latintzar/tactile-glove/hardware/glove-v4/enclosure/vertical-packing-check.md

# Current vertical packing limit

After replacing all545 generic heights with documented package maxima plus0.20mm assembly allowance, the deepest underside package is C_SD_BULK atZ26.1 (2.9mm below the board). The battery envelope occupiesZ3..24; its retaining belt reachesZ25. Main PCB remainsZ29..30.6. The fixed FH12 tail plane isZ31.3, and the exact-length R4 camera fold fixes camera/window height from that plane. Lowering the PCB requires changing those interfaces and the fitted button tip.

The button independently fixes the present45.5mm case top: tip flange top38.7 +installed spring5.2 =cap underside43.9; cap1.0 reaches44.9; diaphragm0.6 reaches45.5. Changing the NTC connector to right-angle alone therefore saves no case height with this mechanism. The existing PH NTC service bend also reaches43.65 below the44.2 lid underside, leaving0.55mm nominal clearance.

A simple lid or PCB translation cannot reduce height while preserving these interfaces. This checkpoint retains112×104×45.5mm body dimensions and the1.6mm flat textile carrier. The new overlap window increases assembled length to105.6mm. A materially slimmer cuff requires a separately scoped button/camera/board packing change or battery alternative.
