latintzar/tactile-glove/docs/dense-tactile-skin.md

# Dense tactile skin

The current investigation is a flexible, textured black nitrile precision glove targeting thousands of taxels across the hand. It retains the compact graphite wrist cuff, hand-facing camera and forest-green pull tab.

The jobs are recording surface texture and contact during hand work, studying delicate palpation in surgical training, and observing grip during sport. These application images illustrate the intended glove experience.

## Sensing layer and readout

The sensing layer, channel addressing, mechanical integration, routing and data acquisition remain current engineering questions. The dense portfolio view places 4,096 proposed taxel positions over one photograph. Those positions describe a layout target; acquired measurements belong to the experiment records.

## Earlier engineering

The earlier V4 source uses twenty paired pressure/PVDF locations, two IMUs and a cuff camera. Its firmware implementation settings, tests, native PCB, enclosure files and physical qualification status remain in their existing guides. The earlier Bela pilot retains its original recordings and signal comparisons.

## Material observation

Peter reported that his piezo experiment produced visibly distinct spectral signatures for aluminium, wood and sandpaper. The retained account and qualitative reconstruction are in [Material signatures](material-signatures/README.md). The reconstruction records his described visual differences separately from the archived Bela recordings.

## Continue the investigation

Select and qualify a sensing stack, establish the taxel layout and readout, test mechanical fit and signal integrity, then record synchronized material interactions. Preserve each implemented result and its evidence alongside the existing source history.
