latintzar/tactile-glove/firmware/tactile_v4/camera_override/PUBLIC-SOURCE-NOTICE.md

# Public source notice

The two `driver/*.c` files preserve the original Espressif Apache 2.0 headers and carry a Peter Neyra modification notice. The public packaging adds that notice as two comment lines; their executable C bodies match the source used for the dated target build. `README.md` retains the original reviewed source hashes. The historical `artifacts/build-manifest.json` describes that original source snapshot; the public source inventory records the current files. Build and test the public tree when making a new image.
