latintzar/tactile-glove/hardware/glove-v4/enclosure/viewer.html

ARTISANCuff assembly · V4Assembly guide

Drag to rotate · scroll to zoom · dimensions in millimetres

# Cuff components

Generated part geometry and checked PCB component envelopes. Inspect the housing, battery, camera and connections.

Loading engineering files…

Inspect a component

Show electronics and batteryElectronic components use the same mechanical envelopes as the clearance checks. The model uses the exact millimetre coordinates in the supplied CAD; surface finish is illustrative.

Printing and assemblyPart manifestClearance checksMain-board BOM
