latintzar/tactile-glove/hardware/glove-v4/software-preview/index.html

ARTISAN

Connecting to cuff

Connect Bluetooth

# Glove monitor

Contact, vibration and the view from your wrist.

What are you touching?Mark takeWaiting for cuff— V

Open cuff camera and monitor (http://192.168.4.1/)

## Contact map

Right hand · 20 locations

Loading hand

PalmBack

Reference anatomy · drag to rotate

Light contactFirm contact

## Wrist camera

Waiting for video

Video appears over cuff Wi-Fi

Storage —IMUs —

## Texture signal

LocationInspect waveform

Contact level—% of electrical range

Vibration RMS—mV at ADC input

Peak—mV at ADC input

Vibration over timeLast 12 seconds

WaveformmV · 0.5 s

Frequency content0–2 kHz

Texture energy is the measured vibration signal. Material and roughness models use the labeled recordings.

Waiting for hardware dataContinuous raw capture on microSD

Capture details

20 vibration channels at 4 kHz · 20 pressure channels at 50 Hz · dual 833 Hz IMUs · VGA camera around 10 fps. Pressure is an electrical contact level until per-cell force calibration. Camera timestamps mark first DMA arrival.
