latintzar/tactile-glove/hardware/glove-v4/enclosure/height-evidence/README.md

# Package-height evidence

All 545 former generic component instances are covered by 94 selected-MPN manufacturer maxima. The initial snapshot remains in package-heights.json; merged-package-heights.json/CSV are the current CAD inputs.

Every reduced envelope adds a separate 0.20 mm assembly allowance. This is an engineering assembly acceptance limit, not a manufacturer dimensional claim. The 15 original specific envelopes remain separately modeled; the new fuse and battery header are added by the connector revision.

Evidence includes cached manufacturer PDFs, distributor-hosted manufacturer PDFs, hashed catalog extracts and clearly labeled transcriptions of manufacturer drawings where direct downloads returned 403. Exact references, source URLs, physical pages and evidence hashes are retained in the merged table.

| Selected MPN | Qty | Maximum mm | Assembly envelope mm | Evidence |
|---|---:|---:|---:|---|
| 2N7002,215 | 8 | 1.10 | 1.30 | [p. 8](https://assets.nexperia.com/documents/data-sheet/2N7002.pdf) |
| 74LVC1G04GW,125 | 1 | 1.10 | 1.30 | [p. 9](https://assets.nexperia.com/documents/data-sheet/74LVC1G04.pdf) |
| BAV199,215 | 20 | 1.10 | 1.30 | [p. 5](https://assets.nexperia.com/documents/data-sheet/BAV199.pdf) |
| BQ25616RTWR | 1 | 0.80 | 1.00 | [p. 47](https://www.ti.com/lit/ds/symlink/bq25616.pdf) |
| C0603C123J3GACAUTO | 20 | 0.87 | 1.07 | [p. 6,8](https://yageogroup.com/content/datasheet/asset/file/KEM_C1022_C0G_AUTO_SMD) |
| C0603C153J3GACAUTO | 20 | 0.87 | 1.07 | [p. 6,8](https://yageogroup.com/content/datasheet/asset/file/KEM_C1022_C0G_AUTO_SMD) |
| CD74HC4052M | 1 | 1.75 | 1.95 | [p. 49](https://www.ti.com/lit/ds/symlink/cd74hc4052.pdf) |
| CD74HC4067M | 4 | 2.65 | 2.85 | [p. 26](https://www.ti.com/lit/ds/symlink/cd74hc4067.pdf) |
| CL21A106KAYNNNE | 6 | 1.45 | 1.65 | [p. catalog extract](https://prod-parts-data.s3.amazonaws.com/CL21A106KAYNNNE/datasheet/1_CL21A106KAYNNNE-Samsung-Electro-Mechanics-datasheet-11796682.pdf) |
| DMP2035U-7 | 2 | 1.15 | 1.35 | [p. 6](https://www.diodes.com/assets/Datasheets/DMP2035U.pdf) |
| GRM1885C1H102JA01D | 2 | 0.90 | 1.10 | [p. catalog extract](https://www.murata.com/-/media/webrenewal/tool/library/common-pdf/static-model/component-list-s-mlcc-2506.ashx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) |
| GRM1885C1H103JA01D | 20 | 0.90 | 1.10 | [p. 1](https://www.icsoso.com.cn/pdf-dc/GRM1885C1H103JA01D.pdf) |
| GRM1885C1H222JA01D | 20 | 0.90 | 1.10 | [p. catalog extract](https://www.murata.com/-/media/webrenewal/tool/library/common-pdf/static-model/component-list-s-mlcc-2506.ashx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) |
| GRM1885C1H471JA01D | 20 | 0.90 | 1.10 | [p. catalog extract](https://www.murata.com/-/media/webrenewal/tool/library/common-pdf/static-model/component-list-s-mlcc-2506.ashx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) |
| GRM188R61A105KA61D | 7 | 0.90 | 1.10 | [p. catalog extract](https://www.murata.com/-/media/webrenewal/tool/library/common-pdf/static-model/component-list-s-mlcc-2506.ashx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) |
| GRM188R61A475KE15D | 1 | 0.90 | 1.10 | [p. catalog extract](https://www.murata.com/-/media/webrenewal/tool/library/common-pdf/static-model/component-list-s-mlcc-2506.ashx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) |
| GRM188R61C105KA93D | 4 | 0.90 | 1.10 | [p. catalog extract](https://www.murata.com/-/media/webrenewal/tool/library/common-pdf/static-model/component-list-s-mlcc-2506.ashx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) |
| GRM188R71C104KA01D | 34 | 0.90 | 1.10 | [p. catalog extract](https://www.murata.com/-/media/webrenewal/tool/library/common-pdf/static-model/component-list-s-mlcc-2506.ashx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) |
| GRM188R71H104KA93D | 28 | 0.90 | 1.10 | [p. 1](https://cms.nacsemi.com/content/AuthDatasheets/MURE-S-A0003031358-1.pdf) |
| GRM188R71H473KA61D | 1 | 0.90 | 1.10 | [p. catalog extract](https://www.murata.com/-/media/webrenewal/tool/library/common-pdf/static-model/component-list-s-mlcc-2506.ashx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) |
| GRM21BC71E106ME11L | 4 | 1.45 | 1.65 | [p. catalog extract](https://www.murata.com/products/productdetail?partno=GRM21BC71E106ME11L) |
| GRM21BC81C226ME44L | 1 | 1.45 | 1.65 | [p. catalog extract](https://www.murata.com/products/productdetail?partno=GRM21BC81C226ME44L) |
| GRM21BR61A106KE19L | 1 | 1.35 | 1.55 | [p. catalog extract](https://www.murata.com/-/media/webrenewal/tool/library/common-pdf/static-model/component-list-s-mlcc-2506.ashx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) |
| GRM21BR71A475KA73L | 1 | 1.40 | 1.60 | [p. catalog extract](https://www.farnell.com/datasheets/2079190.pdf) |
| GRM32ER61A476KE20L | 1 | 2.70 | 2.90 | [p. catalog extract](https://cms.nacsemi.com/content/AuthDatasheets/MURE-S-A0003031248-1.pdf) |
| GRM32ER61C476KE15L | 9 | 2.70 | 2.90 | [p. 1](https://www.farnell.com/datasheets/2079201.pdf) |
| ISM330DHCXTR | 1 | 0.86 | 1.06 | [p. 146](https://www.st.com/resource/en/datasheet/ism330dhcx.pdf) |
| LM393LVDGKR | 1 | 1.10 | 1.30 | [p. 42](https://www.ti.com/lit/ds/symlink/lm393lv.pdf) |
| MCP33131D-10-I/MS | 1 | 1.10 | 1.30 | [p. 53](https://ww1.microchip.com/downloads/en/DeviceDoc/MCP33131D-Data-Sheet-DS20005947B.pdf) |
| MCP6002T-I/SN | 1 | 1.75 | 1.95 | [p. 32](https://ww1.microchip.com/downloads/en/DeviceDoc/20001733L.pdf) |
| MCP6004T-I/ST | 15 | 1.20 | 1.40 | [p. 42](https://ww1.microchip.com/downloads/en/DeviceDoc/20001733L.pdf) |
| OPA320AIDBVR | 2 | 1.45 | 1.65 | [p. 39](https://www.ti.com/lit/ds/symlink/opa320.pdf) |
| OPA4323IPWR | 1 | 1.20 | 1.40 | [p. 57](https://www.ti.com/lit/ds/symlink/opa4323.pdf) |
| PCA9306DCTR | 1 | 1.30 | 1.50 | [p. 28](https://www.ti.com/lit/ds/symlink/pca9306.pdf) |
| PESD5V0U2BT,215 | 2 | 1.10 | 1.30 | [p. 7](https://assets.nexperia.com/documents/data-sheet/PESD5V0U2BT.pdf) |
| PMEG2010ER,115 | 3 | 1.10 | 1.30 | [p. 8](https://assets.nexperia.com/documents/data-sheet/PMEG2010ER.pdf) |
| PMV16XN,215 | 2 | 1.10 | 1.30 | [p. 10](https://assets.nexperia.com/documents/data-sheet/PMV16XN.pdf) |
| RC0603FR-07100KL | 37 | 0.55 | 0.75 | [p. 1](https://yageogroup.com/component-documentation/download/specsheet/RC0603FR-07100KL) |
| RC0603FR-0710KL | 40 | 0.55 | 0.75 | [p. 1](https://yageogroup.com/component-documentation/download/specsheet/RC0603FR-0710KL) |
| RC0603FR-0710ML | 2 | 0.55 | 0.75 | [p. 1](https://yageogroup.com/component-documentation/download/specsheet/RC0603FR-0710ML) |
| RC0603FR-0710RL | 1 | 0.55 | 0.75 | [p. 1](https://yageogroup.com/component-documentation/download/specsheet/RC0603FR-0710RL) |
| RC0603FR-0714K7L | 40 | 0.55 | 0.75 | [p. 1](https://yageogroup.com/component-documentation/download/specsheet/RC0603FR-0714K7L) |
| RC0603FR-071KL | 2 | 0.55 | 0.75 | [p. 1](https://yageogroup.com/component-documentation/download/specsheet/RC0603FR-071KL) |
| RC0603FR-07200KL | 1 | 0.55 | 0.75 | [p. 1](https://yageogroup.com/component-documentation/download/specsheet/RC0603FR-07200KL) |
| RC0603FR-07220RL | 2 | 0.55 | 0.75 | [p. 1](https://yageogroup.com/component-documentation/download/specsheet/RC0603FR-07220RL) |
| RC0603FR-0722RL | 4 | 0.55 | 0.75 | [p. 1](https://yageogroup.com/component-documentation/download/specsheet/RC0603FR-0722RL) |
| RC0603FR-0727K4L | 40 | 0.55 | 0.75 | [p. 1](https://yageogroup.com/component-documentation/download/specsheet/RC0603FR-0727K4L) |
| RC0603FR-072K2L | 4 | 0.55 | 0.75 | [p. 1](https://yageogroup.com/component-documentation/download/specsheet/RC0603FR-072K2L) |
| RC0603FR-072KL | 1 | 0.55 | 0.75 | [p. 1](https://yageogroup.com/component-documentation/download/specsheet/RC0603FR-072KL) |
| RC0603FR-0733RL | 4 | 0.55 | 0.75 | [p. 1](https://yageogroup.com/component-documentation/download/specsheet/RC0603FR-0733RL) |
| RC0603FR-0747KL | 19 | 0.55 | 0.75 | [p. 1](https://yageogroup.com/component-documentation/download/specsheet/RC0603FR-0747KL) |
| RC0603FR-0747RL | 1 | 0.55 | 0.75 | [p. 1](https://yageogroup.com/component-documentation/download/specsheet/RC0603FR-0747RL) |
| RC0603FR-074K7L | 1 | 0.55 | 0.75 | [p. 1](https://yageogroup.com/component-documentation/download/specsheet/RC0603FR-074K7L) |
| RC0603FR-07680RL | 2 | 0.55 | 0.75 | [p. 1](https://yageogroup.com/component-documentation/download/specsheet/RC0603FR-07680RL) |
| RC0805FR-0722RL | 2 | 0.60 | 0.80 | [p. 1](https://yageogroup.com/component-documentation/download/specsheet/RC0805FR-0722RL) |
| REF3330AIDBZR | 1 | 1.12 | 1.32 | [p. 33](https://www.ti.com/lit/ds/symlink/ref33.pdf) |
| RT0603BRD07100KL | 7 | 0.55 | 0.75 | [p. 1](https://yageogroup.com/component-documentation/download/specsheet/RT0603BRD07100KL) |
| RT0603BRD07107KL | 1 | 0.55 | 0.75 | [p. 1](https://yageogroup.com/component-documentation/download/specsheet/RT0603BRD07107KL) |
| RT0603BRD07158KL | 1 | 0.55 | 0.75 | [p. 1](https://yageogroup.com/component-documentation/download/specsheet/RT0603BRD07158KL) |
| RT0603BRD0719K2L | 1 | 0.55 | 0.75 | [p. 1](https://www.yageo.com/en/Chart/Download/pdf/RC0603) |
| RT0603BRD072M15L | 1 | 0.55 | 0.75 | [p. 1](https://www.yageo.com/en/Chart/Download/pdf/RC0603) |
| RT0603BRD07300KL | 1 | 0.55 | 0.75 | [p. 1](https://yageogroup.com/component-documentation/download/specsheet/RT0603BRD07300KL) |
| RT0603BRD0730K9L | 2 | 0.55 | 0.75 | [p. 1](https://yageogroup.com/component-documentation/download/specsheet/RT0603BRD0730K9L) |
| RT0603BRD07327KL | 1 | 0.55 | 0.75 | [p. 1](https://www.yageo.com/en/Chart/Download/pdf/RC0603) |
| RT0603BRD07390RL | 1 | 0.55 | 0.75 | [p. 1](https://yageogroup.com/component-documentation/download/specsheet/RT0603BRD07390RL) |
| RT0603BRD0752K3L | 1 | 0.55 | 0.75 | [p. 1](https://yageogroup.com/component-documentation/download/specsheet/RT0603BRD0752K3L) |
| RT0603BRD07562RL | 1 | 0.55 | 0.75 | [p. 1](https://yageogroup.com/component-documentation/download/specsheet/RT0603BRD07562RL) |
| RT0603BRD075K23L | 1 | 0.55 | 0.75 | [p. 1](https://yageogroup.com/component-documentation/download/specsheet/RT0603BRD075K23L) |
| RT0603BRD0771K5L | 1 | 0.55 | 0.75 | [p. 1](https://yageogroup.com/component-documentation/download/specsheet/RT0603BRD0771K5L) |
| RT0603BRD07887KL | 1 | 0.55 | 0.75 | [p. 1](https://yageogroup.com/component-documentation/download/specsheet/RT0603BRD07887KL) |
| RV0805FR-0722ML | 20 | 0.60 | 0.80 | [p. 1](https://yageogroup.com/component-documentation/download/specsheet/RV0805FR-0722ML) |
| SN74AHC595PWR | 1 | 1.20 | 1.40 | [p. 33](https://www.ti.com/lit/ds/symlink/sn74ahc595.pdf) |
| SN74AXC8T245PWR | 2 | 1.20 | 1.40 | [p. 29](https://www.ti.com/lit/ds/symlink/sn74axc8t245.pdf) |
| SN74LVC1G00DBVR | 1 | 1.45 | 1.65 | [p. 40](https://www.ti.com/lit/ds/symlink/sn74lvc1g00.pdf) |
| SN74LVC1G04DBVR | 3 | 1.45 | 1.65 | [p. 23](https://www.ti.com/lit/ds/symlink/sn74lvc1g04.pdf) |
| SN74LVC1G08DBVR | 4 | 1.45 | 1.65 | [p. 27](https://www.ti.com/lit/ds/symlink/sn74lvc1g08.pdf) |
| SN74LVC1G17DBVR | 1 | 1.45 | 1.65 | [p. 23](https://www.ti.com/lit/ds/symlink/sn74lvc1g17.pdf) |
| SN74LVC1G32DBVR | 2 | 1.45 | 1.65 | [p. 41](https://www.ti.com/lit/ds/symlink/sn74lvc1g32.pdf) |
| SN74LVC1G74DCUR | 1 | 0.90 | 1.10 | [p. 22](https://www.ti.com/lit/ds/symlink/sn74lvc1g74.pdf) |
| TAJA685K010RNJ | 1 | 1.80 | 2.00 | [p. 1](https://datasheets.kyocera-avx.com/TAJ.pdf) |
| TCA9535PWR | 2 | 1.20 | 1.40 | [p. 38](https://www.ti.com/lit/ds/symlink/tca9535.pdf) |
| TLV3012BIDBVR | 1 | 1.45 | 1.65 | [p. 37](https://www.ti.com/lit/ds/symlink/tlv3012.pdf) |
| TLV75518PDBVR | 1 | 1.45 | 1.65 | [p. 37](https://www.ti.com/lit/ds/symlink/tlv755p.pdf) |
| TMK107BBJ106MA-T | 2 | 1.00 | 1.20 | [p. 1](https://www.es.co.th/Schemetic/PDF/TMK107BBJ106MA-T.PDF) |
| TPS22919DCKR | 1 | 1.10 | 1.30 | [p. 24](https://www.ti.com/lit/ds/symlink/tps22919.pdf) |
| TPS22950YBHR | 1 | 0.40 | 0.60 | [p. 21](https://www.ti.com/lit/ds/symlink/tps22950.pdf) |
| TPS2553DBVR | 1 | 1.45 | 1.65 | [p. 41](https://www.ti.com/lit/ds/symlink/tps2553.pdf) |
| TPS63070RNMR | 1 | 1.00 | 1.20 | [p. 39](https://www.ti.com/lit/ds/symlink/tps63070.pdf) |
| TPS7A2015PDBVR | 1 | 1.45 | 1.65 | [p. 56](https://www.ti.com/lit/ds/symlink/tps7a20.pdf) |
| TPS7A2018PDBVR | 1 | 1.45 | 1.65 | [p. 56](https://www.ti.com/lit/ds/symlink/tps7a20.pdf) |
| TPS7A2028PDBVR | 1 | 1.45 | 1.65 | [p. 56](https://www.ti.com/lit/ds/symlink/tps7a20.pdf) |
| TPS7A2033PDBVR | 1 | 1.45 | 1.65 | [p. 56](https://www.ti.com/lit/ds/symlink/tps7a20.pdf) |
| TUSB320LAIRWBR | 1 | 0.40 | 0.60 | [p. 35](https://www.ti.com/lit/ds/symlink/tusb320lai.pdf) |
| XFL4020-152MEC | 2 | 2.10 | 2.30 | [p. 1,3](https://www.coilcraft.com/en-us/products/power/shielded-inductors/molded-inductor/xfl/xfl4020/) |

Rebuild the merged table with `python3 merge-evidence.py`. The original build-evidence.py only regenerates the initial snapshot.
