latintzar/tactile-glove/hardware/glove-v3/electrical/nets.csv

net | ref | pin
MUX_SRCLK | J_XIAO | 1
MUX_SER | J_XIAO | 2
MUX_RCLK | J_XIAO | 3
I2C_SDA | J_XIAO | 5
I2C_SCL | J_XIAO | 6
ADC_SCK | J_XIAO | 9
ADC_MISO | J_XIAO | 10
ADC_CNV | J_XIAO | 11
3V3 | J_XIAO | 12
GND | J_XIAO | 13
USB_5V | J_XIAO | 14
GND | J_XIAO | 18
BAT+ | J_XIAO | 19
GND | J_XIAO | 20
WAKE_IRQ | J_XIAO | 21
ANALOG_EN | J_XIAO | 22
BAT+ | J_BAT | 1
GND | J_BAT | 2
3V3A | U_LDO | 1
GND | U_LDO | 2
3V3A | U_LDO | 3
1V8 | U_LDO | 5
3V3A | U_REF | 1
VREF3V0 | U_REF | 2
GND | U_REF | 3
VEXC_DRV | U_VMID | 1
VEXC_FB | U_VMID | 2
VEXC_DIV | U_VMID | 3
GND | U_VMID | 4
VMID_BUF_IN | U_VMID | 5
VMID1V25 | U_VMID | 6
VMID1V25 | U_VMID | 7
3V3A | U_VMID | 8
VREF3V0 | U_ADC | 1
1V8 | U_ADC | 2
ADC_AIN+ | U_ADC | 3
ADC_AIN- | U_ADC | 4
GND | U_ADC | 5
ADC_CNV | U_ADC | 6
ADC_MISO | U_ADC | 7
ADC_SCK | U_ADC | 8
3V3A | U_ADC | 9
3V3A | U_ADC | 10
ADC_DRIVER_OUT | U_ADC_DRV | 1
GND | U_ADC_DRV | 2
ADC_MUX | U_ADC_DRV | 3
ADC_DRIVER_OUT | U_ADC_DRV | 4
3V3A | U_ADC_DRV | 5
MUX1_COM | U_MUX1 | 1
PRESS_R2 | U_MUX1 | 2
PRESS_R1 | U_MUX1 | 3
PRESS_M3 | U_MUX1 | 4
PRESS_M2 | U_MUX1 | 5
PRESS_M1 | U_MUX1 | 6
PRESS_I3 | U_MUX1 | 7
PRESS_I2 | U_MUX1 | 8
PRESS_I1 | U_MUX1 | 9
MUX_A0 | U_MUX1 | 10
MUX_A1 | U_MUX1 | 11
GND | U_MUX1 | 12
MUX_A3 | U_MUX1 | 13
MUX_A2 | U_MUX1 | 14
GND | U_MUX1 | 15
VMID1V25 | U_MUX1 | 16
VMID1V25 | U_MUX1 | 17
VMID1V25 | U_MUX1 | 18
VMID1V25 | U_MUX1 | 19
VMID1V25 | U_MUX1 | 20
VMID1V25 | U_MUX1 | 21
PRESS_L1 | U_MUX1 | 22
PRESS_R3 | U_MUX1 | 23
3V3A | U_MUX1 | 24
MUX2_COM | U_MUX2 | 1
PRESS_P4 | U_MUX2 | 2
PRESS_P3 | U_MUX2 | 3
PRESS_P2 | U_MUX2 | 4
PRESS_P1 | U_MUX2 | 5
PRESS_T2 | U_MUX2 | 6
PRESS_T1 | U_MUX2 | 7
PRESS_L3 | U_MUX2 | 8
PRESS_L2 | U_MUX2 | 9
MUX_A0 | U_MUX2 | 10
MUX_A1 | U_MUX2 | 11
GND | U_MUX2 | 12
MUX_A3 | U_MUX2 | 13
MUX_A2 | U_MUX2 | 14
GND | U_MUX2 | 15
VMID1V25 | U_MUX2 | 16
VMID1V25 | U_MUX2 | 17
VMID1V25 | U_MUX2 | 18
VMID1V25 | U_MUX2 | 19
VMID1V25 | U_MUX2 | 20
VMID1V25 | U_MUX2 | 21
PRESS_H2 | U_MUX2 | 22
PRESS_H1 | U_MUX2 | 23
3V3A | U_MUX2 | 24
MUX3_COM | U_MUX3 | 1
S2_OUT_R2 | U_MUX3 | 2
S2_OUT_R1 | U_MUX3 | 3
S2_OUT_M3 | U_MUX3 | 4
S2_OUT_M2 | U_MUX3 | 5
S2_OUT_M1 | U_MUX3 | 6
S2_OUT_I3 | U_MUX3 | 7
S2_OUT_I2 | U_MUX3 | 8
S2_OUT_I1 | U_MUX3 | 9
MUX_A0 | U_MUX3 | 10
MUX_A1 | U_MUX3 | 11
GND | U_MUX3 | 12
MUX_A3 | U_MUX3 | 13
MUX_A2 | U_MUX3 | 14
GND | U_MUX3 | 15
VMID1V25 | U_MUX3 | 16
VMID1V25 | U_MUX3 | 17
VMID1V25 | U_MUX3 | 18
VMID1V25 | U_MUX3 | 19
VMID1V25 | U_MUX3 | 20
VMID1V25 | U_MUX3 | 21
S2_OUT_L1 | U_MUX3 | 22
S2_OUT_R3 | U_MUX3 | 23
3V3A | U_MUX3 | 24
MUX4_COM | U_MUX4 | 1
S2_OUT_P4 | U_MUX4 | 2
S2_OUT_P3 | U_MUX4 | 3
S2_OUT_P2 | U_MUX4 | 4
S2_OUT_P1 | U_MUX4 | 5
S2_OUT_T2 | U_MUX4 | 6
S2_OUT_T1 | U_MUX4 | 7
S2_OUT_L3 | U_MUX4 | 8
S2_OUT_L2 | U_MUX4 | 9
MUX_A0 | U_MUX4 | 10
MUX_A1 | U_MUX4 | 11
GND | U_MUX4 | 12
MUX_A3 | U_MUX4 | 13
MUX_A2 | U_MUX4 | 14
GND | U_MUX4 | 15
VMID1V25 | U_MUX4 | 16
VMID1V25 | U_MUX4 | 17
VMID1V25 | U_MUX4 | 18
VMID1V25 | U_MUX4 | 19
VMID1V25 | U_MUX4 | 20
VMID1V25 | U_MUX4 | 21
S2_OUT_H2 | U_MUX4 | 22
S2_OUT_H1 | U_MUX4 | 23
3V3A | U_MUX4 | 24
VMID1V25 | U_MUX_FINAL | 1
VMID1V25 | U_MUX_FINAL | 2
VMID1V25 | U_MUX_FINAL | 4
VMID1V25 | U_MUX_FINAL | 5
GND | U_MUX_FINAL | 6
GND | U_MUX_FINAL | 7
GND | U_MUX_FINAL | 8
MUX_BANK1 | U_MUX_FINAL | 9
MUX_BANK0 | U_MUX_FINAL | 10
MUX4_BUF | U_MUX_FINAL | 11
MUX1_BUF | U_MUX_FINAL | 12
ADC_MUX | U_MUX_FINAL | 13
MUX2_BUF | U_MUX_FINAL | 14
MUX3_BUF | U_MUX_FINAL | 15
3V3A | U_MUX_FINAL | 16
3V3A | U_CHG1 | 4
GND | U_CHG1 | 11
CHG_OUT_I1 | U_CHG1 | 1
CHG_IN_I1 | U_CHG1 | 2
VMID1V25 | U_CHG1 | 3
CHG_OUT_I2 | U_CHG1 | 7
CHG_IN_I2 | U_CHG1 | 6
VMID1V25 | U_CHG1 | 5
CHG_OUT_I3 | U_CHG1 | 8
CHG_IN_I3 | U_CHG1 | 9
VMID1V25 | U_CHG1 | 10
CHG_OUT_M1 | U_CHG1 | 14
CHG_IN_M1 | U_CHG1 | 13
VMID1V25 | U_CHG1 | 12
3V3A | U_CHG2 | 4
GND | U_CHG2 | 11
CHG_OUT_M2 | U_CHG2 | 1
CHG_IN_M2 | U_CHG2 | 2
VMID1V25 | U_CHG2 | 3
CHG_OUT_M3 | U_CHG2 | 7
CHG_IN_M3 | U_CHG2 | 6
VMID1V25 | U_CHG2 | 5
CHG_OUT_R1 | U_CHG2 | 8
CHG_IN_R1 | U_CHG2 | 9
VMID1V25 | U_CHG2 | 10
CHG_OUT_R2 | U_CHG2 | 14
CHG_IN_R2 | U_CHG2 | 13
VMID1V25 | U_CHG2 | 12
3V3A | U_CHG3 | 4
GND | U_CHG3 | 11
CHG_OUT_R3 | U_CHG3 | 1
CHG_IN_R3 | U_CHG3 | 2
VMID1V25 | U_CHG3 | 3
CHG_OUT_L1 | U_CHG3 | 7
CHG_IN_L1 | U_CHG3 | 6
VMID1V25 | U_CHG3 | 5
CHG_OUT_L2 | U_CHG3 | 8
CHG_IN_L2 | U_CHG3 | 9
VMID1V25 | U_CHG3 | 10
CHG_OUT_L3 | U_CHG3 | 14
CHG_IN_L3 | U_CHG3 | 13
VMID1V25 | U_CHG3 | 12
3V3A | U_CHG4 | 4
GND | U_CHG4 | 11
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
I2C_SDA | J_IMU | 3
I2C_SCL | J_IMU | 4
GND | U_IOX | 1
GND | U_IOX | 2
GND | U_IOX | 3
BTN0 | U_IOX | 4
GND | U_IOX | 8
WAKE_IRQ | U_IOX | 13
I2C_SCL | U_IOX | 14
I2C_SDA | U_IOX | 15
3V3 | U_IOX | 16
PVDF_T1 | J_THUMB | 1
PRESS_T1 | J_THUMB | 2
PVDF_T2 | J_THUMB | 3
PRESS_T2 | J_THUMB | 4
VEXC2V5 | J_THUMB | 5
GND | J_THUMB | 6
PVDF_I1 | J_INDEX | 1
PRESS_I1 | J_INDEX | 2
PVDF_I2 | J_INDEX | 3
PRESS_I2 | J_INDEX | 4
PVDF_I3 | J_INDEX | 5
PRESS_I3 | J_INDEX | 6
VEXC2V5 | J_INDEX | 7
GND | J_INDEX | 8
PVDF_M1 | J_MIDDLE | 1
PRESS_M1 | J_MIDDLE | 2
PVDF_M2 | J_MIDDLE | 3
PRESS_M2 | J_MIDDLE | 4
PVDF_M3 | J_MIDDLE | 5
PRESS_M3 | J_MIDDLE | 6
VEXC2V5 | J_MIDDLE | 7
GND | J_MIDDLE | 8
PVDF_R1 | J_RING | 1
PRESS_R1 | J_RING | 2
PVDF_R2 | J_RING | 3
PRESS_R2 | J_RING | 4
PVDF_R3 | J_RING | 5
PRESS_R3 | J_RING | 6
VEXC2V5 | J_RING | 7
GND | J_RING | 8
PVDF_L1 | J_LITTLE | 1
PRESS_L1 | J_LITTLE | 2
PVDF_L2 | J_LITTLE | 3
PRESS_L2 | J_LITTLE | 4
PVDF_L3 | J_LITTLE | 5
PRESS_L3 | J_LITTLE | 6
VEXC2V5 | J_LITTLE | 7
GND | J_LITTLE | 8
PVDF_P1 | J_PALM_HEEL | 1
PRESS_P1 | J_PALM_HEEL | 2
PVDF_P2 | J_PALM_HEEL | 3
PRESS_P2 | J_PALM_HEEL | 4
PVDF_P3 | J_PALM_HEEL | 5
PRESS_P3 | J_PALM_HEEL | 6
PVDF_P4 | J_PALM_HEEL | 7
PRESS_P4 | J_PALM_HEEL | 8
PVDF_H1 | J_PALM_HEEL | 9
PRESS_H1 | J_PALM_HEEL | 10
PVDF_H2 | J_PALM_HEEL | 11
PRESS_H2 | J_PALM_HEEL | 12
VEXC2V5 | J_PALM_HEEL | 13
GND | J_PALM_HEEL | 14
CHG_OUT_I1 | RFB_I1 | 1
CHG_IN_I1 | RFB_I1 | 2
CHG_OUT_I1 | CFB_I1 | 1
CHG_IN_I1 | CFB_I1 | 2
PVDF_I1 | RIN_I1 | 1
CHG_IN_I1 | RIN_I1 | 2
CHG_OUT_I1 | RS1A_I1 | 1
S1_A_I1 | RS1A_I1 | 2
S1_A_I1 | RS1B_I1 | 1
S1_B_I1 | RS1B_I1 | 2
S1_A_I1 | CS1FB_I1 | 1
S1_OUT_I1 | CS1FB_I1 | 2
S1_B_I1 | CS1G_I1 | 1
VMID1V25 | CS1G_I1 | 2
S1_OUT_I1 | RS2A_I1 | 1
S2_A_I1 | RS2A_I1 | 2
S2_A_I1 | RS2B_I1 | 1
S2_B_I1 | RS2B_I1 | 2
S2_A_I1 | CS2FB_I1 | 1
S2_OUT_I1 | CS2FB_I1 | 2
S2_B_I1 | CS2G_I1 | 1
VMID1V25 | CS2G_I1 | 2
PRESS_I1 | RPD_I1 | 1
GND | RPD_I1 | 2
CHG_OUT_I2 | RFB_I2 | 1
CHG_IN_I2 | RFB_I2 | 2
CHG_OUT_I2 | CFB_I2 | 1
CHG_IN_I2 | CFB_I2 | 2
PVDF_I2 | RIN_I2 | 1
CHG_IN_I2 | RIN_I2 | 2
CHG_OUT_I2 | RS1A_I2 | 1
S1_A_I2 | RS1A_I2 | 2
S1_A_I2 | RS1B_I2 | 1
S1_B_I2 | RS1B_I2 | 2
S1_A_I2 | CS1FB_I2 | 1
S1_OUT_I2 | CS1FB_I2 | 2
S1_B_I2 | CS1G_I2 | 1
VMID1V25 | CS1G_I2 | 2
S1_OUT_I2 | RS2A_I2 | 1
S2_A_I2 | RS2A_I2 | 2
S2_A_I2 | RS2B_I2 | 1
S2_B_I2 | RS2B_I2 | 2
S2_A_I2 | CS2FB_I2 | 1
S2_OUT_I2 | CS2FB_I2 | 2
S2_B_I2 | CS2G_I2 | 1
VMID1V25 | CS2G_I2 | 2
PRESS_I2 | RPD_I2 | 1
GND | RPD_I2 | 2
CHG_OUT_I3 | RFB_I3 | 1
CHG_IN_I3 | RFB_I3 | 2
CHG_OUT_I3 | CFB_I3 | 1
CHG_IN_I3 | CFB_I3 | 2
PVDF_I3 | RIN_I3 | 1
CHG_IN_I3 | RIN_I3 | 2
CHG_OUT_I3 | RS1A_I3 | 1
S1_A_I3 | RS1A_I3 | 2
S1_A_I3 | RS1B_I3 | 1
S1_B_I3 | RS1B_I3 | 2
S1_A_I3 | CS1FB_I3 | 1
S1_OUT_I3 | CS1FB_I3 | 2
S1_B_I3 | CS1G_I3 | 1
VMID1V25 | CS1G_I3 | 2
S1_OUT_I3 | RS2A_I3 | 1
S2_A_I3 | RS2A_I3 | 2
S2_A_I3 | RS2B_I3 | 1
S2_B_I3 | RS2B_I3 | 2
S2_A_I3 | CS2FB_I3 | 1
S2_OUT_I3 | CS2FB_I3 | 2
S2_B_I3 | CS2G_I3 | 1
VMID1V25 | CS2G_I3 | 2
PRESS_I3 | RPD_I3 | 1
GND | RPD_I3 | 2
CHG_OUT_M1 | RFB_M1 | 1
CHG_IN_M1 | RFB_M1 | 2
CHG_OUT_M1 | CFB_M1 | 1
CHG_IN_M1 | CFB_M1 | 2
PVDF_M1 | RIN_M1 | 1
CHG_IN_M1 | RIN_M1 | 2
CHG_OUT_M1 | RS1A_M1 | 1
S1_A_M1 | RS1A_M1 | 2
S1_A_M1 | RS1B_M1 | 1
S1_B_M1 | RS1B_M1 | 2
S1_A_M1 | CS1FB_M1 | 1
S1_OUT_M1 | CS1FB_M1 | 2
S1_B_M1 | CS1G_M1 | 1
VMID1V25 | CS1G_M1 | 2
S1_OUT_M1 | RS2A_M1 | 1
S2_A_M1 | RS2A_M1 | 2
S2_A_M1 | RS2B_M1 | 1
S2_B_M1 | RS2B_M1 | 2
S2_A_M1 | CS2FB_M1 | 1
S2_OUT_M1 | CS2FB_M1 | 2
S2_B_M1 | CS2G_M1 | 1
VMID1V25 | CS2G_M1 | 2
PRESS_M1 | RPD_M1 | 1
GND | RPD_M1 | 2
CHG_OUT_M2 | RFB_M2 | 1
CHG_IN_M2 | RFB_M2 | 2
CHG_OUT_M2 | CFB_M2 | 1
CHG_IN_M2 | CFB_M2 | 2
PVDF_M2 | RIN_M2 | 1
CHG_IN_M2 | RIN_M2 | 2
CHG_OUT_M2 | RS1A_M2 | 1
S1_A_M2 | RS1A_M2 | 2
S1_A_M2 | RS1B_M2 | 1
S1_B_M2 | RS1B_M2 | 2
S1_A_M2 | CS1FB_M2 | 1
S1_OUT_M2 | CS1FB_M2 | 2
S1_B_M2 | CS1G_M2 | 1
VMID1V25 | CS1G_M2 | 2
S1_OUT_M2 | RS2A_M2 | 1
S2_A_M2 | RS2A_M2 | 2
S2_A_M2 | RS2B_M2 | 1
S2_B_M2 | RS2B_M2 | 2
S2_A_M2 | CS2FB_M2 | 1
S2_OUT_M2 | CS2FB_M2 | 2
S2_B_M2 | CS2G_M2 | 1
VMID1V25 | CS2G_M2 | 2
PRESS_M2 | RPD_M2 | 1
GND | RPD_M2 | 2
CHG_OUT_M3 | RFB_M3 | 1
CHG_IN_M3 | RFB_M3 | 2
CHG_OUT_M3 | CFB_M3 | 1
CHG_IN_M3 | CFB_M3 | 2
PVDF_M3 | RIN_M3 | 1
CHG_IN_M3 | RIN_M3 | 2
CHG_OUT_M3 | RS1A_M3 | 1
S1_A_M3 | RS1A_M3 | 2
S1_A_M3 | RS1B_M3 | 1
S1_B_M3 | RS1B_M3 | 2
S1_A_M3 | CS1FB_M3 | 1
S1_OUT_M3 | CS1FB_M3 | 2
S1_B_M3 | CS1G_M3 | 1
VMID1V25 | CS1G_M3 | 2
S1_OUT_M3 | RS2A_M3 | 1
S2_A_M3 | RS2A_M3 | 2
S2_A_M3 | RS2B_M3 | 1
S2_B_M3 | RS2B_M3 | 2
S2_A_M3 | CS2FB_M3 | 1
S2_OUT_M3 | CS2FB_M3 | 2
S2_B_M3 | CS2G_M3 | 1
VMID1V25 | CS2G_M3 | 2
PRESS_M3 | RPD_M3 | 1
GND | RPD_M3 | 2
CHG_OUT_R1 | RFB_R1 | 1
CHG_IN_R1 | RFB_R1 | 2
CHG_OUT_R1 | CFB_R1 | 1
CHG_IN_R1 | CFB_R1 | 2
PVDF_R1 | RIN_R1 | 1
CHG_IN_R1 | RIN_R1 | 2
CHG_OUT_R1 | RS1A_R1 | 1
S1_A_R1 | RS1A_R1 | 2
S1_A_R1 | RS1B_R1 | 1
S1_B_R1 | RS1B_R1 | 2
S1_A_R1 | CS1FB_R1 | 1
S1_OUT_R1 | CS1FB_R1 | 2
S1_B_R1 | CS1G_R1 | 1
VMID1V25 | CS1G_R1 | 2
S1_OUT_R1 | RS2A_R1 | 1
S2_A_R1 | RS2A_R1 | 2
S2_A_R1 | RS2B_R1 | 1
S2_B_R1 | RS2B_R1 | 2
S2_A_R1 | CS2FB_R1 | 1
S2_OUT_R1 | CS2FB_R1 | 2
S2_B_R1 | CS2G_R1 | 1
VMID1V25 | CS2G_R1 | 2
PRESS_R1 | RPD_R1 | 1
GND | RPD_R1 | 2
CHG_OUT_R2 | RFB_R2 | 1
CHG_IN_R2 | RFB_R2 | 2
CHG_OUT_R2 | CFB_R2 | 1
CHG_IN_R2 | CFB_R2 | 2
PVDF_R2 | RIN_R2 | 1
CHG_IN_R2 | RIN_R2 | 2
CHG_OUT_R2 | RS1A_R2 | 1
S1_A_R2 | RS1A_R2 | 2
S1_A_R2 | RS1B_R2 | 1
S1_B_R2 | RS1B_R2 | 2
S1_A_R2 | CS1FB_R2 | 1
S1_OUT_R2 | CS1FB_R2 | 2
S1_B_R2 | CS1G_R2 | 1
VMID1V25 | CS1G_R2 | 2
S1_OUT_R2 | RS2A_R2 | 1
S2_A_R2 | RS2A_R2 | 2
S2_A_R2 | RS2B_R2 | 1
S2_B_R2 | RS2B_R2 | 2
S2_A_R2 | CS2FB_R2 | 1
S2_OUT_R2 | CS2FB_R2 | 2
S2_B_R2 | CS2G_R2 | 1
VMID1V25 | CS2G_R2 | 2
PRESS_R2 | RPD_R2 | 1
GND | RPD_R2 | 2
CHG_OUT_R3 | RFB_R3 | 1
CHG_IN_R3 | RFB_R3 | 2
CHG_OUT_R3 | CFB_R3 | 1
CHG_IN_R3 | CFB_R3 | 2
PVDF_R3 | RIN_R3 | 1
CHG_IN_R3 | RIN_R3 | 2
CHG_OUT_R3 | RS1A_R3 | 1
S1_A_R3 | RS1A_R3 | 2
S1_A_R3 | RS1B_R3 | 1
S1_B_R3 | RS1B_R3 | 2
S1_A_R3 | CS1FB_R3 | 1
S1_OUT_R3 | CS1FB_R3 | 2
S1_B_R3 | CS1G_R3 | 1
VMID1V25 | CS1G_R3 | 2
S1_OUT_R3 | RS2A_R3 | 1
S2_A_R3 | RS2A_R3 | 2
S2_A_R3 | RS2B_R3 | 1
S2_B_R3 | RS2B_R3 | 2
S2_A_R3 | CS2FB_R3 | 1
S2_OUT_R3 | CS2FB_R3 | 2
S2_B_R3 | CS2G_R3 | 1
VMID1V25 | CS2G_R3 | 2
PRESS_R3 | RPD_R3 | 1
GND | RPD_R3 | 2
CHG_OUT_L1 | RFB_L1 | 1
CHG_IN_L1 | RFB_L1 | 2
CHG_OUT_L1 | CFB_L1 | 1
CHG_IN_L1 | CFB_L1 | 2
PVDF_L1 | RIN_L1 | 1
CHG_IN_L1 | RIN_L1 | 2
CHG_OUT_L1 | RS1A_L1 | 1
S1_A_L1 | RS1A_L1 | 2
S1_A_L1 | RS1B_L1 | 1
S1_B_L1 | RS1B_L1 | 2
S1_A_L1 | CS1FB_L1 | 1
S1_OUT_L1 | CS1FB_L1 | 2
S1_B_L1 | CS1G_L1 | 1
VMID1V25 | CS1G_L1 | 2
S1_OUT_L1 | RS2A_L1 | 1
S2_A_L1 | RS2A_L1 | 2
S2_A_L1 | RS2B_L1 | 1
S2_B_L1 | RS2B_L1 | 2
S2_A_L1 | CS2FB_L1 | 1
S2_OUT_L1 | CS2FB_L1 | 2
S2_B_L1 | CS2G_L1 | 1
VMID1V25 | CS2G_L1 | 2
PRESS_L1 | RPD_L1 | 1
GND | RPD_L1 | 2
CHG_OUT_L2 | RFB_L2 | 1
CHG_IN_L2 | RFB_L2 | 2
CHG_OUT_L2 | CFB_L2 | 1
CHG_IN_L2 | CFB_L2 | 2
PVDF_L2 | RIN_L2 | 1
CHG_IN_L2 | RIN_L2 | 2
CHG_OUT_L2 | RS1A_L2 | 1
S1_A_L2 | RS1A_L2 | 2
S1_A_L2 | RS1B_L2 | 1
S1_B_L2 | RS1B_L2 | 2
S1_A_L2 | CS1FB_L2 | 1
S1_OUT_L2 | CS1FB_L2 | 2
S1_B_L2 | CS1G_L2 | 1
VMID1V25 | CS1G_L2 | 2
S1_OUT_L2 | RS2A_L2 | 1
S2_A_L2 | RS2A_L2 | 2
S2_A_L2 | RS2B_L2 | 1
S2_B_L2 | RS2B_L2 | 2
S2_A_L2 | CS2FB_L2 | 1
S2_OUT_L2 | CS2FB_L2 | 2
S2_B_L2 | CS2G_L2 | 1
VMID1V25 | CS2G_L2 | 2
PRESS_L2 | RPD_L2 | 1
GND | RPD_L2 | 2
CHG_OUT_L3 | RFB_L3 | 1
CHG_IN_L3 | RFB_L3 | 2
CHG_OUT_L3 | CFB_L3 | 1
CHG_IN_L3 | CFB_L3 | 2
PVDF_L3 | RIN_L3 | 1
CHG_IN_L3 | RIN_L3 | 2
CHG_OUT_L3 | RS1A_L3 | 1
S1_A_L3 | RS1A_L3 | 2
S1_A_L3 | RS1B_L3 | 1
S1_B_L3 | RS1B_L3 | 2
S1_A_L3 | CS1FB_L3 | 1
S1_OUT_L3 | CS1FB_L3 | 2
S1_B_L3 | CS1G_L3 | 1
VMID1V25 | CS1G_L3 | 2
S1_OUT_L3 | RS2A_L3 | 1
S2_A_L3 | RS2A_L3 | 2
S2_A_L3 | RS2B_L3 | 1
S2_B_L3 | RS2B_L3 | 2
S2_A_L3 | CS2FB_L3 | 1
S2_OUT_L3 | CS2FB_L3 | 2
S2_B_L3 | CS2G_L3 | 1
VMID1V25 | CS2G_L3 | 2
PRESS_L3 | RPD_L3 | 1
GND | RPD_L3 | 2
CHG_OUT_T1 | RFB_T1 | 1
CHG_IN_T1 | RFB_T1 | 2
CHG_OUT_T1 | CFB_T1 | 1
CHG_IN_T1 | CFB_T1 | 2
PVDF_T1 | RIN_T1 | 1
CHG_IN_T1 | RIN_T1 | 2
CHG_OUT_T1 | RS1A_T1 | 1
S1_A_T1 | RS1A_T1 | 2
S1_A_T1 | RS1B_T1 | 1
S1_B_T1 | RS1B_T1 | 2
S1_A_T1 | CS1FB_T1 | 1
S1_OUT_T1 | CS1FB_T1 | 2
S1_B_T1 | CS1G_T1 | 1
VMID1V25 | CS1G_T1 | 2
S1_OUT_T1 | RS2A_T1 | 1
S2_A_T1 | RS2A_T1 | 2
S2_A_T1 | RS2B_T1 | 1
S2_B_T1 | RS2B_T1 | 2
S2_A_T1 | CS2FB_T1 | 1
S2_OUT_T1 | CS2FB_T1 | 2
S2_B_T1 | CS2G_T1 | 1
VMID1V25 | CS2G_T1 | 2
PRESS_T1 | RPD_T1 | 1
GND | RPD_T1 | 2
CHG_OUT_T2 | RFB_T2 | 1
CHG_IN_T2 | RFB_T2 | 2
CHG_OUT_T2 | CFB_T2 | 1
CHG_IN_T2 | CFB_T2 | 2
PVDF_T2 | RIN_T2 | 1
CHG_IN_T2 | RIN_T2 | 2
CHG_OUT_T2 | RS1A_T2 | 1
S1_A_T2 | RS1A_T2 | 2
S1_A_T2 | RS1B_T2 | 1
S1_B_T2 | RS1B_T2 | 2
S1_A_T2 | CS1FB_T2 | 1
S1_OUT_T2 | CS1FB_T2 | 2
S1_B_T2 | CS1G_T2 | 1
VMID1V25 | CS1G_T2 | 2
S1_OUT_T2 | RS2A_T2 | 1
S2_A_T2 | RS2A_T2 | 2
S2_A_T2 | RS2B_T2 | 1
S2_B_T2 | RS2B_T2 | 2
S2_A_T2 | CS2FB_T2 | 1
S2_OUT_T2 | CS2FB_T2 | 2
S2_B_T2 | CS2G_T2 | 1
VMID1V25 | CS2G_T2 | 2
PRESS_T2 | RPD_T2 | 1
GND | RPD_T2 | 2
CHG_OUT_P1 | RFB_P1 | 1
CHG_IN_P1 | RFB_P1 | 2
CHG_OUT_P1 | CFB_P1 | 1
CHG_IN_P1 | CFB_P1 | 2
PVDF_P1 | RIN_P1 | 1
CHG_IN_P1 | RIN_P1 | 2
CHG_OUT_P1 | RS1A_P1 | 1
S1_A_P1 | RS1A_P1 | 2
S1_A_P1 | RS1B_P1 | 1
S1_B_P1 | RS1B_P1 | 2
S1_A_P1 | CS1FB_P1 | 1
S1_OUT_P1 | CS1FB_P1 | 2
S1_B_P1 | CS1G_P1 | 1
VMID1V25 | CS1G_P1 | 2
S1_OUT_P1 | RS2A_P1 | 1
S2_A_P1 | RS2A_P1 | 2
S2_A_P1 | RS2B_P1 | 1
S2_B_P1 | RS2B_P1 | 2
S2_A_P1 | CS2FB_P1 | 1
S2_OUT_P1 | CS2FB_P1 | 2
S2_B_P1 | CS2G_P1 | 1
VMID1V25 | CS2G_P1 | 2
PRESS_P1 | RPD_P1 | 1
GND | RPD_P1 | 2
CHG_OUT_P2 | RFB_P2 | 1
CHG_IN_P2 | RFB_P2 | 2
CHG_OUT_P2 | CFB_P2 | 1
CHG_IN_P2 | CFB_P2 | 2
PVDF_P2 | RIN_P2 | 1
CHG_IN_P2 | RIN_P2 | 2
CHG_OUT_P2 | RS1A_P2 | 1
S1_A_P2 | RS1A_P2 | 2
S1_A_P2 | RS1B_P2 | 1
S1_B_P2 | RS1B_P2 | 2
S1_A_P2 | CS1FB_P2 | 1
S1_OUT_P2 | CS1FB_P2 | 2
S1_B_P2 | CS1G_P2 | 1
VMID1V25 | CS1G_P2 | 2
S1_OUT_P2 | RS2A_P2 | 1
S2_A_P2 | RS2A_P2 | 2
S2_A_P2 | RS2B_P2 | 1
S2_B_P2 | RS2B_P2 | 2
S2_A_P2 | CS2FB_P2 | 1
S2_OUT_P2 | CS2FB_P2 | 2
S2_B_P2 | CS2G_P2 | 1
VMID1V25 | CS2G_P2 | 2
PRESS_P2 | RPD_P2 | 1
GND | RPD_P2 | 2
CHG_OUT_P3 | RFB_P3 | 1
CHG_IN_P3 | RFB_P3 | 2
CHG_OUT_P3 | CFB_P3 | 1
CHG_IN_P3 | CFB_P3 | 2
PVDF_P3 | RIN_P3 | 1
CHG_IN_P3 | RIN_P3 | 2
CHG_OUT_P3 | RS1A_P3 | 1
S1_A_P3 | RS1A_P3 | 2
S1_A_P3 | RS1B_P3 | 1
S1_B_P3 | RS1B_P3 | 2
S1_A_P3 | CS1FB_P3 | 1
S1_OUT_P3 | CS1FB_P3 | 2
S1_B_P3 | CS1G_P3 | 1
VMID1V25 | CS1G_P3 | 2
S1_OUT_P3 | RS2A_P3 | 1
S2_A_P3 | RS2A_P3 | 2
S2_A_P3 | RS2B_P3 | 1
S2_B_P3 | RS2B_P3 | 2
S2_A_P3 | CS2FB_P3 | 1
S2_OUT_P3 | CS2FB_P3 | 2
S2_B_P3 | CS2G_P3 | 1
VMID1V25 | CS2G_P3 | 2
PRESS_P3 | RPD_P3 | 1
GND | RPD_P3 | 2
CHG_OUT_P4 | RFB_P4 | 1
CHG_IN_P4 | RFB_P4 | 2
CHG_OUT_P4 | CFB_P4 | 1
CHG_IN_P4 | CFB_P4 | 2
PVDF_P4 | RIN_P4 | 1
CHG_IN_P4 | RIN_P4 | 2
CHG_OUT_P4 | RS1A_P4 | 1
S1_A_P4 | RS1A_P4 | 2
S1_A_P4 | RS1B_P4 | 1
S1_B_P4 | RS1B_P4 | 2
S1_A_P4 | CS1FB_P4 | 1
S1_OUT_P4 | CS1FB_P4 | 2
S1_B_P4 | CS1G_P4 | 1
VMID1V25 | CS1G_P4 | 2
S1_OUT_P4 | RS2A_P4 | 1
S2_A_P4 | RS2A_P4 | 2
S2_A_P4 | RS2B_P4 | 1
S2_B_P4 | RS2B_P4 | 2
S2_A_P4 | CS2FB_P4 | 1
S2_OUT_P4 | CS2FB_P4 | 2
S2_B_P4 | CS2G_P4 | 1
VMID1V25 | CS2G_P4 | 2
PRESS_P4 | RPD_P4 | 1
GND | RPD_P4 | 2
CHG_OUT_H1 | RFB_H1 | 1
CHG_IN_H1 | RFB_H1 | 2
CHG_OUT_H1 | CFB_H1 | 1
CHG_IN_H1 | CFB_H1 | 2
PVDF_H1 | RIN_H1 | 1
CHG_IN_H1 | RIN_H1 | 2
CHG_OUT_H1 | RS1A_H1 | 1
S1_A_H1 | RS1A_H1 | 2
S1_A_H1 | RS1B_H1 | 1
S1_B_H1 | RS1B_H1 | 2
S1_A_H1 | CS1FB_H1 | 1
S1_OUT_H1 | CS1FB_H1 | 2
S1_B_H1 | CS1G_H1 | 1
VMID1V25 | CS1G_H1 | 2
S1_OUT_H1 | RS2A_H1 | 1
S2_A_H1 | RS2A_H1 | 2
S2_A_H1 | RS2B_H1 | 1
S2_B_H1 | RS2B_H1 | 2
S2_A_H1 | CS2FB_H1 | 1
S2_OUT_H1 | CS2FB_H1 | 2
S2_B_H1 | CS2G_H1 | 1
VMID1V25 | CS2G_H1 | 2
PRESS_H1 | RPD_H1 | 1
GND | RPD_H1 | 2
CHG_OUT_H2 | RFB_H2 | 1
CHG_IN_H2 | RFB_H2 | 2
CHG_OUT_H2 | CFB_H2 | 1
CHG_IN_H2 | CFB_H2 | 2
PVDF_H2 | RIN_H2 | 1
CHG_IN_H2 | RIN_H2 | 2
CHG_OUT_H2 | RS1A_H2 | 1
S1_A_H2 | RS1A_H2 | 2
S1_A_H2 | RS1B_H2 | 1
S1_B_H2 | RS1B_H2 | 2
S1_A_H2 | CS1FB_H2 | 1
S1_OUT_H2 | CS1FB_H2 | 2
S1_B_H2 | CS1G_H2 | 1
VMID1V25 | CS1G_H2 | 2
S1_OUT_H2 | RS2A_H2 | 1
S2_A_H2 | RS2A_H2 | 2
S2_A_H2 | RS2B_H2 | 1
S2_B_H2 | RS2B_H2 | 2
S2_A_H2 | CS2FB_H2 | 1
S2_OUT_H2 | CS2FB_H2 | 2
S2_B_H2 | CS2G_H2 | 1
VMID1V25 | CS2G_H2 | 2
PRESS_H2 | RPD_H2 | 1
GND | RPD_H2 | 2
3V3A | C_LDO_IN | 1
GND | C_LDO_IN | 2
1V8 | C_LDO_OUT | 1
GND | C_LDO_OUT | 2
VREF3V0 | C_REF | 1
GND | C_REF | 2
1V8 | C_ADC_AVDD | 1
GND | C_ADC_AVDD | 2
3V3A | C_ADC_DVIO | 1
GND | C_ADC_DVIO | 2
VREF3V0 | C_ADC_REF | 1
GND | C_ADC_REF | 2
3V3A | CDEC_U_LDO | 1
GND | CDEC_U_LDO | 2
3V3A | CDEC_U_REF | 1
GND | CDEC_U_REF | 2
3V3A | CDEC_U_VMID | 1
GND | CDEC_U_VMID | 2
3V3A | CDEC_U_ADC_DRV | 1
GND | CDEC_U_ADC_DRV | 2
3V3A | CDEC_U_MUX1 | 1
GND | CDEC_U_MUX1 | 2
3V3A | CDEC_U_MUX2 | 1
GND | CDEC_U_MUX2 | 2
3V3A | CDEC_U_MUX3 | 1
GND | CDEC_U_MUX3 | 2
3V3A | CDEC_U_MUX4 | 1
GND | CDEC_U_MUX4 | 2
3V3A | CDEC_U_MUX_FINAL | 1
GND | CDEC_U_MUX_FINAL | 2
3V3A | CDEC_U_CHG1 | 1
GND | CDEC_U_CHG1 | 2
3V3A | CDEC_U_CHG2 | 1
GND | CDEC_U_CHG2 | 2
3V3A | CDEC_U_CHG3 | 1
GND | CDEC_U_CHG3 | 2
3V3A | CDEC_U_CHG4 | 1
GND | CDEC_U_CHG4 | 2
3V3A | CDEC_U_CHG5 | 1
GND | CDEC_U_CHG5 | 2
3V3A | CDEC_U_FILT1 | 1
GND | CDEC_U_FILT1 | 2
3V3A | CDEC_U_FILT2 | 1
GND | CDEC_U_FILT2 | 2
3V3A | CDEC_U_FILT3 | 1
GND | CDEC_U_FILT3 | 2
3V3A | CDEC_U_FILT4 | 1
GND | CDEC_U_FILT4 | 2
3V3A | CDEC_U_FILT5 | 1
GND | CDEC_U_FILT5 | 2
3V3A | CDEC_U_FILT6 | 1
GND | CDEC_U_FILT6 | 2
3V3A | CDEC_U_FILT7 | 1
GND | CDEC_U_FILT7 | 2
3V3A | CDEC_U_FILT8 | 1
GND | CDEC_U_FILT8 | 2
3V3A | CDEC_U_FILT9 | 1
GND | CDEC_U_FILT9 | 2
3V3A | CDEC_U_FILT10 | 1
GND | CDEC_U_FILT10 | 2
3V3A | CDEC_U_BANK1 | 1
GND | CDEC_U_BANK1 | 2
3V3 | CDEC_U_IOX | 1
GND | CDEC_U_IOX | 2
VEXC2V5 | R_VMID_H | 1
VMID_DIV | R_VMID_H | 2
VMID_DIV | R_VMID_L | 1
GND | R_VMID_L | 2
VMID_DIV | C_VMID | 1
GND | C_VMID | 2
ADC_DRIVER_OUT | R_ADC_ISO | 1
ADC_AIN+ | R_ADC_ISO | 2
ADC_AIN+ | C_ADC_BUCKET | 1
GND | C_ADC_BUCKET | 2
3V3 | R_I2C_SDA | 1
I2C_SDA | R_I2C_SDA | 2
3V3 | R_I2C_SCL | 1
I2C_SCL | R_I2C_SCL | 2
BTN0 | SW1 | 1
GND | SW1 | 2
3V3 | U_LOAD | 1
GND | U_LOAD | 2
ANALOG_EN | U_LOAD | 3
3V3A | U_LOAD | 5
3V3A | U_LOAD | 6
ANALOG_EN | R_ANALOG_EN | 1
GND | R_ANALOG_EN | 2
3V3 | R_WAKE | 1
WAKE_IRQ | R_WAKE | 2
3V3 | C_LOAD_IN | 1
GND | C_LOAD_IN | 2
3V3A | C_LOAD_OUT | 1
GND | C_LOAD_OUT | 2
ADC_NEG_OUT | U_ADC_NEG | 1
GND | U_ADC_NEG | 2
VMID1V25 | U_ADC_NEG | 3
ADC_NEG_OUT | U_ADC_NEG | 4
3V3A | U_ADC_NEG | 5
3V3A | CDEC_U_ADC_NEG | 1
GND | CDEC_U_ADC_NEG | 2
ADC_NEG_OUT | R_ADC_NEG_ISO | 1
ADC_AIN- | R_ADC_NEG_ISO | 2
ADC_AIN- | C_ADC_NEG_BUCKET | 1
GND | C_ADC_NEG_BUCKET | 2
3V3 | R_BTN0 | 1
BTN0 | R_BTN0 | 2
MUX_A1 | U_MUX_ADDR | 1
MUX_A2 | U_MUX_ADDR | 2
MUX_A3 | U_MUX_ADDR | 3
MUX_BANK0 | U_MUX_ADDR | 4
MUX_BANK1 | U_MUX_ADDR | 5
GND | U_MUX_ADDR | 8
3V3A | U_MUX_ADDR | 10
MUX_SRCLK | U_MUX_ADDR | 11
MUX_RCLK | U_MUX_ADDR | 12
GND | U_MUX_ADDR | 13
MUX_SER | U_MUX_ADDR | 14
MUX_A0 | U_MUX_ADDR | 15
3V3A | U_MUX_ADDR | 16
3V3A | C_MUX_ADDR | 1
GND | C_MUX_ADDR | 2
VREF3V0 | R_VEXC_H | 1
VEXC_DIV | R_VEXC_H | 2
VEXC_DIV | R_VEXC_L | 1
GND | R_VEXC_L | 2
VMID_DIV | R_VMID_IN | 1
VMID_BUF_IN | R_VMID_IN | 2
3V3A | D_LDO_REV | 1
1V8 | D_LDO_REV | 2
VEXC_DRV | R_VEXC_ISO | 1
VEXC2V5 | R_VEXC_ISO | 2
VEXC2V5 | R_VEXC_FB | 1
VEXC_FB | R_VEXC_FB | 2
VEXC_DRV | C_VEXC_FB | 1
VEXC_FB | C_VEXC_FB | 2
VEXC2V5 | C_VEXC | 1
GND | C_VEXC | 2
VMID1V25 | D_CLAMP_I1 | 1
VMID1V25 | D_CLAMP_I1 | 2
CHG_IN_I1 | D_CLAMP_I1 | 3
VMID1V25 | D_CLAMP_I2 | 1
VMID1V25 | D_CLAMP_I2 | 2
CHG_IN_I2 | D_CLAMP_I2 | 3
VMID1V25 | D_CLAMP_I3 | 1
VMID1V25 | D_CLAMP_I3 | 2
CHG_IN_I3 | D_CLAMP_I3 | 3
VMID1V25 | D_CLAMP_M1 | 1
VMID1V25 | D_CLAMP_M1 | 2
CHG_IN_M1 | D_CLAMP_M1 | 3
VMID1V25 | D_CLAMP_M2 | 1
VMID1V25 | D_CLAMP_M2 | 2
CHG_IN_M2 | D_CLAMP_M2 | 3
VMID1V25 | D_CLAMP_M3 | 1
VMID1V25 | D_CLAMP_M3 | 2
CHG_IN_M3 | D_CLAMP_M3 | 3
VMID1V25 | D_CLAMP_R1 | 1
VMID1V25 | D_CLAMP_R1 | 2
CHG_IN_R1 | D_CLAMP_R1 | 3
VMID1V25 | D_CLAMP_R2 | 1
VMID1V25 | D_CLAMP_R2 | 2
CHG_IN_R2 | D_CLAMP_R2 | 3
VMID1V25 | D_CLAMP_R3 | 1
VMID1V25 | D_CLAMP_R3 | 2
CHG_IN_R3 | D_CLAMP_R3 | 3
VMID1V25 | D_CLAMP_L1 | 1
VMID1V25 | D_CLAMP_L1 | 2
CHG_IN_L1 | D_CLAMP_L1 | 3
VMID1V25 | D_CLAMP_L2 | 1
VMID1V25 | D_CLAMP_L2 | 2
CHG_IN_L2 | D_CLAMP_L2 | 3
VMID1V25 | D_CLAMP_L3 | 1
VMID1V25 | D_CLAMP_L3 | 2
CHG_IN_L3 | D_CLAMP_L3 | 3
VMID1V25 | D_CLAMP_T1 | 1
VMID1V25 | D_CLAMP_T1 | 2
CHG_IN_T1 | D_CLAMP_T1 | 3
VMID1V25 | D_CLAMP_T2 | 1
VMID1V25 | D_CLAMP_T2 | 2
CHG_IN_T2 | D_CLAMP_T2 | 3
VMID1V25 | D_CLAMP_P1 | 1
VMID1V25 | D_CLAMP_P1 | 2
CHG_IN_P1 | D_CLAMP_P1 | 3
VMID1V25 | D_CLAMP_P2 | 1
VMID1V25 | D_CLAMP_P2 | 2
CHG_IN_P2 | D_CLAMP_P2 | 3
VMID1V25 | D_CLAMP_P3 | 1
VMID1V25 | D_CLAMP_P3 | 2
CHG_IN_P3 | D_CLAMP_P3 | 3
VMID1V25 | D_CLAMP_P4 | 1
VMID1V25 | D_CLAMP_P4 | 2
CHG_IN_P4 | D_CLAMP_P4 | 3
VMID1V25 | D_CLAMP_H1 | 1
VMID1V25 | D_CLAMP_H1 | 2
CHG_IN_H1 | D_CLAMP_H1 | 3
VMID1V25 | D_CLAMP_H2 | 1
VMID1V25 | D_CLAMP_H2 | 2
CHG_IN_H2 | D_CLAMP_H2 | 3
