latintzar/tactile-glove/assets/glove-concept.webp

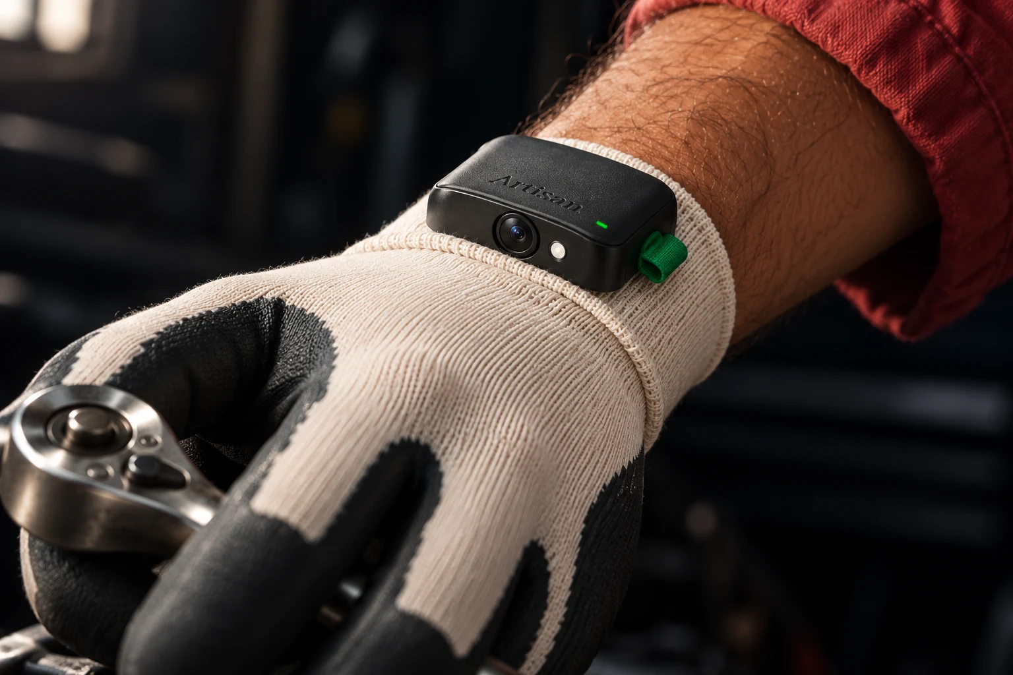
assets/glove-concept.webp
