latintzar/tactile-glove/hardware/glove-v4/procurement/bom-source-plan.csv

scope | category | item | manufacturer_mpn | required_qty | refs | footprint | stock_evidence | stock_snapshot | unit_price_snapshot | price_basis | supplier_part_id | source_url | status
main-board | camera | 2N7002,215 | 2N7002,215 | 8 | Q_USB_SUSPEND;Q_USB_CC_ILIM;Q_CHG_ENABLE;Q_CHG_DISABLE;Q_REF_GATE;Q_BAT_MEAS_GATE;Q_CAM_OE;Q_CAM_SCCB | Package_TO_SOT_SMD:SOT-23 | No bounded exact stock snapshot in retained sources |  |  |  |  | https://assets.nexperia.com/documents/data-sheet/2N7002.pdf | source/quote required
main-board | camera | 74LVC1G04GW,125 | 74LVC1G04GW,125 | 1 | U_CAM_IF_INV | Package_TO_SOT_SMD:SOT-353_SC-70-5 | No bounded exact stock snapshot in retained sources |  |  |  |  | https://assets.nexperia.com/documents/data-sheet/74LVC1G04.pdf | source/quote required
main-board | power | APTF1616LSEEZGKQBKC | APTF1616LSEEZGKQBKC | 1 | D_RGB | GlovePower:Kingbright_APTF1616 | No bounded exact stock snapshot in retained sources |  |  |  |  | https://www.kingbrightusa.com/images/catalog/spec/aptf1616lseezgkqbkc.pdf | source/quote required
main-board | power | Battery thermistor connector | B2B-PH-K-S(LF)(SN) | 1 | J_NTC | Connector_JST:JST_PH_B2B-PH-K_1x02_P2.00mm_Vertical | Existing PH connector retained for Semitec 103AT-2 only |  |  |  | C131337 | https://www.jst.com/wp-content/uploads/2025/06/ePH.pdf | current thermistor path; reconfirm before quote
main-board | power | Battery entry PCB header | 43045-0200 | 1 | J_BAT | Connector_Molex:Molex_Micro-Fit_3.0_43045-0200_2x01_P3.00mm_Horizontal | Comet.bg exact page: local 0; distributor 3555, 7–10 days on request; EUR1.283 qty5 excl VAT (checked 2026-10-23). Retained DigiKey snapshot 14,547 is foreign distributor evidence, not Sofia stock. | Comet local 0; distributor 3555 (2026-10-23) | 1.283 EUR | Comet.bg exact page, MOQ5, excl VAT |  | https://www.molex.com/en-us/products/part-detail/0430450200 | current V4 direct-AWG22 path; placement/reach pending final route
main-board | tactile | BAV199,215 | BAV199,215 | 20 | D_CLAMP_I1;D_CLAMP_I2;D_CLAMP_I3;D_CLAMP_M1;D_CLAMP_M2;D_CLAMP_M3;D_CLAMP_R1;D_CLAMP_R2;D_CLAMP_R3;D_CLAMP_L1;D_CLAMP_L2;D_CLAMP_L3;D_CLAMP_T1;D_CLAMP_T2;D_CLAMP_P1;D_CLAMP_P2;D_CLAMP_P3;D_CLAMP_P4;D_CLAMP_H1;D_CLAMP_H2 | Glove:SOT-23 | V3 JLC catalog snapshot: visible exact row/stock | 75308 | 0.0378 | JLC V3 catalog snapshot; point-in-time | C40919 | https://assets.nexperia.com/documents/data-sheet/BAV199.pdf | stock evidence captured; reconfirm before quote
main-board | tactile | BM06B-GHS-TBT(LF)(SN) | BM06B-GHS-TBT(LF)(SN) | 1 | J_THUMB | Glove:JST_GH_BM06B-GHS-TBT_1x06-1MP_P1.25mm_Vertical | V3 JLC catalog snapshot: visible exact row/stock | 1359 | 1.1839 | JLC V3 catalog snapshot; point-in-time | C189892 | https://www.jst-mfg.com/product/index.php?series=308 | stock evidence captured; reconfirm before quote
main-board | tactile | BM08B-GHS-TBT(LF)(SN) | BM08B-GHS-TBT(LF)(SN) | 4 | J_INDEX;J_MIDDLE;J_RING;J_LITTLE | Glove:JST_GH_BM08B-GHS-TBT_1x08-1MP_P1.25mm_Vertical | V3 JLC catalog snapshot: visible exact row/stock | 6001 | 0.2898 | JLC V3 catalog snapshot; point-in-time | C133062 | https://www.jst-mfg.com/product/index.php?series=308 | stock evidence captured; reconfirm before quote
main-board | tactile | BM14B-GHS-TBT(LF)(SN) | BM14B-GHS-TBT(LF)(SN) | 1 | J_PALM_HEEL | Glove:JST_GH_BM14B-GHS-TBT_1x14-1MP_P1.25mm_Vertical | V3 JLC catalog snapshot: visible exact row/stock | 1109 | 0.6132 | JLC V3 catalog snapshot; point-in-time | C265384 | https://www.jst-mfg.com/product/index.php?series=308 | stock evidence captured; reconfirm before quote
main-board | power | BQ25616RTWR | BQ25616RTWR | 1 | U_CHARGER | GlovePower:TI_RTW0024_BQ25616 | Comet.bg exact MPN absent in 2026-10-22 bounded search; search gap, not an out-of-stock claim. |  |  |  |  | https://www.ti.com/lit/ds/symlink/bq25616.pdf | source/quote required
main-board | tactile | C0603C123J3GACAUTO | C0603C123J3GACAUTO | 20 | CS1FB_I1;CS1FB_I2;CS1FB_I3;CS1FB_M1;CS1FB_M2;CS1FB_M3;CS1FB_R1;CS1FB_R2;CS1FB_R3;CS1FB_L1;CS1FB_L2;CS1FB_L3;CS1FB_T1;CS1FB_T2;CS1FB_P1;CS1FB_P2;CS1FB_P3;CS1FB_P4;CS1FB_H1;CS1FB_H2 | Glove:C_0603_1608Metric | V3 JLC catalog snapshot: visible exact row/stock | 238 | 0.3364 | JLC V3 catalog snapshot; point-in-time | C2177880 | https://jlcpcb.com/parts/componentSearch?searchTxt=C0603C123J3GACAUTO | stock evidence captured; reconfirm before quote
main-board | tactile | C0603C153J3GACAUTO | C0603C153J3GACAUTO | 20 | CS2FB_I1;CS2FB_I2;CS2FB_I3;CS2FB_M1;CS2FB_M2;CS2FB_M3;CS2FB_R1;CS2FB_R2;CS2FB_R3;CS2FB_L1;CS2FB_L2;CS2FB_L3;CS2FB_T1;CS2FB_T2;CS2FB_P1;CS2FB_P2;CS2FB_P3;CS2FB_P4;CS2FB_H1;CS2FB_H2 | Glove:C_0603_1608Metric | V3 JLC catalog snapshot: visible exact row/stock | 454 | 0.3469 | JLC V3 catalog snapshot; point-in-time | C1845711 | https://jlcpcb.com/parts/componentSearch?searchTxt=C0603C153J3GACAUTO | stock evidence captured; reconfirm before quote
main-board | tactile | CD74HC4052M | CD74HC4052M | 1 | U_MUX_FINAL | Glove:SOIC-16_3.9x9.9mm_P1.27mm | V3 JLC catalog snapshot: zero or unreported stock | 0 | 0.3292 | JLC V3 catalog snapshot; point-in-time | C1545947 | https://www.ti.com/product/CD74HC4052 | stock gap; exact MPN retained
main-board | tactile | CD74HC4067M | CD74HC4067M | 4 | U_MUX1;U_MUX2;U_MUX3;U_MUX4 | Glove:SOIC-24W_7.5x15.4mm_P1.27mm | V3 JLC catalog snapshot: visible exact row/stock | 176 | 1.2002 | JLC V3 catalog snapshot; point-in-time | C1545936 | https://www.ti.com/lit/ds/symlink/cd74hct4067.pdf | stock evidence captured; reconfirm before quote
main-board | camera | CL21A106KAYNNNE | CL21A106KAYNNNE | 6 | C_CAM_IO_IN;C_CAM_IO_OUT;C_CAM_AV_IN;C_CAM_AV_OUT;C_CAM_DV_IN;C_CAM_DV_OUT | Capacitor_SMD:C_0805_2012Metric | No bounded exact stock snapshot in retained sources |  |  |  |  | https://product.samsungsem.com/mlcc/CL21A106KAYNNNE.do | source/quote required
main-board | sd | DM3AT-SF-PEJM5 | DM3AT-SF-PEJM5 | 1 | J_SD | Connector_Card:microSD_HC_Hirose_DM3AT-SF-PEJM5 | No bounded exact stock snapshot in retained sources |  |  |  |  | https://www.hirose.com/en/product/p/CL0609-0031-0-00 | source/quote required
main-board | power | DMP2035U-7 | DMP2035U-7 | 2 | Q_REF_FEED;Q_BAT_MEAS | Package_TO_SOT_SMD:SOT-23 | No bounded exact stock snapshot in retained sources |  |  |  |  | https://www.diodes.com/assets/Datasheets/DMP2035U.pdf | source/quote required
main-board | power | ESP32-S3-WROOM-1-N8R8 | ESP32-S3-WROOM-1-N8R8 | 1 | U_MCU | RF_Module:ESP32-S3-WROOM-1 | Comet.bg Sofia stock 356 observed 2026-10-22; Plovdiv 0; USD4.30213 excl VAT; reconfirm before quote. | 356 Sofia (2026-10-22) | 4.30213 USD | Comet.bg exact page, excl VAT |  | https://documentation.espressif.com/esp32-s3-wroom-1_wroom-1u_datasheet_en.pdf | verified local snapshot; quote/delivery reconfirmation required
main-board | camera | FH12-24S-0.5SH(55) | FH12-24S-0.5SH(55) | 1 | J_CAM | Connector_FFC-FPC:Hirose_FH12-24S-0.5SH_1x24-1MP_P0.50mm_Horizontal | No bounded exact stock snapshot in retained sources |  |  |  |  | https://www.hirose.com/product/p/CL0586-0521-0-55 | source/quote required
main-board | tactile | GRM1885C1H102JA01D | GRM1885C1H102JA01D | 2 | C_ADC_BUCKET;C_ADC_NEG_BUCKET | Glove:C_0603_1608Metric | V3 JLC catalog snapshot: visible exact row/stock | 93625 | 0.0262 | JLC V3 catalog snapshot; point-in-time | C77026 | https://jlcpcb.com/parts/componentSearch?searchTxt=GRM1885C1H102JA01D | stock evidence captured; reconfirm before quote
main-board | tactile | GRM1885C1H103JA01D | GRM1885C1H103JA01D | 20 | CS1G_I1;CS1G_I2;CS1G_I3;CS1G_M1;CS1G_M2;CS1G_M3;CS1G_R1;CS1G_R2;CS1G_R3;CS1G_L1;CS1G_L2;CS1G_L3;CS1G_T1;CS1G_T2;CS1G_P1;CS1G_P2;CS1G_P3;CS1G_P4;CS1G_H1;CS1G_H2 | Glove:C_0603_1608Metric | V3 JLC catalog snapshot: visible exact row/stock | 314502 | 0.0354 | JLC V3 catalog snapshot; point-in-time | C85973 | https://jlcpcb.com/parts/componentSearch?searchTxt=GRM1885C1H103JA01D | stock evidence captured; reconfirm before quote
main-board | tactile | GRM1885C1H222JA01D | GRM1885C1H222JA01D | 20 | CS2G_I1;CS2G_I2;CS2G_I3;CS2G_M1;CS2G_M2;CS2G_M3;CS2G_R1;CS2G_R2;CS2G_R3;CS2G_L1;CS2G_L2;CS2G_L3;CS2G_T1;CS2G_T2;CS2G_P1;CS2G_P2;CS2G_P3;CS2G_P4;CS2G_H1;CS2G_H2 | Glove:C_0603_1608Metric | V3 JLC catalog snapshot: visible exact row/stock | 71821 | 0.0205 | JLC V3 catalog snapshot; point-in-time | C77033 | https://jlcpcb.com/parts/componentSearch?searchTxt=GRM1885C1H222JA01D | stock evidence captured; reconfirm before quote
main-board | tactile | GRM1885C1H471JA01D | GRM1885C1H471JA01D | 20 | CFB_I1;CFB_I2;CFB_I3;CFB_M1;CFB_M2;CFB_M3;CFB_R1;CFB_R2;CFB_R3;CFB_L1;CFB_L2;CFB_L3;CFB_T1;CFB_T2;CFB_P1;CFB_P2;CFB_P3;CFB_P4;CFB_H1;CFB_H2 | Glove:C_0603_1608Metric | V3 JLC catalog snapshot: visible exact row/stock | 57886 | 0.0150 | JLC V3 catalog snapshot; point-in-time | C85979 | https://jlcpcb.com/parts/componentSearch?searchTxt=GRM1885C1H471JA01D | stock evidence captured; reconfirm before quote
main-board | tactile | GRM188R61A105KA61D | GRM188R61A105KA61D | 7 | C_LDO_IN;C_LDO_OUT;C_REF;C_ADC_AVDD;CDEC_U_REF;C_VMID;C_VEXC | Glove:C_0603_1608Metric | V3 JLC catalog snapshot: visible exact row/stock | 31869 | 0.0336 | JLC V3 catalog snapshot; point-in-time | C86012 | https://jlcpcb.com/parts/componentSearch?searchTxt=GRM188R61A105KA61D | stock evidence captured; reconfirm before quote
main-board | imu | GRM188R61A475KE15D | GRM188R61A475KE15D | 1 | C_IMU_CUFF_BULK | GloveV4:C_0603_1608Metric | No bounded exact stock snapshot in retained sources |  |  |  |  | https://www.murata.com/en-us/products/capacitor/mlcc | source/quote required
main-board | power | GRM188R61C105KA93D | GRM188R61C105KA93D | 4 | C_USB_RAW;C_USB_LIMITED;C_BOOT_DELAY;C_REF_SUPPLY | Capacitor_SMD:C_0603_1608Metric | No bounded exact stock snapshot in retained sources |  |  |  |  | https://www.murata.com/en-us/products/capacitor/mlcc | source/quote required
main-board | imu | GRM188R71C104KA01D | GRM188R71C104KA01D | 34 | C_MUX_ADDR;C_CC;C_U_CC_HIGH;C_U_CC_ATTACH;C_U_CFG_CLEAR;C_U_CFG_RESET;C_USB_CFG;C_U_USB_ALLOW;C_U_USB_NOSUSP;C_U_USB_ON;C_TS;C_BAT_WINDOW;C_MAIN_AUX;C_BAT_READY;C_U_BOOT_SOURCE;C_U_BOOT_PG;C_U_BOOT_SCHMITT;C_U_ANALOG_OFF;C_BAT_ADC;C_MCU;C_BUTTON;C_IO0;C_IO1;C_CAM_IO_HF;C_CAM_AV_HF;C_CAM_DV_HF;C_CAM_DATA_A;C_CAM_DATA_B;C_CAM_CTRL_A;C_CAM_CTRL_B;C_CAM_IF_INV;C_IMU_CUFF_VDD;C_IMU_CUFF_IO;C_SD_HF | Glove:C_0603_1608Metric | V3 JLC catalog snapshot: visible exact row/stock | 30840 | 0.0171 | JLC V3 catalog snapshot; point-in-time | C45000 | https://www.murata.com/en-us/products/capacitor/mlcc | stock evidence captured; reconfirm before quote
main-board | tactile | GRM188R71H104KA93D | GRM188R71H104KA93D | 28 | C_ADC_DVIO;CDEC_U_LDO;CDEC_U_VMID;CDEC_U_ADC_DRV;CDEC_U_MUX1;CDEC_U_MUX2;CDEC_U_MUX3;CDEC_U_MUX4;CDEC_U_MUX_FINAL;CDEC_U_CHG1;CDEC_U_CHG2;CDEC_U_CHG3;CDEC_U_CHG4;CDEC_U_CHG5;CDEC_U_FILT1;CDEC_U_FILT2;CDEC_U_FILT3;CDEC_U_FILT4;CDEC_U_FILT5;CDEC_U_FILT6;CDEC_U_FILT7;CDEC_U_FILT8;CDEC_U_FILT9;CDEC_U_FILT10;CDEC_U_BANK1;CDEC_U_IOX;CDEC_U_ADC_NEG;C_VEXC_FB | Glove:C_0603_1608Metric | V3 JLC catalog snapshot: visible exact row/stock | 585615 | 0.0126 | JLC V3 catalog snapshot; point-in-time | C77055 | https://jlcpcb.com/parts/componentSearch?searchTxt=GRM188R71H104KA93D | stock evidence captured; reconfirm before quote
main-board | power | GRM188R71H473KA61D | GRM188R71H473KA61D | 1 | C_CHG_BTST | Capacitor_SMD:C_0603_1608Metric | No bounded exact stock snapshot in retained sources |  |  |  |  | https://www.murata.com/en-us/products/capacitor/mlcc | source/quote required
main-board | power | GRM21BC71E106ME11L | GRM21BC71E106ME11L | 4 | C_CHG_PMID;C_MAIN_IN0;C_MAIN_IN1;C_ANALOG_IN | Capacitor_SMD:C_0805_2012Metric | No bounded exact stock snapshot in retained sources |  |  |  |  | https://www.murata.com/en-us/products/capacitor/mlcc | source/quote required
main-board | power | GRM21BC81C226ME44L | GRM21BC81C226ME44L | 1 | C_MCU_BULK | Capacitor_SMD:C_0805_2012Metric | No bounded exact stock snapshot in retained sources |  |  |  |  | https://www.murata.com/en-us/products/capacitor/mlcc | source/quote required
main-board | sd | GRM21BR61A106KE19L | GRM21BR61A106KE19L | 1 | C_SD_IN | Capacitor_SMD:C_0805_2012Metric | V3 JLC catalog snapshot: in stock exact MPN |  |  |  |  | https://www.murata.com/en-us/products/capacitor/mlcc | historical evidence; reconfirm current stock
main-board | power | GRM21BR71A475KA73L | GRM21BR71A475KA73L | 1 | C_CHG_REGN | Capacitor_SMD:C_0805_2012Metric | No bounded exact stock snapshot in retained sources |  |  |  |  | https://www.murata.com/en-us/products/capacitor/mlcc | source/quote required
main-board | sd | GRM32ER61A476KE20L | GRM32ER61A476KE20L | 1 | C_SD_BULK | Capacitor_SMD:C_1210_3225Metric | No bounded exact stock snapshot in retained sources |  |  |  |  | https://www.murata.com/en-us/products/capacitor/mlcc | source/quote required
main-board | power | GRM32ER61C476KE15L | GRM32ER61C476KE15L | 9 | C_BAT;C_SYS0;C_SYS1;C_MAIN_OUT0;C_MAIN_OUT1;C_MAIN_OUT2;C_ANALOG_OUT0;C_ANALOG_OUT1;C_ANALOG_OUT2 | Capacitor_SMD:C_1210_3225Metric | No bounded exact stock snapshot in retained sources |  |  |  |  | https://search.murata.co.jp/Ceramy/image/img/A01X/G101/ENG/GRM32ER61C476KE15-01A.pdf | source/quote required
main-board | imu | ISM330DHCXTR | ISM330DHCXTR | 1 | U_IMU_CUFF | GloveV4:ST_ISM330DHCX_LGA14_0.35mm | Comet.bg exact MPN absent in 2026-10-22 bounded search; search gap, not an out-of-stock claim. |  |  |  |  | https://www.st.com/resource/en/datasheet/ism330dhcx.pdf | source/quote required
main-board | power | LM393LVDGKR | LM393LVDGKR | 1 | U_BAT_WINDOW | Package_SO:VSSOP-8_3x3mm_P0.65mm | No bounded exact stock snapshot in retained sources |  |  |  |  | https://www.ti.com/lit/ds/symlink/lm393lv.pdf | source/quote required
main-board | tactile | MCP33131D-10-I/MS | MCP33131D-10-I/MS | 1 | U_ADC | Glove:MSOP-10_3x3mm_P0.5mm | Comet.bg exact I/MS absent 2026-10-22; related MCP33131D-05-E/MS only (different voltage/speed/order code), never a substitution. Existing JLC snapshot is zero/unreported. | 0 | 12.2511 | JLC V3 catalog snapshot; point-in-time | C635979 | https://ww1.microchip.com/downloads/en/DeviceDoc/MCP33131D-Data-Sheet-DS20005947B.pdf | stock gap; exact MPN retained
main-board | tactile | MCP6002T-I/SN | MCP6002T-I/SN | 1 | U_VMID | Glove:SOIC-8_3.9x4.9mm_P1.27mm | V3 JLC catalog snapshot: visible exact row/stock | 54629 | 0.3034 | JLC V3 catalog snapshot; point-in-time | C7377 | https://jlcpcb.com/parts/componentSearch?searchTxt=MCP6002T-I%2FSN | stock evidence captured; reconfirm before quote
main-board | tactile | MCP6004T-I/ST | MCP6004T-I/ST | 15 | U_CHG1;U_CHG2;U_CHG3;U_CHG4;U_CHG5;U_FILT1;U_FILT2;U_FILT3;U_FILT4;U_FILT5;U_FILT6;U_FILT7;U_FILT8;U_FILT9;U_FILT10 | Glove:TSSOP-14_4.4x5mm_P0.65mm | V3 JLC catalog snapshot: visible exact row/stock | 11487 | 0.5593 | JLC V3 catalog snapshot; point-in-time | C50282 | https://store.comet.bg/Catalogue/Product/82685/ | stock evidence captured; reconfirm before quote
main-board | tactile | OPA320AIDBVR | OPA320AIDBVR | 2 | U_ADC_DRV;U_ADC_NEG | Glove:SOT-23-5 | V3 JLC catalog snapshot: visible exact row/stock | 25510 | 1.3670 | JLC V3 catalog snapshot; point-in-time | C92494 | https://www.ti.com/product/OPA320 | stock evidence captured; reconfirm before quote
main-board | tactile | OPA4323IPWR | OPA4323IPWR | 1 | U_BANK1 | Glove:TSSOP-14_4.4x5mm_P0.65mm | Comet.bg exact MPN absent in 2026-10-22 bounded search; retained JLC snapshot is separate; search gap, not an out-of-stock claim. | 2426 | 1.7627 | JLC V3 catalog snapshot; point-in-time | C22419728 | https://www.ti.com/lit/ds/symlink/opa4323.pdf | stock evidence captured; reconfirm before quote
main-board | camera | PCA9306DCTR | PCA9306DCTR | 1 | U_CAM_SCCB | Package_SO:SSOP-8_2.95x2.8mm_P0.65mm | No bounded exact stock snapshot in retained sources |  |  |  |  | https://www.ti.com/lit/ds/symlink/pca9306.pdf | source/quote required
main-board | power | PESD5V0U2BT,215 | PESD5V0U2BT,215 | 2 | D_USB_DATA;D_USB_CC | Package_TO_SOT_SMD:SOT-23 | No bounded exact stock snapshot in retained sources |  |  |  |  | https://assets.nexperia.com/documents/data-sheet/PESD5V0U2BT.pdf | source/quote required
main-board | tactile | PMEG2010ER,115 | PMEG2010ER,115 | 3 | D_LDO_REV;D_REF_REVERSE;D_ANALOG_REVERSE | GlovePower:Nexperia_CFP3_SOD123W | V3 JLC catalog snapshot: visible exact row/stock | 9002 | 0.1824 | JLC V3 catalog snapshot; point-in-time | C82288 | https://assets.nexperia.com/documents/data-sheet/PMEG2010ER.pdf | stock evidence captured; reconfirm before quote
main-board | power | PMV16XN,215 | PMV16XN,215 | 2 | Q_VREF_BLEED_OUT;Q_VREF_BLEED_IN | Package_TO_SOT_SMD:SOT-23 | No bounded exact stock snapshot in retained sources |  |  |  |  | https://assets.nexperia.com/documents/data-sheet/PMV16XN.pdf | source/quote required
main-board | power | PTS636SK43SMTR-LFS | PTS636SK43SMTR-LFS | 1 | SW_USER | Glove:SW_PTS636_SK43_G | V3 JLC catalog snapshot: exact row absent |  |  |  |  | https://www.ckswitches.com/media/2565/pts636.pdf | exact row gap; exact MPN retained
main-board | tactile | RC0603FR-07100KL | RC0603FR-07100KL | 37 | RIN_I1;RIN_I2;RIN_I3;RIN_M1;RIN_M2;RIN_M3;RIN_R1;RIN_R2;RIN_R3;RIN_L1;RIN_L2;RIN_L3;RIN_T1;RIN_T2;RIN_P1;RIN_P2;RIN_P3;RIN_P4;RIN_H1;RIN_H2;R_USB_RECOVERY_ON;R_USB_HIGH_ON;R_ANALOG_EN;R_REF_GATE;R_BAT_MEAS_GATE;R_DEFAULT_BAT_DIV_EN;R_DEFAULT_REG_PFM;R_DEFAULT_USB_CONFIG_SET;R_DEFAULT_USB_CONFIG_CLR_N;R_DEFAULT_USB_SUSPEND;R_DEFAULT_CHG_DISABLE;R_CAM_IO_EN;R_CAM_AV_EN;R_CAM_DV_EN;R_CAM_IF;R_CAM_MCU_RESET;R_SD_EN | Glove:R_0603_1608Metric | V3 JLC catalog snapshot: visible exact row/stock | 8993383 | 0.0026 | JLC V3 catalog snapshot; point-in-time | C14675 | https://www.yageo.com/en/Chart/Download/pdf/RC0603 | stock evidence captured; reconfirm before quote
main-board | tactile | RC0603FR-0710KL | RC0603FR-0710KL | 40 | RPD_I1;RPD_I2;RPD_I3;RPD_M1;RPD_M2;RPD_M3;RPD_R1;RPD_R2;RPD_R3;RPD_L1;RPD_L2;RPD_L3;RPD_T1;RPD_T2;RPD_P1;RPD_P2;RPD_P3;RPD_P4;RPD_H1;RPD_H2;R_VMID_H;R_VMID_L;R_VEXC_L;R_VEXC_FB;R_CC_OUT1;R_CC_OUT2;R_NTC_PULL;R_CHG_CE;R_BOOT_DELAY;R_BOOT0;R_STRAP45;R_STRAP46;R_MUX_LATCH;R_IO1_UNUSED_P07;R_IO1_SPARE0;R_IO1_SPARE1;R_IO1_SPARE2;R_IO1_SPARE3;R_IO1_SPARE4;R_IO1_SPARE5 | Glove:R_0603_1608Metric | V3 JLC catalog snapshot: visible exact row/stock | 10762809 | 0.0036 | JLC V3 catalog snapshot; point-in-time | C98220 | https://www.yageo.com/en/Chart/Download/pdf/RC0603 | stock evidence captured; reconfirm before quote
main-board | power | RC0603FR-0710ML | RC0603FR-0710ML | 2 | R_NTC_COLD_HYST;R_NTC_HOT_HYST | Resistor_SMD:R_0603_1608Metric | No bounded exact stock snapshot in retained sources |  |  |  |  | https://www.yageo.com/en/Chart/Download/pdf/RC0603 | source/quote required
main-board | power | RC0603FR-0710RL | RC0603FR-0710RL | 1 | R_REF_FILTER | Resistor_SMD:R_0603_1608Metric | No bounded exact stock snapshot in retained sources |  |  |  |  | https://www.yageo.com/en/Chart/Download/pdf/RC0603 | source/quote required
main-board | tactile | RC0603FR-0714K7L | RC0603FR-0714K7L | 40 | RS1A_I1;RS1B_I1;RS1A_I2;RS1B_I2;RS1A_I3;RS1B_I3;RS1A_M1;RS1B_M1;RS1A_M2;RS1B_M2;RS1A_M3;RS1B_M3;RS1A_R1;RS1B_R1;RS1A_R2;RS1B_R2;RS1A_R3;RS1B_R3;RS1A_L1;RS1B_L1;RS1A_L2;RS1B_L2;RS1A_L3;RS1B_L3;RS1A_T1;RS1B_T1;RS1A_T2;RS1B_T2;RS1A_P1;RS1B_P1;RS1A_P2;RS1B_P2;RS1A_P3;RS1B_P3;RS1A_P4;RS1B_P4;RS1A_H1;RS1B_H1;RS1A_H2;RS1B_H2 | Glove:R_0603_1608Metric | V3 JLC catalog snapshot: visible exact row/stock | 24304 | 0.0048 | JLC V3 catalog snapshot; point-in-time | C245912 | https://jlcpcb.com/parts/componentSearch?searchTxt=RC0603FR-0714K7L | stock evidence captured; reconfirm before quote
main-board | power | RC0603FR-071KL | RC0603FR-071KL | 2 | R_BUTTON_SERIES;R_LED_R | Resistor_SMD:R_0603_1608Metric | V3 JLC catalog snapshot: in stock exact MPN |  |  |  |  | https://www.yageo.com/en/Chart/Download/pdf/RC0603 | historical evidence; reconfirm current stock
main-board | camera | RC0603FR-07200KL | RC0603FR-07200KL | 1 | R_CAM_SCCB_BIAS | Resistor_SMD:R_0603_1608Metric | No bounded exact stock snapshot in retained sources |  |  |  |  | https://www.yageo.com/en/Chart/Download/pdf/RC0603 | source/quote required
main-board | power | RC0603FR-07220RL | RC0603FR-07220RL | 2 | R_VREF_GATE_OUT;R_VREF_GATE_IN | Resistor_SMD:R_0603_1608Metric | No bounded exact stock snapshot in retained sources |  |  |  |  | https://www.yageo.com/en/Chart/Download/pdf/RC0603 | source/quote required
main-board | tactile | RC0603FR-0722RL | RC0603FR-0722RL | 4 | R_ADC_ISO;R_ADC_NEG_ISO;R_USB_DP;R_USB_DM | Glove:R_0603_1608Metric | V3 JLC catalog snapshot: visible exact row/stock | 829030 | 0.0024 | JLC V3 catalog snapshot; point-in-time | C107701 | https://www.yageo.com/en/Chart/Download/pdf/RC0603 | stock evidence captured; reconfirm before quote
main-board | tactile | RC0603FR-0727K4L | RC0603FR-0727K4L | 40 | RS2A_I1;RS2B_I1;RS2A_I2;RS2B_I2;RS2A_I3;RS2B_I3;RS2A_M1;RS2B_M1;RS2A_M2;RS2B_M2;RS2A_M3;RS2B_M3;RS2A_R1;RS2B_R1;RS2A_R2;RS2B_R2;RS2A_R3;RS2B_R3;RS2A_L1;RS2B_L1;RS2A_L2;RS2B_L2;RS2A_L3;RS2B_L3;RS2A_T1;RS2B_T1;RS2A_T2;RS2B_T2;RS2A_P1;RS2B_P1;RS2A_P2;RS2B_P2;RS2A_P3;RS2B_P3;RS2A_P4;RS2B_P4;RS2A_H1;RS2B_H1;RS2A_H2;RS2B_H2 | Glove:R_0603_1608Metric | V3 JLC catalog snapshot: zero or unreported stock | 0 | 0.0025 | JLC V3 catalog snapshot; point-in-time | C165753 | https://jlcpcb.com/parts/componentSearch?searchTxt=RC0603FR-0727K4L | stock gap; exact MPN retained
main-board | camera | RC0603FR-072K2L | RC0603FR-072K2L | 4 | R_I2C_SDA;R_I2C_SCL;R_CAM_SDA;R_CAM_SCL | Resistor_SMD:R_0603_1608Metric | No bounded exact stock snapshot in retained sources |  |  |  |  | https://www.yageo.com/en/Chart/Download/pdf/RC0603 | source/quote required
main-board | tactile | RC0603FR-072KL | RC0603FR-072KL | 1 | R_VEXC_H | Glove:R_0603_1608Metric | V3 JLC catalog snapshot: visible exact row/stock | 770772 | 0.0021 | JLC V3 catalog snapshot; point-in-time | C105576 | https://jlcpcb.com/parts/componentSearch?searchTxt=RC0603FR-072KL | stock evidence captured; reconfirm before quote
main-board | camera | RC0603FR-0733RL | RC0603FR-0733RL | 4 | R_CAM_XCLK;R_SD_SCK;R_SD_MOSI;R_SD_CS_N | Resistor_SMD:R_0603_1608Metric | No bounded exact stock snapshot in retained sources |  |  |  |  | https://www.yageo.com/en/Chart/Download/pdf/RC0603 | source/quote required
main-board | camera | RC0603FR-0747KL | RC0603FR-0747KL | 19 | R_USB_LIMIT_FAULT_N;R_USB_RECOVERY_FAULT_N;R_CHG_STAT_N;R_USB_PG_N;R_MAIN_PG;R_BUTTON_PULL;R_DEFAULT_LED_R_N;R_DEFAULT_LED_G_N;R_DEFAULT_LED_B_N;R_CAM_OE;R_CAM_RESET;R_CAM_PWDN;R_CAM_MCU_PWDN;R_SD_PULL_CS_N;R_SD_PULL_MOSI;R_SD_PULL_MISO;R_SD_PULL_DAT1;R_SD_PULL_DAT2;R_SD_CD | Resistor_SMD:R_0603_1608Metric | No bounded exact stock snapshot in retained sources |  |  |  |  | https://www.yageo.com/en/Chart/Download/pdf/RC0603 | source/quote required
main-board | tactile | RC0603FR-0747RL | RC0603FR-0747RL | 1 | R_VEXC_ISO | Glove:R_0603_1608Metric | V3 JLC catalog snapshot: visible exact row/stock | 904938 | 0.0035 | JLC V3 catalog snapshot; point-in-time | C114623 | https://jlcpcb.com/parts/componentSearch?searchTxt=RC0603FR-0747RL | stock evidence captured; reconfirm before quote
main-board | tactile | RC0603FR-074K7L | RC0603FR-074K7L | 1 | R_VMID_IN | Glove:R_0603_1608Metric | V3 JLC catalog snapshot: visible exact row/stock | 9937461 | 0.0032 | JLC V3 catalog snapshot; point-in-time | C99782 | https://jlcpcb.com/parts/componentSearch?searchTxt=RC0603FR-074K7L | stock evidence captured; reconfirm before quote
main-board | power | RC0603FR-07680RL | RC0603FR-07680RL | 2 | R_LED_G;R_LED_B | Resistor_SMD:R_0603_1608Metric | No bounded exact stock snapshot in retained sources |  |  |  |  | https://www.yageo.com/en/Chart/Download/pdf/RC0603 | source/quote required
main-board | power | RC0805FR-0722RL | RC0805FR-0722RL | 2 | R_VREF_BLEED_OUT;R_VREF_BLEED_IN | Resistor_SMD:R_0805_2012Metric | No bounded exact stock snapshot in retained sources |  |  |  |  | https://www.yageo.com/en/Chart/Download/pdf/RC0603 | source/quote required
main-board | tactile | REF3330AIDBZR | REF3330AIDBZR | 1 | U_REF | Glove:SOT-23 | V3 JLC catalog snapshot: visible exact row/stock | 1845 | 1.6384 | JLC V3 catalog snapshot; point-in-time | C140329 | https://www.ti.com/lit/ds/symlink/ref33.pdf | stock evidence captured; reconfirm before quote
main-board | power | RT0603BRD07100KL | RT0603BRD07100KL | 7 | R_NTC_COLD_BOT;R_NTC_HOT_BOT;R_MAIN_BOT;R_MAIN_EN_BOT;R_READY_BOTTOM;R_BAT_ADC_TOP;R_BAT_ADC_BOTTOM | Resistor_SMD:R_0603_1608Metric | No bounded exact stock snapshot in retained sources |  |  |  |  | https://www.yageo.com/en/Chart/Download/pdf/RC0603 | source/quote required
main-board | power | RT0603BRD07107KL | RT0603BRD07107KL | 1 | R_NTC_HOT_TOP | Resistor_SMD:R_0603_1608Metric | No bounded exact stock snapshot in retained sources |  |  |  |  | https://www.yageo.com/en/Chart/Download/pdf/RC0603 | source/quote required
main-board | power | RT0603BRD07158KL | RT0603BRD07158KL | 1 | R_READY_TOP | Resistor_SMD:R_0603_1608Metric | No bounded exact stock snapshot in retained sources |  |  |  |  | https://www.yageo.com/en/Chart/Download/pdf/RC0603 | source/quote required
main-board | power | RT0603BRD0719K2L | RT0603BRD0719K2L | 1 | R_USB_RECOVERY_ILIM | Resistor_SMD:R_0603_1608Metric | No bounded exact stock snapshot in retained sources |  |  |  |  | https://www.yageo.com/en/Chart/Download/pdf/RC0603 | source/quote required
main-board | power | RT0603BRD072M15L | RT0603BRD072M15L | 1 | R_READY_HYST | Resistor_SMD:R_0603_1608Metric | No bounded exact stock snapshot in retained sources |  |  |  |  | https://www.yageo.com/en/Chart/Download/pdf/RC0603 | source/quote required
main-board | power | RT0603BRD07300KL | RT0603BRD07300KL | 1 | R_MAIN_EN_TOP | Resistor_SMD:R_0603_1608Metric | No bounded exact stock snapshot in retained sources |  |  |  |  | https://www.yageo.com/en/Chart/Download/pdf/RC0603 | source/quote required
main-board | power | RT0603BRD0730K9L | RT0603BRD0730K9L | 2 | R_USB_CC_ILIM;R_TS_BOTTOM | Resistor_SMD:R_0603_1608Metric | No bounded exact stock snapshot in retained sources |  |  |  |  | https://www.yageo.com/en/Chart/Download/pdf/RC0603 | source/quote required
main-board | power | RT0603BRD07327KL | RT0603BRD07327KL | 1 | R_MAIN_TOP | Resistor_SMD:R_0603_1608Metric | No bounded exact stock snapshot in retained sources |  |  |  |  | https://www.yageo.com/en/Chart/Download/pdf/RC0603 | source/quote required
main-board | power | RT0603BRD07390RL | RT0603BRD07390RL | 1 | R_CHG_ILIM | Resistor_SMD:R_0603_1608Metric | No bounded exact stock snapshot in retained sources |  |  |  |  | https://www.yageo.com/en/Chart/Download/pdf/RC0603 | source/quote required
main-board | power | RT0603BRD0752K3L | RT0603BRD0752K3L | 1 | R_NTC_COLD_TOP | Resistor_SMD:R_0603_1608Metric | No bounded exact stock snapshot in retained sources |  |  |  |  | https://www.yageo.com/en/Chart/Download/pdf/RC0603 | source/quote required
main-board | power | RT0603BRD07562RL | RT0603BRD07562RL | 1 | R_CHG_ICHG | Resistor_SMD:R_0603_1608Metric | No bounded exact stock snapshot in retained sources |  |  |  |  | https://www.yageo.com/en/Chart/Download/pdf/RC0603 | source/quote required
main-board | power | RT0603BRD075K23L | RT0603BRD075K23L | 1 | R_TS_TOP | Resistor_SMD:R_0603_1608Metric | No bounded exact stock snapshot in retained sources |  |  |  |  | https://www.yageo.com/en/Chart/Download/pdf/RC0603 | source/quote required
main-board | power | RT0603BRD0771K5L | RT0603BRD0771K5L | 1 | R_USB_HIGH_ILIM | Resistor_SMD:R_0603_1608Metric | No bounded exact stock snapshot in retained sources |  |  |  |  | https://www.yageo.com/en/Chart/Download/pdf/RC0603 | source/quote required
main-board | power | RT0603BRD07887KL | RT0603BRD07887KL | 1 | R_CC_VBUS | Resistor_SMD:R_0603_1608Metric | No bounded exact stock snapshot in retained sources |  |  |  |  | https://www.yageo.com/en/Chart/Download/pdf/RC0603 | source/quote required
main-board | tactile | RV0805FR-0722ML | RV0805FR-0722ML | 20 | RFB_I1;RFB_I2;RFB_I3;RFB_M1;RFB_M2;RFB_M3;RFB_R1;RFB_R2;RFB_R3;RFB_L1;RFB_L2;RFB_L3;RFB_T1;RFB_T2;RFB_P1;RFB_P2;RFB_P3;RFB_P4;RFB_H1;RFB_H2 | Glove:R_0805_2012Metric | V3 JLC catalog snapshot: zero or unreported stock | 0 | 0.0112 | JLC V3 catalog snapshot; point-in-time | C6669010 | https://jlcpcb.com/parts/componentSearch?searchTxt=RV0805FR-0722ML | stock gap; exact MPN retained
main-board | imu | SM04B-SRSS-TB(LF)(SN) | SM04B-SRSS-TB(LF)(SN) | 1 | J_IMU_CUFF | GloveV4:JST_SH_SM04B-SRSS-TB_1x04-1MP_P1.00mm_Horizontal | V3 JLC catalog snapshot: visible exact row/stock | 51165 | 0.2146 | JLC V3 catalog snapshot; point-in-time | C160404 | https://www.jst-mfg.com/product/pdf/eng/eSH.pdf | stock evidence captured; reconfirm before quote
main-board | tactile | SN74AHC595PWR | SN74AHC595PWR | 1 | U_MUX_ADDR | Glove:TSSOP-16_4.4x5mm_P0.65mm | V3 JLC catalog snapshot: visible exact row/stock | 978 | 0.3629 | JLC V3 catalog snapshot; point-in-time | C271269 | https://www.ti.com/lit/ds/symlink/sn74ahc595.pdf | stock evidence captured; reconfirm before quote
main-board | camera | SN74AXC8T245PWR | SN74AXC8T245PWR | 2 | U_CAM_DATA;U_CAM_CTRL | Package_SO:TSSOP-24_4.4x7.8mm_P0.65mm | Comet.bg exact MPN absent in 2026-10-22 bounded search; search gap, not an out-of-stock claim. |  |  |  |  | https://www.ti.com/lit/ds/symlink/sn74axc8t245.pdf | source/quote required
main-board | power | SN74LVC1G00DBVR | SN74LVC1G00DBVR | 1 | U_CC_ATTACH | Package_TO_SOT_SMD:SOT-23-5 | No bounded exact stock snapshot in retained sources |  |  |  |  | https://www.ti.com/lit/ds/symlink/sn74lvc1g00.pdf | source/quote required
main-board | power | SN74LVC1G04DBVR | SN74LVC1G04DBVR | 3 | U_CC_HIGH;U_USB_NOSUSP;U_ANALOG_OFF | Package_TO_SOT_SMD:SOT-23-5 | No bounded exact stock snapshot in retained sources |  |  |  |  | https://www.ti.com/lit/ds/symlink/sn74lvc1g04.pdf | source/quote required
main-board | power | SN74LVC1G08DBVR | SN74LVC1G08DBVR | 4 | U_CFG_CLEAR;U_CFG_RESET;U_USB_ON;U_BOOT_PG | Package_TO_SOT_SMD:SOT-23-5 | No bounded exact stock snapshot in retained sources |  |  |  |  | https://www.ti.com/lit/ds/symlink/sn74lvc1g08.pdf | source/quote required
main-board | power | SN74LVC1G17DBVR | SN74LVC1G17DBVR | 1 | U_BOOT_SCHMITT | Package_TO_SOT_SMD:SOT-23-5 | No bounded exact stock snapshot in retained sources |  |  |  |  | https://www.ti.com/lit/ds/symlink/sn74lvc1g17.pdf | source/quote required
main-board | power | SN74LVC1G32DBVR | SN74LVC1G32DBVR | 2 | U_USB_ALLOW;U_BOOT_SOURCE | Package_TO_SOT_SMD:SOT-23-5 | No bounded exact stock snapshot in retained sources |  |  |  |  | https://www.ti.com/lit/ds/symlink/sn74lvc1g32.pdf | source/quote required
main-board | power | SN74LVC1G74DCUR | SN74LVC1G74DCUR | 1 | U_USB_CFG | Package_SO:VSSOP-8_2.3x2mm_P0.5mm | No bounded exact stock snapshot in retained sources |  |  |  |  | https://www.ti.com/lit/ds/symlink/sn74lvc1g74.pdf | source/quote required
main-board | tactile | TAJA685K010RNJ | TAJA685K010RNJ | 1 | C_ADC_REF | Glove:CP_EIA-3216-18_Kemet-A | V3 JLC catalog snapshot: visible exact row/stock | 1359 | 0.2059 | JLC V3 catalog snapshot; point-in-time | C5348203 | https://datasheets.kyocera-avx.com/TAJ.pdf | stock evidence captured; reconfirm before quote
main-board | power | TCA9535PWR | TCA9535PWR | 2 | U_IO0;U_IO1 | Package_SO:TSSOP-24_4.4x7.8mm_P0.65mm | No bounded exact stock snapshot in retained sources |  |  |  |  | https://www.ti.com/lit/ds/symlink/tca9535.pdf | source/quote required
main-board | power | TLV3012BIDBVR | TLV3012BIDBVR | 1 | U_BAT_READY | Package_TO_SOT_SMD:SOT-23-6 | No bounded exact stock snapshot in retained sources |  |  |  |  | https://www.ti.com/lit/ds/symlink/tlv3012.pdf | source/quote required
main-board | tactile | TLV75518PDBVR | TLV75518PDBVR | 1 | U_LDO | Glove:SOT-23-5 | V3 JLC catalog snapshot: visible exact row/stock | 8825 | 0.2053 | JLC V3 catalog snapshot; point-in-time | C2877863 | https://jlcpcb.com/parts/componentSearch?searchTxt=TLV75518PDBVR | stock evidence captured; reconfirm before quote
main-board | power | TMK107BBJ106MA-T | TMK107BBJ106MA-T | 2 | C_MAIN_LOCAL_IN;C_MAIN_LOCAL_OUT | Capacitor_SMD:C_0603_1608Metric | No bounded exact stock snapshot in retained sources |  |  |  |  | https://www.murata.com/en-us/products/capacitor/mlcc | source/quote required
main-board | sd | TPS22919DCKR | TPS22919DCKR | 1 | U_SD_POWER | Package_TO_SOT_SMD:SOT-363_SC-70-6 | No bounded exact stock snapshot in retained sources |  |  |  |  | https://www.ti.com/lit/ds/symlink/tps22919.pdf | source/quote required
main-board | power | TPS22950YBHR | TPS22950YBHR | 1 | U_USB_RECOVERY | GlovePower:TI_YBH0006_C02 | No bounded exact stock snapshot in retained sources |  |  |  |  | https://www.ti.com/lit/ds/symlink/tps22950.pdf | source/quote required
main-board | power | TPS2553DBVR | TPS2553DBVR | 1 | U_USB_HIGH | Package_TO_SOT_SMD:SOT-23-6 | No bounded exact stock snapshot in retained sources |  |  |  |  | https://www.ti.com/lit/ds/symlink/tps2553.pdf | source/quote required
main-board | power | TPS63070RNMR | TPS63070RNMR | 1 | U_MAIN | GlovePower:TI_RNM0015A | Comet.bg exact MPN absent in 2026-10-22 bounded search; search gap, not an out-of-stock claim. |  |  |  |  | https://www.ti.com/lit/ds/symlink/tps63070.pdf | source/quote required
main-board | camera | TPS7A2015PDBVR | TPS7A2015PDBVR | 1 | U_CAM_DV | Package_TO_SOT_SMD:SOT-23-5 | No bounded exact stock snapshot in retained sources |  |  |  |  | https://www.ti.com/lit/ds/symlink/tps7a20.pdf | source/quote required
main-board | camera | TPS7A2018PDBVR | TPS7A2018PDBVR | 1 | U_CAM_IO | Package_TO_SOT_SMD:SOT-23-5 | No bounded exact stock snapshot in retained sources |  |  |  |  | https://www.ti.com/lit/ds/symlink/tps7a20.pdf | source/quote required
main-board | camera | TPS7A2028PDBVR | TPS7A2028PDBVR | 1 | U_CAM_AV | Package_TO_SOT_SMD:SOT-23-5 | No bounded exact stock snapshot in retained sources |  |  |  |  | https://www.ti.com/lit/ds/symlink/tps7a20.pdf | source/quote required
main-board | power | TPS7A2033PDBVR | TPS7A2033PDBVR | 1 | U_ANALOG_LDO | Package_TO_SOT_SMD:SOT-23-5 | Comet.bg exact MPN absent in 2026-10-22 bounded search; search gap, not an out-of-stock claim. |  |  |  |  | https://www.ti.com/lit/ds/symlink/tps7a20.pdf | source/quote required
main-board | power | TUSB320LAIRWBR | TUSB320LAIRWBR | 1 | U_CC | Package_DFN_QFN:Texas_X2QFN-12_1.6x1.6mm_P0.4mm | No bounded exact stock snapshot in retained sources |  |  |  |  | https://www.ti.com/lit/ds/symlink/tusb320lai.pdf | source/quote required
main-board | power | TYPE-C-31-M-12 | TYPE-C-31-M-12 | 1 | J_USB | Connector_USB:USB_C_Receptacle_HRO_TYPE-C-31-M-12 | No bounded exact stock snapshot in retained sources |  |  |  |  | https://www.hrocn.com/ProductDetail.aspx?id=199 | source/quote required
main-board | power | XFL4020-152MEC | XFL4020-152MEC | 2 | L_CHARGER;L_MAIN | GlovePower:Coilcraft_XFL4020 | No bounded exact stock snapshot in retained sources |  |  |  |  | https://www.coilcraft.com/en-us/products/power/shielded-inductors/molded-inductor/xfl/xfl4020/ | source/quote required
external-kit | sensor | PVDF pre-metallized blanks | TE Connectivity / Measurement Specialties 1-1004347-0 | 1 |  |  | V3 complete-kit price observed 2026-10-22; stock then, current stock unverified |  |  | EUR 184.19/sheet |  | hardware/glove-v3/procurement/complete-kit.csv | evidence captured; price/stock gap remains
external-kit | sensor | Pressure substrate | Adafruit 1361 Velostat or Linqstat equivalent | 1 |  |  | V3 complete-kit; exact current stock and landed price unresolved |  |  |  |  | hardware/glove-v3/procurement/complete-kit.csv | evidence captured; price/stock gap remains
external-kit | sensor | Conductive fabric pressure electrodes | UNRESOLVED | 40 |  |  | V3 complete-kit; exact fabric MPN and price unresolved |  |  |  |  | hardware/glove-v3/procurement/complete-kit.csv | evidence captured; price/stock gap remains
external-kit | sensor | PVDF lead wire | Alpha Wire 5851 30 AWG | 80 |  |  | V3 complete-kit; stock and price unverified |  |  |  |  | hardware/glove-v3/procurement/complete-kit.csv | evidence captured; price/stock gap remains
external-kit | sensor | Separator/cover tape | 25 um TPU or polyester tape | 1 |  |  | V3 complete-kit; cut-to-fit lot, exact MPN unresolved |  |  |  |  | hardware/glove-v3/procurement/complete-kit.csv | evidence captured; price/stock gap remains
external-kit | sensor | Conductive epoxy | MG Chemicals 8331D-14G | 1 |  |  | V3 complete-kit; product identified, distributor stock unverified |  |  |  |  | hardware/glove-v3/procurement/complete-kit.csv | evidence captured; price/stock gap remains
external-kit | harness | GH mating housing 6-way | GHR-06V-S | 1 |  |  | Harness source record; exact supplier stock/price unverified |  |  |  |  | hardware/glove-v3/procurement/complete-kit.csv | evidence captured; price/stock gap remains
external-kit | harness | GH mating housing 8-way | GHR-08V-S | 4 |  |  | Harness source record; exact supplier stock/price unverified |  |  |  |  | hardware/glove-v3/procurement/complete-kit.csv | evidence captured; price/stock gap remains
external-kit | harness | GH mating housing 14-way | GHR-14V-S | 1 |  |  | Harness source record; exact supplier stock/price unverified |  |  |  |  | hardware/glove-v3/procurement/complete-kit.csv | evidence captured; price/stock gap remains
external-kit | harness | GH crimp contacts | SSHL-002T-P0.2 | 52 |  |  | Harness source record; exact supplier stock/price unverified |  |  |  |  | hardware/glove-v3/procurement/complete-kit.csv | evidence captured; price/stock gap remains
external-kit | harness | Remote hand IMU SH cable | Adafruit 4210 | 1 |  |  | V4 interface record: 100 mm JST SH 4-pin; current stock/price unverified |  |  |  |  | hardware/glove-v4/interfaces/imu-interface.json | evidence captured; price/stock gap remains
external-kit | hand-tile | Remote dorsal-hand IMU tile | ISM330DHCXTR | 1 |  |  | Comet.bg exact MPN absent in 2026-10-22 bounded search; search gap, not an out-of-stock claim. |  |  |  |  | hardware/glove-v4/interfaces/imu-interface.json | evidence captured; price/stock gap remains
external-kit | camera | OV5640 camera module | 73.002.000035 | 1 |  |  | CamThink official variation506:120-8cm; in_stock=true; purchasable=true; available quantity unpublished; see camera-sourcing.json | in stock; quantity unpublished | 15.00 | USD per module; manufacturer guest cart2026-10-22; shipping separate | 73.002.000035 / variation506 | https://www.camthink.ai/store/ov5640/?attribute_pa_lens=120-8cm | SKU/price/availability verified; Sofia cart estimate captured; tax terms and supplied tail drawing remain
external-kit | camera | Camera FPC connector | FH12-24S-0.5SH(55) | 1 |  |  | Exact MPN in canonical BOM; stock/price not in retained snapshot |  |  |  |  | hardware/glove-v4/electrical/components.json | evidence captured; price/stock gap remains
external-kit | sd | microSD socket | DM3AT-SF-PEJM5 | 1 |  |  | Mouser snapshot 77,313 stock; DigiKey 82,027 stock in SD note; reconfirm delivery |  | $3.55 | $3.55 at Mouser qty1 |  | hardware/glove-v4/procurement/sd-sourcing.md | captured route; delivery/quote reconfirmation required
external-kit | sd | Industrial microSD card | SDCIT2/32GB | 1 |  |  | Kingston primary datasheet; current/average current and distributor price not published in retained note |  |  |  |  | hardware/glove-v4/procurement/sd-sourcing.md | evidence captured; price/stock gap remains
external-kit | power | Protected battery pack | Jauch LI18650JLS HB 1S2P+PCM+FUSE+2 WIRES 70MM / 250480 | 1 |  |  | No exact Comet Jauch 250480 result in 2026-10-23 bounded search; search gap, not an out-of-stock claim. Retained Farnell UK 48 / £40.81 and Farnell BG €46.94 evidence remain separate; Bulgaria live stock/delivery unconfirmed. |  | £40.81 ex VAT | £40.81 ex VAT, Farnell UK; BG row €46.94 with stock/delivery unconfirmed |  | hardware/glove-v4/procurement/battery-candidate-jauch250480.json | captured route; delivery/quote reconfirmation required
external-kit | power | External battery sensor | Semitec 103AT-2 | 1 |  |  | Factory-applied insulated wrap pocket; exact pack-side purchase route unresolved |  |  |  |  | hardware/glove-v4/system-contract.json | evidence captured; price/stock gap remains
external-kit | mechanical | Lid M2 x 8 mm low-head screws | ISO 14580 M2 x 8 | 4 |  |  | Current dimensioned lid hardware; supplier SKU/quote required |  |  |  |  | hardware/glove-v4/enclosure/print-manifest.json | evidence captured; price/stock gap remains
external-kit | mechanical | M2 hex nuts | ISO 4032 M2 | 6 |  |  | Four lid and two camera ISO4032 M2 nuts; supplier SKU/quote required |  |  |  |  | hardware/glove-v4/enclosure/print-manifest.json | evidence captured; price/stock gap remains
external-kit | mechanical | Enclosure mixed-process manufactured set | V4 enclosure generated STL set | 1 |  |  | 42 manufactured solids plus six inspection references; rigid printing/finishing, small cast elastomers and cut materials require process quotes |  |  |  |  | hardware/glove-v4/enclosure/print-manifest.json | geometry audited; first_article_fabrication_ready false; supplier process quotes required
external-kit | assembly | Factory electronics assembly/programming | UNRESOLVED | 1 |  |  | Quote required after routed-board manufacturing release |  |  |  |  | hardware/glove-v3/procurement/complete-kit.csv | evidence captured; price/stock gap remains
external-kit | assembly | Glove laminate/lead preparation | UNRESOLVED | 1 |  |  | Supplier scope required; sensor stack and keyed leads need quote |  |  |  |  | hardware/glove-v3/procurement/complete-kit.csv | evidence captured; price/stock gap remains
external-kit | logistics | Shipping/VAT to Bulgaria | UNRESOLVED | 1 |  |  | Destination landed cost not established |  |  |  |  | hardware/glove-v3/procurement/complete-kit.csv | evidence captured; price/stock gap remains
external-kit | power | Battery pack connector housing | 43025-0200 | 1 |  |  | Comet.bg exact page: Sofia 0, Plovdiv 0; price Ask (checked 2026-10-23). Retained DigiKey snapshot 145,783 is foreign distributor evidence, not Sofia stock. | Sofia 0; Plovdiv 0 (2026-10-23) |  | Comet.bg exact page, price Ask |  | https://www.molex.com/content/dam/molex/molex-dot-com/products/automated/en-us/salesdrawingpdf/430/43025/430250200_sd.pdf | current V4 direct-AWG22 path; factory crimp assembly
external-kit | power | Battery pack crimp contacts | 43030-0007 | 2 |  |  | Comet.bg exact page: local 0; distributor 966400, 7–10 days on request; EUR0.143 qty100 excl VAT, MOQ100 (checked 2026-10-23). Retained DigiKey snapshot 667,524 is foreign distributor evidence. | Comet local 0; distributor 966400 (2026-10-23) | 0.143 EUR | Comet.bg exact page, MOQ100, excl VAT |  | https://www.molex.com/content/dam/molex/molex-dot-com/products/automated/en-us/salesdrawingpdf/430/43030/430300010_sd.pdf | current V4 direct-AWG22 path; factory crimp assembly
main-board | power | Positive battery-entry fuse | 045102.5MRL | 1 | F1 | Fuse:Fuse_Littelfuse-NANO2-451_453 | Comet exact result absent 2026-10-23; retained Mouser snapshot 5,227 (2026-10-22) is foreign distributor evidence, not Sofia stock. Exact part remains canonical. | Mouser 5,227 (2026-10-22); Comet no exact result (2026-10-23) |  | Mouser snapshot; delivery/landed cost unverified |  | https://www.littelfuse.com/assetdocs/fuse-451-and-453-datasheet?assetguid=533cd5cc-956c-4243-867f-6ab5a62f6ba1 | selected part; quote/delivery route unresolved
external-kit | mechanical | Camera M2 x 6 mm low-head screws | ISO 14580 M2 x 6 | 2 |  |  | Dimensioned camera retainer hardware; supplier SKU/quote required |  |  |  |  | hardware/glove-v4/enclosure/print-manifest.json | selected specification; supplier stock/price/process quote required
external-kit | mechanical | Button catalog compression spring | SDP/SI S78CSYM030035008 | 1 |  |  | Manufacturer catalog physical p64: OD3/free8/solid2.8mm; nominal1.26N/mm; receiving force/rate limits in button-spring-specification.md; current stock/price unverified |  |  |  |  | https://www.sdp-si.com/D815/D815-Metric-Section10-Hardware.pdf | selected specification; supplier stock/price/process quote required
external-kit | mechanical | Camera window stock sheet | RS PRO 7698720 | 1 |  |  | Stock1mm clearPC305x625mm; oneØ22±0.2mm disk per cuff; sheet and cut quote required; manufacturer evidence cached |  |  |  |  | hardware/glove-v4/enclosure/sources/flat-window-source-evidence.json | selected specification; supplier stock/price/process quote required
external-kit | mechanical | Window adhesive ring stock | 3M VHB LSE-060WF | 1 |  |  | 0.6mm acrylic foam tape; die-cutOD22/ID17mm ring per cuff; stock/price and cutting quote unverified |  |  |  |  | hardware/glove-v4/enclosure/sources/flat-window-source-evidence.json | selected specification; supplier stock/price/process quote required
external-kit | mechanical | Window nylon-surface primer | 3M Primer 94 | 1 |  |  | Small process lot; two thin coats on prepared PA12; surface/coupon acceptance; current stock/price unverified |  |  |  |  | hardware/glove-v4/enclosure/window-fabrication.md | selected specification; supplier stock/price/process quote required
external-kit | harness | Factory battery extension AWG22 wire | Assembler-qualified stranded AWG22 copper; insulation OD<=1.85mm | 2 |  |  | Fallback variant only: two35mm pieces,70mm new conductor;5mm overlap per joint gives30mm effective gain per lead; exact wire MPN/process quote required |  |  |  |  | hardware/glove-v4/procurement/battery-harness.md | selected specification; supplier stock/price/process quote required
external-kit | harness | Factory battery splice insulating sleeves | TE Raychem ATUM-3/1-0-STK / NB10602001 | 2 |  |  | Primary TE ATUM family:3mm suppliedID,1mm maximum fully recoveredID, dualwall adhesive; cut16mm, accept finished14..16mm length andOD<=4mm over joint; exact stock/quote required |  |  |  |  | https://www.te.com/en/product-NB10602001.html | selected specification; supplier stock/price/process quote required
