latintzar/tactile-glove/hardware/glove-v4/enclosure/flat-tpu-textile-carrier.stl

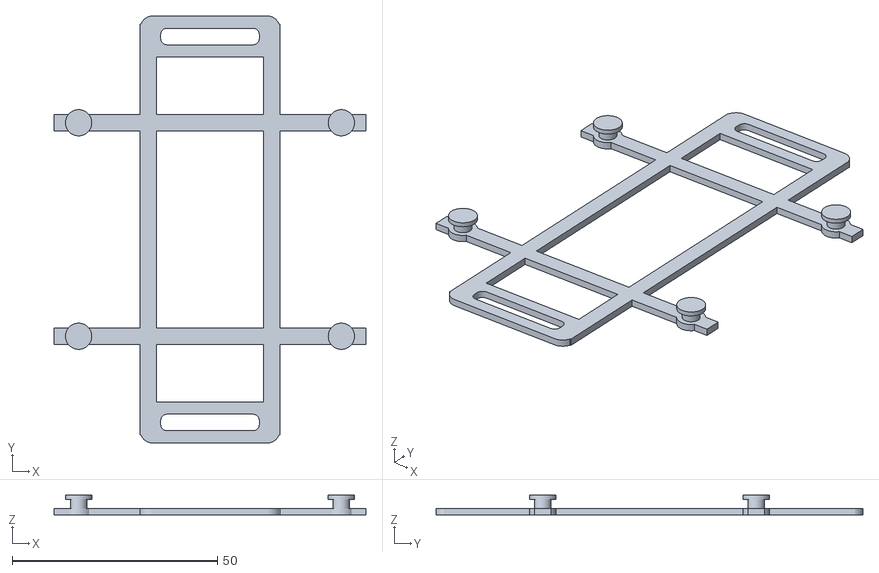
[picture p2: CAD file, 2026-11-02]
hardware/glove-v4/enclosure/flat-tpu-textile-carrier.stl
76.0 x 104.0 x 4.80
