latintzar/tactile-glove/hardware/glove-v4/enclosure/cable-grommet-4-blanking-plug.stl

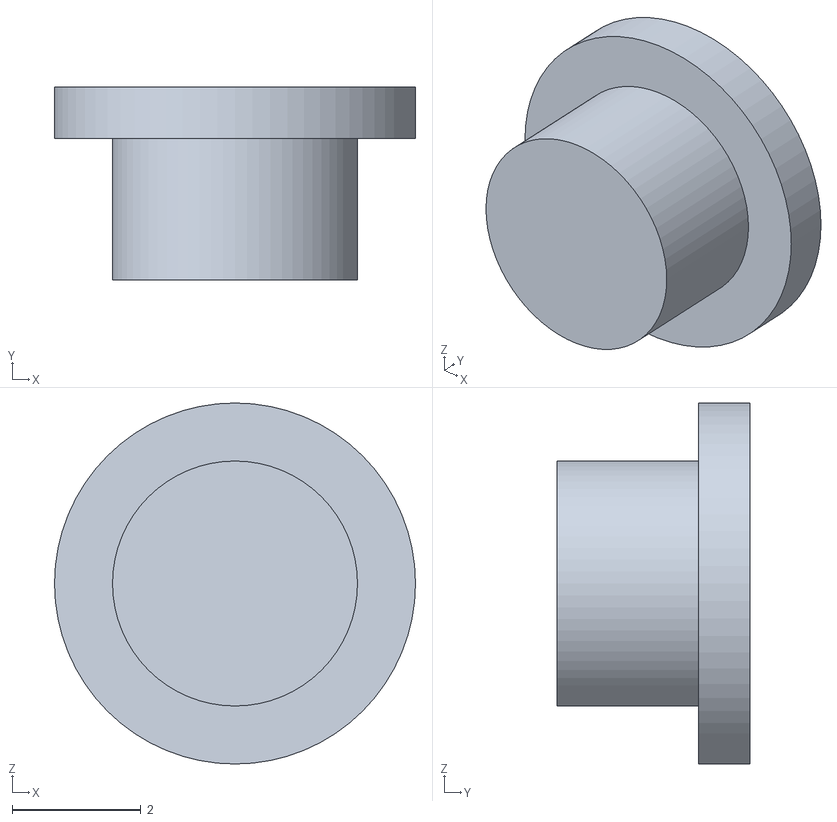
[picture p3: CAD file, 2026-11-02]
hardware/glove-v4/enclosure/cable-grommet-4-blanking-plug.stl
5.60 x 3.00 x 5.60
