latintzar/tactile-glove/hardware/glove-v4/enclosure/battery-foam-pad-2.stl

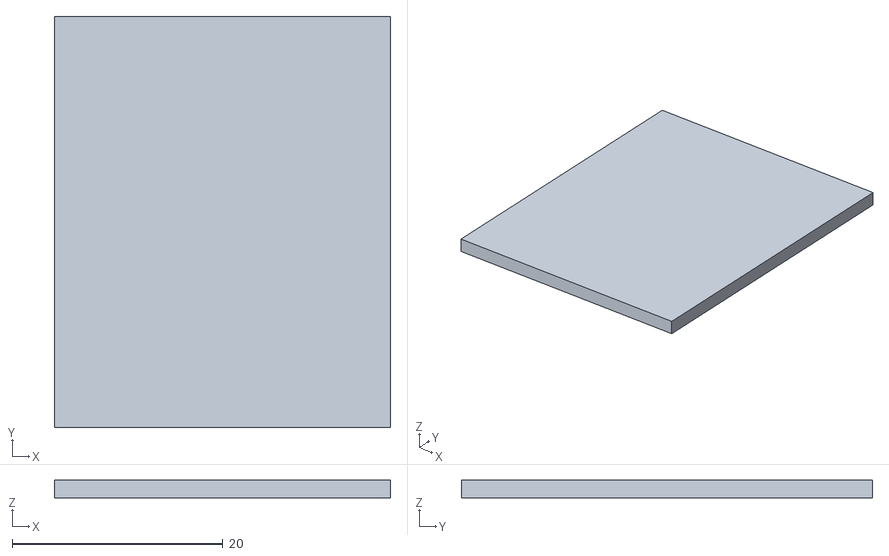
[picture p4: CAD file, 2026-11-02]
hardware/glove-v4/enclosure/battery-foam-pad-2.stl
31.9 x 39.0 x 1.70
