latintzar/tactile-glove/hardware/glove-v4/enclosure/camera-rear-retainer.stl

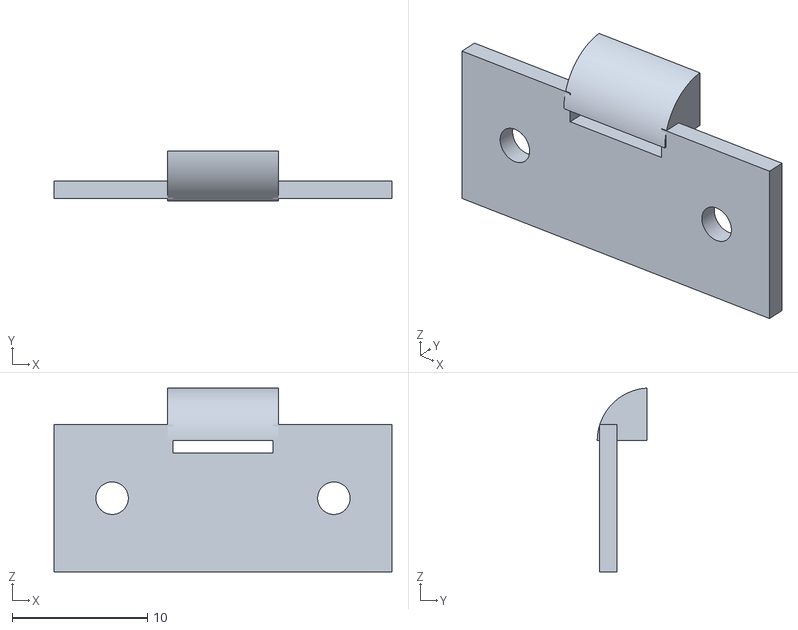
[picture p5: CAD file, 2026-11-02]
hardware/glove-v4/enclosure/camera-rear-retainer.stl
25.0 x 3.67 x 13.6
