latintzar/tactile-glove/hardware/glove-v4/enclosure/battery-retaining-belt.stl

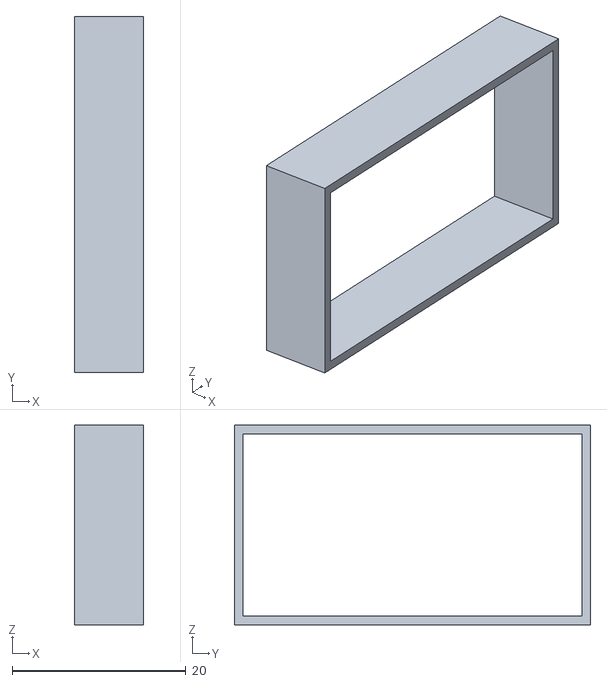
[picture p6: CAD file, 2026-11-02]
hardware/glove-v4/enclosure/battery-retaining-belt.stl
8.00 x 41.0 x 23.0
