latintzar/tactile-glove/hardware/glove-v4/enclosure/camera-front-shim-4.stl

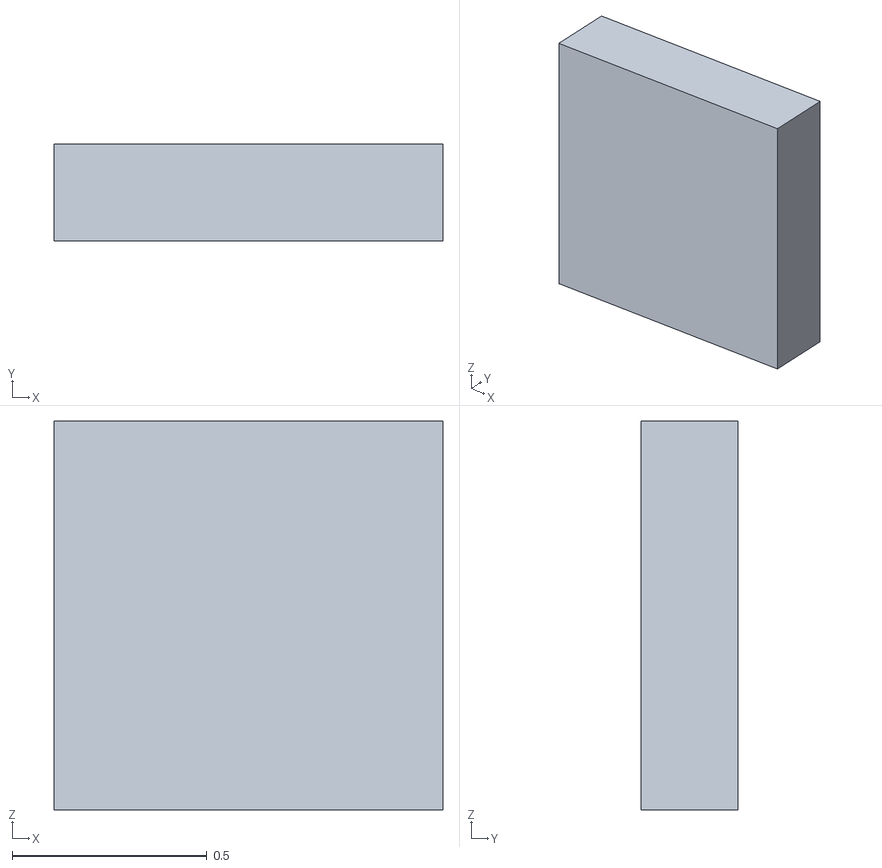
[picture p7: CAD file, 2026-11-02]
hardware/glove-v4/enclosure/camera-front-shim-4.stl
1.00 x 0.25 x 1.00
