latintzar/tactile-glove/hardware/glove-v4/enclosure/cable-grommet-3.stl

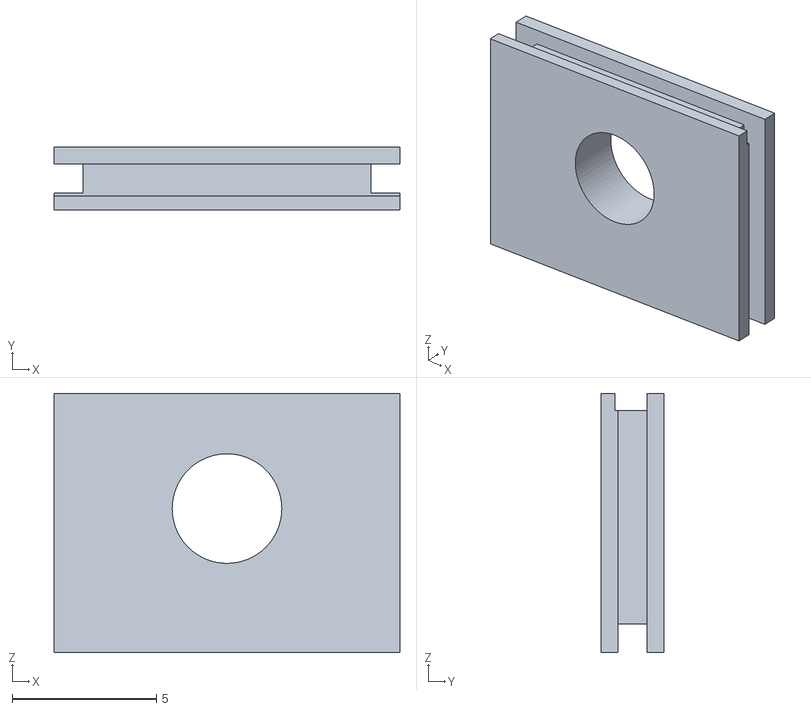
[picture p8: CAD file, 2026-11-02]
hardware/glove-v4/enclosure/cable-grommet-3.stl
12.0 x 2.20 x 9.00
