latintzar/tactile-glove/hardware/glove-v4/enclosure/hand-tile-tpu-pocket.stl

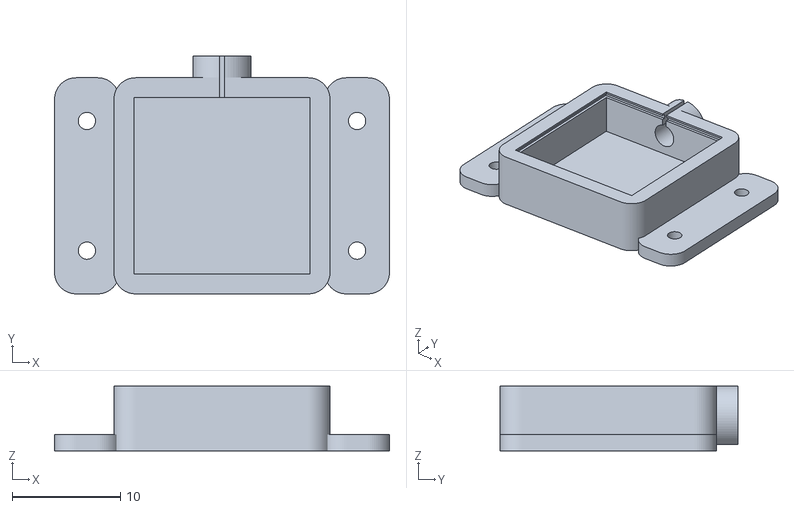
[picture p9: CAD file, 2026-11-02]
hardware/glove-v4/enclosure/hand-tile-tpu-pocket.stl
31.0 x 22.0 x 6.00
