latintzar/tactile-glove/hardware/glove-v4/enclosure/camera-window-clear-pc.stl

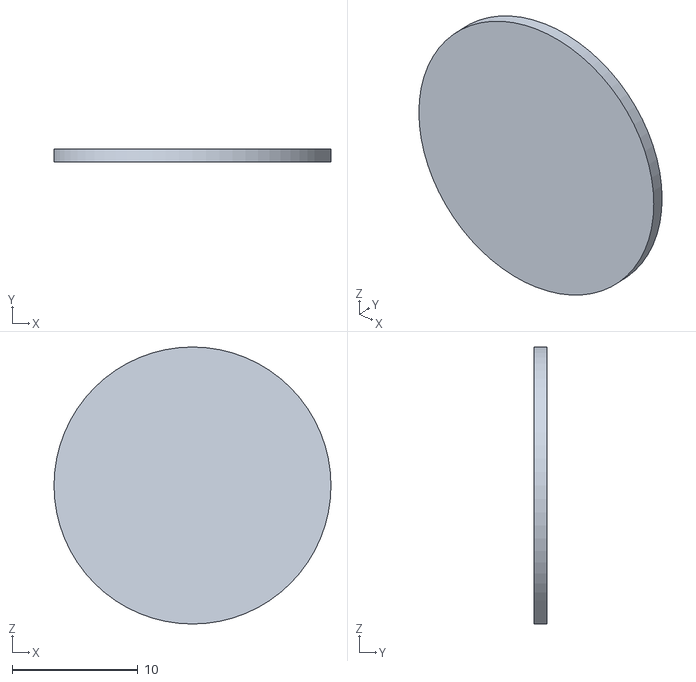
[picture p10: CAD file, 2026-11-02]
hardware/glove-v4/enclosure/camera-window-clear-pc.stl
22.0 x 1.00 x 22.0
