latintzar/tactile-glove/hardware/glove-v4/enclosure/button-silicone-diaphragm.stl

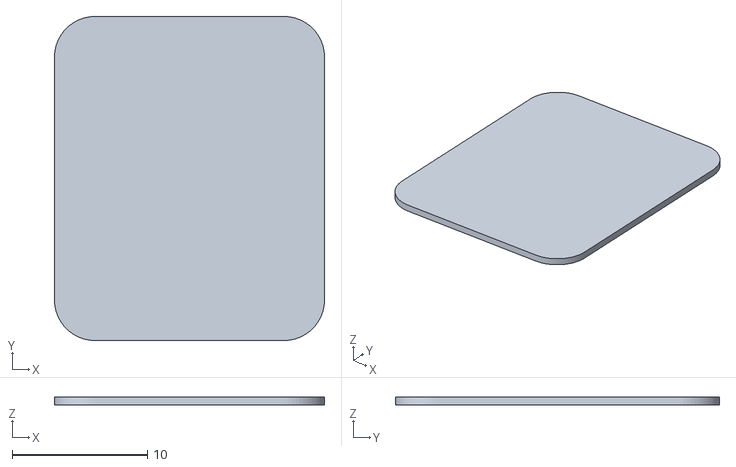
[picture p11: CAD file, 2026-11-02]
hardware/glove-v4/enclosure/button-silicone-diaphragm.stl
20.0 x 24.0 x 0.6
