latintzar/tactile-glove/hardware/glove-v4/enclosure/button-plunger-cap.stl

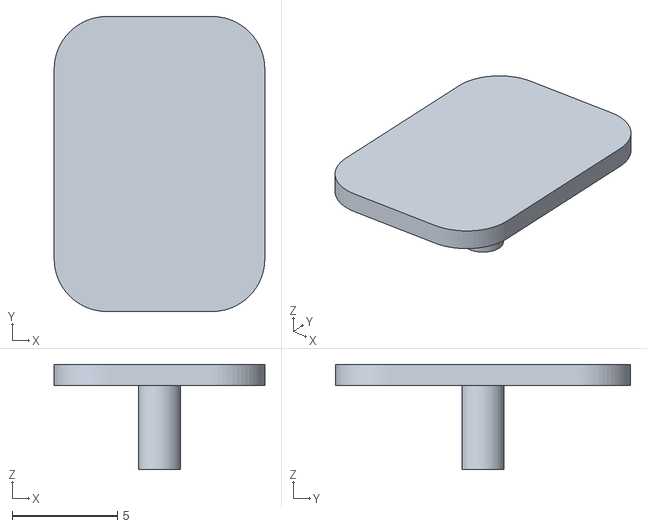
[picture p12: CAD file, 2026-11-02]
hardware/glove-v4/enclosure/button-plunger-cap.stl
10.0 x 14.0 x 5.00
