latintzar/tactile-glove/hardware/glove-v4/enclosure/pcb-envelope.stl

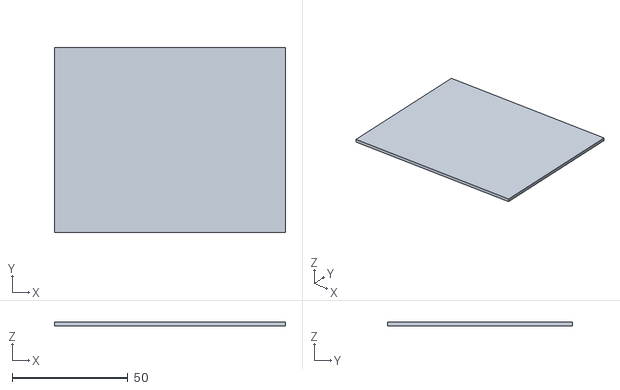
[picture p13: CAD file, 2026-11-02]
hardware/glove-v4/enclosure/pcb-envelope.stl
100.0 x 80.0 x 1.60
