latintzar/tactile-glove/hardware/glove-v4/enclosure/lid-perimeter-gasket.stl

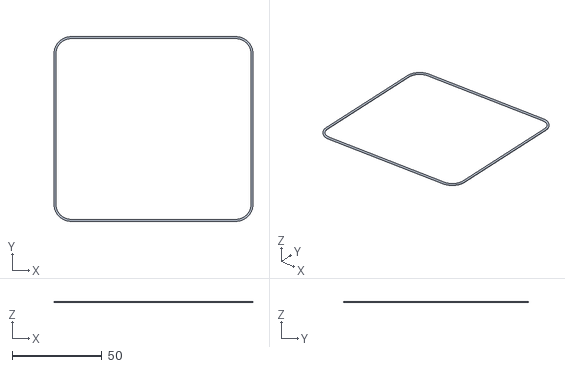
[picture p14: CAD file, 2026-11-02]
hardware/glove-v4/enclosure/lid-perimeter-gasket.stl
111.0 x 103.0 x 0.8
