latintzar/tactile-glove/hardware/glove-v4/enclosure/battery-envelope.stl

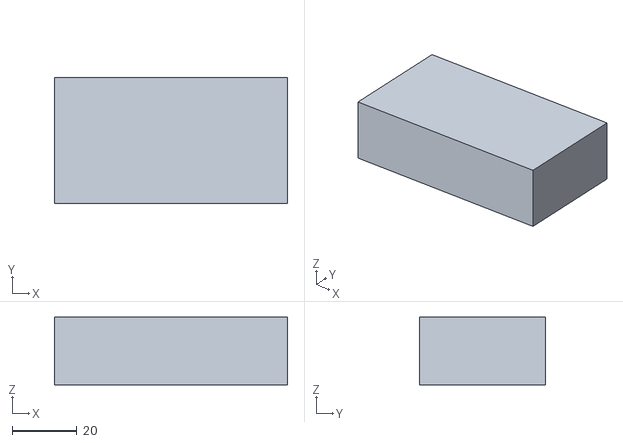
[picture p15: CAD file, 2026-11-02]
hardware/glove-v4/enclosure/battery-envelope.stl
72.0 x 39.0 x 21.0
