latintzar/tactile-glove/hardware/glove-v4/enclosure/rigid-base.stl

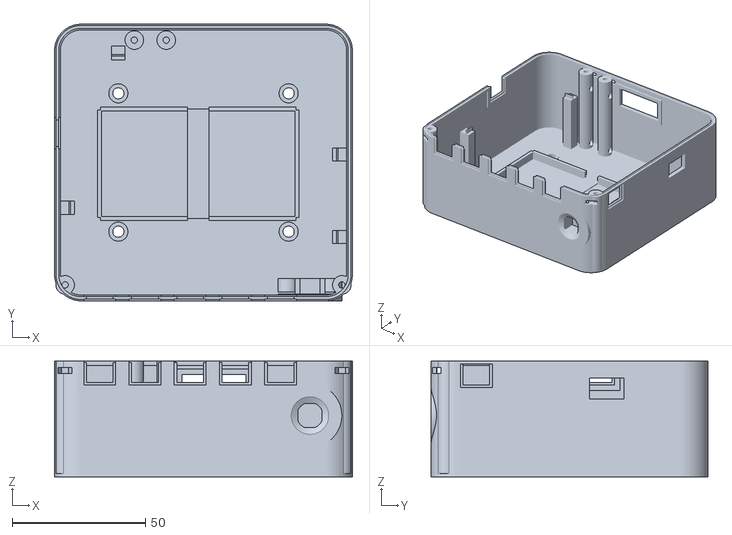
[picture p16: CAD file, 2026-11-02]
hardware/glove-v4/enclosure/rigid-base.stl
112.0 x 104.0 x 43.5
