latintzar/tactile-glove/hardware/glove-v4/enclosure/rigid-lid.stl

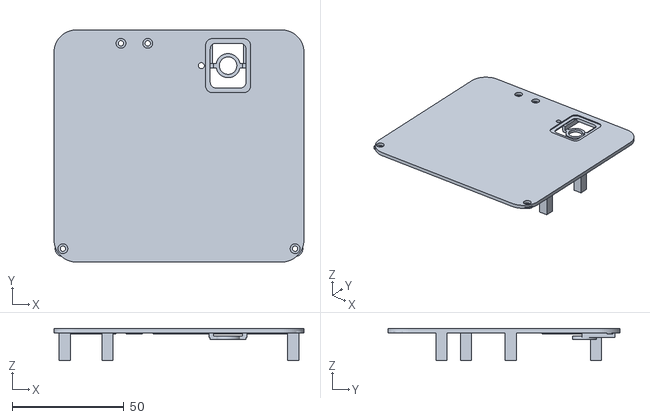
[picture p17: CAD file, 2026-11-02]
hardware/glove-v4/enclosure/rigid-lid.stl
112.0 x 104.0 x 14.4
