latintzar/tactile-glove/hardware/glove-v4/enclosure/cable-grommet-6.stl

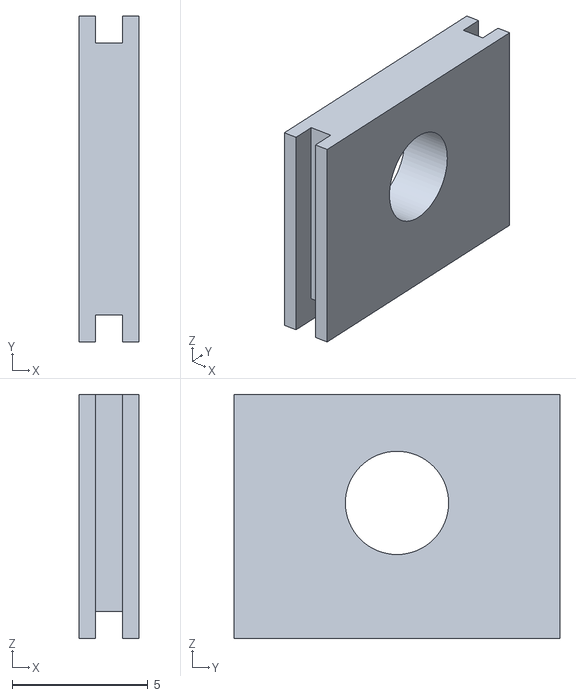
[picture p18: CAD file, 2026-11-02]
hardware/glove-v4/enclosure/cable-grommet-6.stl
2.20 x 12.0 x 9.00
