latintzar/tactile-glove/hardware/glove-v4/enclosure/sd-service-cap.stl

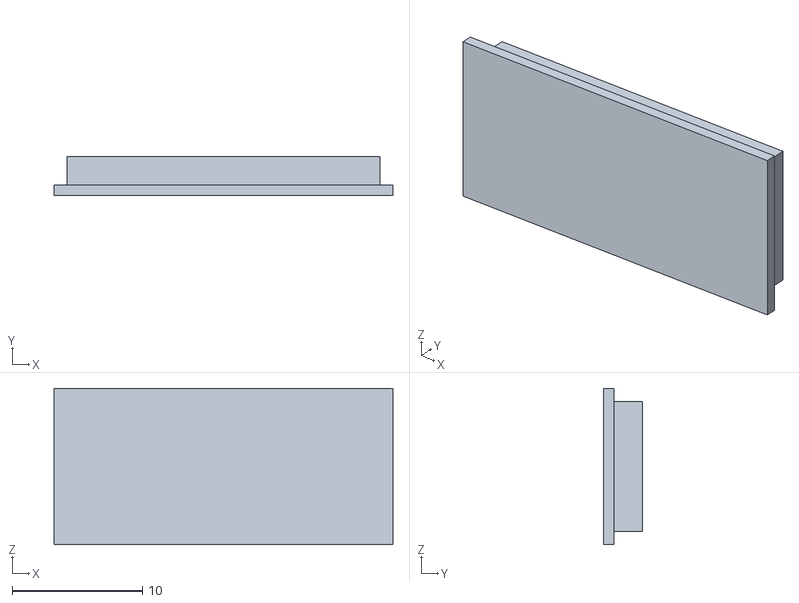
[picture p19: CAD file, 2026-11-02]
hardware/glove-v4/enclosure/sd-service-cap.stl
26.0 x 3.00 x 12.0
