latintzar/tactile-glove/hardware/glove-v4/enclosure/pcb-clamp-pad-3.stl

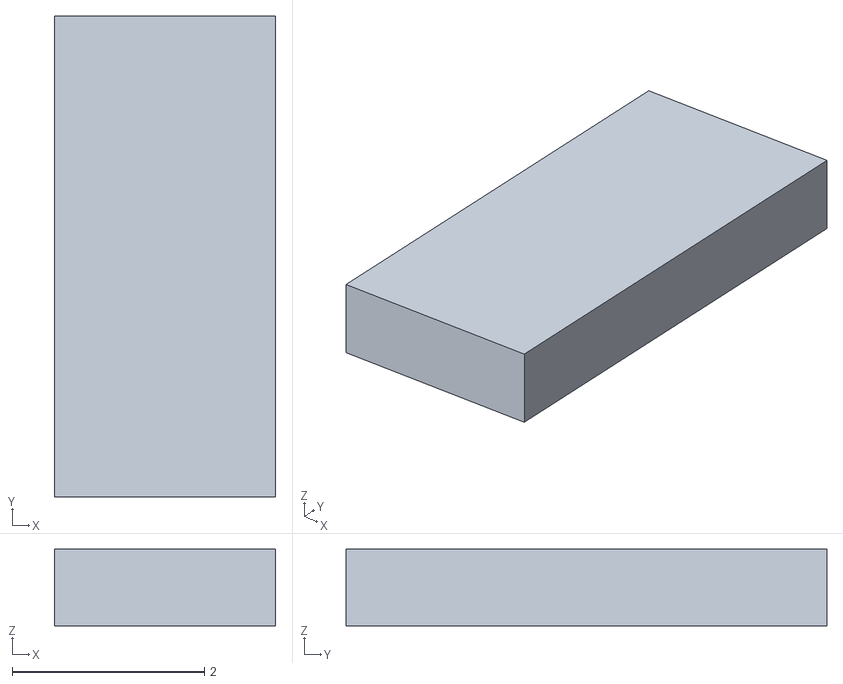
[picture p20: CAD file, 2026-11-02]
hardware/glove-v4/enclosure/pcb-clamp-pad-3.stl
2.30 x 5.00 x 0.8
