latintzar/tactile-glove/hardware/glove-v4/enclosure/camera-flex-envelope.stl

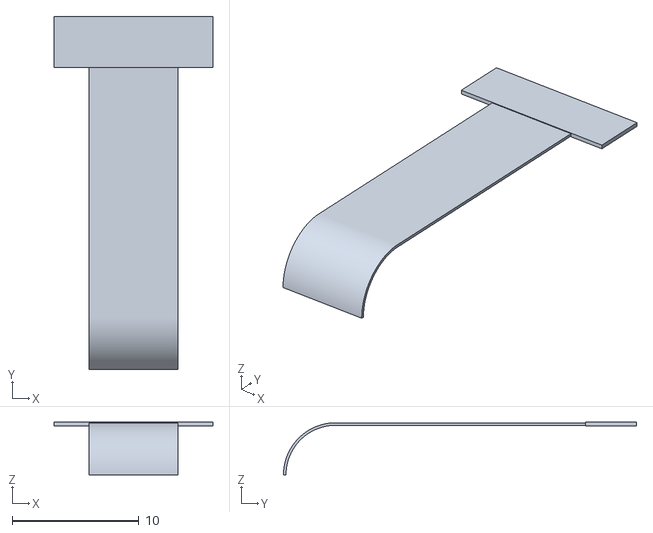
[picture p21: CAD file, 2026-11-02]
hardware/glove-v4/enclosure/camera-flex-envelope.stl
12.5 x 27.8 x 4.15
