latintzar/tactile-glove/hardware/glove-v4/enclosure/hand-tile-pcb-envelope.stl

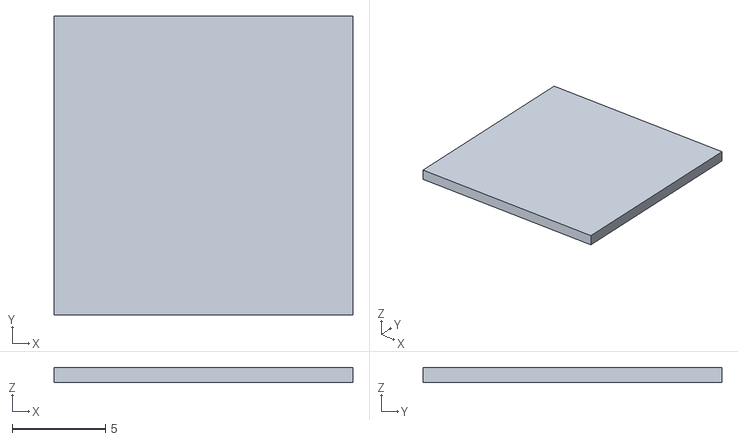
[picture p22: CAD file, 2026-11-02]
hardware/glove-v4/enclosure/hand-tile-pcb-envelope.stl
16.0 x 16.0 x 0.8
