latintzar/tactile-glove/hardware/glove-v4/enclosure/button-plunger.stl

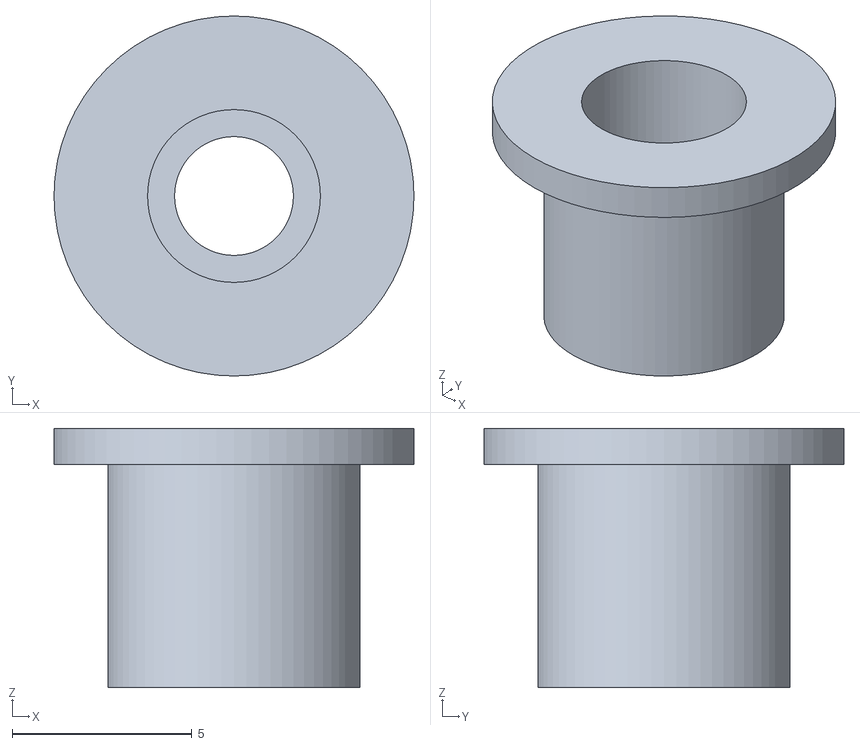
[picture p23: CAD file, 2026-11-02]
hardware/glove-v4/enclosure/button-plunger.stl
10.0 x 10.0 x 7.20
