latintzar/tactile-glove/hardware/glove-v4/enclosure/rgb-lightpipe.stl

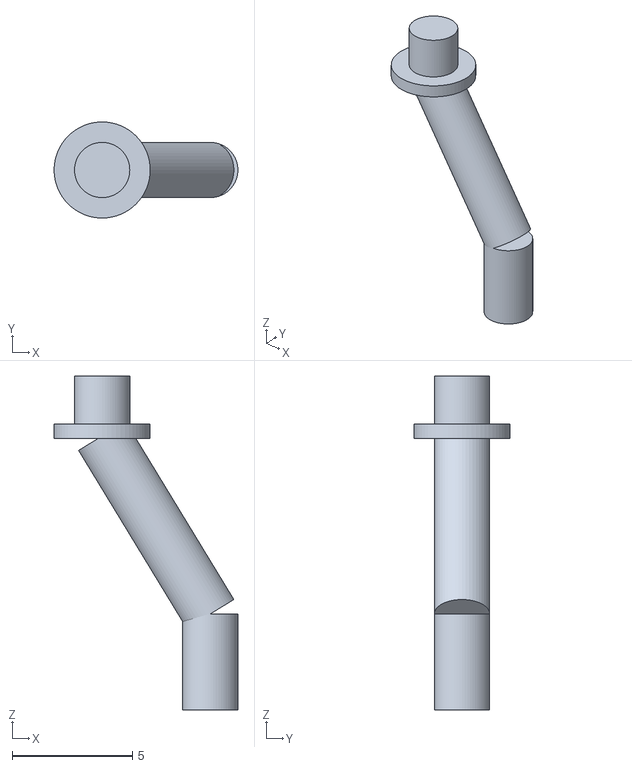
[picture p24: CAD file, 2026-11-02]
hardware/glove-v4/enclosure/rgb-lightpipe.stl
7.65 x 4.00 x 13.9
