latintzar/tactile-glove/hardware/glove-v4/enclosure/battery-ntc-envelope.stl

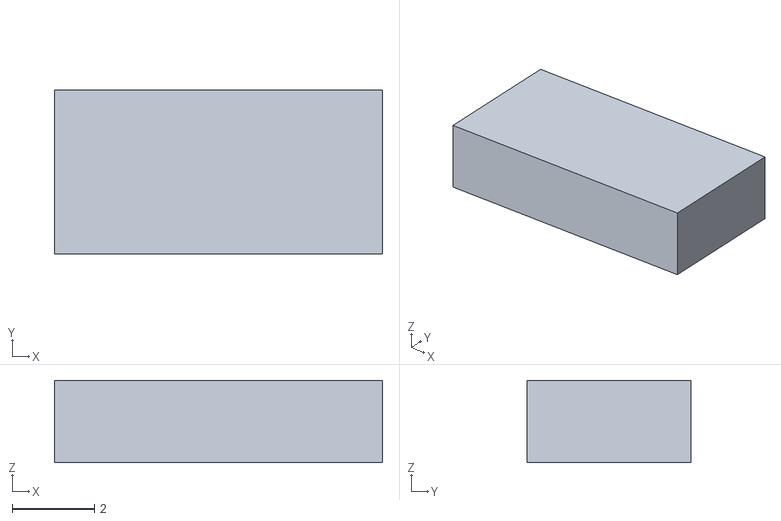
[picture p25: CAD file, 2026-11-02]
hardware/glove-v4/enclosure/battery-ntc-envelope.stl
8.00 x 4.00 x 2.00
