latintzar/tactile-glove/hardware/glove-v4/enclosure/hand-tile-tpu-cover.stl

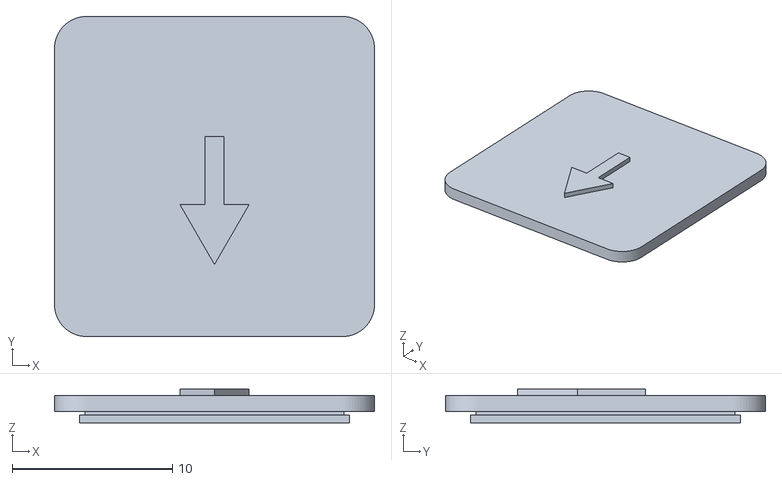
[picture p26: CAD file, 2026-11-02]
hardware/glove-v4/enclosure/hand-tile-tpu-cover.stl
20.0 x 20.0 x 2.10
