latintzar/tactile-glove/hardware/glove-v4/enclosure/camera-module-envelope.stl

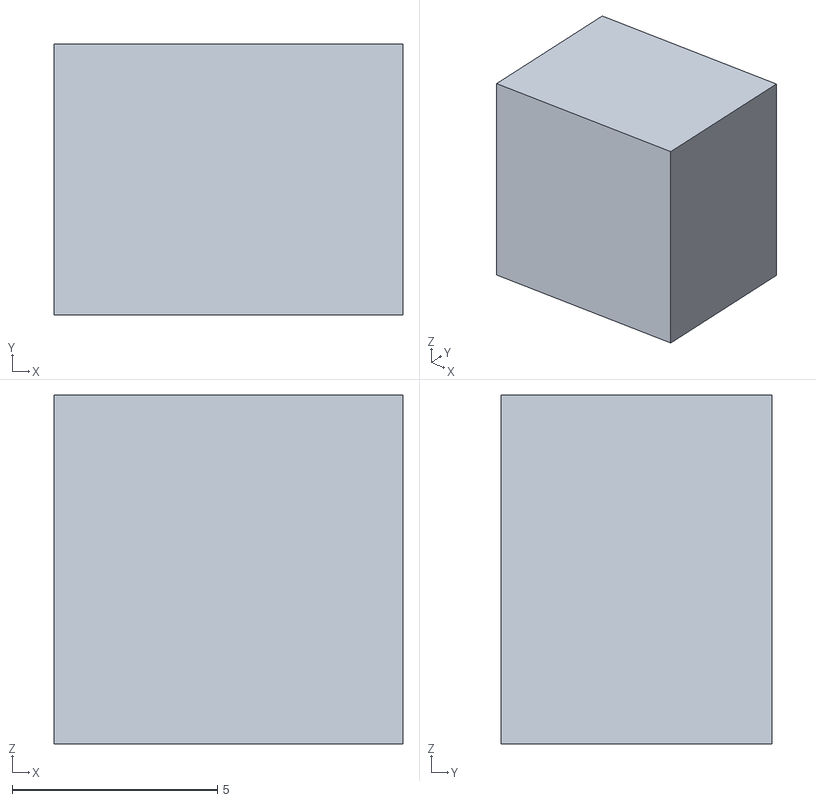
[picture p27: CAD file, 2026-11-02]
hardware/glove-v4/enclosure/camera-module-envelope.stl
8.50 x 6.60 x 8.50
