latintzar/tactile-glove/hardware/glove-v4/enclosure/camera-window-adhesive-ring.stl

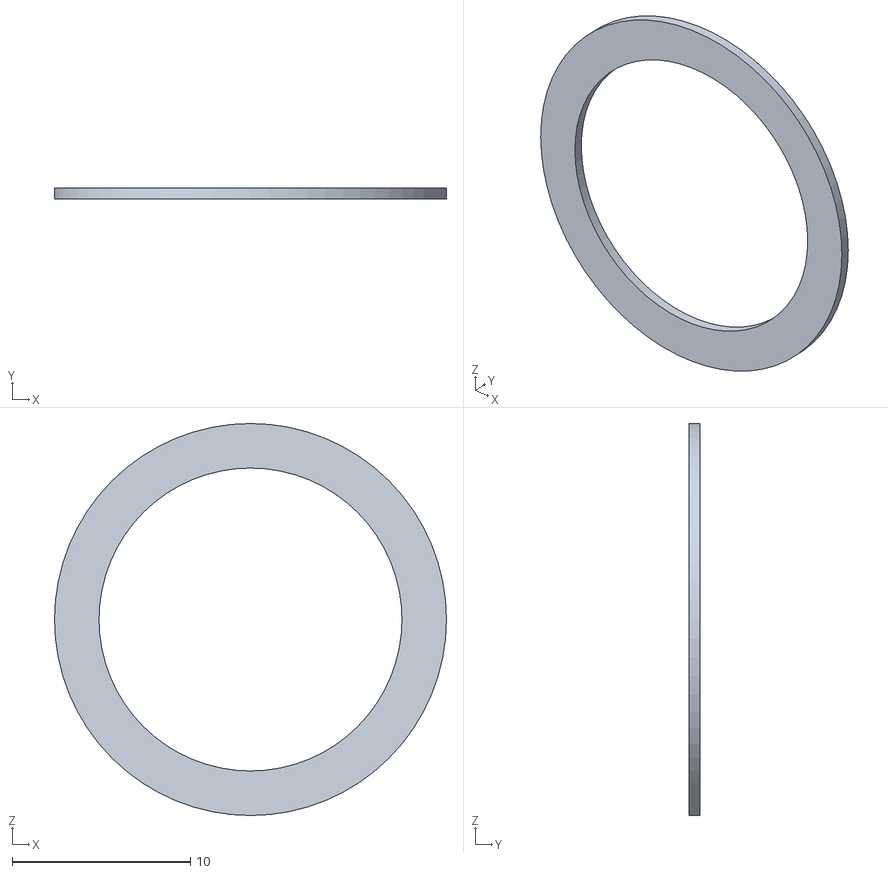
[picture p28: CAD file, 2026-11-02]
hardware/glove-v4/enclosure/camera-window-adhesive-ring.stl
22.0 x 0.6 x 22.0
