latintzar/tactile-glove/hardware/glove-v4/enclosure/button-floating-tip.stl

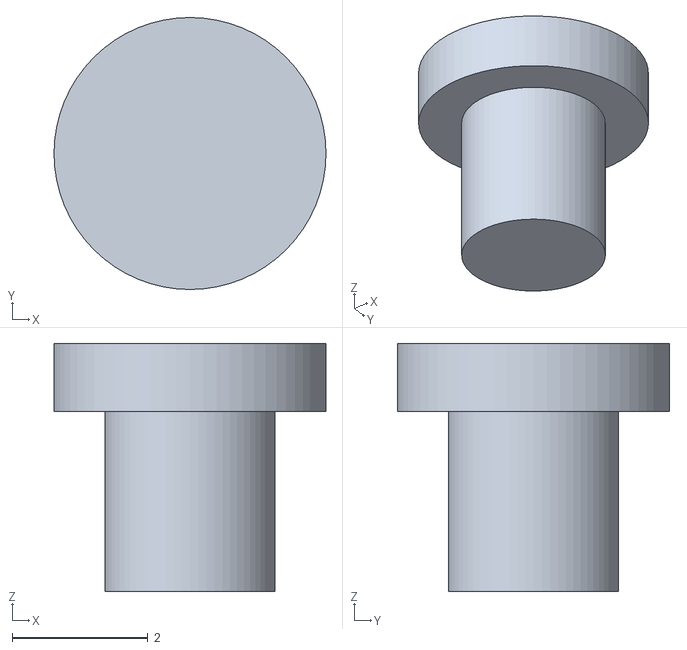
[picture p29: CAD file, 2026-11-02]
hardware/glove-v4/enclosure/button-floating-tip.stl
4.00 x 4.00 x 3.65
