latintzar/tactile-glove/hardware/glove-v4/enclosure/usb-service-cap.stl

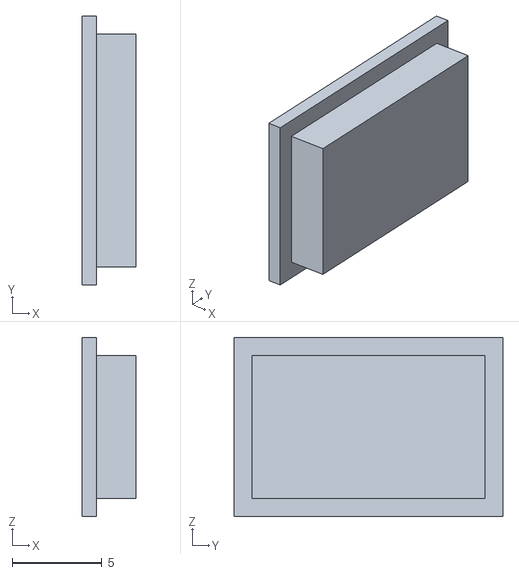
[picture p30: CAD file, 2026-11-02]
hardware/glove-v4/enclosure/usb-service-cap.stl
3.00 x 15.0 x 10.0
