latintzar/tactile-glove/hardware/glove-v4/enclosure/camera-tpu-cradle-liner.stl

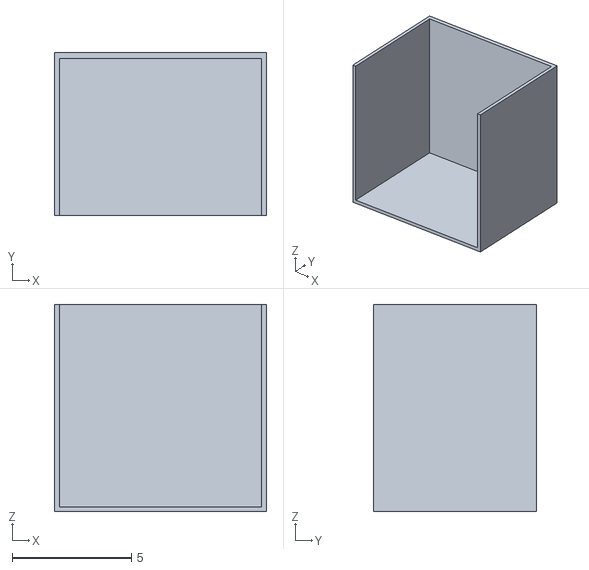
[picture p31: CAD file, 2026-11-02]
hardware/glove-v4/enclosure/camera-tpu-cradle-liner.stl
8.90 x 6.85 x 8.70
