latintzar/tactile-glove/(list of files, cad)

Other CAD files:
hardware/glove-v4/enclosure/cable-grommet-7-blanking-plug.stl
hardware/glove-v4/enclosure/cable-grommet-4.stl
hardware/glove-v4/enclosure/cable-grommet-3-blanking-plug.stl
hardware/glove-v4/enclosure/cable-grommet-5.stl
hardware/glove-v4/enclosure/camera-front-shim-2.stl
hardware/glove-v4/enclosure/cable-grommet-5-blanking-plug.stl
hardware/glove-v4/enclosure/cable-grommet-1-blanking-plug.stl
hardware/glove-v4/enclosure/camera-front-shim-3.stl
hardware/glove-v4/enclosure/cable-grommet-6-blanking-plug.stl
hardware/glove-v4/enclosure/cable-grommet-2-blanking-plug.stl
hardware/glove-v4/enclosure/pcb-clamp-pad-4.stl
hardware/glove-v4/enclosure/pcb-clamp-pad-2.stl
hardware/glove-v4/enclosure/cable-grommet-1.stl
hardware/glove-v4/enclosure/cable-grommet-7.stl
hardware/glove-v4/enclosure/cable-grommet-2.stl
hardware/glove-v4/enclosure/battery-foam-pad-1.stl
hardware/glove-v4/enclosure/pcb-clamp-pad-1.stl
hardware/glove-v4/enclosure/camera-front-shim-1.stl
