latintzar/tactile-glove/firmware/tactile_v4/artifacts/capture-disassembly.txt

/tmp/glove-local-idf-20261023/build/artisan_tactile_v4.elf:     file format elf32-xtensa-le

Disassembly of section .iram0.text:

403786d0 <void V4::Acquisition::capture<V4::Adc>(unsigned long long, unsigned long, V4::Adc&)>:
403786d0:	014136        	entry	a1, 160
403786d3:	073d      	mov.n	a3, a7
403786d5:	04fd      	mov.n	a15, a4
403786d7:	196152        	s32i	a5, a1, 100
403786da:	186162        	s32i	a6, a1, 96
403786dd:	0020c0        	memw
403786e0:	180c      	movi.n	a8, 1
403786e2:	30d272        	addmi	a7, a2, 0x3000
403786e5:	0020c0        	memw
403786e8:	504782        	s8i	a8, a7, 80
403786eb:	0020c0        	memw
403786ee:	440782        	l8ui	a8, a7, 68
403786f1:	748080        	extui	a8, a8, 0, 8
403786f4:	0020c0        	memw
403786f7:	a8cc      	bnez.n	a8, 40378705 <void V4::Acquisition::capture<V4::Adc>(unsigned long long, unsigned long, V4::Adc&)+0x35>
403786f9:	0020c0        	memw
403786fc:	0020c0        	memw
403786ff:	504782        	s8i	a8, a7, 80
40378702:	011946        	j	40378b6b <void V4::Acquisition::capture<V4::Adc>(unsigned long long, unsigned long, V4::Adc&)+0x49b>
40378705:	91eb      	addi.n	a9, a1, 14
40378707:	00a0a2        	movi	a10, 0
4037870a:	29a082        	movi	a8, 41
4037870d:	048876        	loop	a8, 40378715 <void V4::Acquisition::capture<V4::Adc>(unsigned long long, unsigned long, V4::Adc&)+0x45>
40378710:	0059a2        	s16i	a10, a9, 0
40378713:	992b      	addi.n	a9, a9, 2
40378715:	0020c0        	memw
40378718:	480782        	l8ui	a8, a7, 72
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
40378bdb:	88ba      	add.n	a8, a8, a11
40378bdd:	07ad      	mov.n	a10, a7
40378bdf:	01bd      	mov.n	a11, a1
40378be1:	0199      	s32i.n	a9, a1, 0
40378be3:	1189      	s32i.n	a8, a1, 4
40378be5:	09b6a5        	call8	40382750 <gptimer_set_alarm_action>
40378be8:	f01d      	retw.n
