latintzar/tactile-glove/hardware/glove-v3/guide/index.html

# Right glove · 20 sensing locations

Each location measures pressure and vibration. Select a location to see its four connections.

Pressure + PVDF film Branch wiring

Loading reference hand…

## Index · proximal segment

### Layer order · outside of the glove

The PVDF face connected to the vibration input faces outward. Both electrical faces stay insulated. Route the leads around the finger side; keep adhesive joints off the creases.

### Build files

Print-size cut template · All connector pins · Assembly instructions

The anatomical mesh and wire curves explain placement. Fit the paper pieces to your glove before cutting film. CAD release and physical fit checks remain in progress.
