latintzar/tactile-glove/hardware/glove-v3/sensors/wiring.csv

cell_id | board_branch_connector | pressure_low_contact | pressure_high_contact | pvdf_bottom_contact | pvdf_top_contact | wire_spec | route_and_strain_relief
I1prox | J_INDEX | J_INDEX.7 VEXC2V5 (shared branch return) | J_INDEX.2 PRESS_I1 (cell signal) | J_INDEX.8 GND (shared branch return) | J_INDEX.1 PVDF_I1 (cell signal face) | Alpha 5851 30AWG; 4 cell leads, 2 shared at branch | side/back route; bridge 15-20mm behind cell
I2mid | J_INDEX | J_INDEX.7 VEXC2V5 (shared branch return) | J_INDEX.4 PRESS_I2 (cell signal) | J_INDEX.8 GND (shared branch return) | J_INDEX.3 PVDF_I2 (cell signal face) | Alpha 5851 30AWG; 4 cell leads, 2 shared at branch | side/back route; clear crease
I3dist | J_INDEX | J_INDEX.7 VEXC2V5 (shared branch return) | J_INDEX.6 PRESS_I3 (cell signal) | J_INDEX.8 GND (shared branch return) | J_INDEX.5 PVDF_I3 (cell signal face) | Alpha 5851 30AWG; 4 cell leads, 2 shared at branch | side/back route; clear distal crease
M1prox | J_MIDDLE | J_MIDDLE.7 VEXC2V5 (shared branch return) | J_MIDDLE.2 PRESS_M1 (cell signal) | J_MIDDLE.8 GND (shared branch return) | J_MIDDLE.1 PVDF_M1 (cell signal face) | Alpha 5851 30AWG; 4 cell leads, 2 shared at branch | side/back route; bridge 15-20mm behind cell
M2mid | J_MIDDLE | J_MIDDLE.7 VEXC2V5 (shared branch return) | J_MIDDLE.4 PRESS_M2 (cell signal) | J_MIDDLE.8 GND (shared branch return) | J_MIDDLE.3 PVDF_M2 (cell signal face) | Alpha 5851 30AWG; 4 cell leads, 2 shared at branch | side/back route; clear crease
M3dist | J_MIDDLE | J_MIDDLE.7 VEXC2V5 (shared branch return) | J_MIDDLE.6 PRESS_M3 (cell signal) | J_MIDDLE.8 GND (shared branch return) | J_MIDDLE.5 PVDF_M3 (cell signal face) | Alpha 5851 30AWG; 4 cell leads, 2 shared at branch | side/back route; clear distal crease
R1prox | J_RING | J_RING.7 VEXC2V5 (shared branch return) | J_RING.2 PRESS_R1 (cell signal) | J_RING.8 GND (shared branch return) | J_RING.1 PVDF_R1 (cell signal face) | Alpha 5851 30AWG; 4 cell leads, 2 shared at branch | side/back route; bridge 15-20mm behind cell
R2mid | J_RING | J_RING.7 VEXC2V5 (shared branch return) | J_RING.4 PRESS_R2 (cell signal) | J_RING.8 GND (shared branch return) | J_RING.3 PVDF_R2 (cell signal face) | Alpha 5851 30AWG; 4 cell leads, 2 shared at branch | side/back route; clear crease
R3dist | J_RING | J_RING.7 VEXC2V5 (shared branch return) | J_RING.6 PRESS_R3 (cell signal) | J_RING.8 GND (shared branch return) | J_RING.5 PVDF_R3 (cell signal face) | Alpha 5851 30AWG; 4 cell leads, 2 shared at branch | side/back route; clear distal crease
L1prox | J_LITTLE | J_LITTLE.7 VEXC2V5 (shared branch return) | J_LITTLE.2 PRESS_L1 (cell signal) | J_LITTLE.8 GND (shared branch return) | J_LITTLE.1 PVDF_L1 (cell signal face) | Alpha 5851 30AWG; 4 cell leads, 2 shared at branch | side/back route; bridge 15-20mm behind cell
L2mid | J_LITTLE | J_LITTLE.7 VEXC2V5 (shared branch return) | J_LITTLE.4 PRESS_L2 (cell signal) | J_LITTLE.8 GND (shared branch return) | J_LITTLE.3 PVDF_L2 (cell signal face) | Alpha 5851 30AWG; 4 cell leads, 2 shared at branch | side/back route; clear crease
L3dist | J_LITTLE | J_LITTLE.7 VEXC2V5 (shared branch return) | J_LITTLE.6 PRESS_L3 (cell signal) | J_LITTLE.8 GND (shared branch return) | J_LITTLE.5 PVDF_L3 (cell signal face) | Alpha 5851 30AWG; 4 cell leads, 2 shared at branch | side/back route; clear distal crease
T1prox | J_THUMB | J_THUMB.5 VEXC2V5 (shared branch return) | J_THUMB.2 PRESS_T1 (cell signal) | J_THUMB.6 GND (shared branch return) | J_THUMB.1 PVDF_T1 (cell signal face) | Alpha 5851 30AWG; 4 cell leads, 2 shared at branch | thumb side/back route; bridge 15-20mm behind cell
T2dist | J_THUMB | J_THUMB.5 VEXC2V5 (shared branch return) | J_THUMB.4 PRESS_T2 (cell signal) | J_THUMB.6 GND (shared branch return) | J_THUMB.3 PVDF_T2 (cell signal face) | Alpha 5851 30AWG; 4 cell leads, 2 shared at branch | thumb side/back route; clear distal crease
P1 | J_PALM_HEEL | J_PALM_HEEL.13 VEXC2V5 (shared branch return) | J_PALM_HEEL.2 PRESS_P1 (cell signal) | J_PALM_HEEL.14 GND (shared branch return) | J_PALM_HEEL.1 PVDF_P1 (cell signal face) | Alpha 5851 30AWG; 4 cell leads, 2 shared at branch | palm dorsal route; bridge at cuff side
P2 | J_PALM_HEEL | J_PALM_HEEL.13 VEXC2V5 (shared branch return) | J_PALM_HEEL.4 PRESS_P2 (cell signal) | J_PALM_HEEL.14 GND (shared branch return) | J_PALM_HEEL.3 PVDF_P2 (cell signal face) | Alpha 5851 30AWG; 4 cell leads, 2 shared at branch | palm dorsal route; bridge at cuff side
P3 | J_PALM_HEEL | J_PALM_HEEL.13 VEXC2V5 (shared branch return) | J_PALM_HEEL.6 PRESS_P3 (cell signal) | J_PALM_HEEL.14 GND (shared branch return) | J_PALM_HEEL.5 PVDF_P3 (cell signal face) | Alpha 5851 30AWG; 4 cell leads, 2 shared at branch | palm dorsal route; bridge at cuff side
P4 | J_PALM_HEEL | J_PALM_HEEL.13 VEXC2V5 (shared branch return) | J_PALM_HEEL.8 PRESS_P4 (cell signal) | J_PALM_HEEL.14 GND (shared branch return) | J_PALM_HEEL.7 PVDF_P4 (cell signal face) | Alpha 5851 30AWG; 4 cell leads, 2 shared at branch | palm dorsal route; bridge at cuff side
H1 | J_PALM_HEEL | J_PALM_HEEL.13 VEXC2V5 (shared branch return) | J_PALM_HEEL.10 PRESS_H1 (cell signal) | J_PALM_HEEL.14 GND (shared branch return) | J_PALM_HEEL.9 PVDF_H1 (cell signal face) | Alpha 5851 30AWG; 4 cell leads, 2 shared at branch | heel/base route; anchor before wrist bend
H2 | J_PALM_HEEL | J_PALM_HEEL.13 VEXC2V5 (shared branch return) | J_PALM_HEEL.12 PRESS_H2 (cell signal) | J_PALM_HEEL.14 GND (shared branch return) | J_PALM_HEEL.11 PVDF_H2 (cell signal face) | Alpha 5851 30AWG; 4 cell leads, 2 shared at branch | heel/base route; anchor before wrist bend
