latintzar/tactile-glove/hardware/glove-v4/guide/screenshots/desktop.png

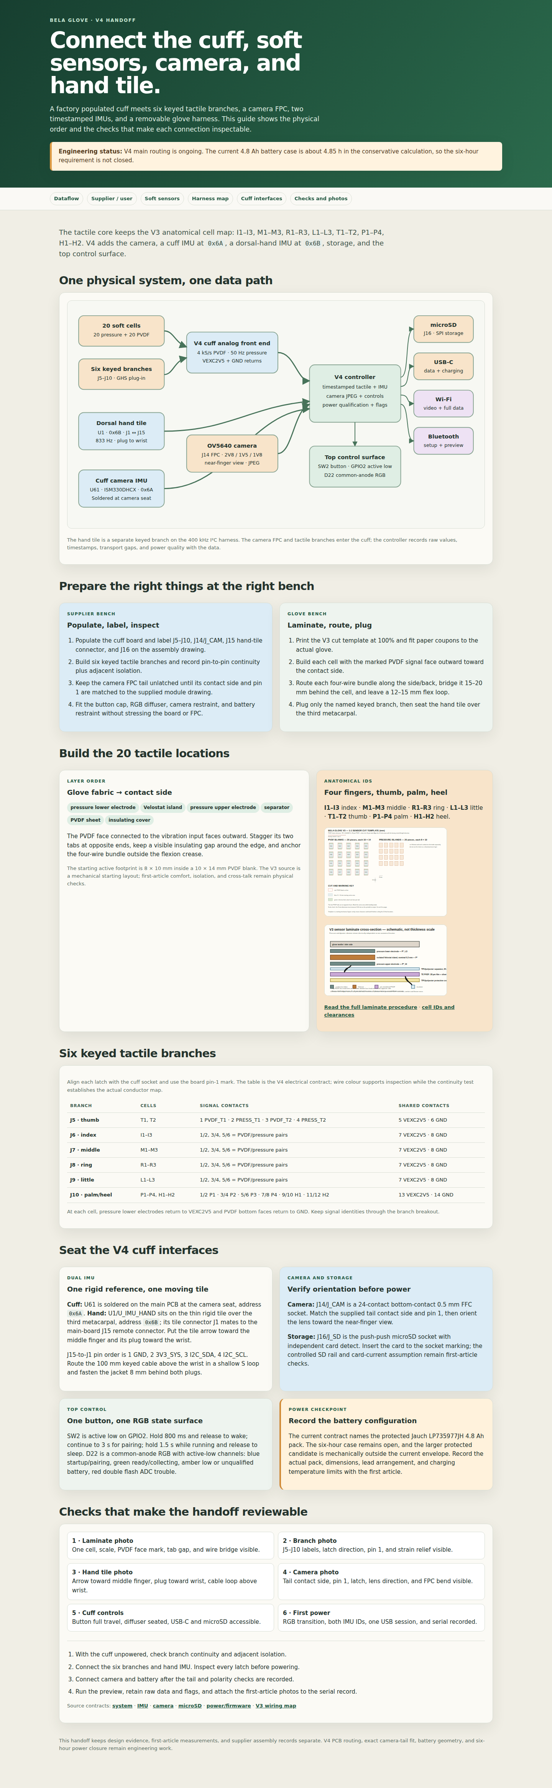
hardware/glove-v4/guide/screenshots/desktop.png
