latintzar/tactile-glove/hardware/glove-v4/guide/screenshots/mobile.png

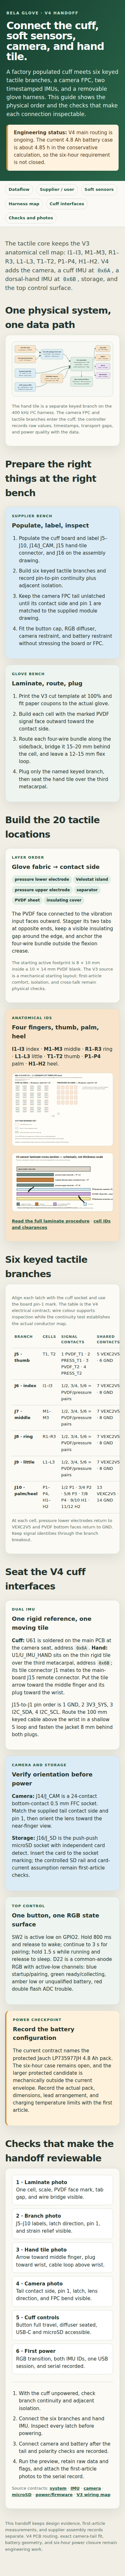
hardware/glove-v4/guide/screenshots/mobile.png
