latintzar/tactile-glove/hardware/glove-v4/verification/differential-adc/cases/dynamic-down/display.csv

time_s | source_V | AINplus_V | AINminus_V | sampleplus_V | sampleminus_V
0.000000000000000000e+00 | 2.500000000000000000e+00 | 2.500149484336000150e+00 | 1.250028630849000066e+00 | 2.500149484336000150e+00 | 1.250028630849000066e+00
1.328000000000000046e-08 | 2.500000000000000000e+00 | 2.500149484326999794e+00 | 1.250028630847999978e+00 | 2.500149484331999794e+00 | 1.250028630847999978e+00
3.327999999999999757e-08 | 2.500000000000000000e+00 | 2.500149484313999970e+00 | 1.250028630869000068e+00 | 2.500149484316999793e+00 | 1.250028630861000023e+00
5.327999999999999799e-08 | 2.500000000000000000e+00 | 2.500149484305000058e+00 | 1.250028630904999938e+00 | 2.500149484306999792e+00 | 1.250028630894000070e+00
7.328000000000000503e-08 | 2.500000000000000000e+00 | 2.500149484291999791e+00 | 1.250028630936000029e+00 | 2.500149484296999791e+00 | 1.250028630926999895e+00
9.327999999999999883e-08 | 2.500000000000000000e+00 | 2.500149484276000145e+00 | 1.250028630954000075e+00 | 2.500149484281000145e+00 | 1.250028630949000075e+00
1.132800000000000059e-07 | 2.500000000000000000e+00 | 2.500149484256000143e+00 | 1.250028630959000076e+00 | 2.500149484261999788e+00 | 1.250028630957999987e+00
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
