latintzar/tactile-glove/hardware/glove-v4/verification/differential-adc/cases/dynamic-resistance-stress/display.csv

time_s | source_V | AINplus_V | AINminus_V | sampleplus_V | sampleminus_V
0.000000000000000000e+00 | 1.000000000000000056e-01 | 1.002089253047000056e-01 | 1.250028630849000066e+00 | 1.002089253047000056e-01 | 1.250028630849000066e+00
1.328000000000000046e-08 | 1.000000000000000056e-01 | 1.002089253059999935e-01 | 1.250028630847999978e+00 | 1.002089253052999979e-01 | 1.250028630847999978e+00
3.327999999999999757e-08 | 1.000000000000000056e-01 | 1.002089253126999951e-01 | 1.250028630869000068e+00 | 1.002089253105000050e-01 | 1.250028630861000023e+00
5.327999999999999799e-08 | 1.000000000000000056e-01 | 1.002089253205999952e-01 | 1.250028630904999938e+00 | 1.002089253183000017e-01 | 1.250028630894000070e+00
7.328000000000000503e-08 | 1.000000000000000056e-01 | 1.002089253263000052e-01 | 1.250028630936000029e+00 | 1.002089253247999967e-01 | 1.250028630926999895e+00
9.327999999999999883e-08 | 1.000000000000000056e-01 | 1.002089253285999987e-01 | 1.250028630954000075e+00 | 1.002089253280999959e-01 | 1.250028630949000075e+00
1.132800000000000059e-07 | 1.000000000000000056e-01 | 1.002089253280999959e-01 | 1.250028630959000076e+00 | 1.002089253284000059e-01 | 1.250028630957999987e+00
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
