latintzar/tactile-glove/hardware/glove-v4/verification/differential-adc/cases/dynamic-up/display.csv

time_s | source_V | AINplus_V | AINminus_V | sampleplus_V | sampleminus_V
0.000000000000000000e+00 | 1.000000000000000056e-01 | 1.002058105934000021e-01 | 1.250028630849000066e+00 | 1.002058105934000021e-01 | 1.250028630849000066e+00
1.328000000000000046e-08 | 1.000000000000000056e-01 | 1.002058105906000057e-01 | 1.250028630847999978e+00 | 1.002058105918999936e-01 | 1.250028630847999978e+00
3.327999999999999757e-08 | 1.000000000000000056e-01 | 1.002058105860000048e-01 | 1.250028630869000068e+00 | 1.002058105873999960e-01 | 1.250028630861000023e+00
5.327999999999999799e-08 | 1.000000000000000056e-01 | 1.002058105831000051e-01 | 1.250028630904999938e+00 | 1.002058105839000041e-01 | 1.250028630894000070e+00
7.328000000000000503e-08 | 1.000000000000000056e-01 | 1.002058105815999967e-01 | 1.250028630936000029e+00 | 1.002058105819000067e-01 | 1.250028630926999895e+00
9.327999999999999883e-08 | 1.000000000000000056e-01 | 1.002058105810000044e-01 | 1.250028630954000075e+00 | 1.002058105811999972e-01 | 1.250028630949000075e+00
1.132800000000000059e-07 | 1.000000000000000056e-01 | 1.002058105810000044e-01 | 1.250028630959000076e+00 | 1.002058105810000044e-01 | 1.250028630957999987e+00
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
