latintzar/tactile-glove/hardware/glove-v4/verification/differential-adc/cases/pressure-down/display.csv

time_s | source_V | AINplus_V | AINminus_V | sampleplus_V | sampleminus_V
0.000000000000000000e+00 | 2.500000000000000000e+00 | 2.500132437741999780e+00 | 1.250028630849000066e+00 | 2.500132437741999780e+00 | 1.250028630849000066e+00
1.328000000000000046e-08 | 2.500000000000000000e+00 | 2.500132437735000046e+00 | 1.250028630847999978e+00 | 2.500132437738999958e+00 | 1.250028630847999978e+00
3.327999999999999757e-08 | 2.500000000000000000e+00 | 2.500132437741000135e+00 | 1.250028630869000068e+00 | 2.500132437736000135e+00 | 1.250028630861000023e+00
5.327999999999999799e-08 | 2.500000000000000000e+00 | 2.500132437806999786e+00 | 1.250028630904999938e+00 | 2.500132437782999872e+00 | 1.250028630894000070e+00
7.328000000000000503e-08 | 2.500000000000000000e+00 | 2.500132437928999973e+00 | 1.250028630936000029e+00 | 2.500132437888999970e+00 | 1.250028630926999895e+00
9.327999999999999883e-08 | 2.500000000000000000e+00 | 2.500132438082999897e+00 | 1.250028630954000075e+00 | 2.500132438033999982e+00 | 1.250028630949000075e+00
1.132800000000000059e-07 | 2.500000000000000000e+00 | 2.500132438242999910e+00 | 1.250028630959000076e+00 | 2.500132438193999995e+00 | 1.250028630957999987e+00
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
