latintzar/tactile-glove/hardware/glove-v4/verification/differential-adc/cases/pressure-up/display.csv

time_s | source_V | AINplus_V | AINminus_V | sampleplus_V | sampleminus_V
0.000000000000000000e+00 | 0.000000000000000000e+00 | 2.139116429498999841e-02 | 1.250028630849000066e+00 | 2.139116429498999841e-02 | 1.250028630849000066e+00
1.328000000000000046e-08 | 0.000000000000000000e+00 | 2.139116429533000074e-02 | 1.250028630847999978e+00 | 2.139116429511999859e-02 | 1.250028630847999978e+00
3.327999999999999757e-08 | 0.000000000000000000e+00 | 2.139116429685999909e-02 | 1.250028630869000068e+00 | 2.139116429635999975e-02 | 1.250028630861000023e+00
5.327999999999999799e-08 | 0.000000000000000000e+00 | 2.139116429846000048e-02 | 1.250028630904999938e+00 | 2.139116429797999902e-02 | 1.250028630894000070e+00
7.328000000000000503e-08 | 0.000000000000000000e+00 | 2.139116429954000115e-02 | 1.250028630936000029e+00 | 2.139116429925000049e-02 | 1.250028630926999895e+00
9.327999999999999883e-08 | 0.000000000000000000e+00 | 2.139116429991000032e-02 | 1.250028630954000075e+00 | 2.139116429982999834e-02 | 1.250028630949000075e+00
1.132800000000000059e-07 | 0.000000000000000000e+00 | 2.139116429964999996e-02 | 1.250028630959000076e+00 | 2.139116429975999878e-02 | 1.250028630957999987e+00
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
