latintzar/tactile-glove/hardware/glove-v3/verification/signal-chain/canonical--250pC-cshunt.csv

time_s | charge_V | filter1_V | filter2_V | input_V | sensor_V
0.000000000000000000e+00 | 1.250000000000000000e+00 | 1.250000000000000000e+00 | 1.250000000000000000e+00 | 1.250000000000000000e+00 | 1.250000000000000000e+00
3.317598969999999978e-07 | 1.895476029999999985e-03 | 4.656782709999999700e-03 | 3.084452350000000016e-03 | 5.403241100000000241e-01 | 1.246536670000000013e+00
5.927915459999999698e-05 | 2.019814300000000087e-03 | 2.499948469999999957e-03 | 1.756967589999999932e-03 | 9.301037410000000394e-01 | 1.010973700000000086e+00
1.380887529999999964e-04 | 2.240671410000000165e-03 | 1.552110489999999985e-03 | 1.358811630000000001e-03 | 9.702951100000000162e-01 | 9.776095719999999822e-01
2.170947320000000079e-04 | 2.258520449999999909e-03 | 1.442144819999999997e-03 | 1.441671810000000071e-03 | 9.699280249999999715e-01 | 9.727859079999999770e-01
3.170947320000000263e-04 | 2.281130039999999977e-03 | 1.613072730000000019e-03 | 1.613063060000000061e-03 | 9.663497110000000001e-01 | 9.689056729999999673e-01
4.170947320000000175e-04 | 2.869709729999999921e-03 | 2.341948969999999974e-03 | 2.118511009999999965e-03 | 9.630277699999999497e-01 | 9.652607410000000332e-01
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
