latintzar/tactile-glove/hardware/glove-v3/verification/signal-chain/canonical--50000pC.csv

time_s | charge_V | filter1_V | filter2_V | input_V | sensor_V
0.000000000000000000e+00 | 1.250000000000000000e+00 | 1.250000000000000000e+00 | 1.250000000000000000e+00 | 1.250000000000000000e+00 | 1.250000000000000000e+00
4.291776540000000168e-06 | 1.683080960000000060e-03 | 4.439804200000000388e-03 | 2.938074900000000027e-03 | 6.380097089999999804e-01 | 1.209713610000000106e+00
1.112229530000000003e-04 | 2.203481859999999789e-03 | 1.741620410000000027e-03 | 1.400547569999999924e-03 | 9.668442339999999691e-01 | 9.817605459999999562e-01
2.372229530000000001e-04 | 2.256789559999999861e-03 | 1.468421209999999947e-03 | 1.468180359999999999e-03 | 9.692545550000000176e-01 | 9.719654699999999981e-01
3.632229529999999999e-04 | 2.361161440000000052e-03 | 1.760286569999999903e-03 | 1.754263930000000016e-03 | 9.646770989999999824e-01 | 9.671883449999999494e-01
4.237693520000000041e-04 | 1.629693120000000051e-01 | 1.680724899999999911e-01 | 2.385254959999999914e-03 | 1.118094790000000005e+00 | 9.653866340000000212e-01
4.366421089999999961e-04 | 3.681836370000000080e-01 | 3.135677530000000046e-01 | 7.083786590000000494e-02 | 1.248553589999999991e+00 | 1.013740749999999968e+00
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
