latintzar/tactile-glove/hardware/glove-v3/verification/signal-chain/canonical--500pC.csv

time_s | charge_V | filter1_V | filter2_V | input_V | sensor_V
0.000000000000000000e+00 | 1.250000000000000000e+00 | 1.250000000000000000e+00 | 1.250000000000000000e+00 | 1.250000000000000000e+00 | 1.250000000000000000e+00
4.479645339999999998e-06 | 1.676885369999999960e-03 | 4.429852839999999861e-03 | 2.931412349999999896e-03 | 6.412598069999999595e-01 | 1.208143009999999906e+00
1.132229529999999947e-04 | 2.207253690000000011e-03 | 1.723983319999999918e-03 | 1.393797729999999907e-03 | 9.672669400000000195e-01 | 9.813349279999999952e-01
2.402229529999999917e-04 | 2.256615390000000186e-03 | 1.472592090000000072e-03 | 1.472378400000000018e-03 | 9.691498689999999971e-01 | 9.718463659999999615e-01
3.672229529999999887e-04 | 2.373336690000000040e-03 | 1.778076260000000007e-03 | 1.770122110000000052e-03 | 9.645353009999999561e-01 | 9.670410019999999829e-01
4.238395079999999950e-04 | 2.021339420000000109e-01 | 2.054743649999999922e-01 | 2.441846509999999817e-03 | 1.155964779999999914e+00 | 9.655634339999999982e-01
4.368842619999999967e-04 | 3.694137980000000154e-01 | 3.137477889999999991e-01 | 7.868716750000000204e-02 | 1.248555440000000072e+00 | 1.014574230000000021e+00
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
