latintzar/tactile-glove/hardware/glove-v3/verification/signal-chain/canonical-0pC.csv

time_s | charge_V | filter1_V | filter2_V | input_V | sensor_V
0.000000000000000000e+00 | 1.250000000000000000e+00 | 1.250000000000000000e+00 | 1.250000000000000000e+00 | 1.250000000000000000e+00 | 1.250000000000000000e+00
4.108651640000000061e-06 | 1.689630720000000067e-03 | 4.449534029999999661e-03 | 2.944593189999999798e-03 | 6.347478579999999981e-01 | 1.211257479999999997e+00
1.092229530000000059e-04 | 2.199521280000000037e-03 | 1.759910879999999900e-03 | 1.407664500000000048e-03 | 9.663848240000000311e-01 | 9.822119969999999478e-01
2.342229530000000085e-04 | 2.256996219999999817e-03 | 1.464319929999999921e-03 | 1.464050099999999978e-03 | 9.693583590000000028e-01 | 9.720852420000000160e-01
3.592229530000000111e-04 | 2.350166429999999904e-03 | 1.743640569999999968e-03 | 1.739181850000000090e-03 | 9.648196669999999919e-01 | 9.673359990000000019e-01
4.235956790000000236e-04 | 6.559382190000000168e-02 | 7.481740189999999679e-02 | 2.244038989999999796e-03 | 1.023700540000000103e+00 | 9.651171069999999741e-01
4.364006010000000203e-04 | 3.669538279999999819e-01 | 3.133625879999999975e-01 | 5.345816510000000327e-02 | 1.248553089999999921e+00 | 1.012906529999999972e+00
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
