latintzar/tactile-glove/hardware/glove-v4/electrical/glove-v4-schematic.pdf

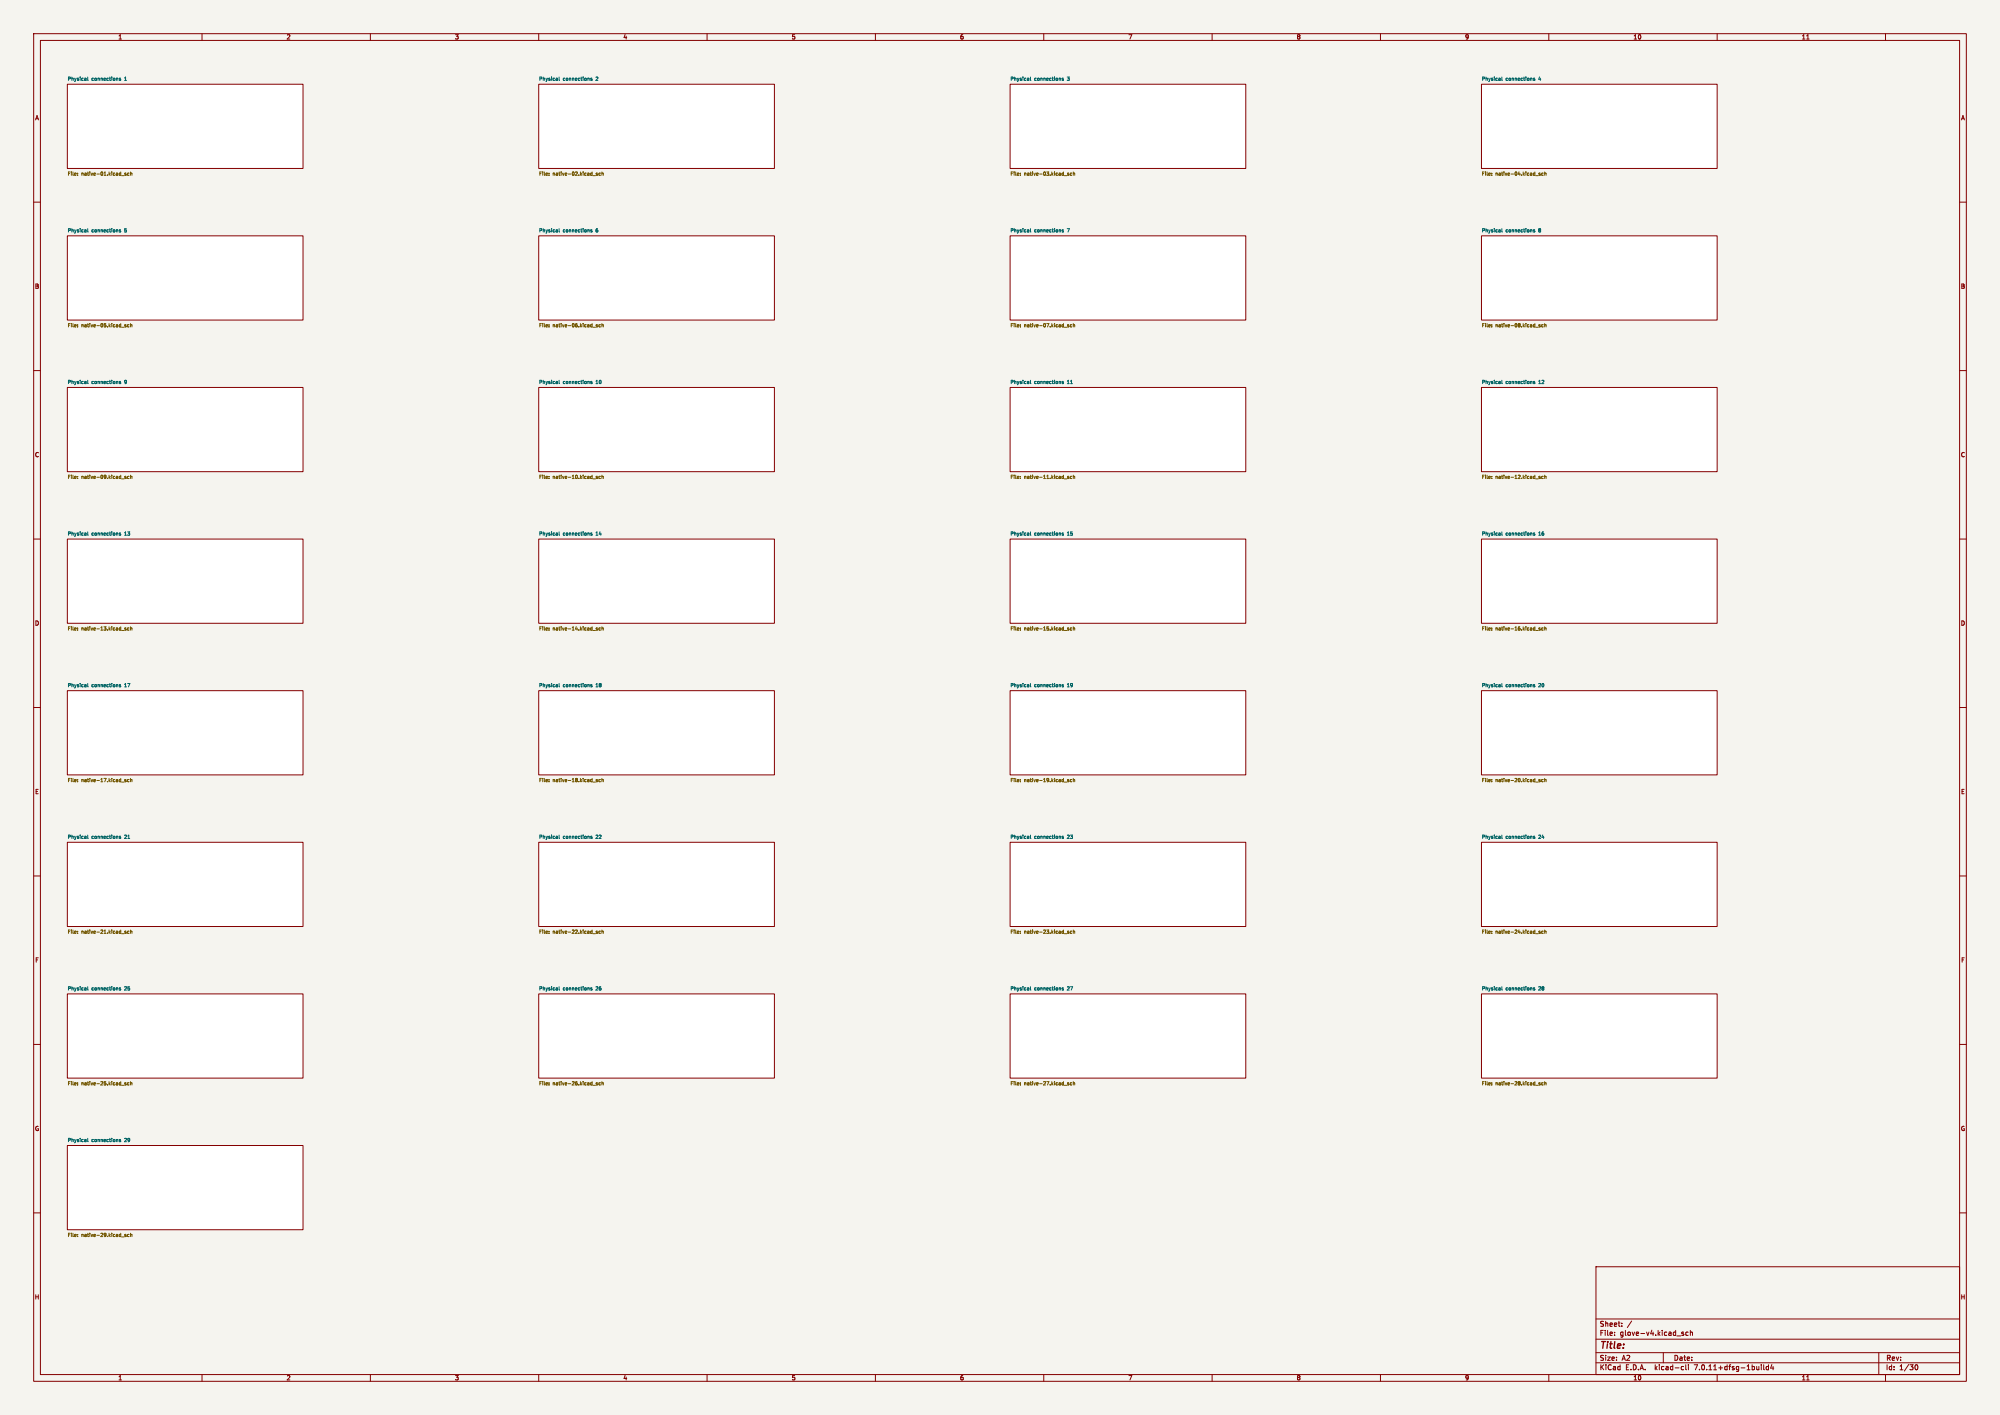
[picture p38: page 1]

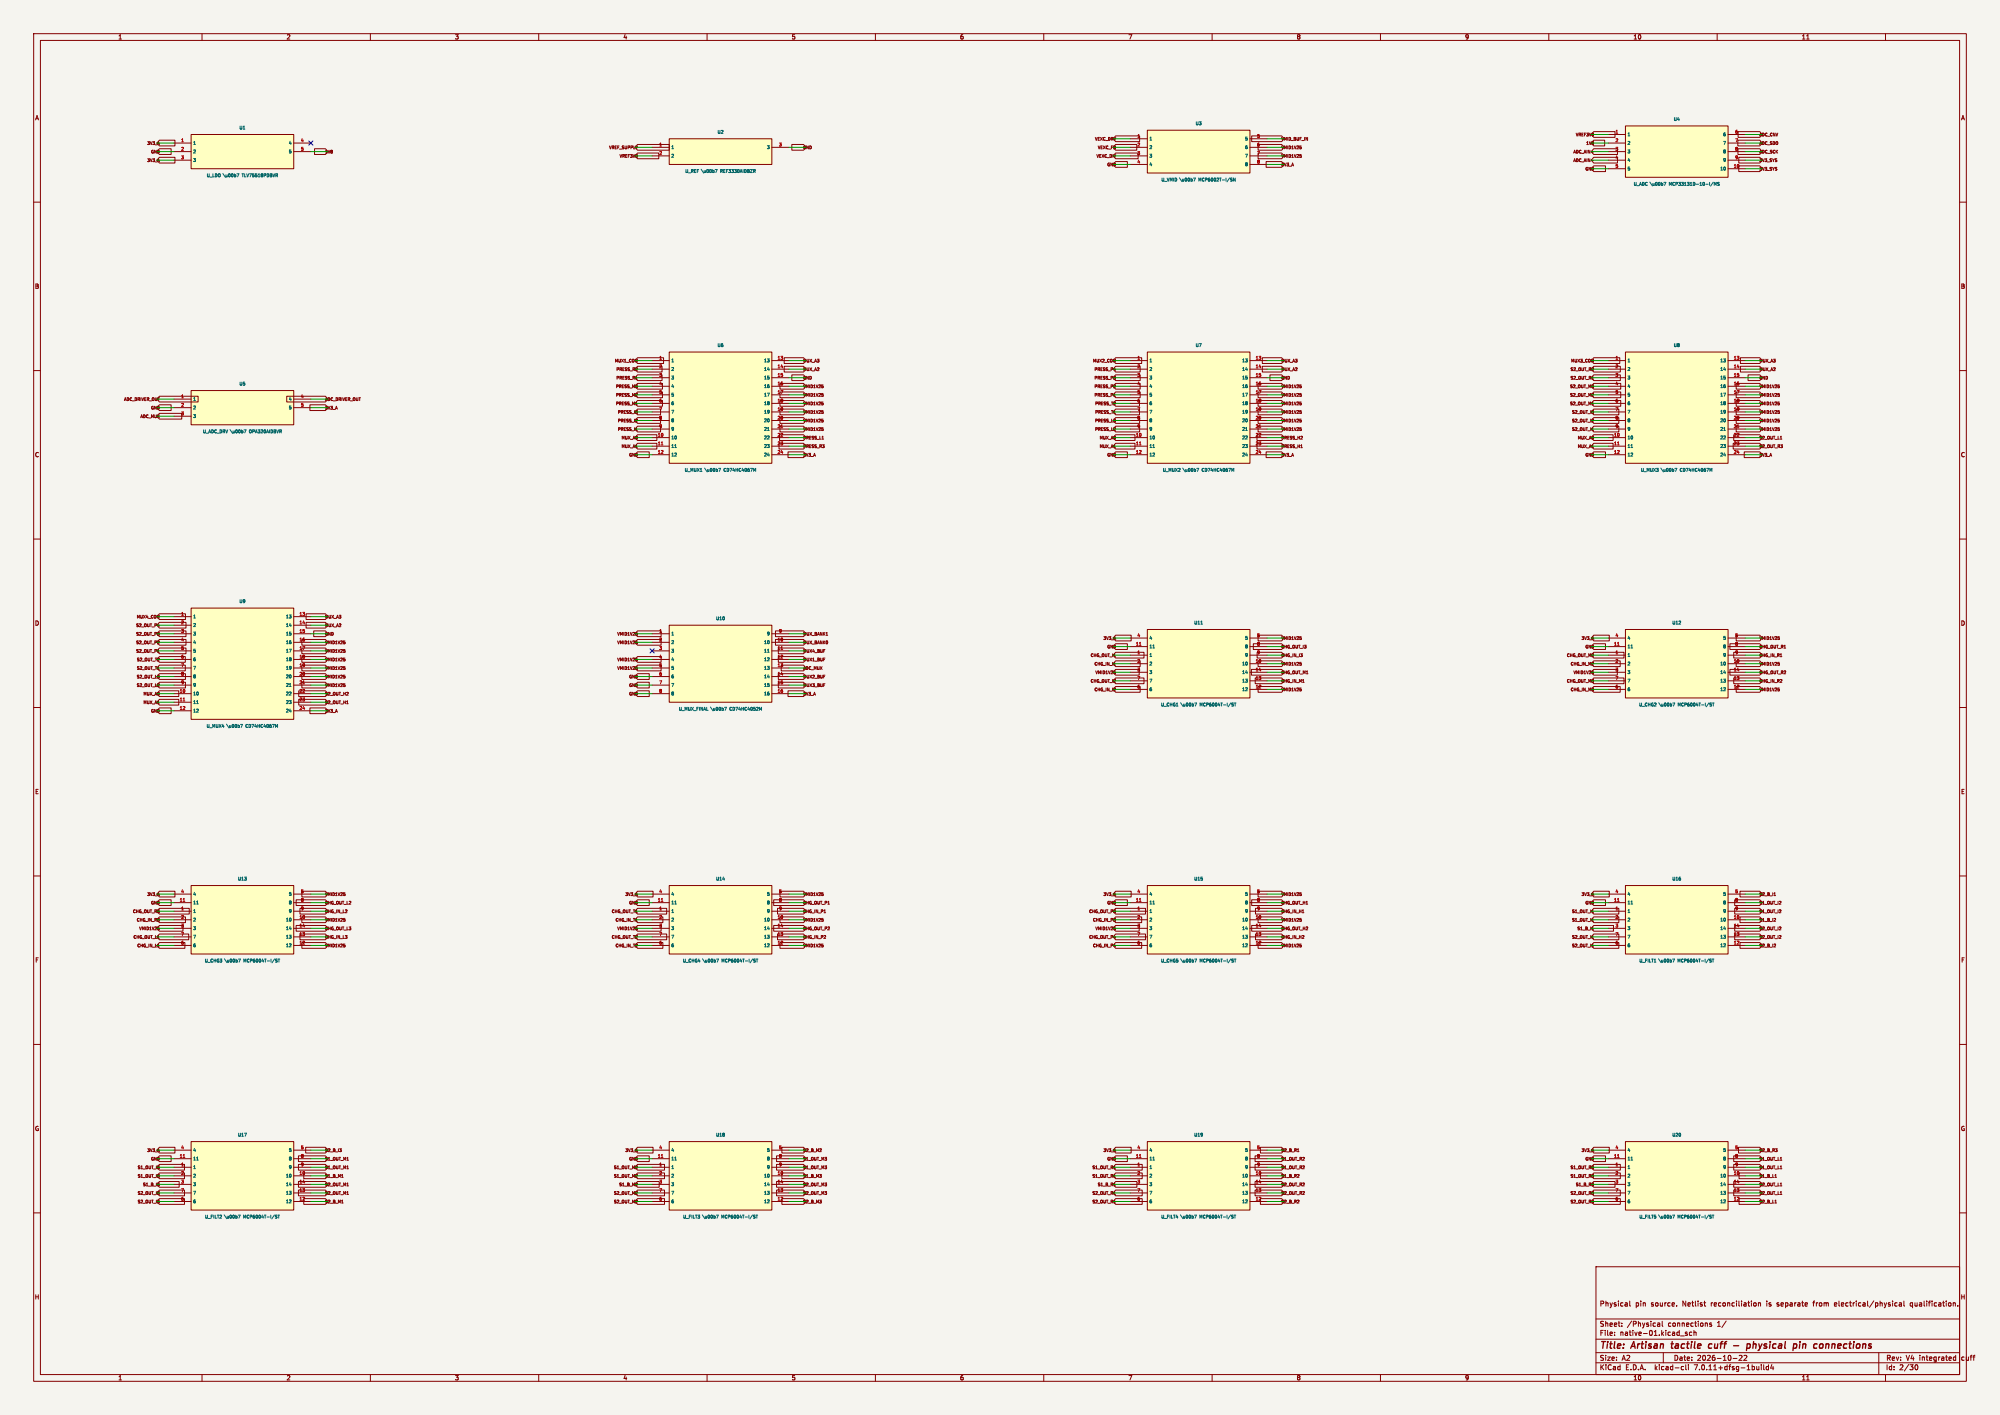
[picture p39: page 2]

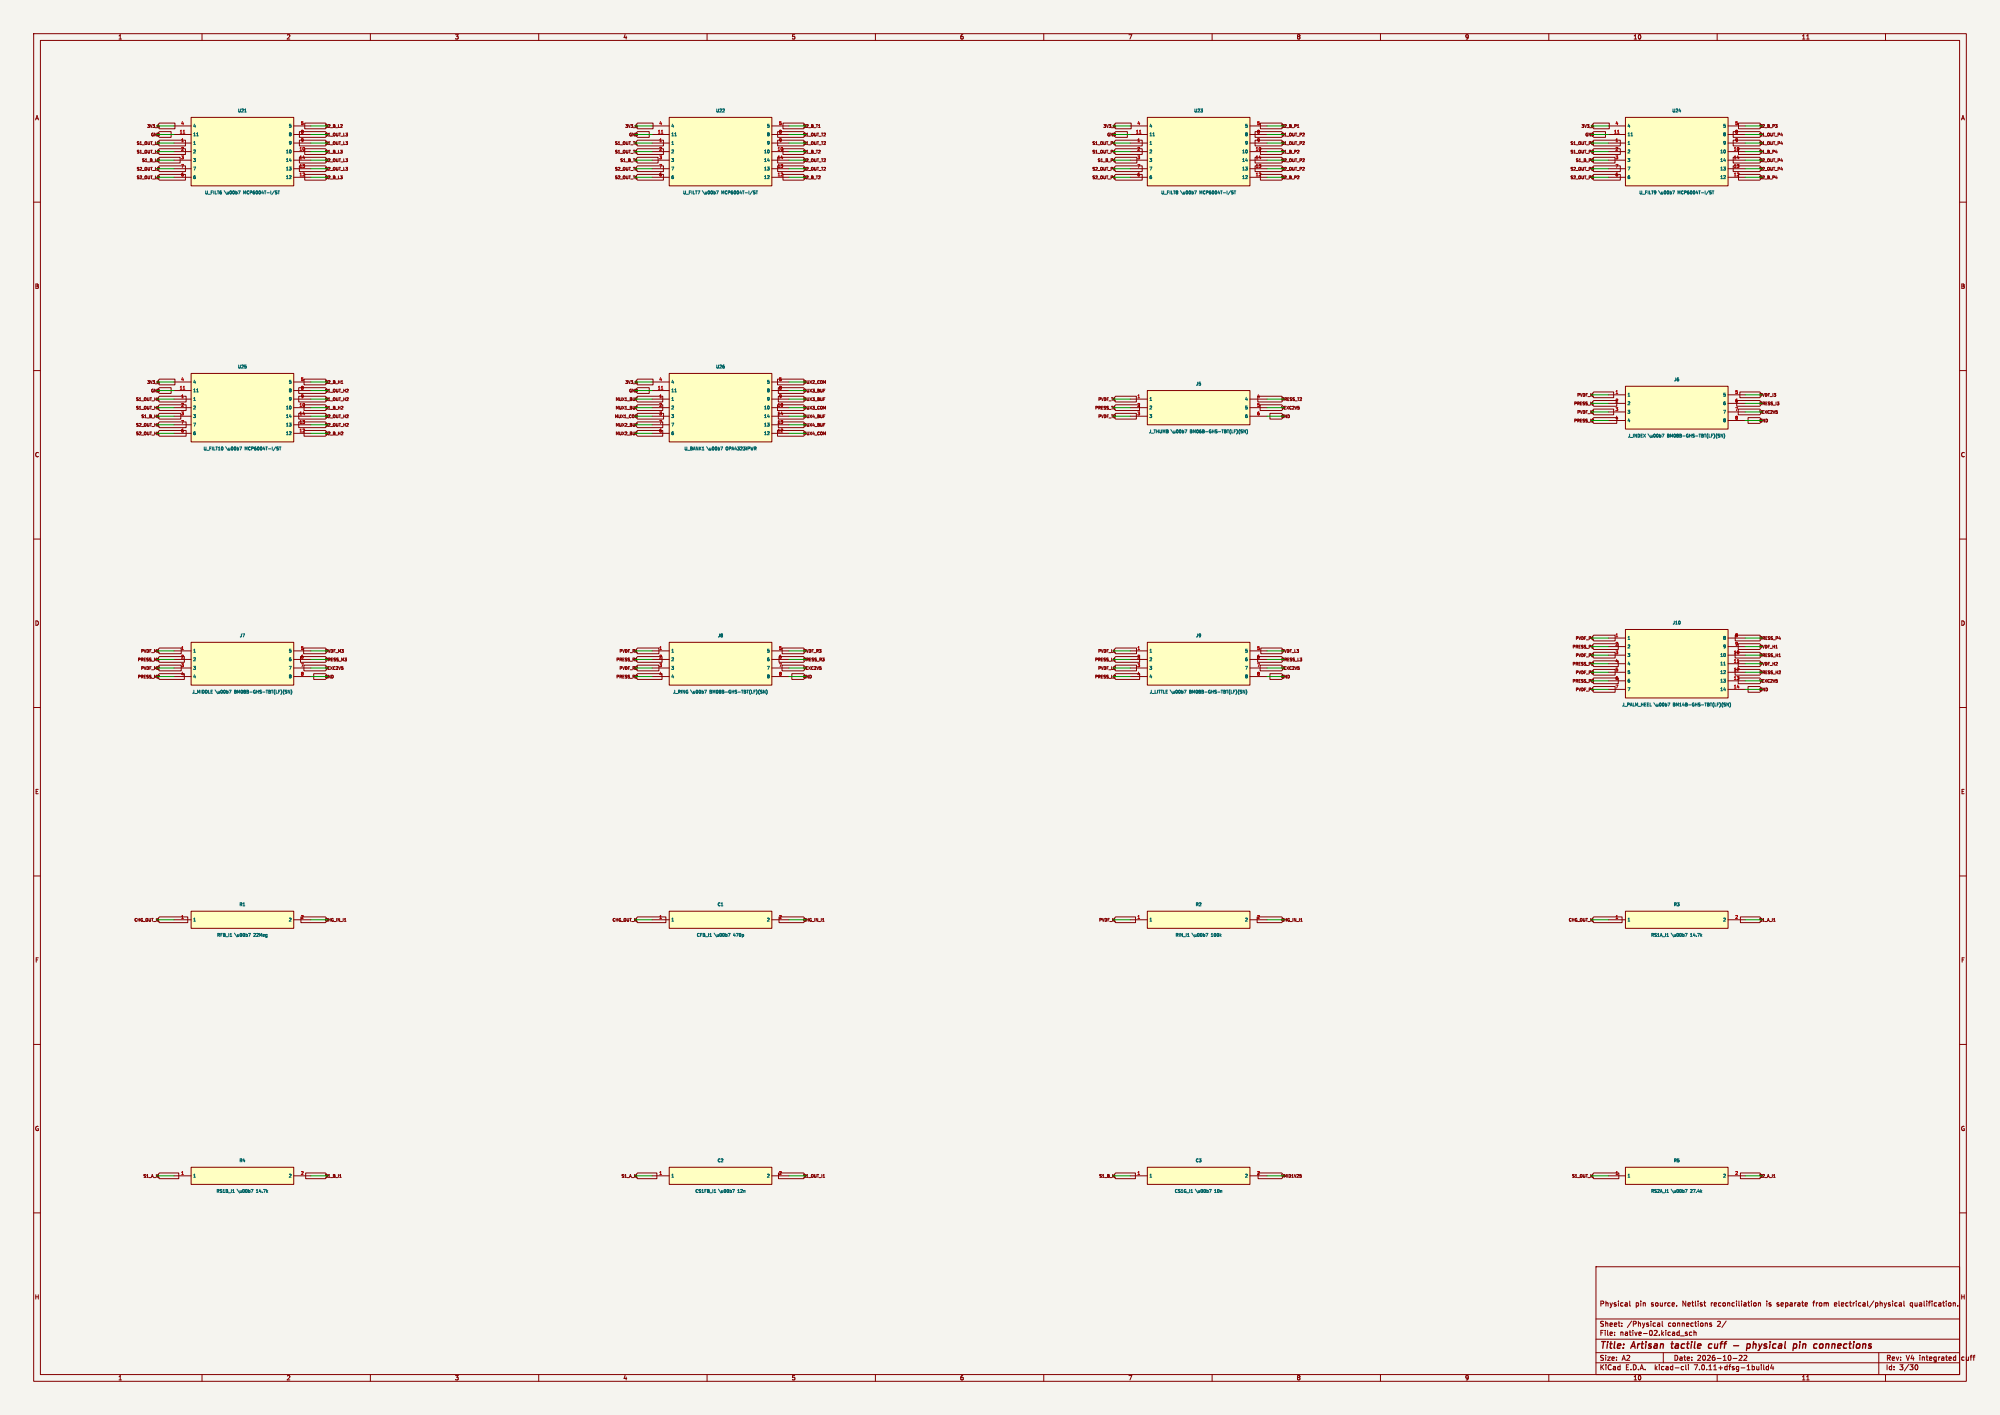
[picture p40: page 3]

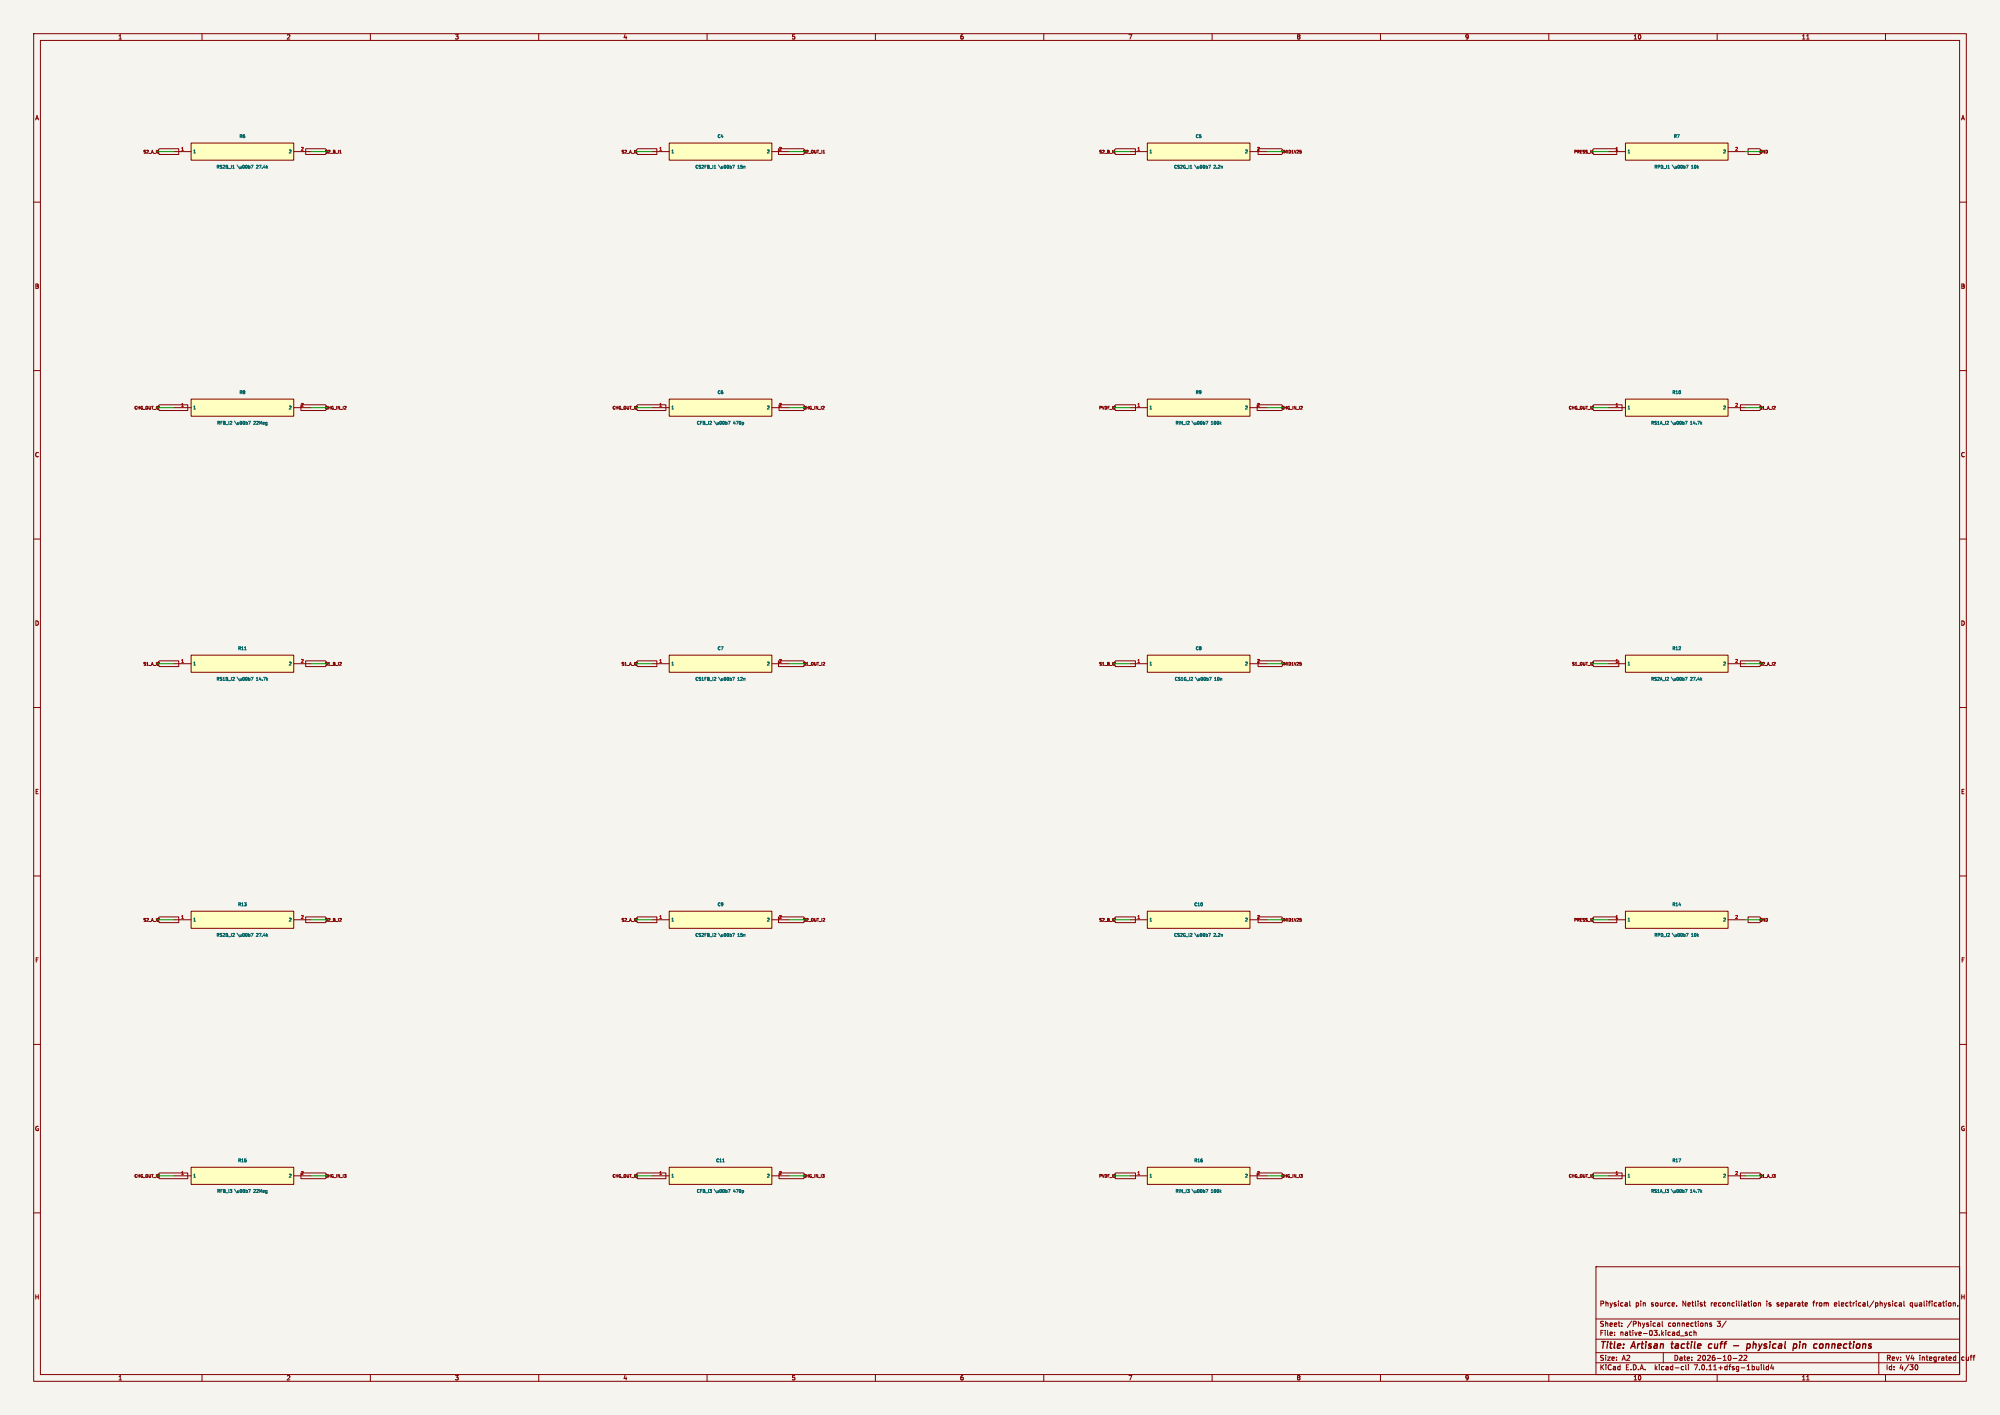
[picture p41: page 4]

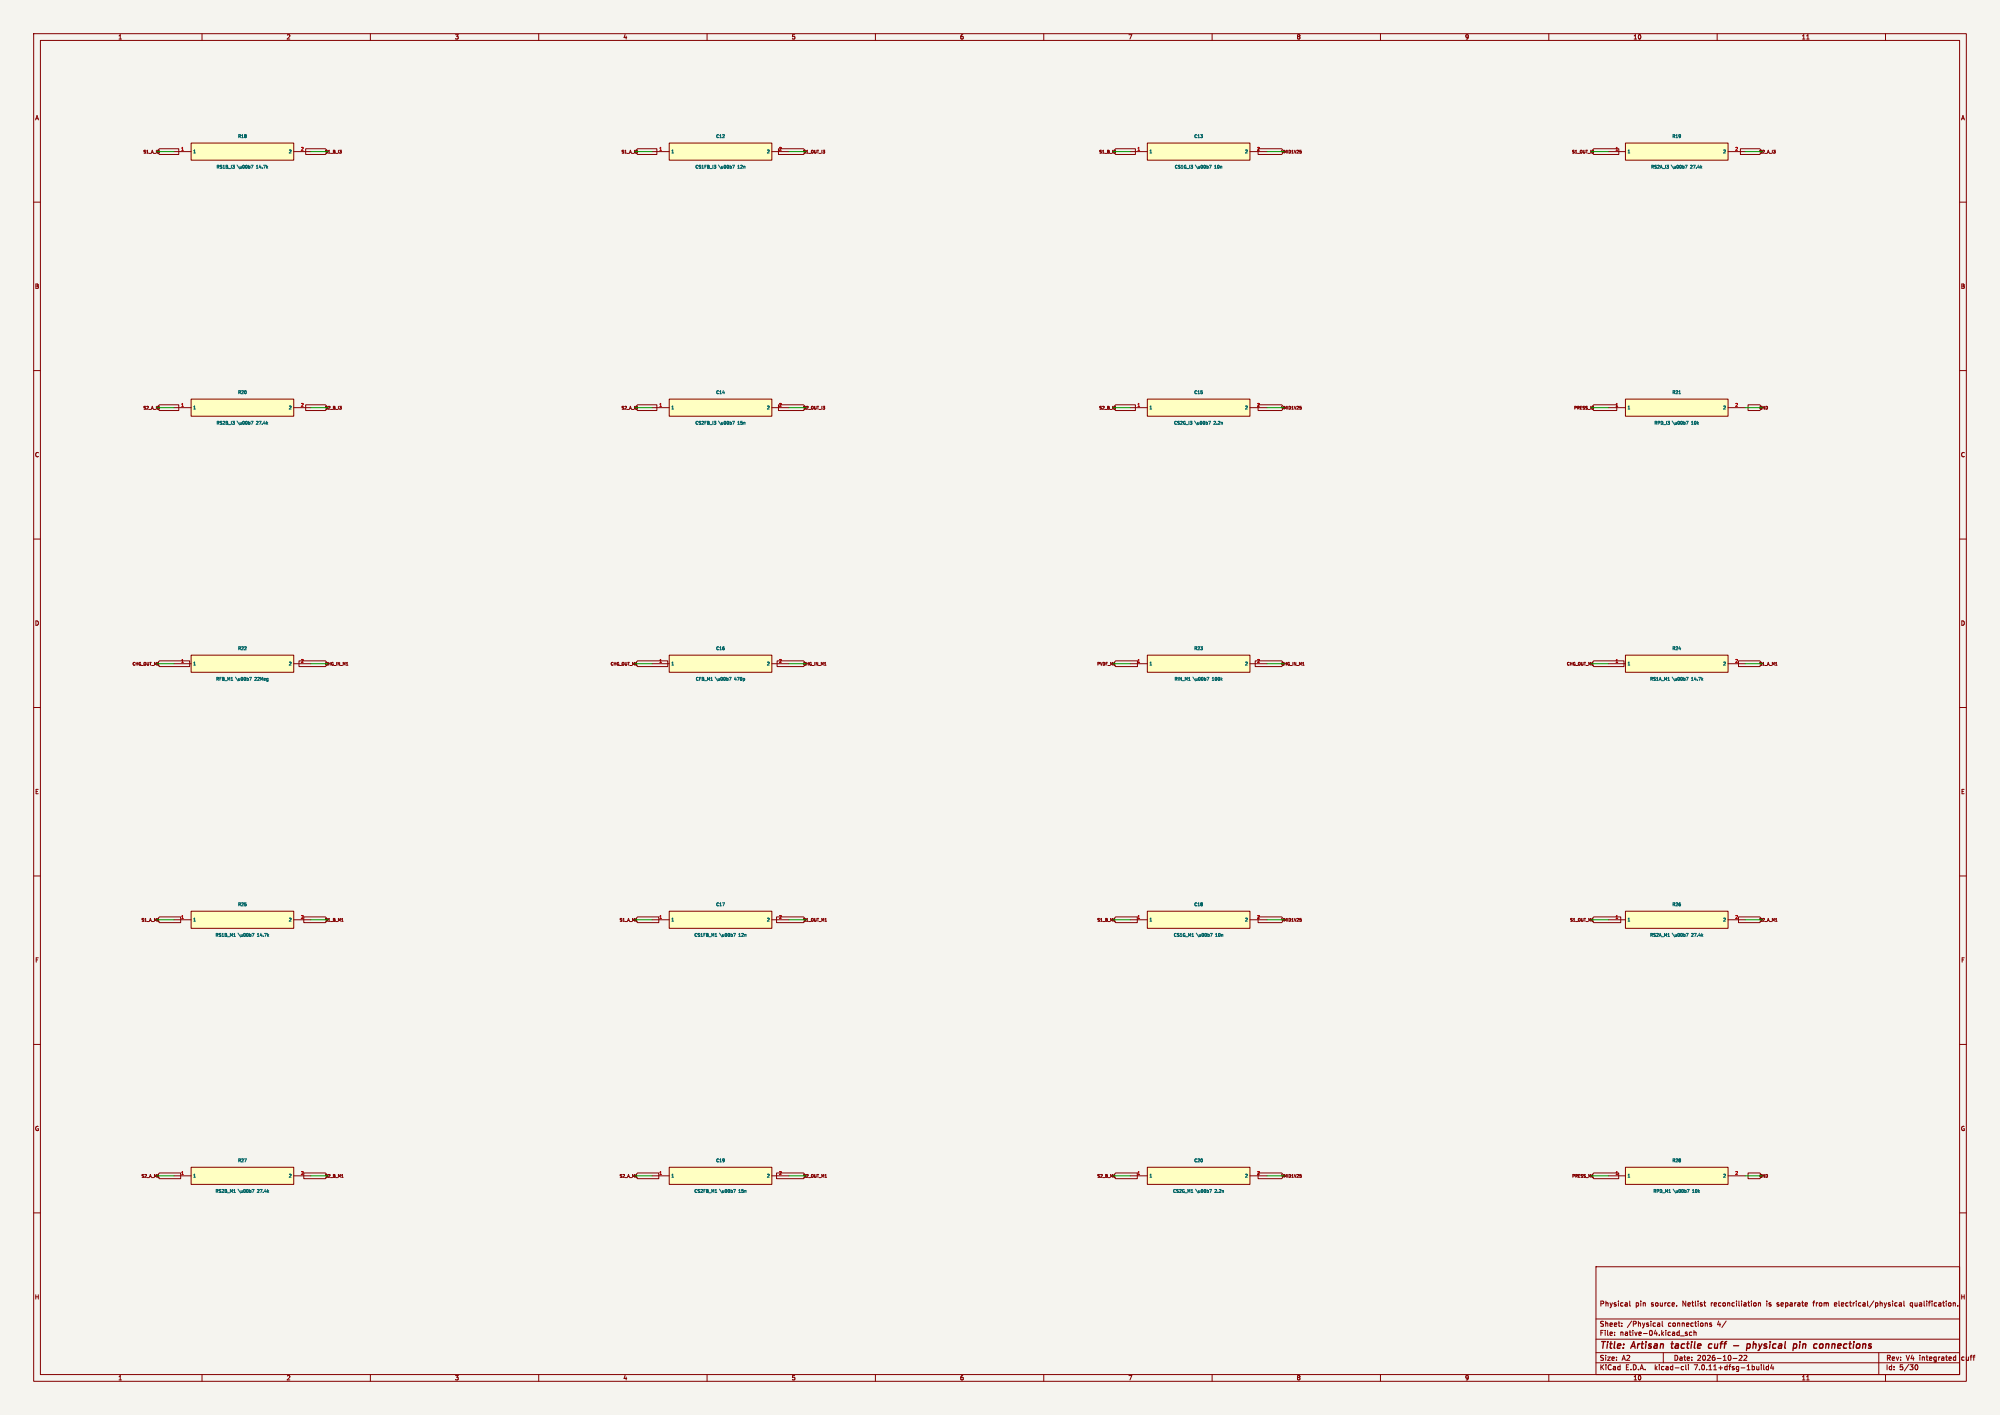
[picture p42: page 5]

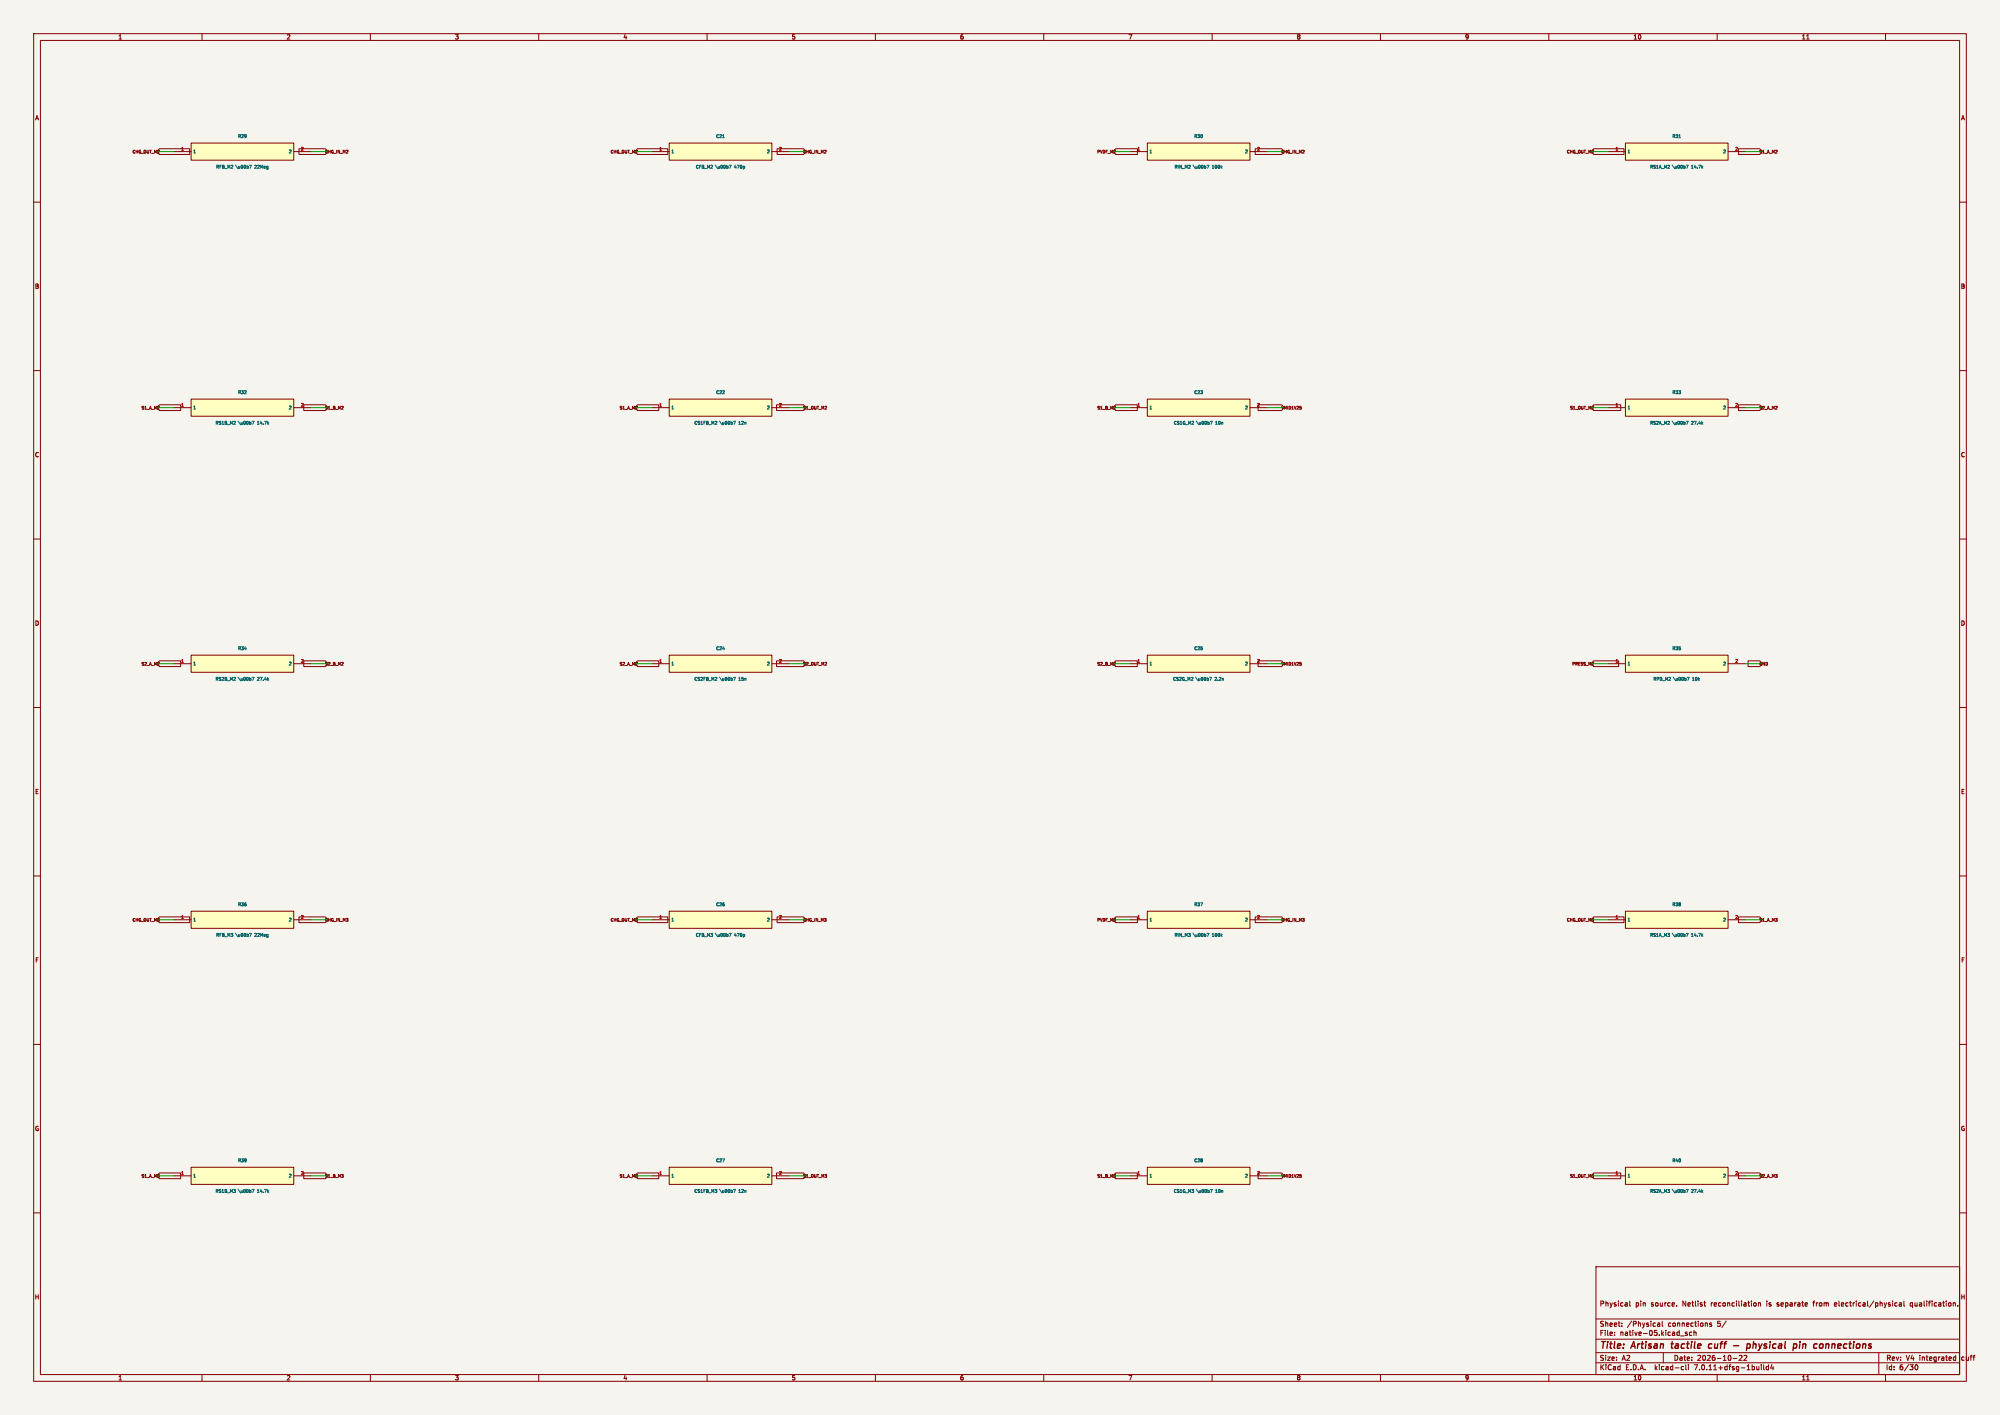
[picture p43: page 6]

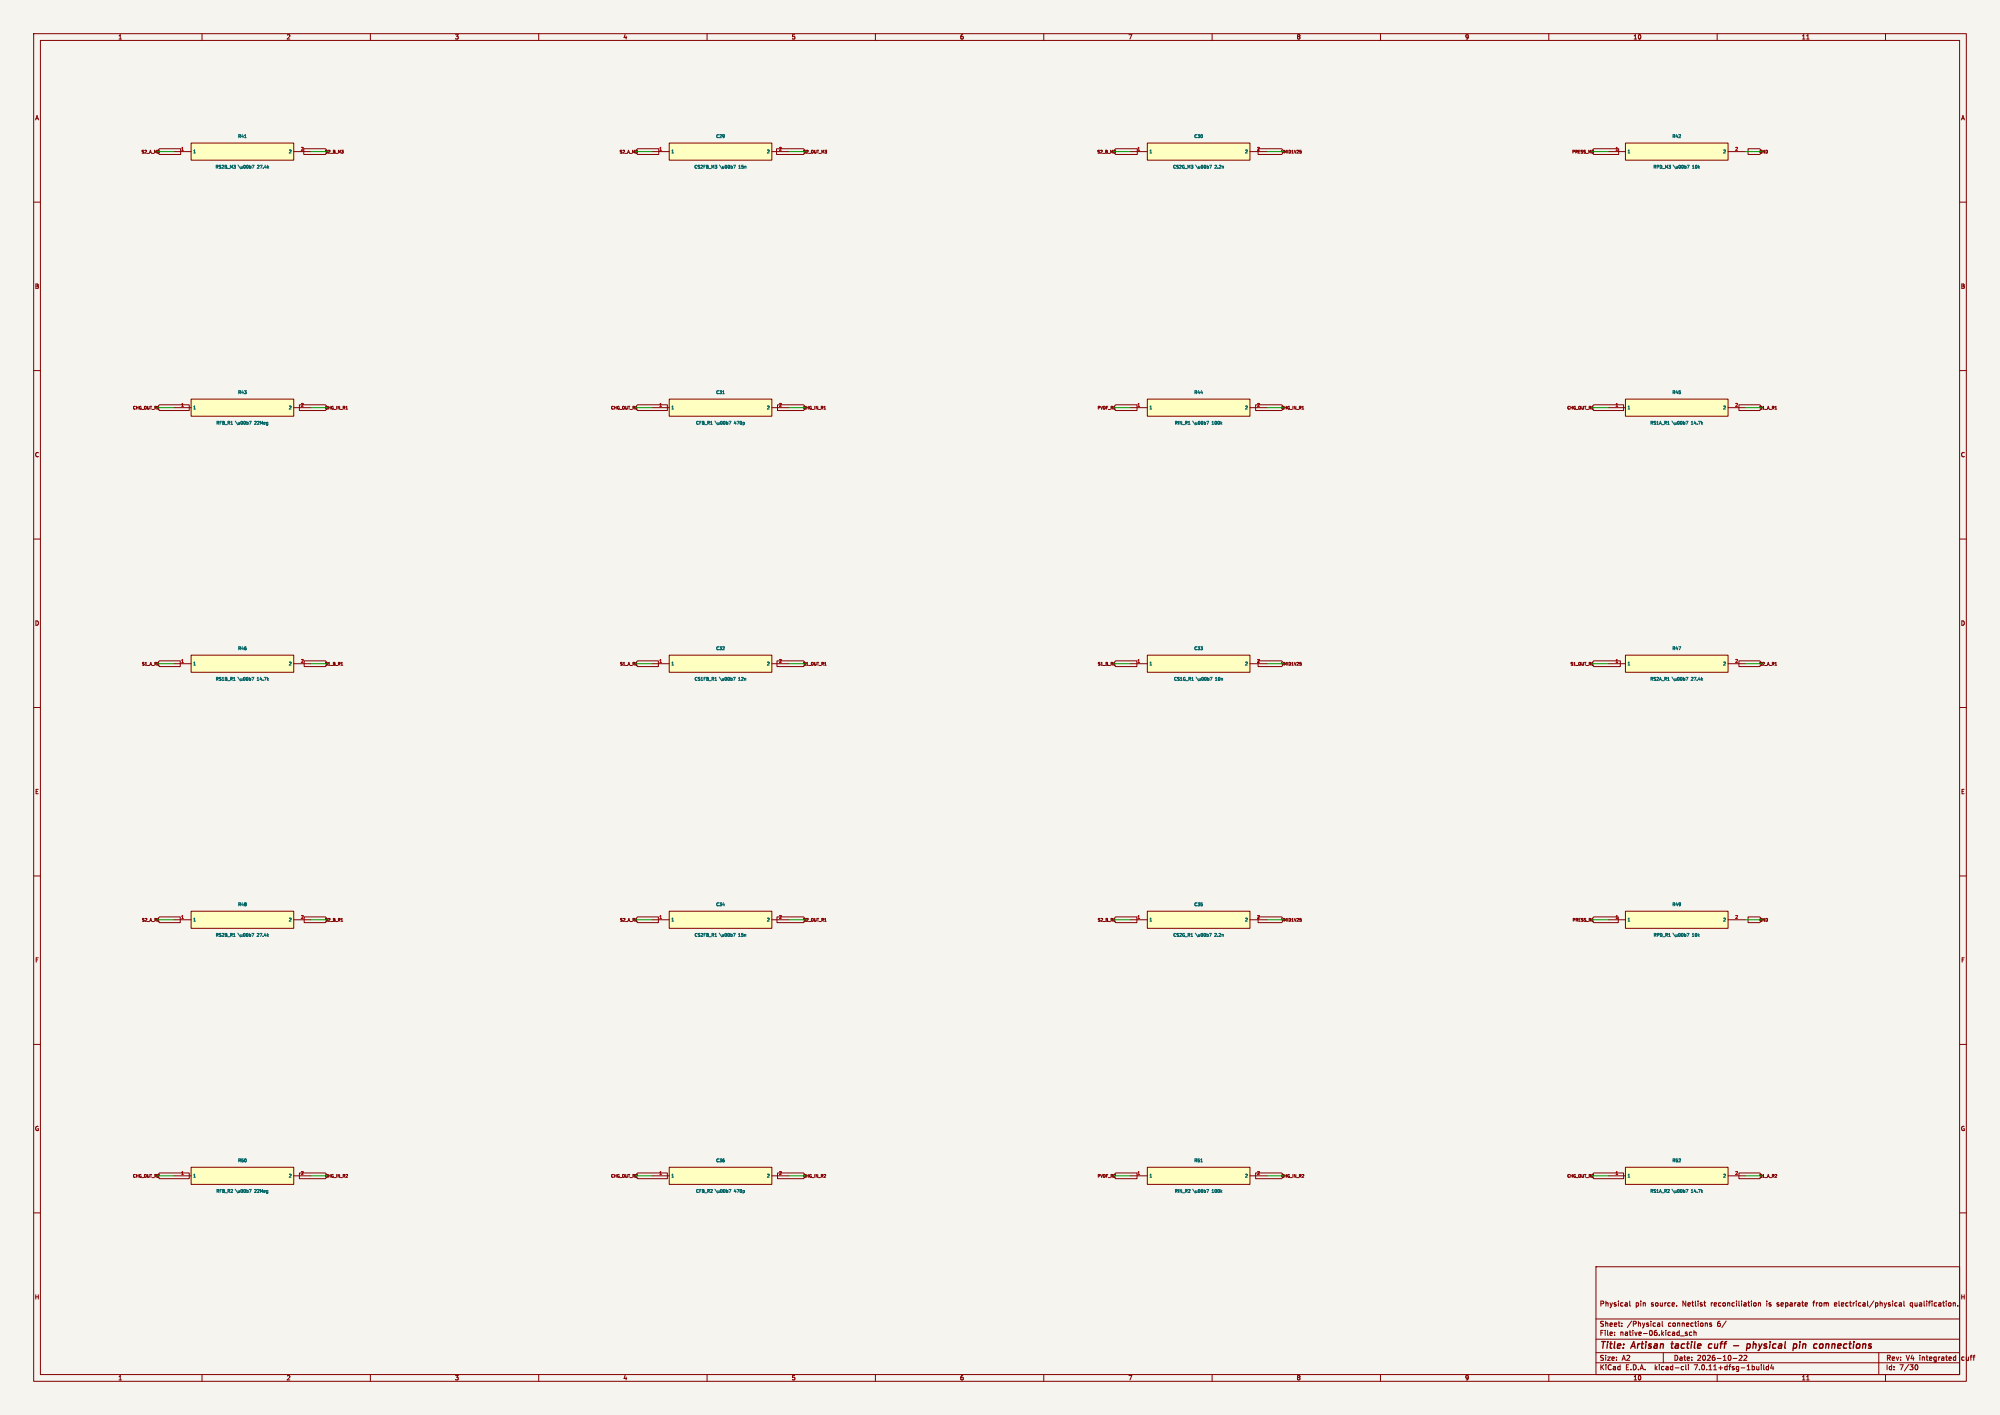
[picture p44: page 7]

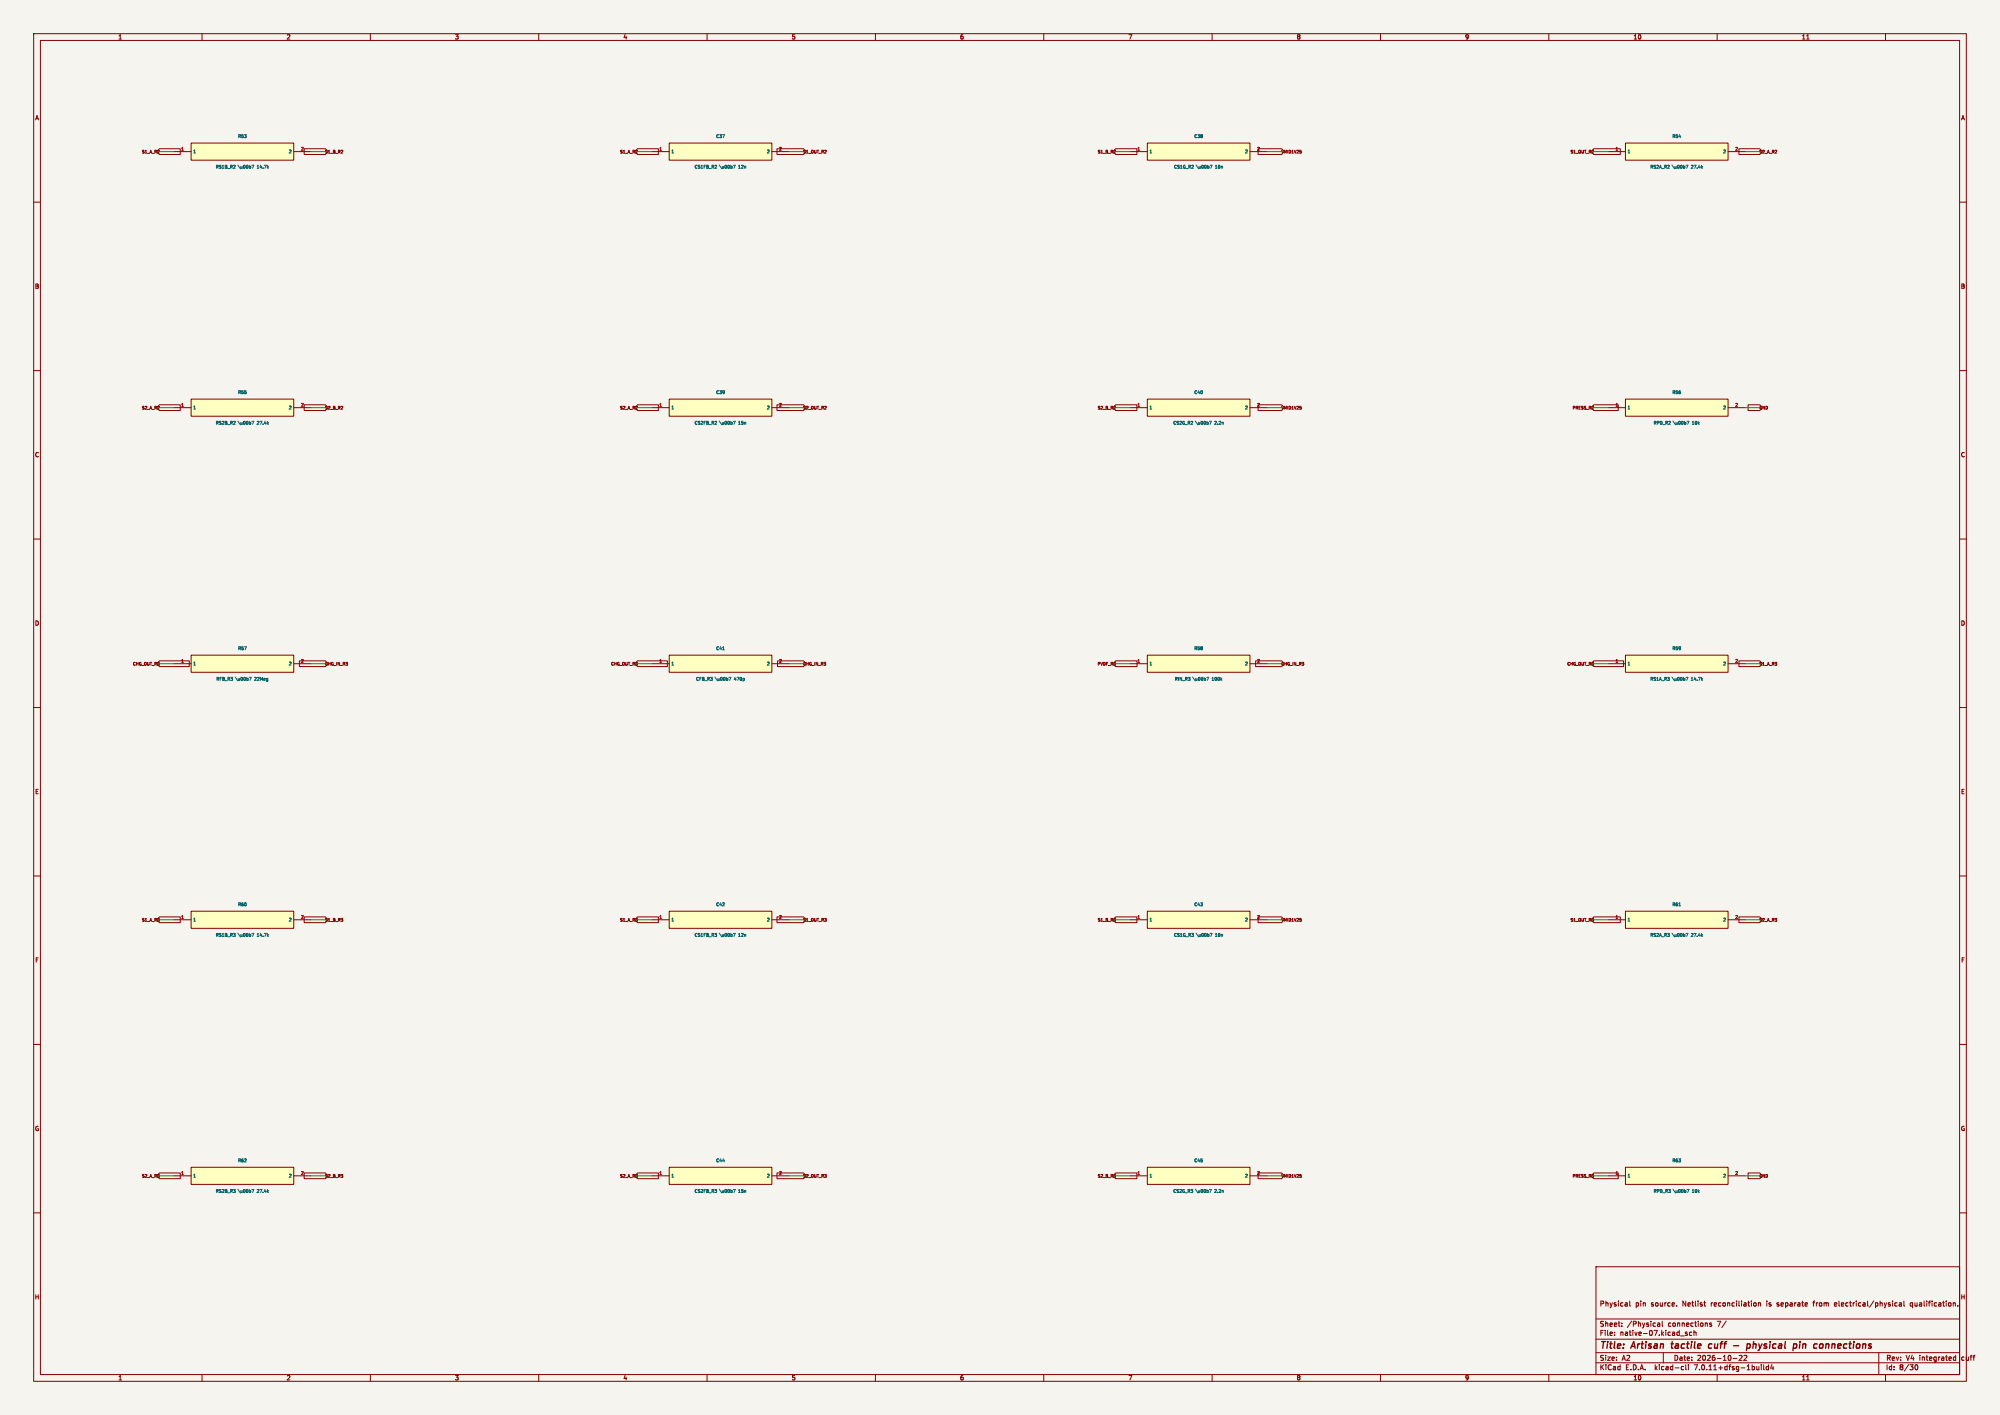
[picture p45: page 8]

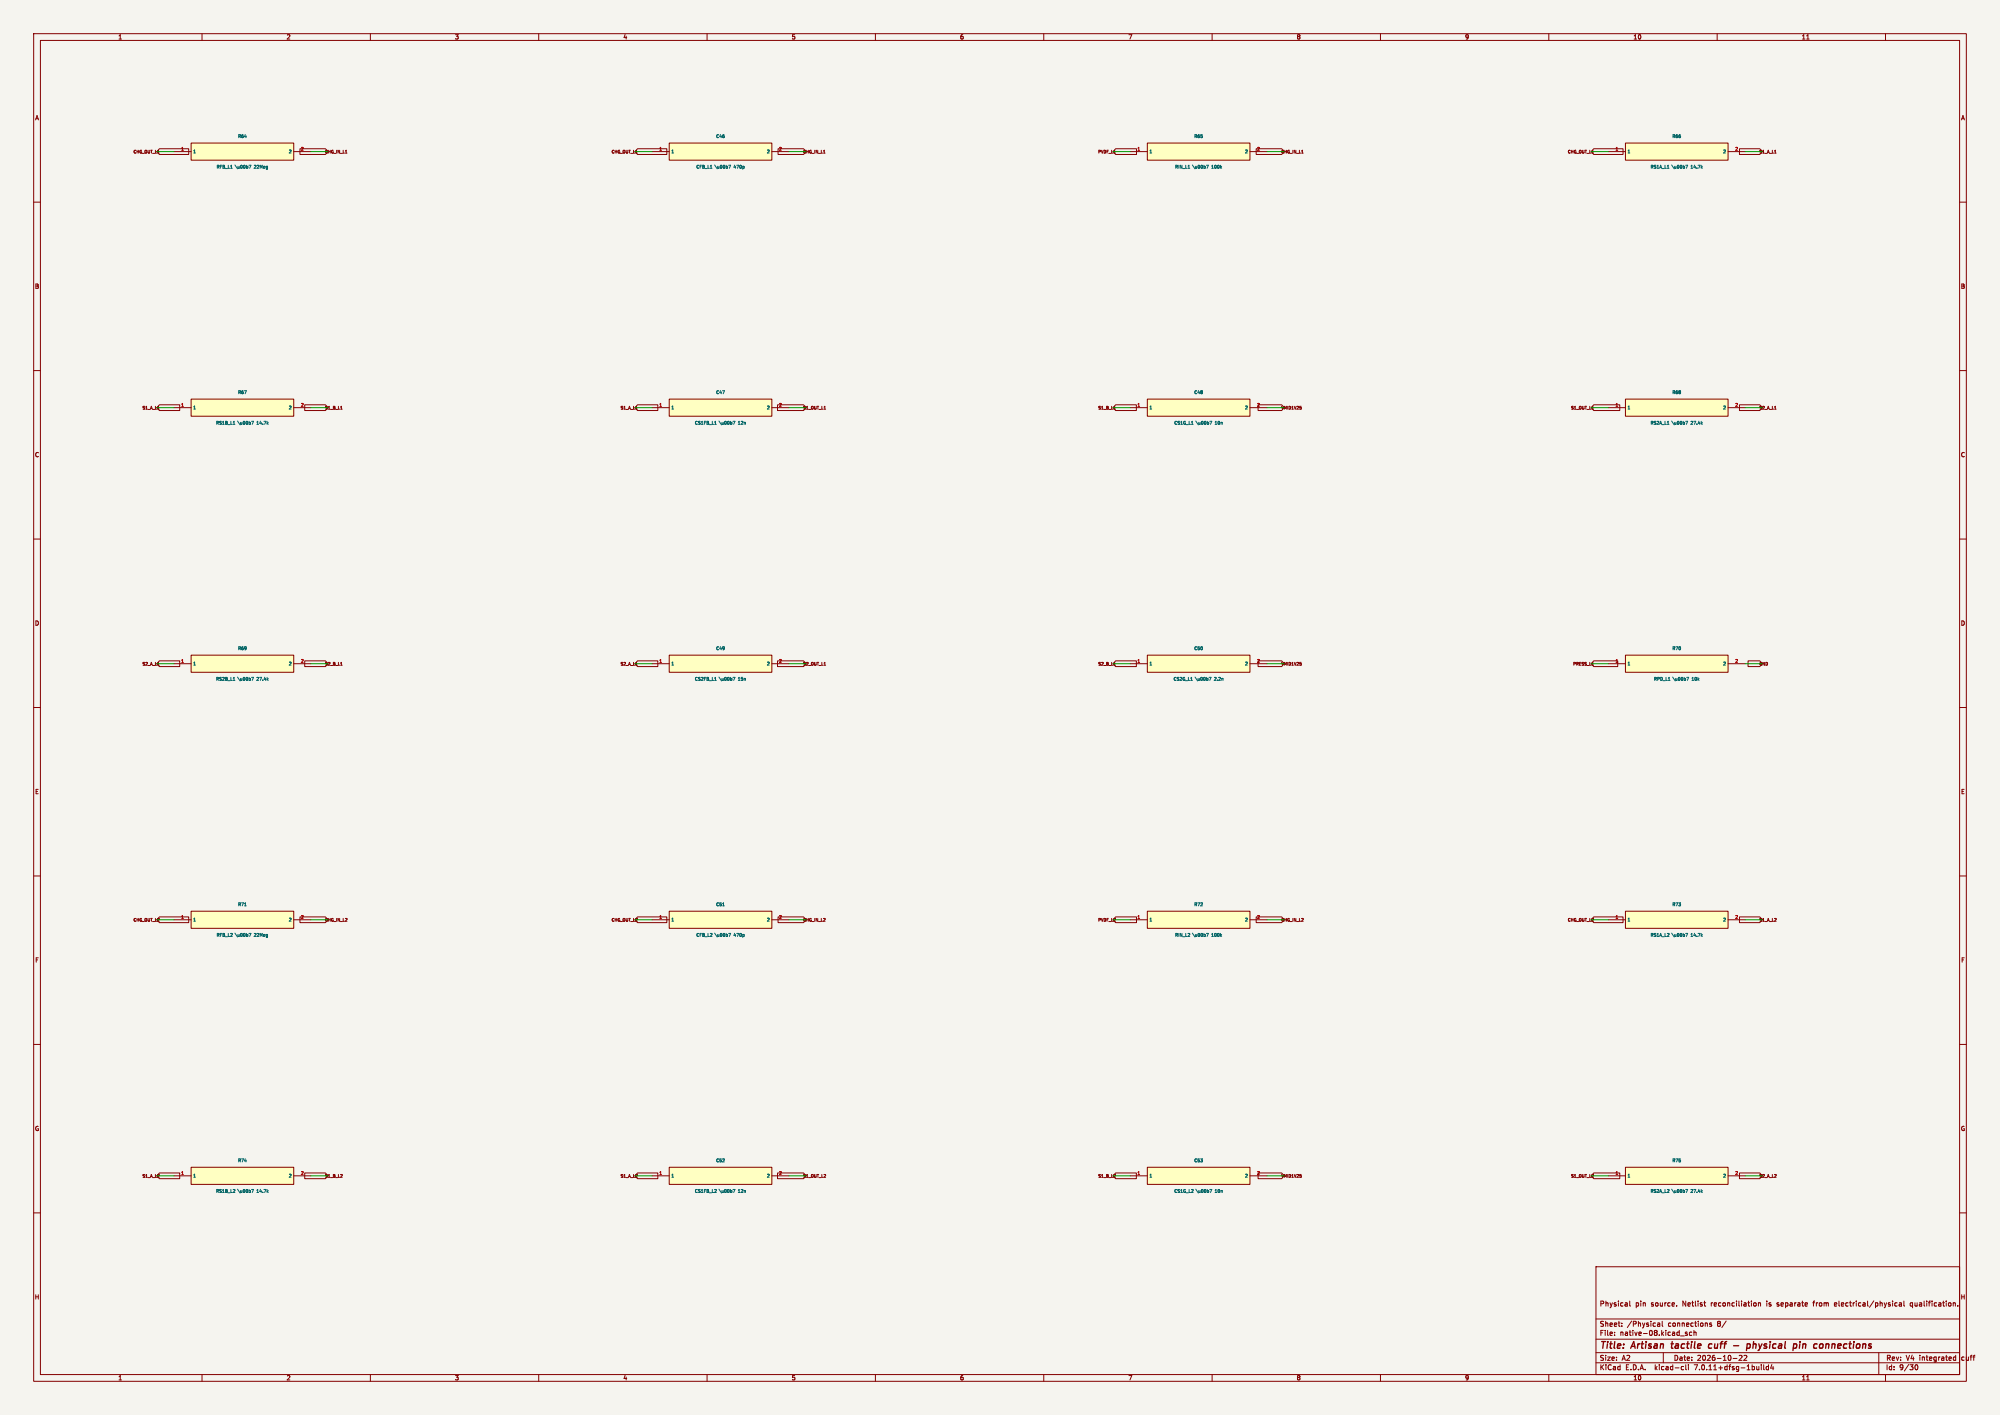
[picture p46: page 9]

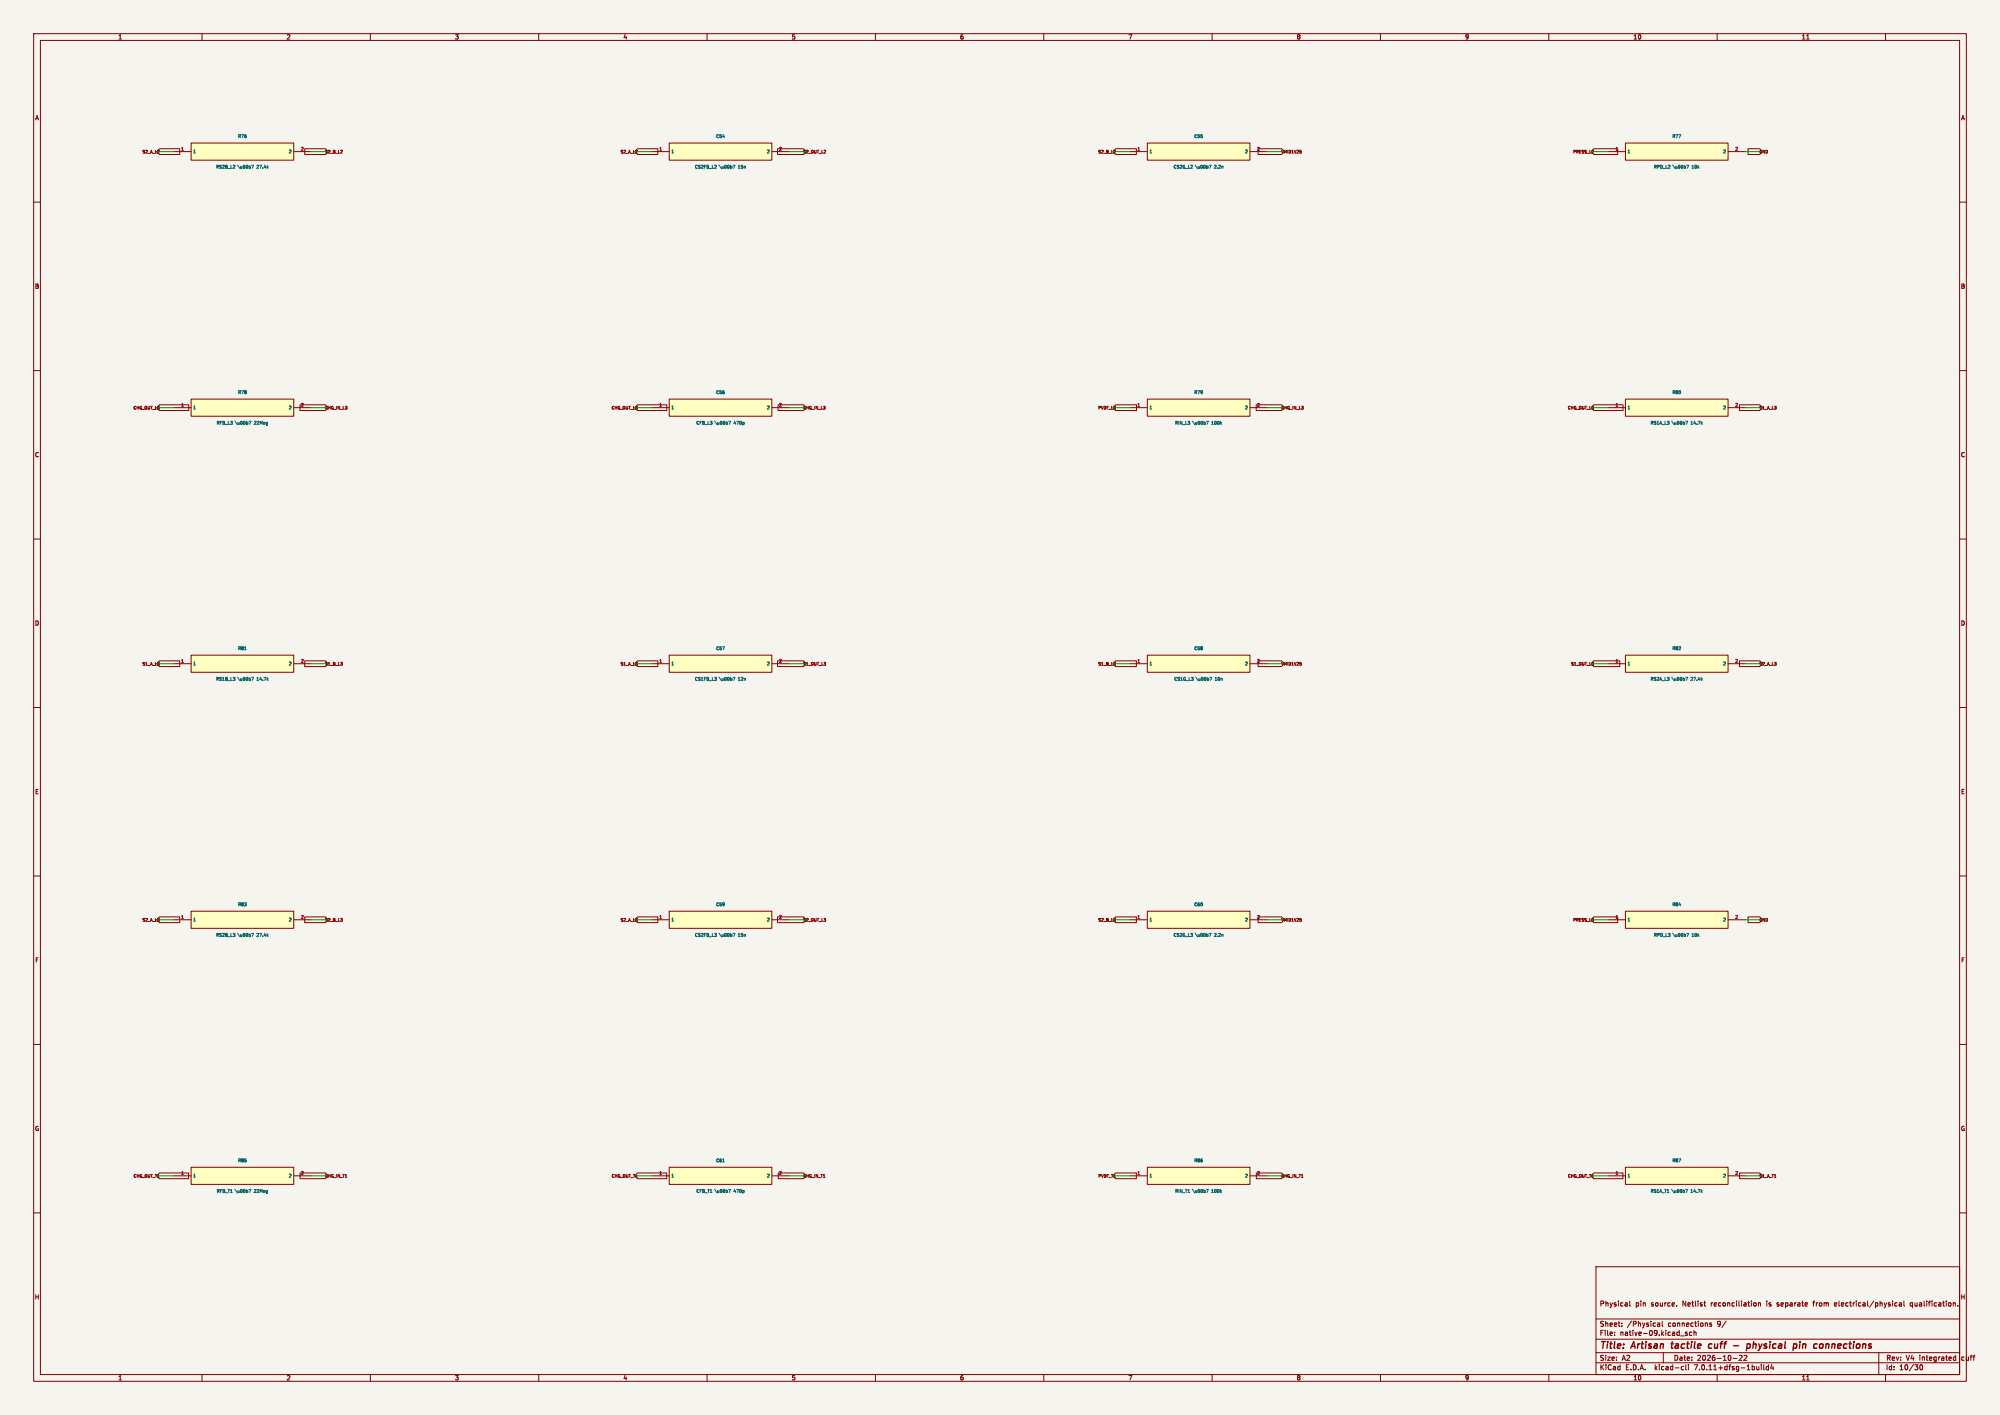
[picture p47: page 10]

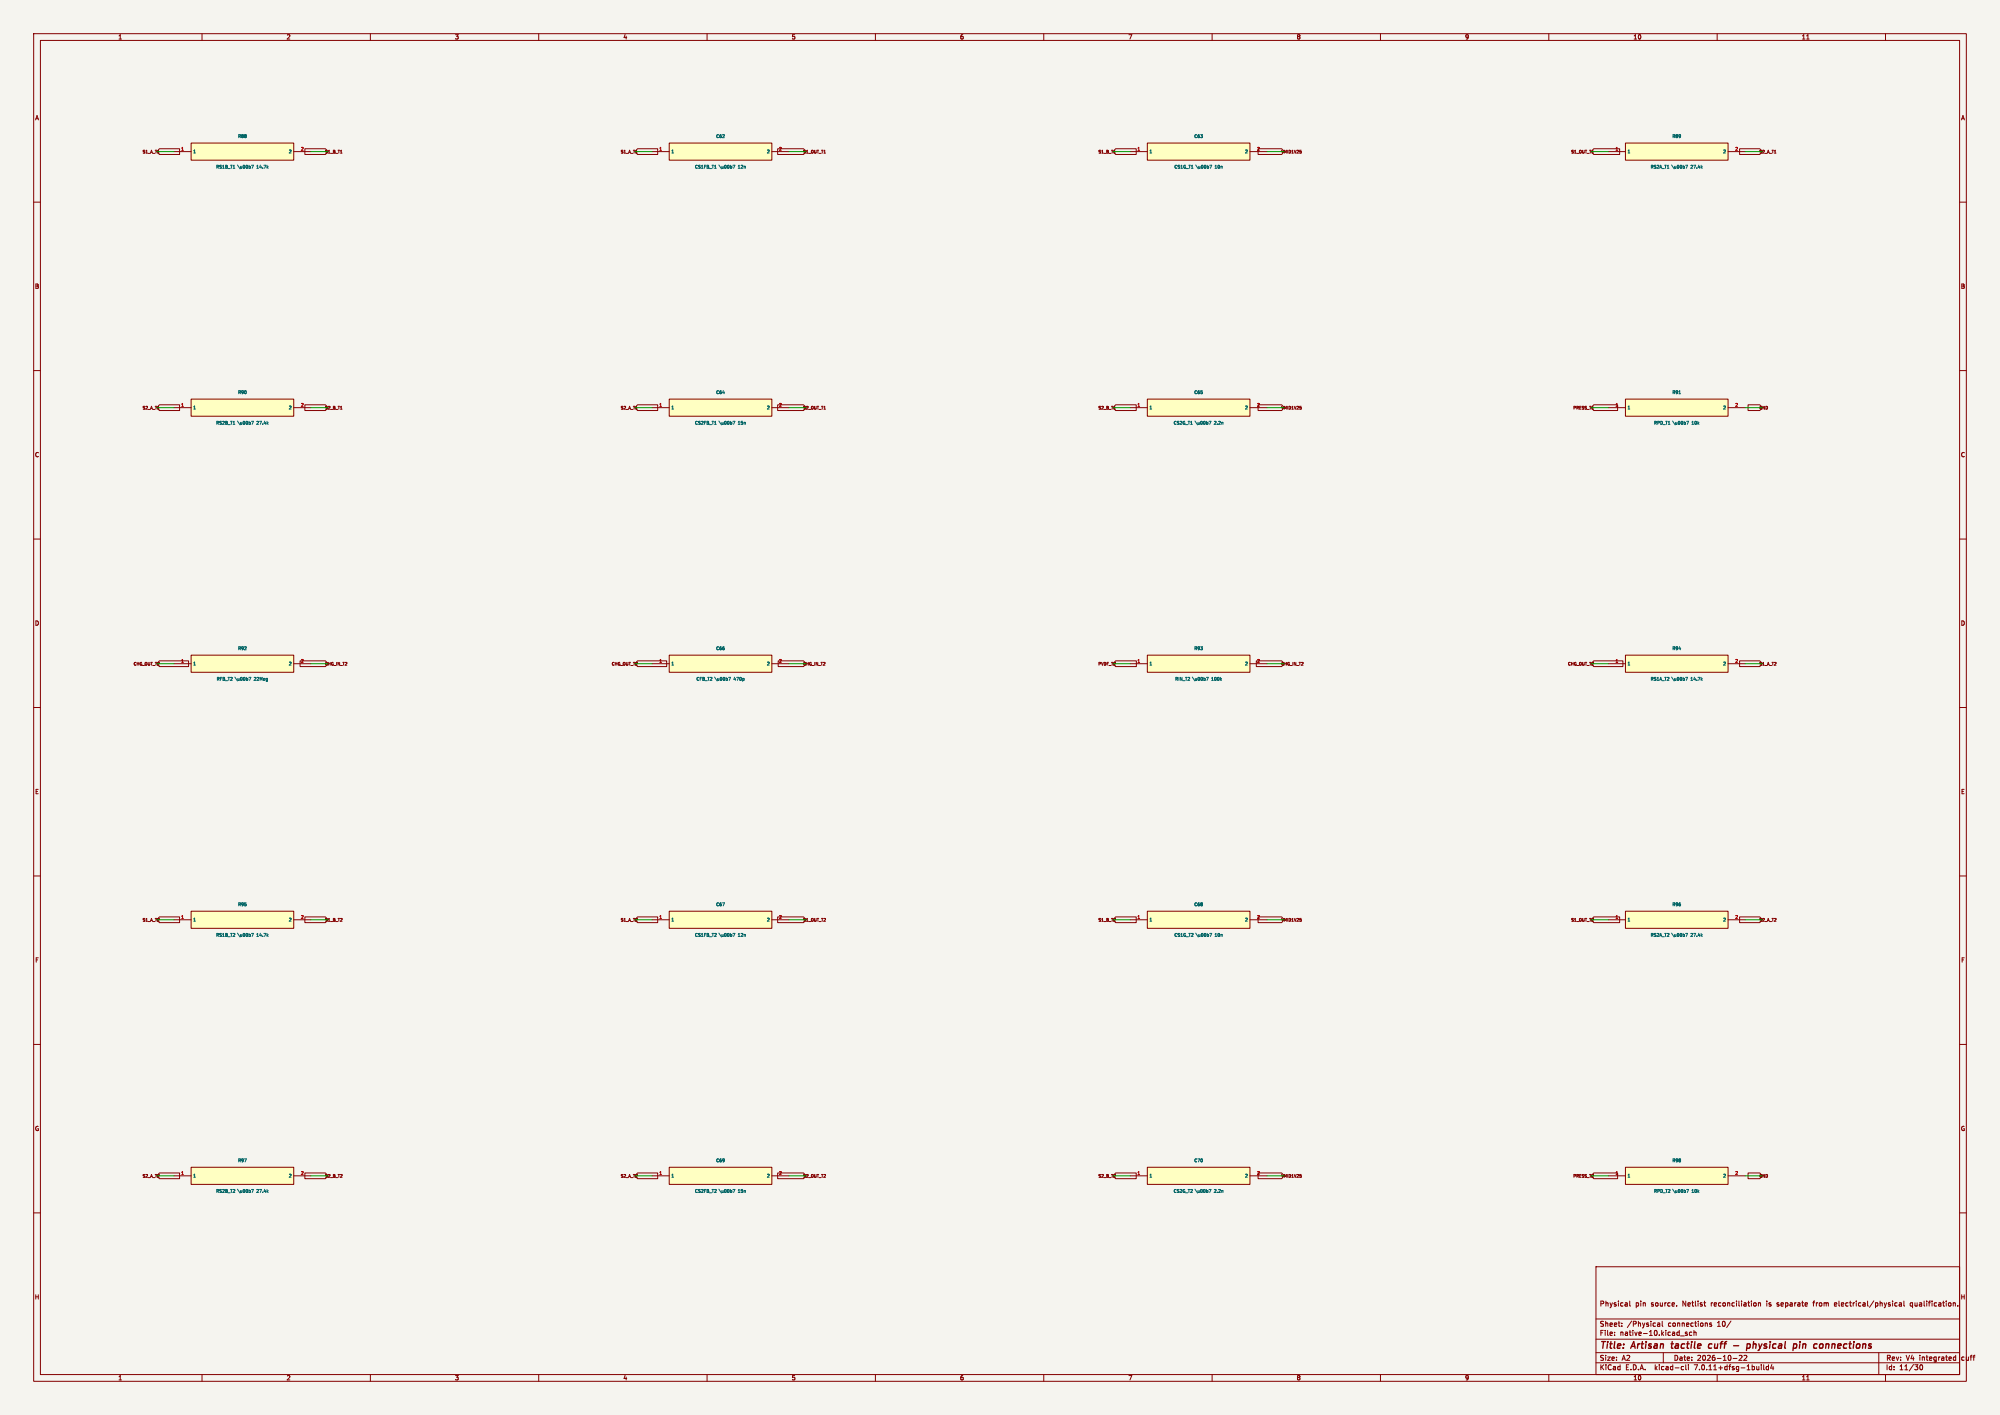
[picture p48: page 11]

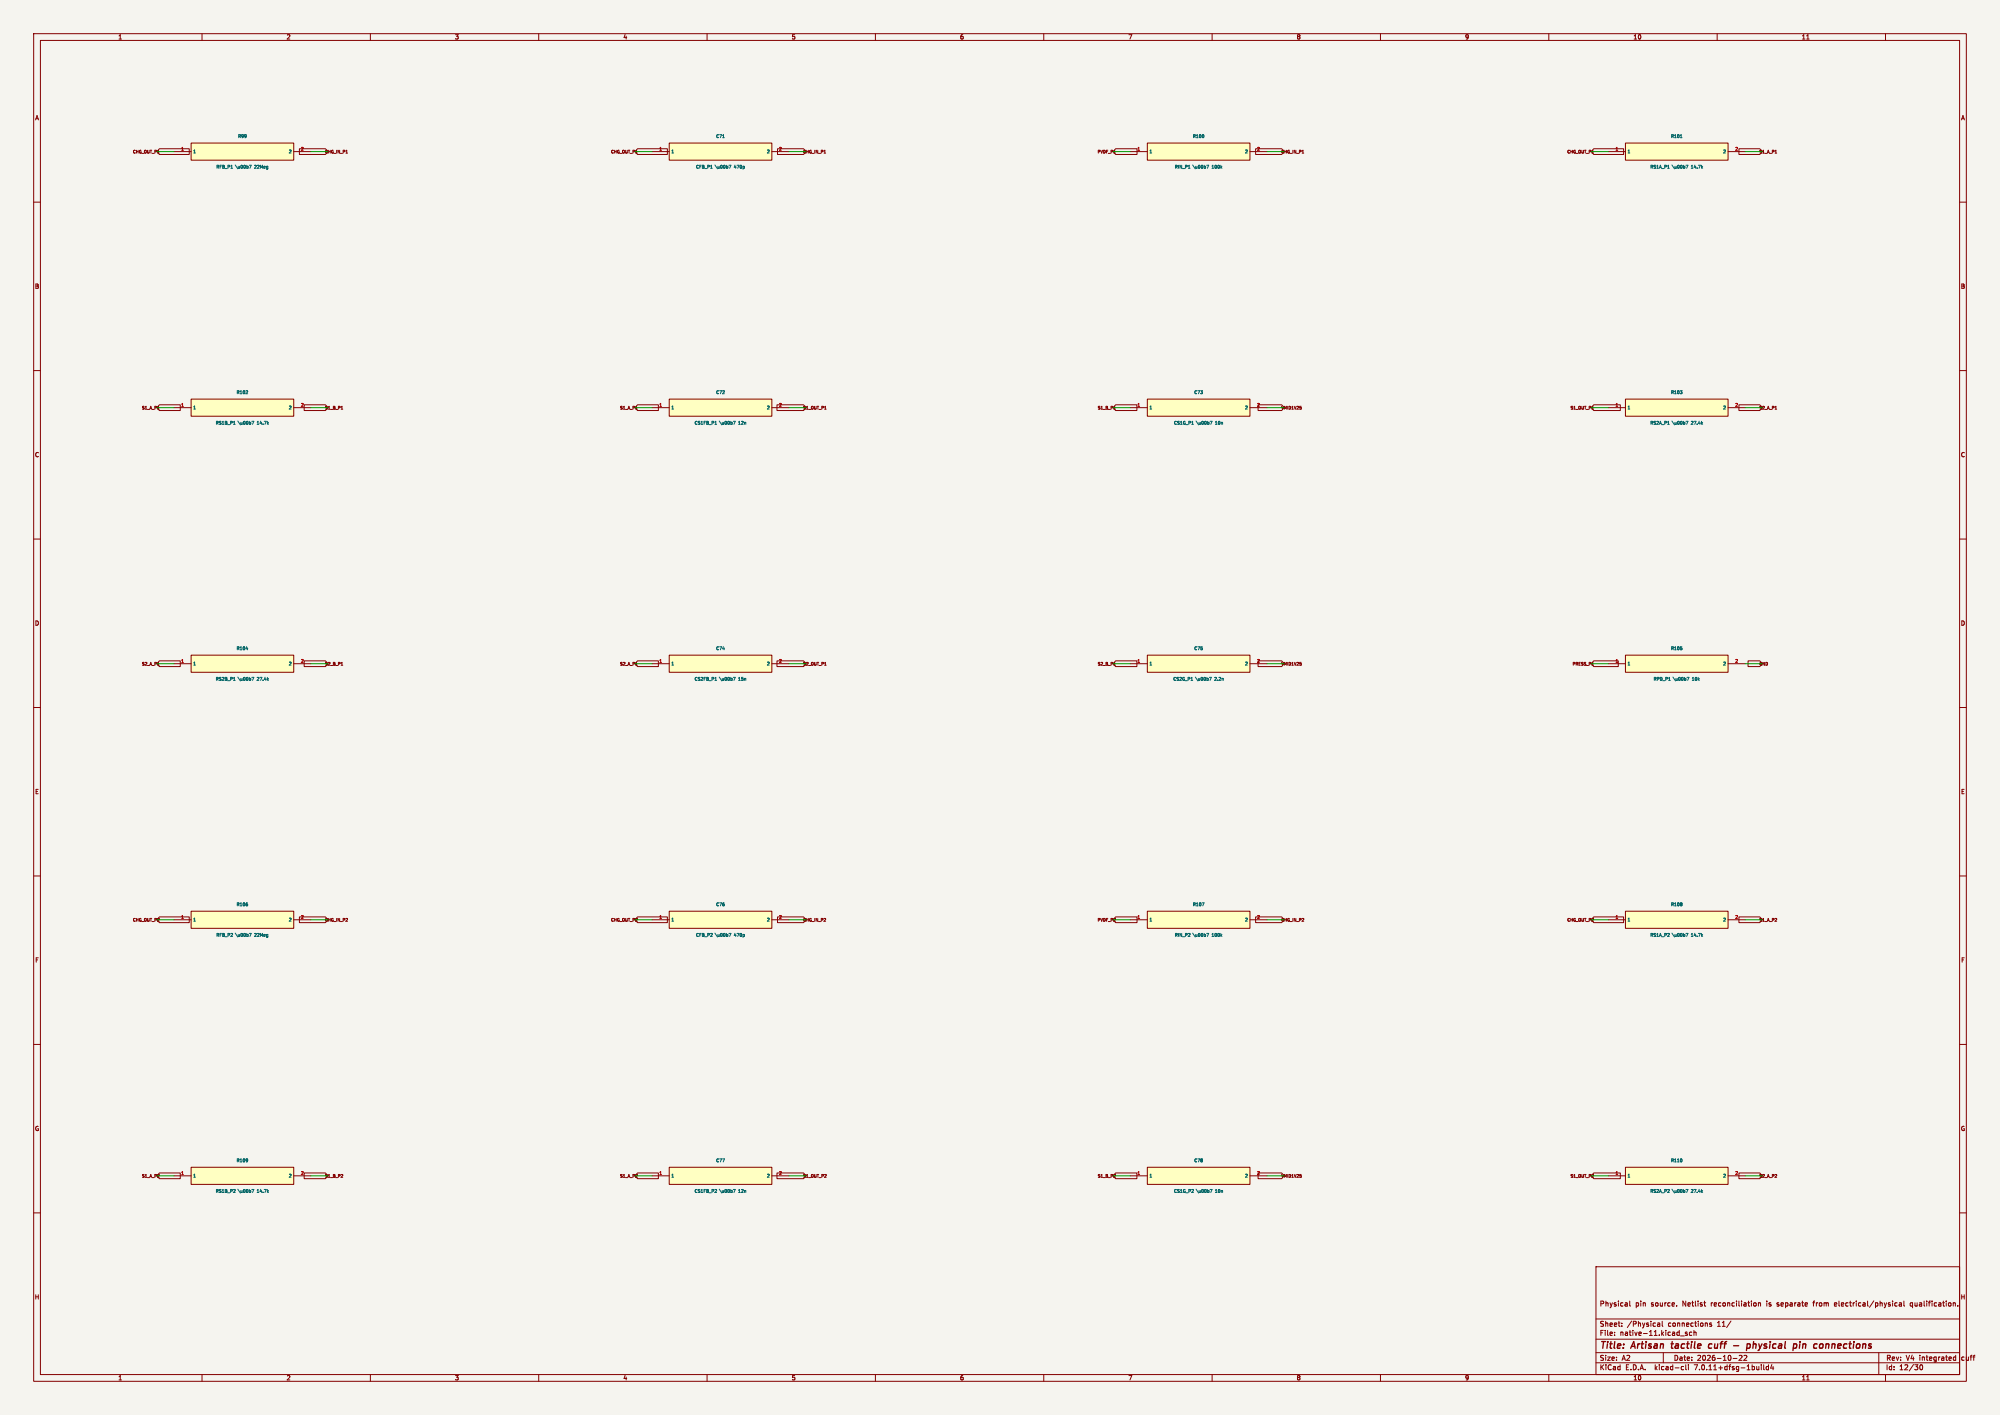
[picture p49: page 12]

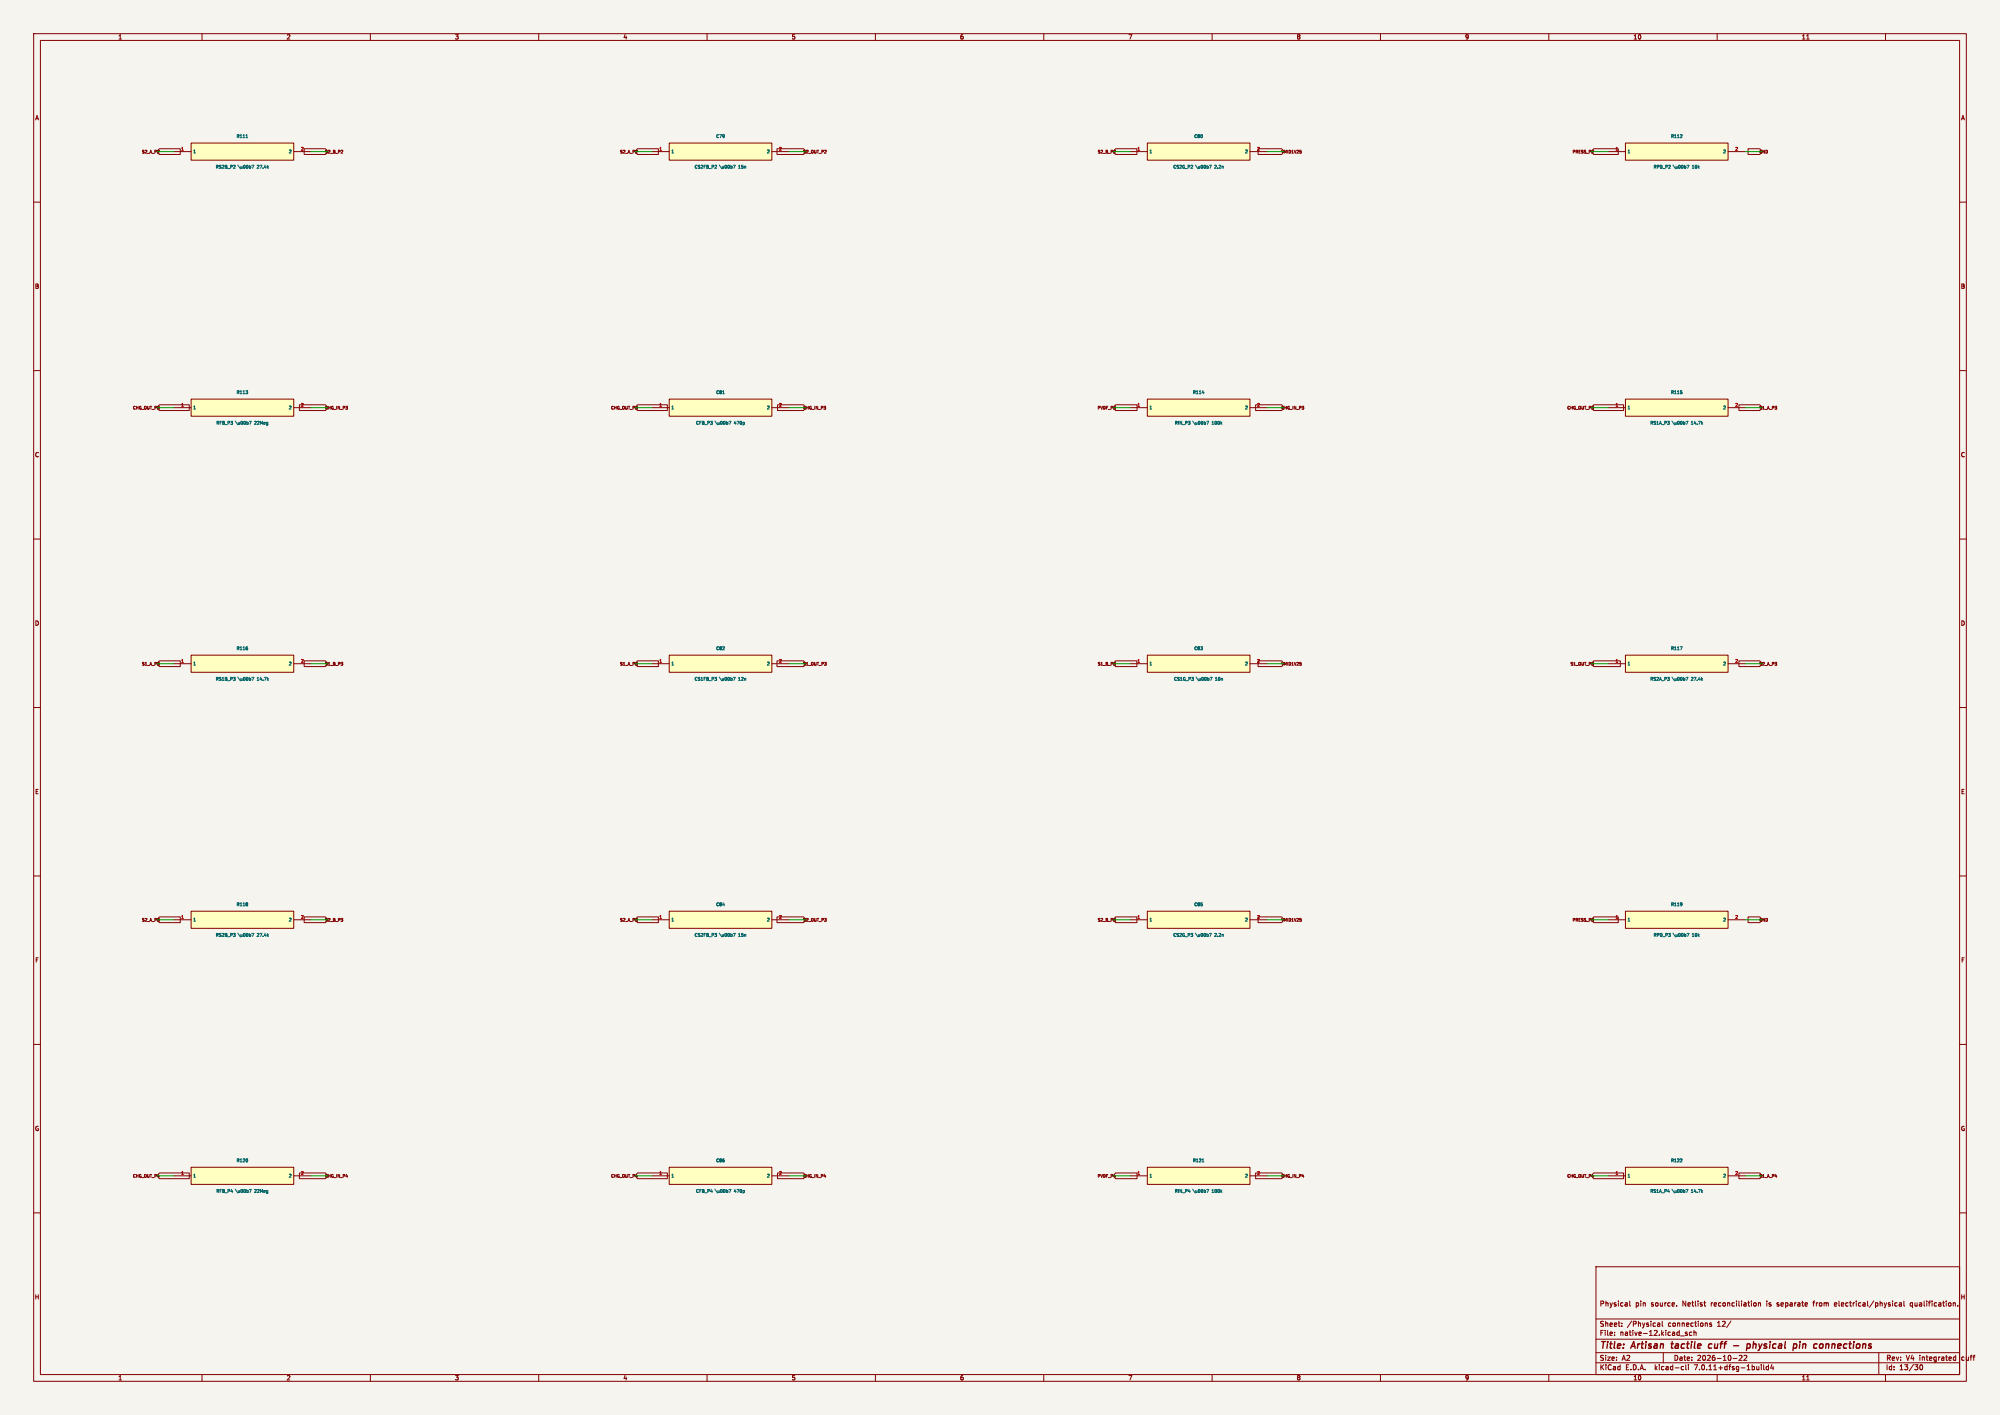
[picture p50: page 13]

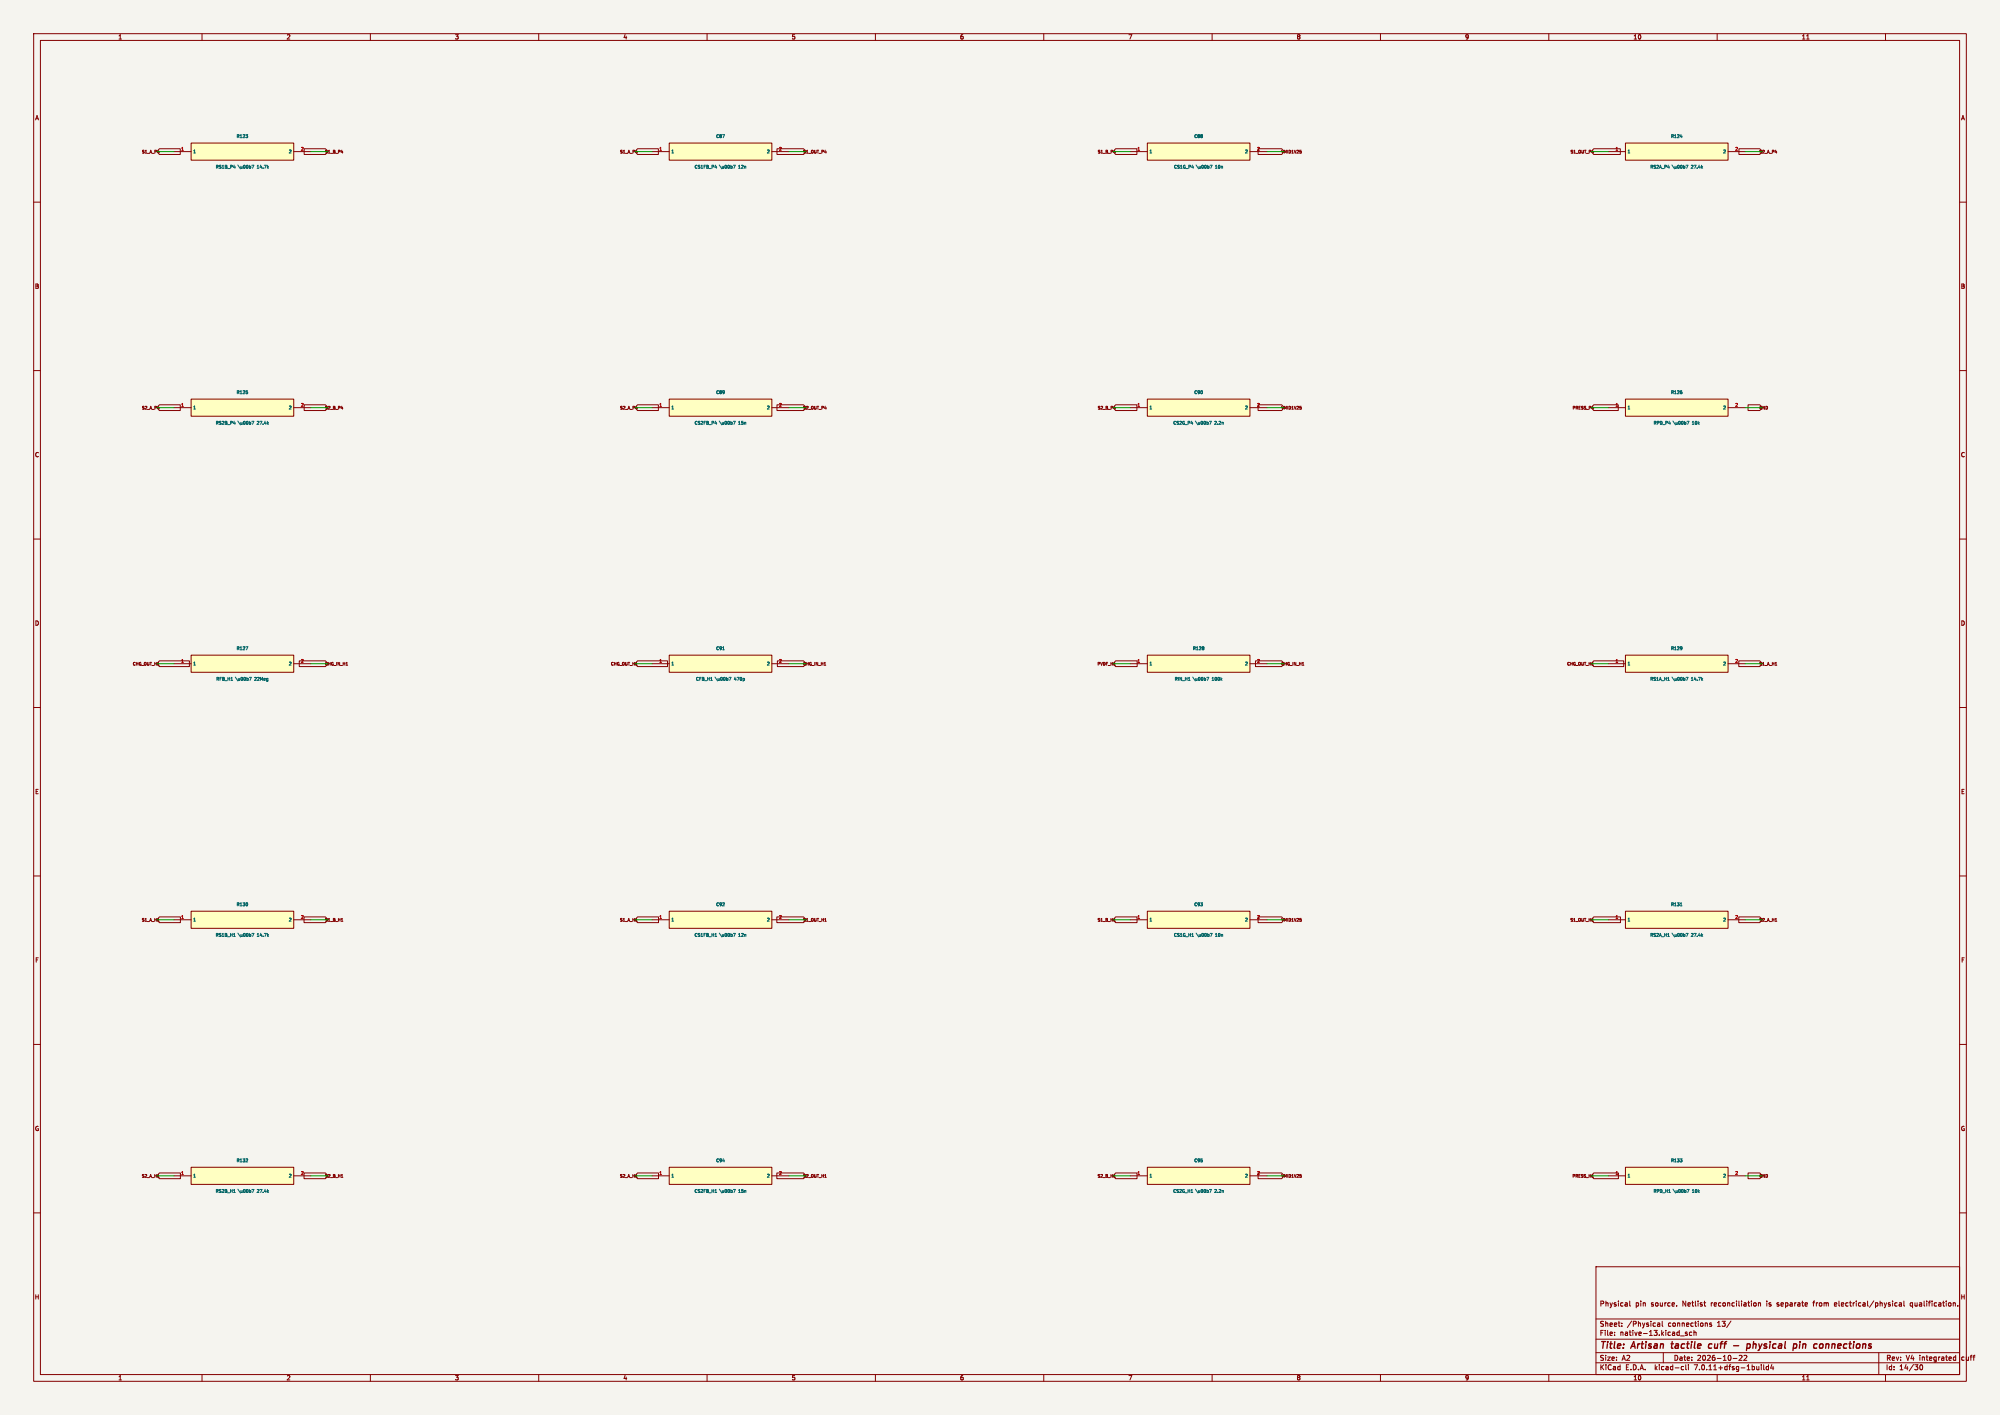
[picture p51: page 14]

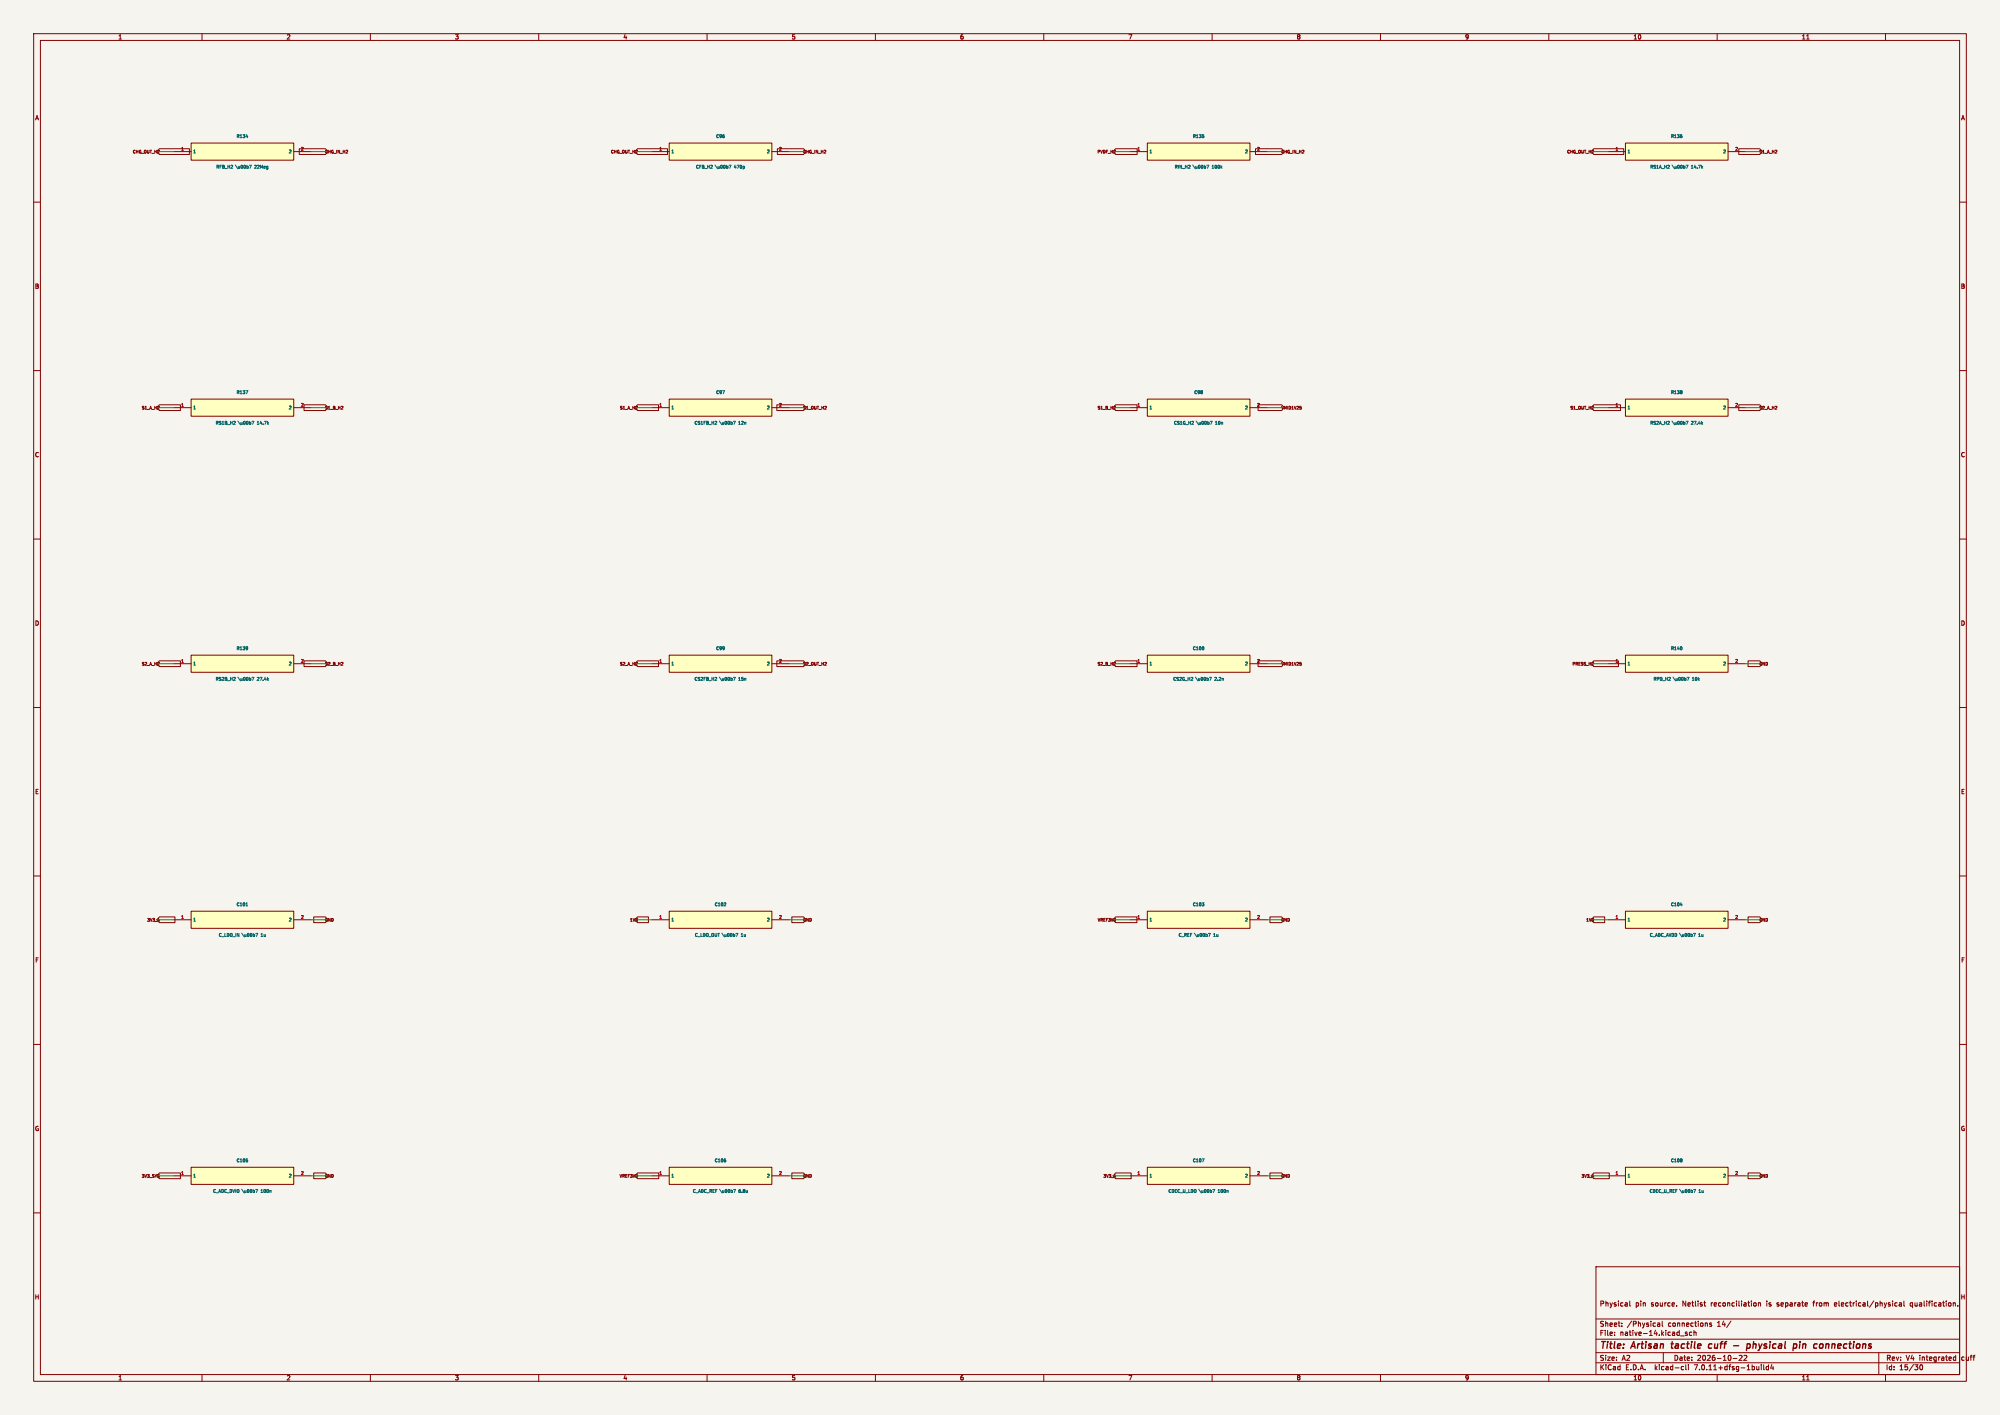
[picture p52: page 15]

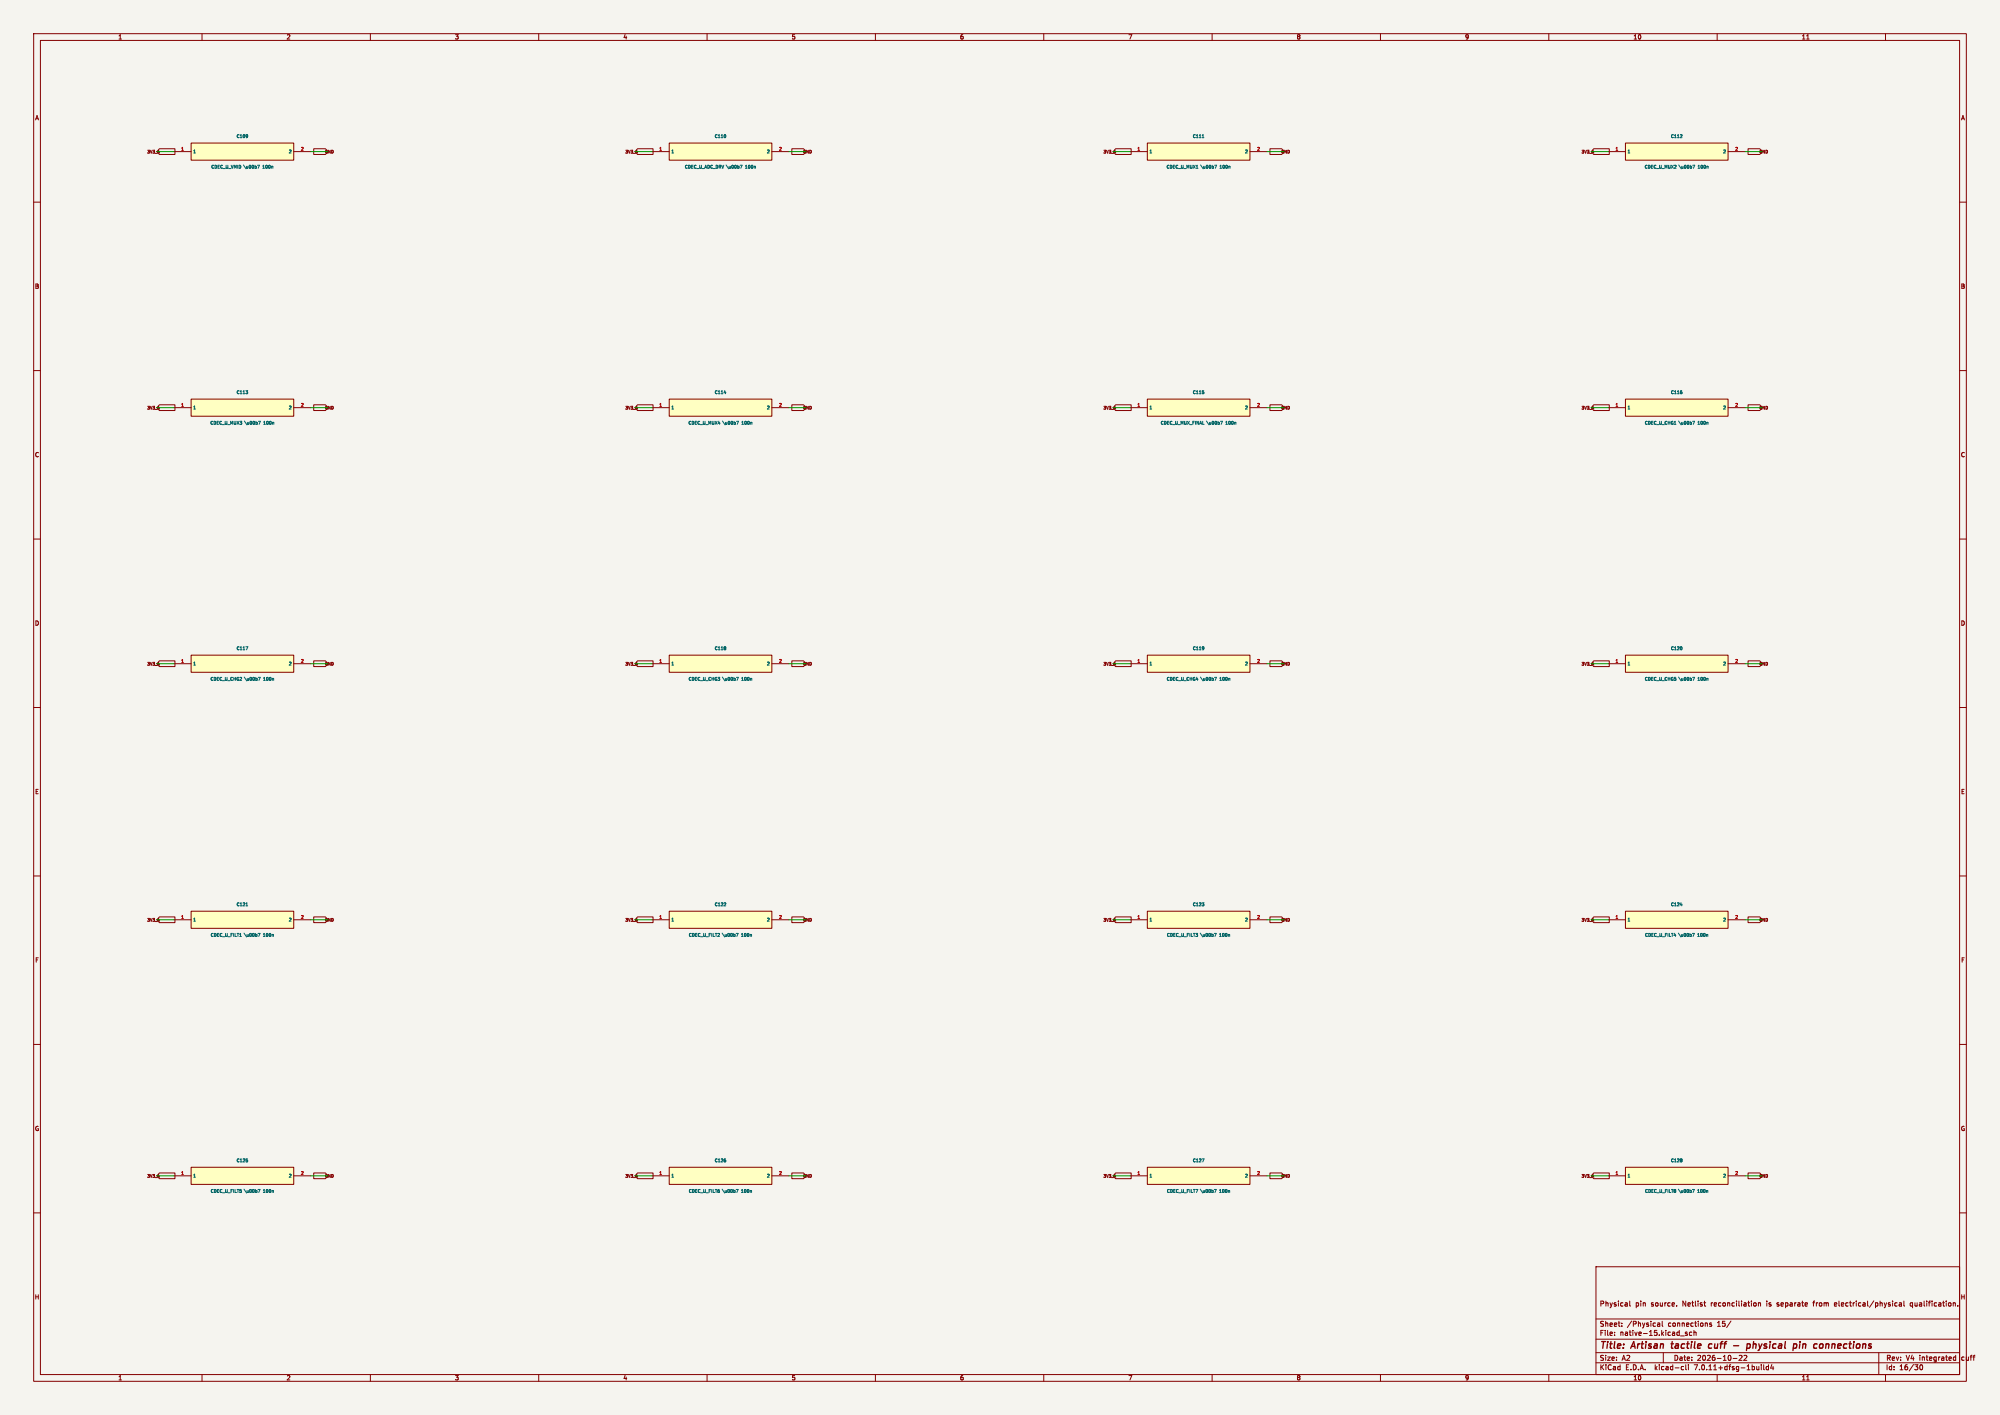
[picture p53: page 16]

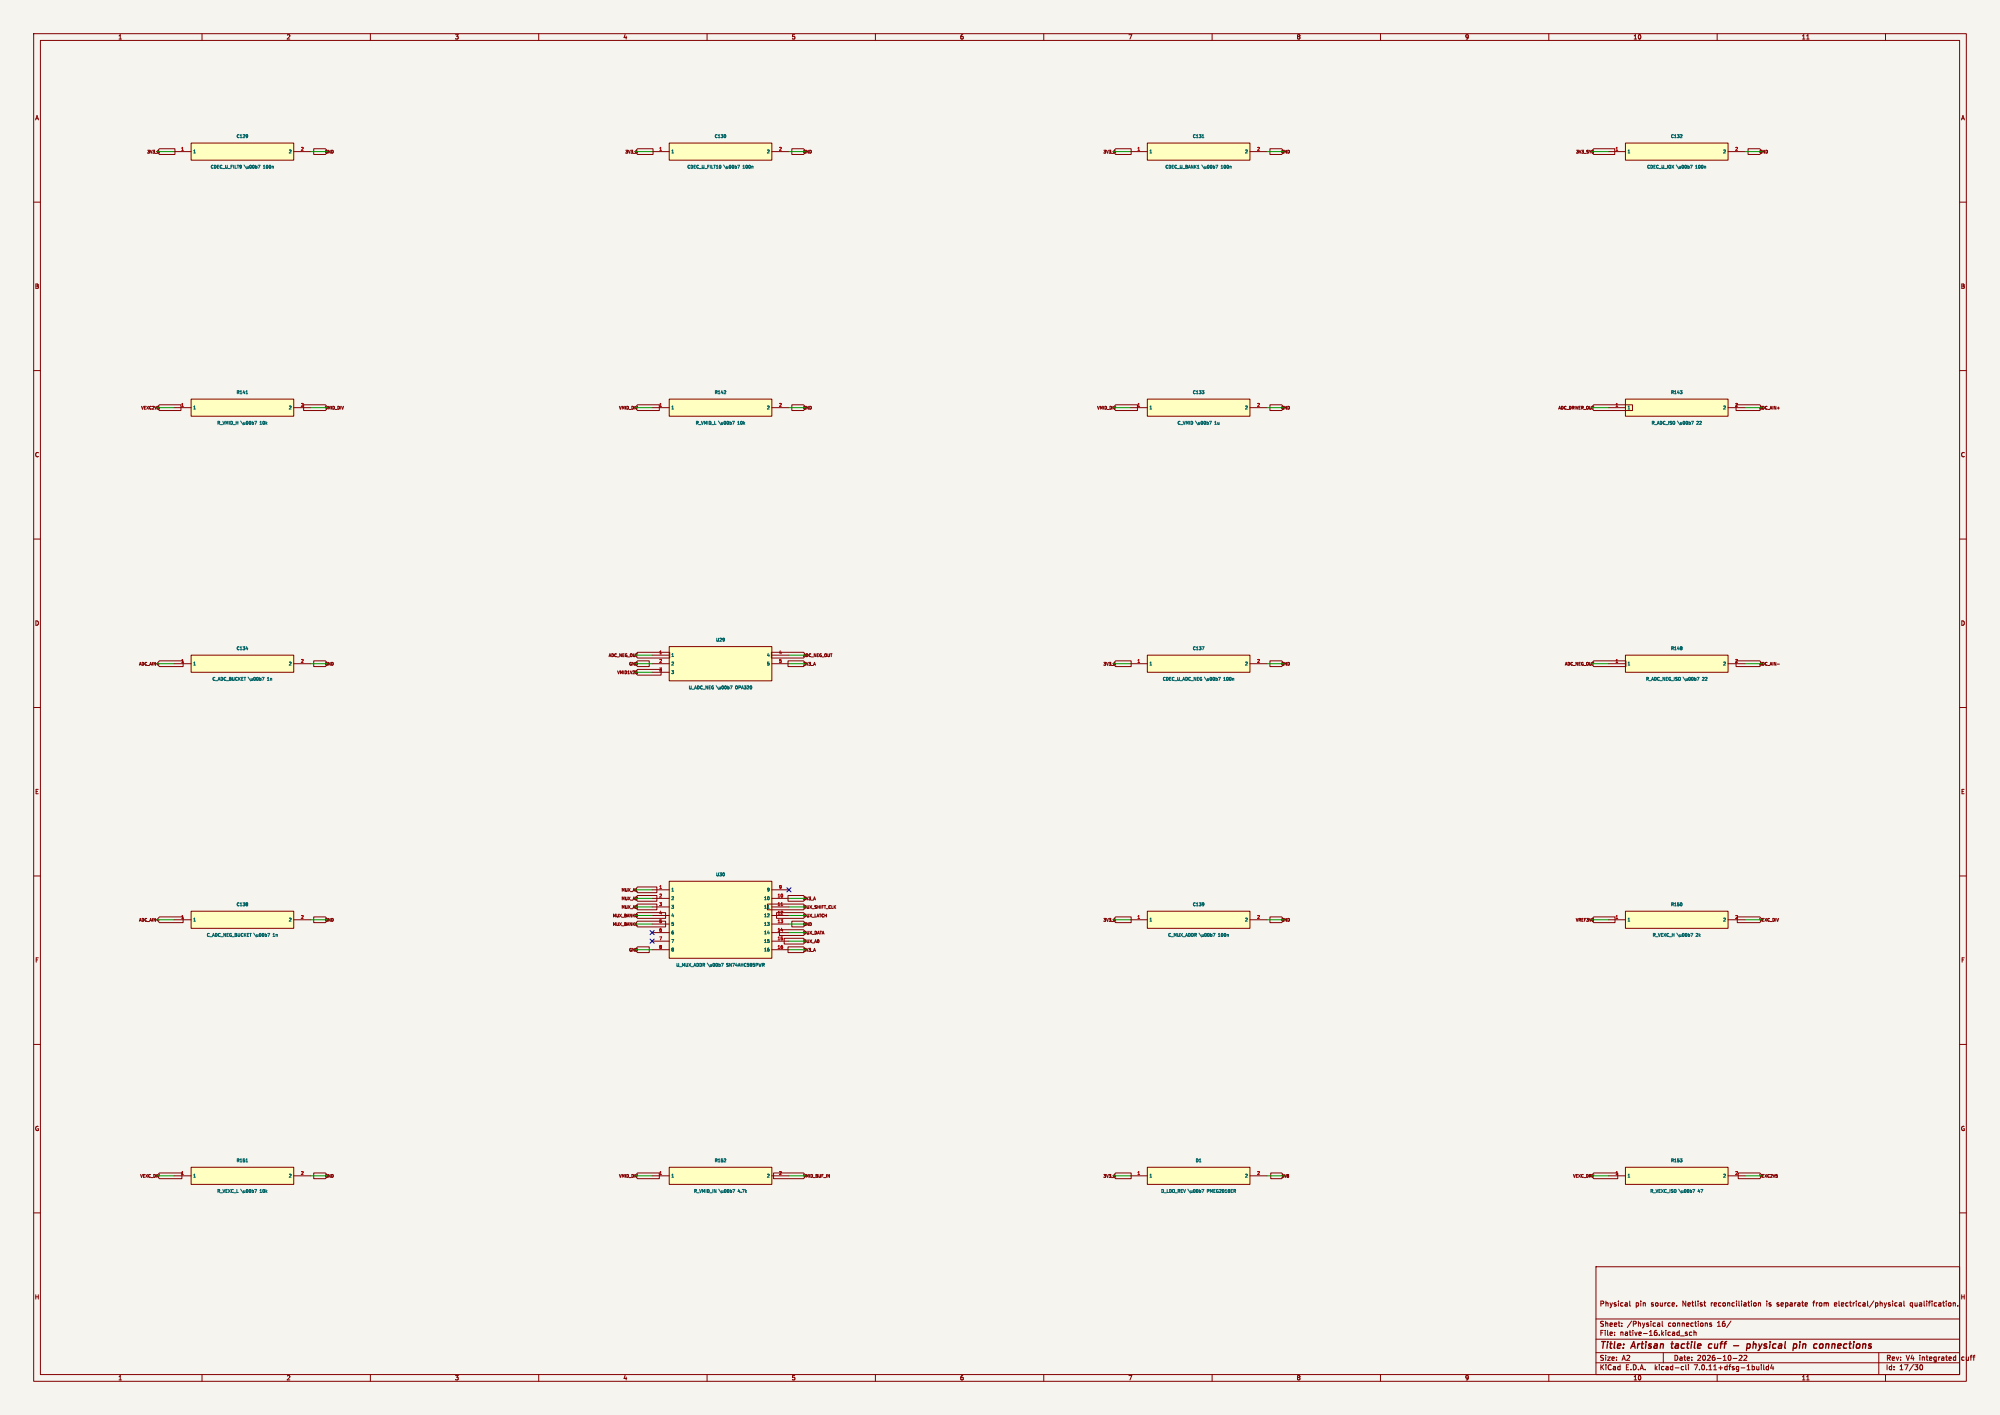
[picture p54: page 17]

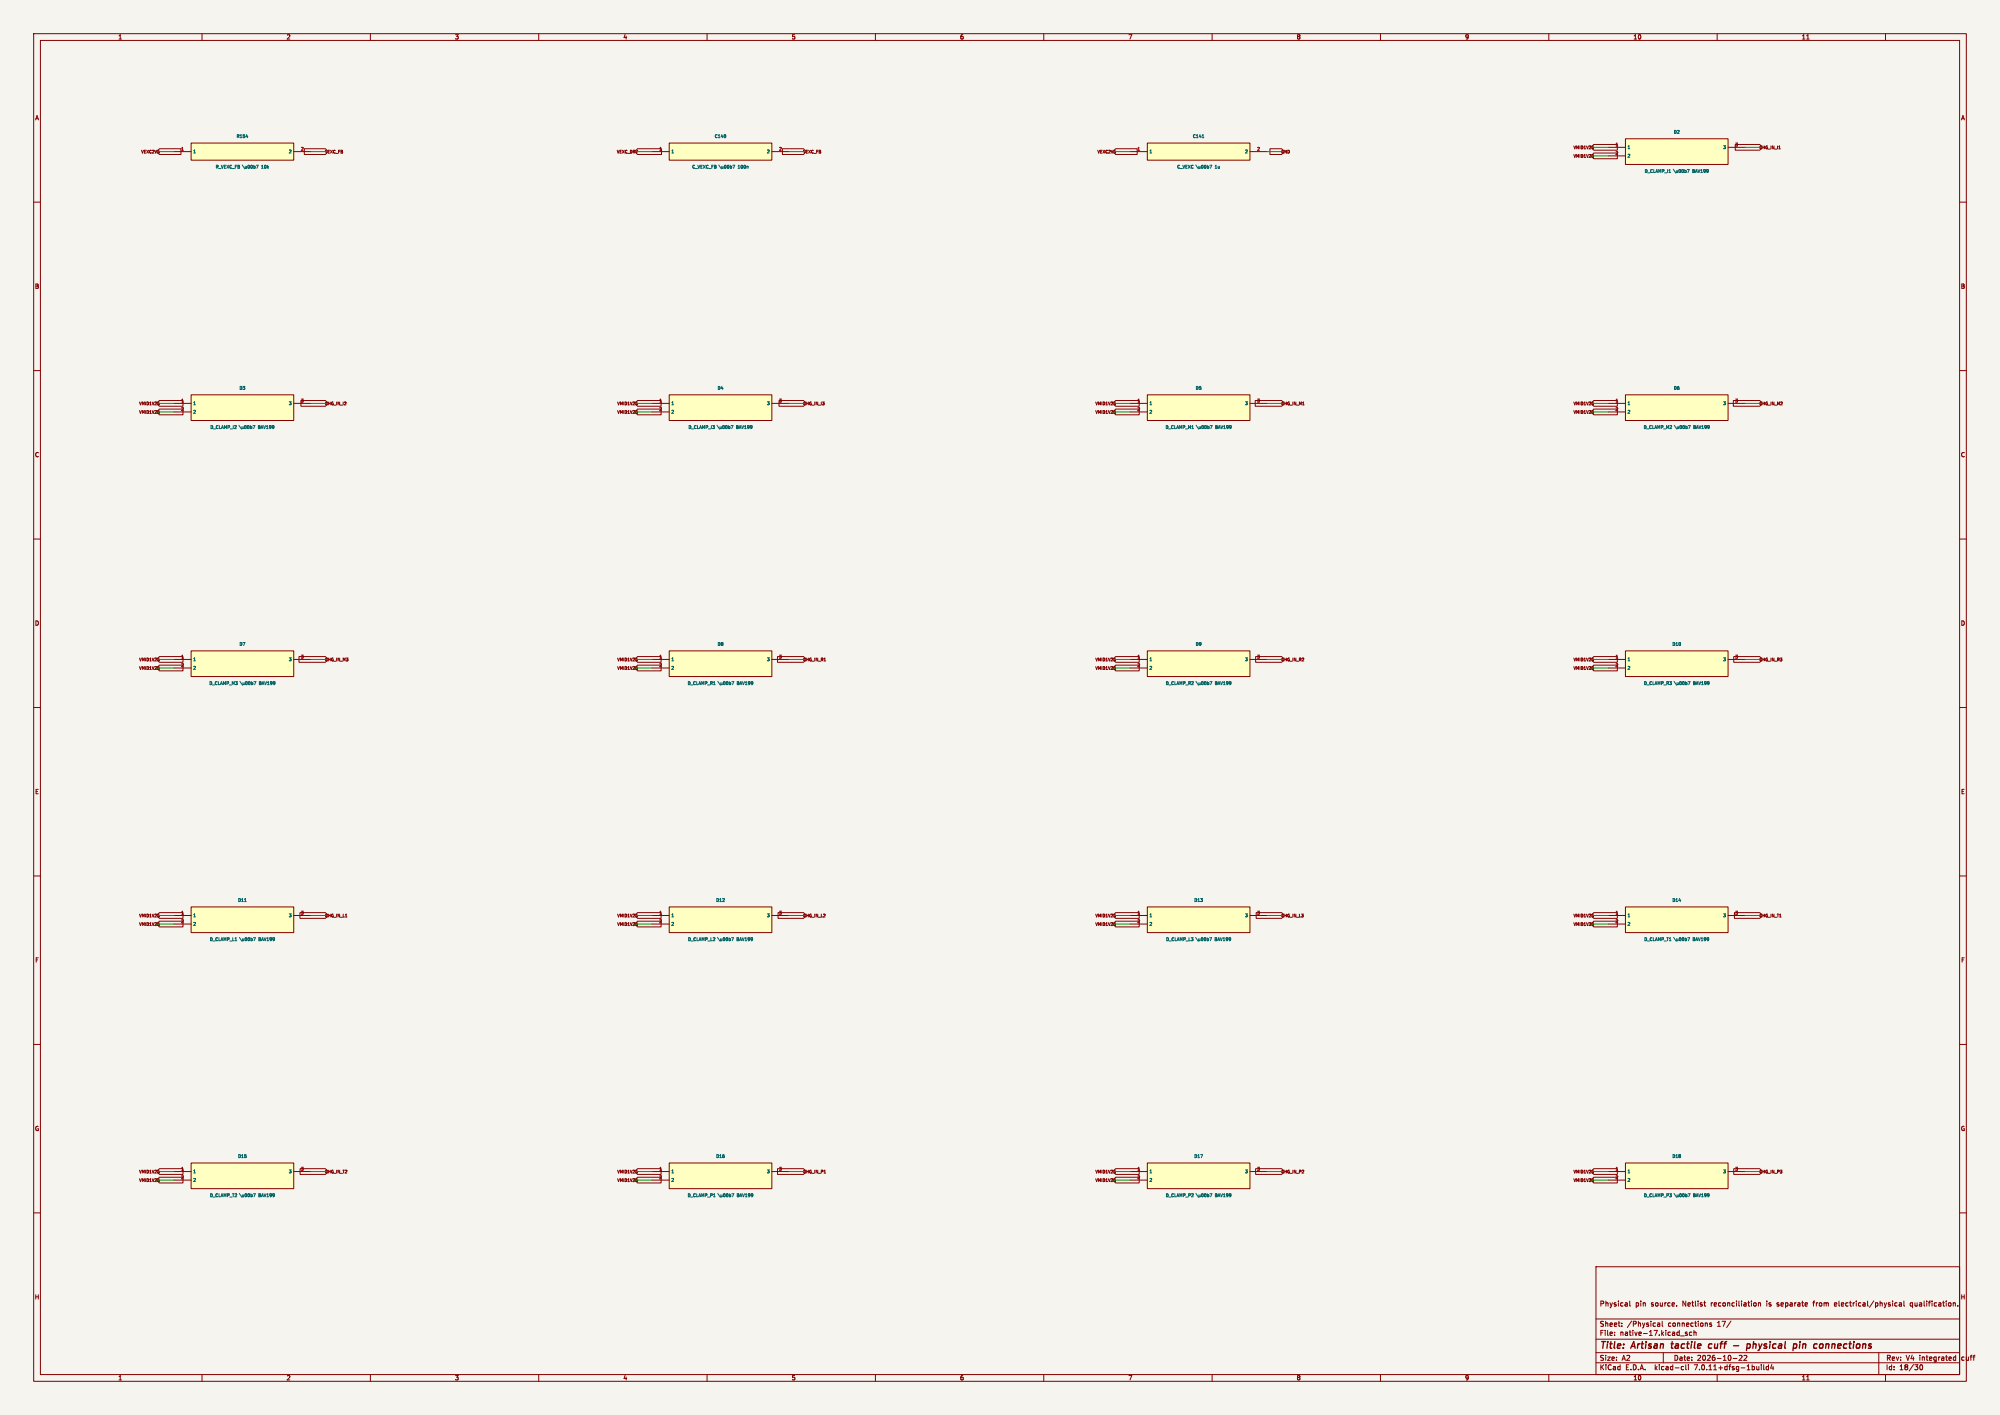
[picture p55: page 18]

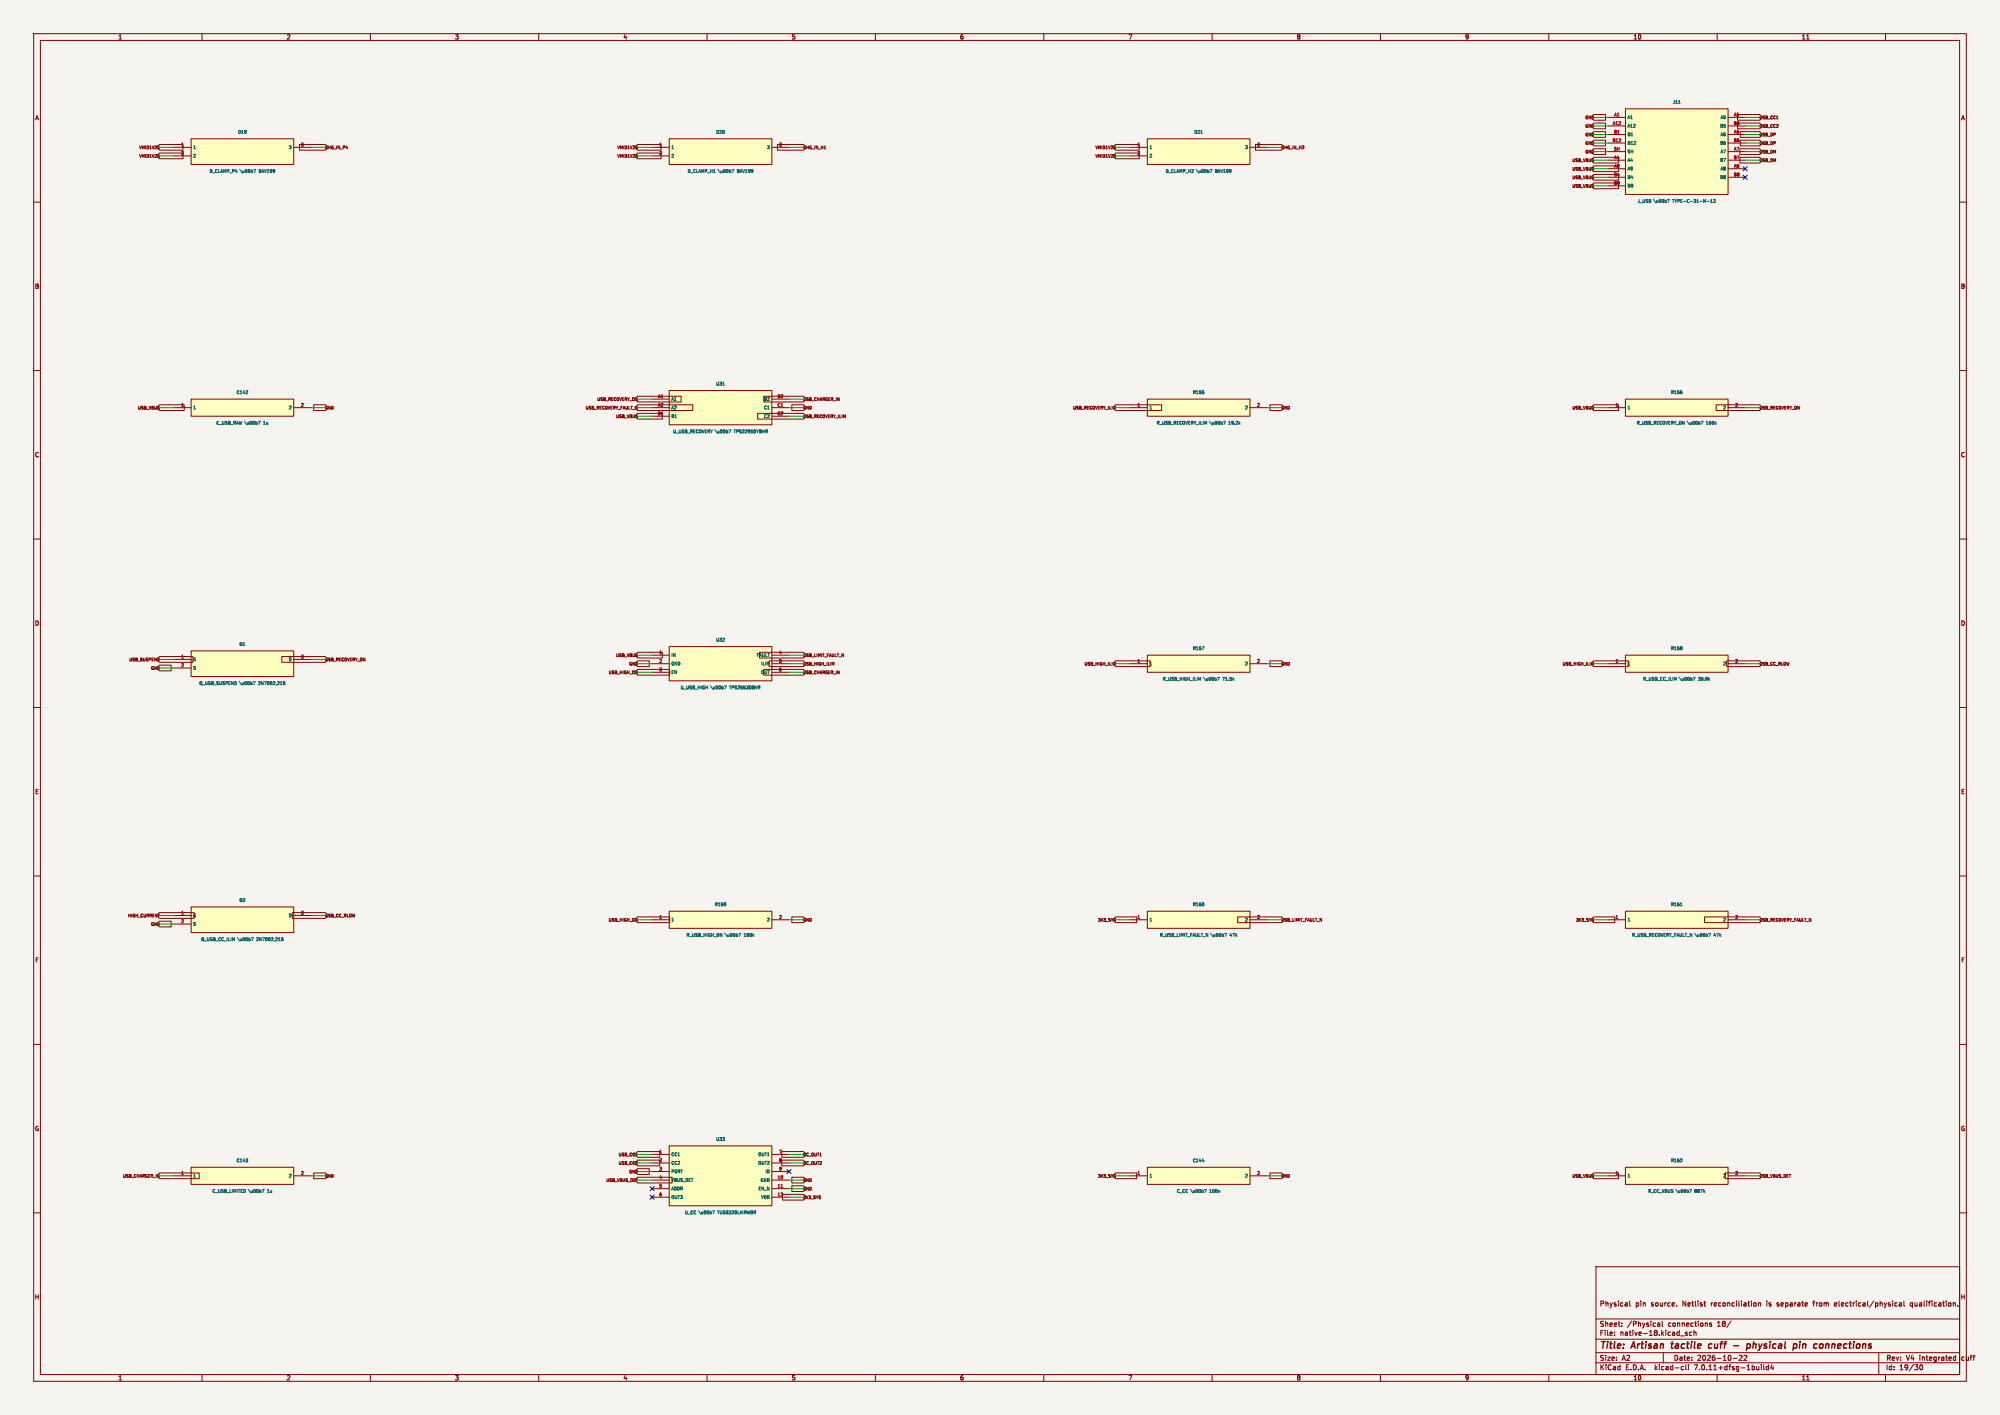
[picture p56: page 19]

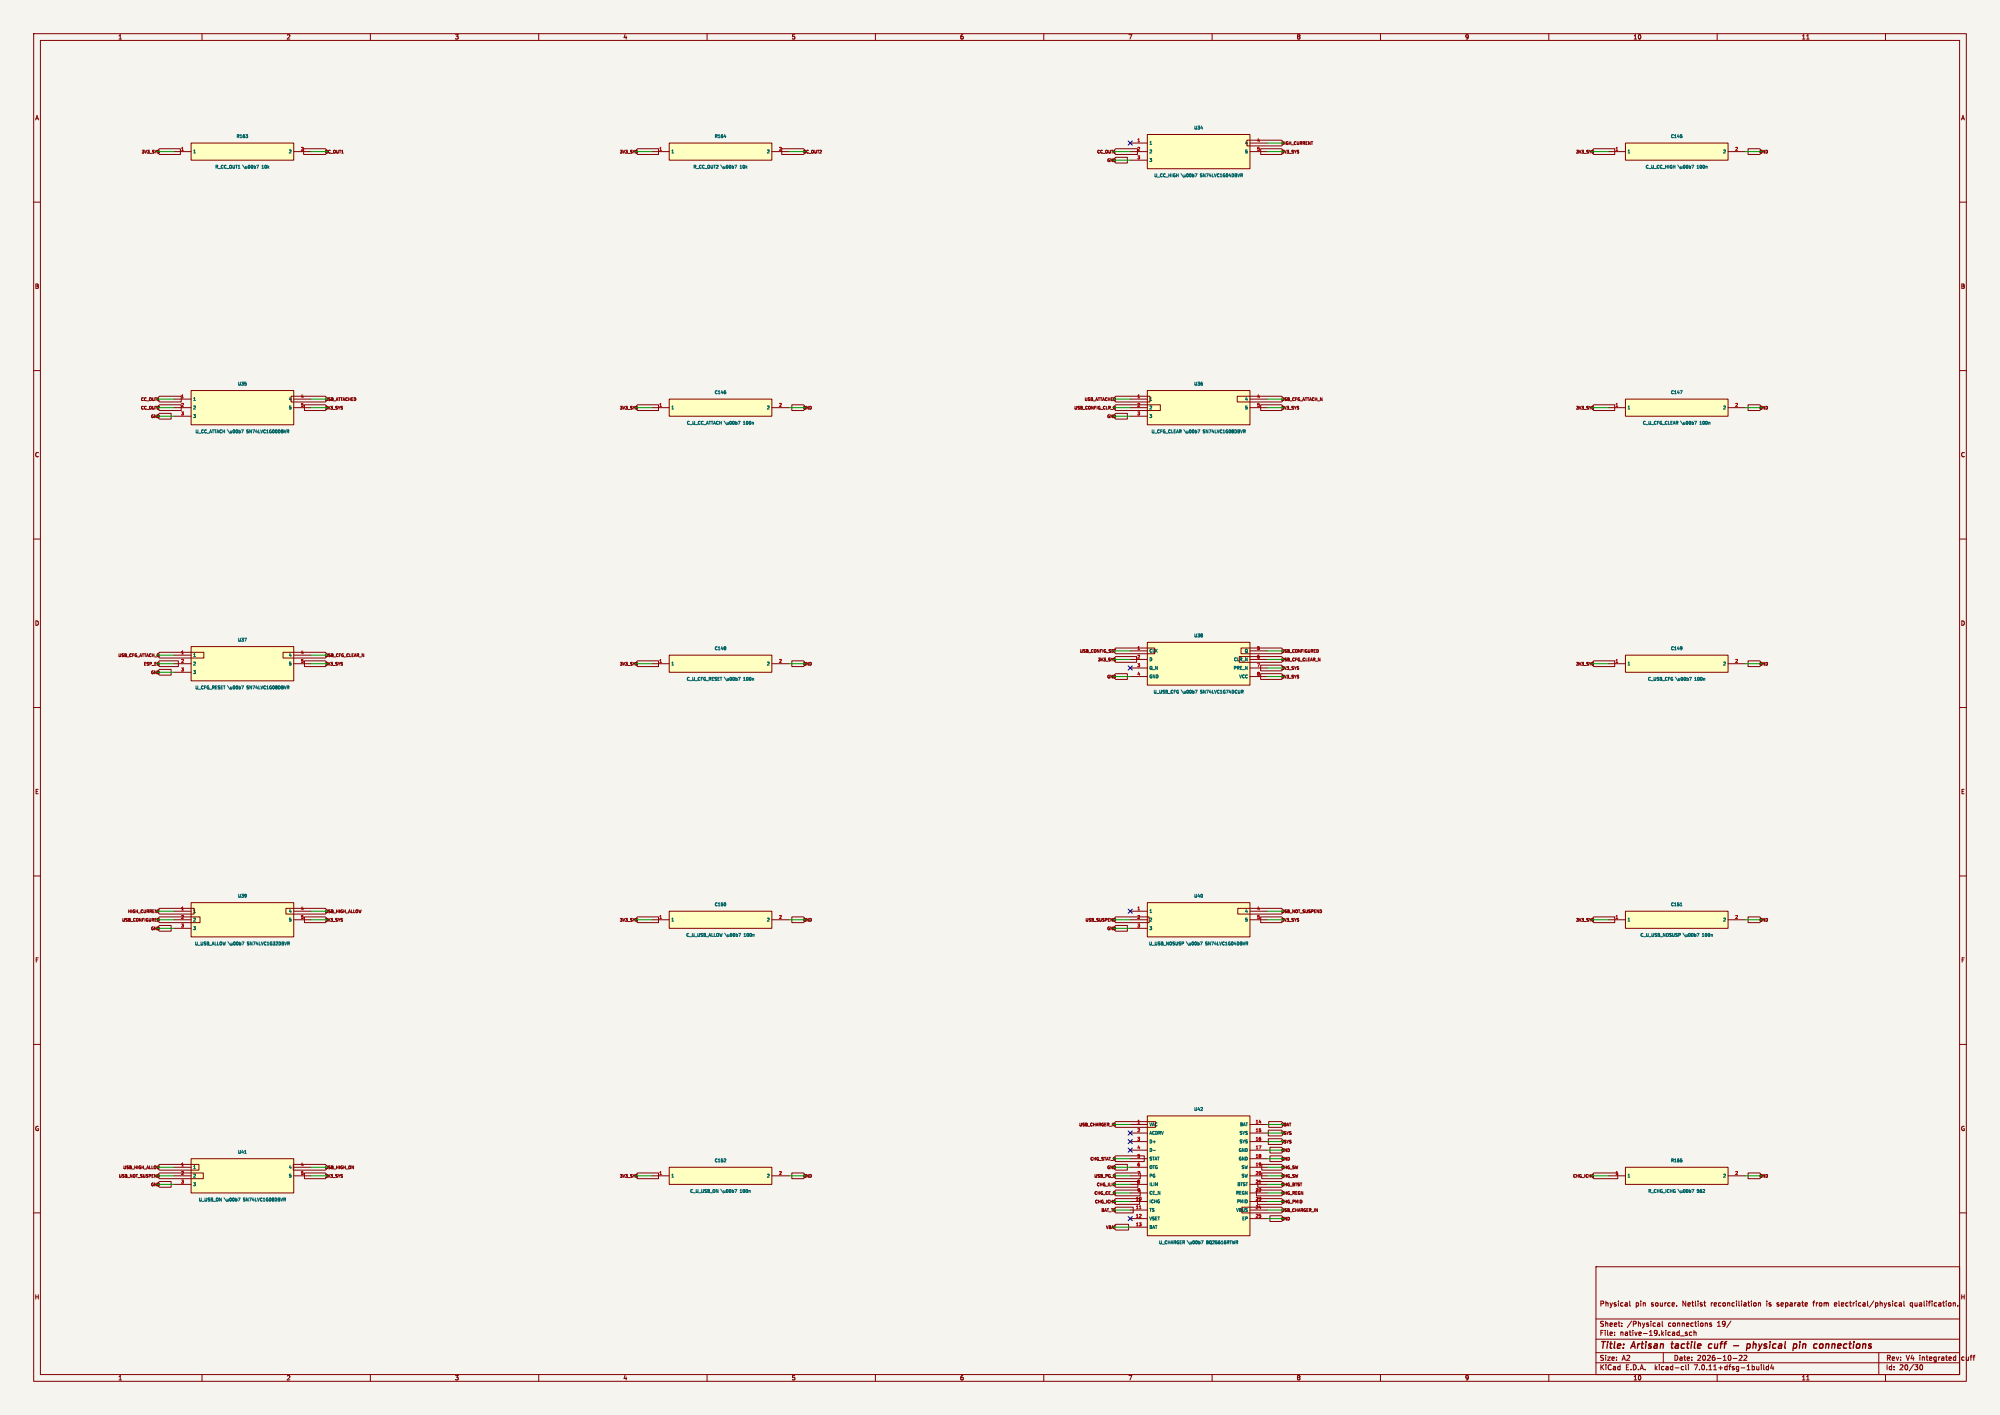
[picture p57: page 20]

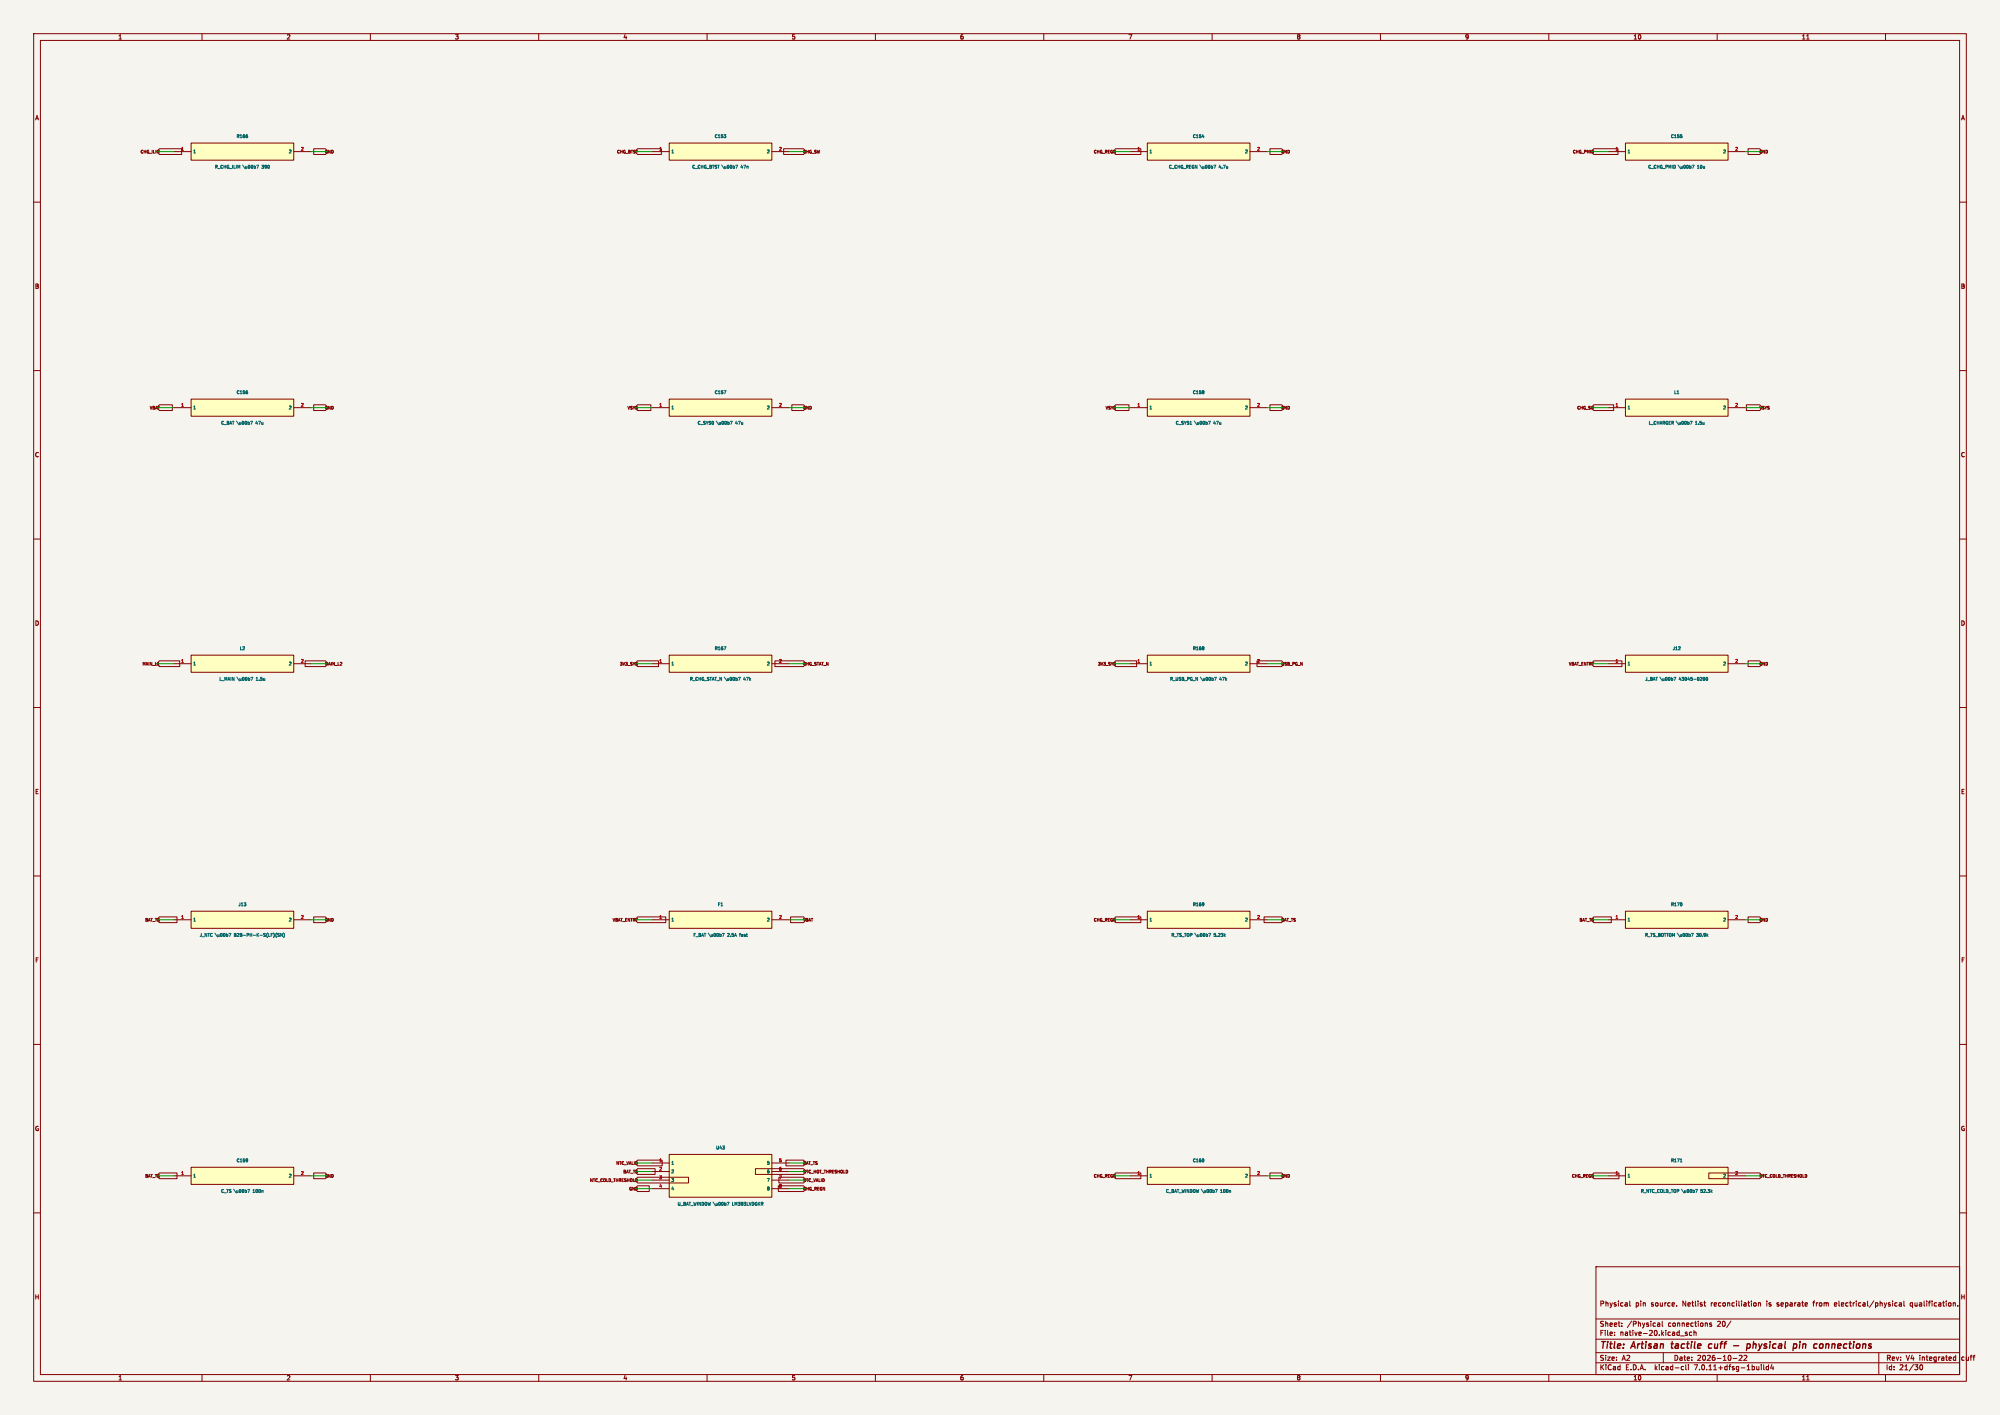
[picture p58: page 21]

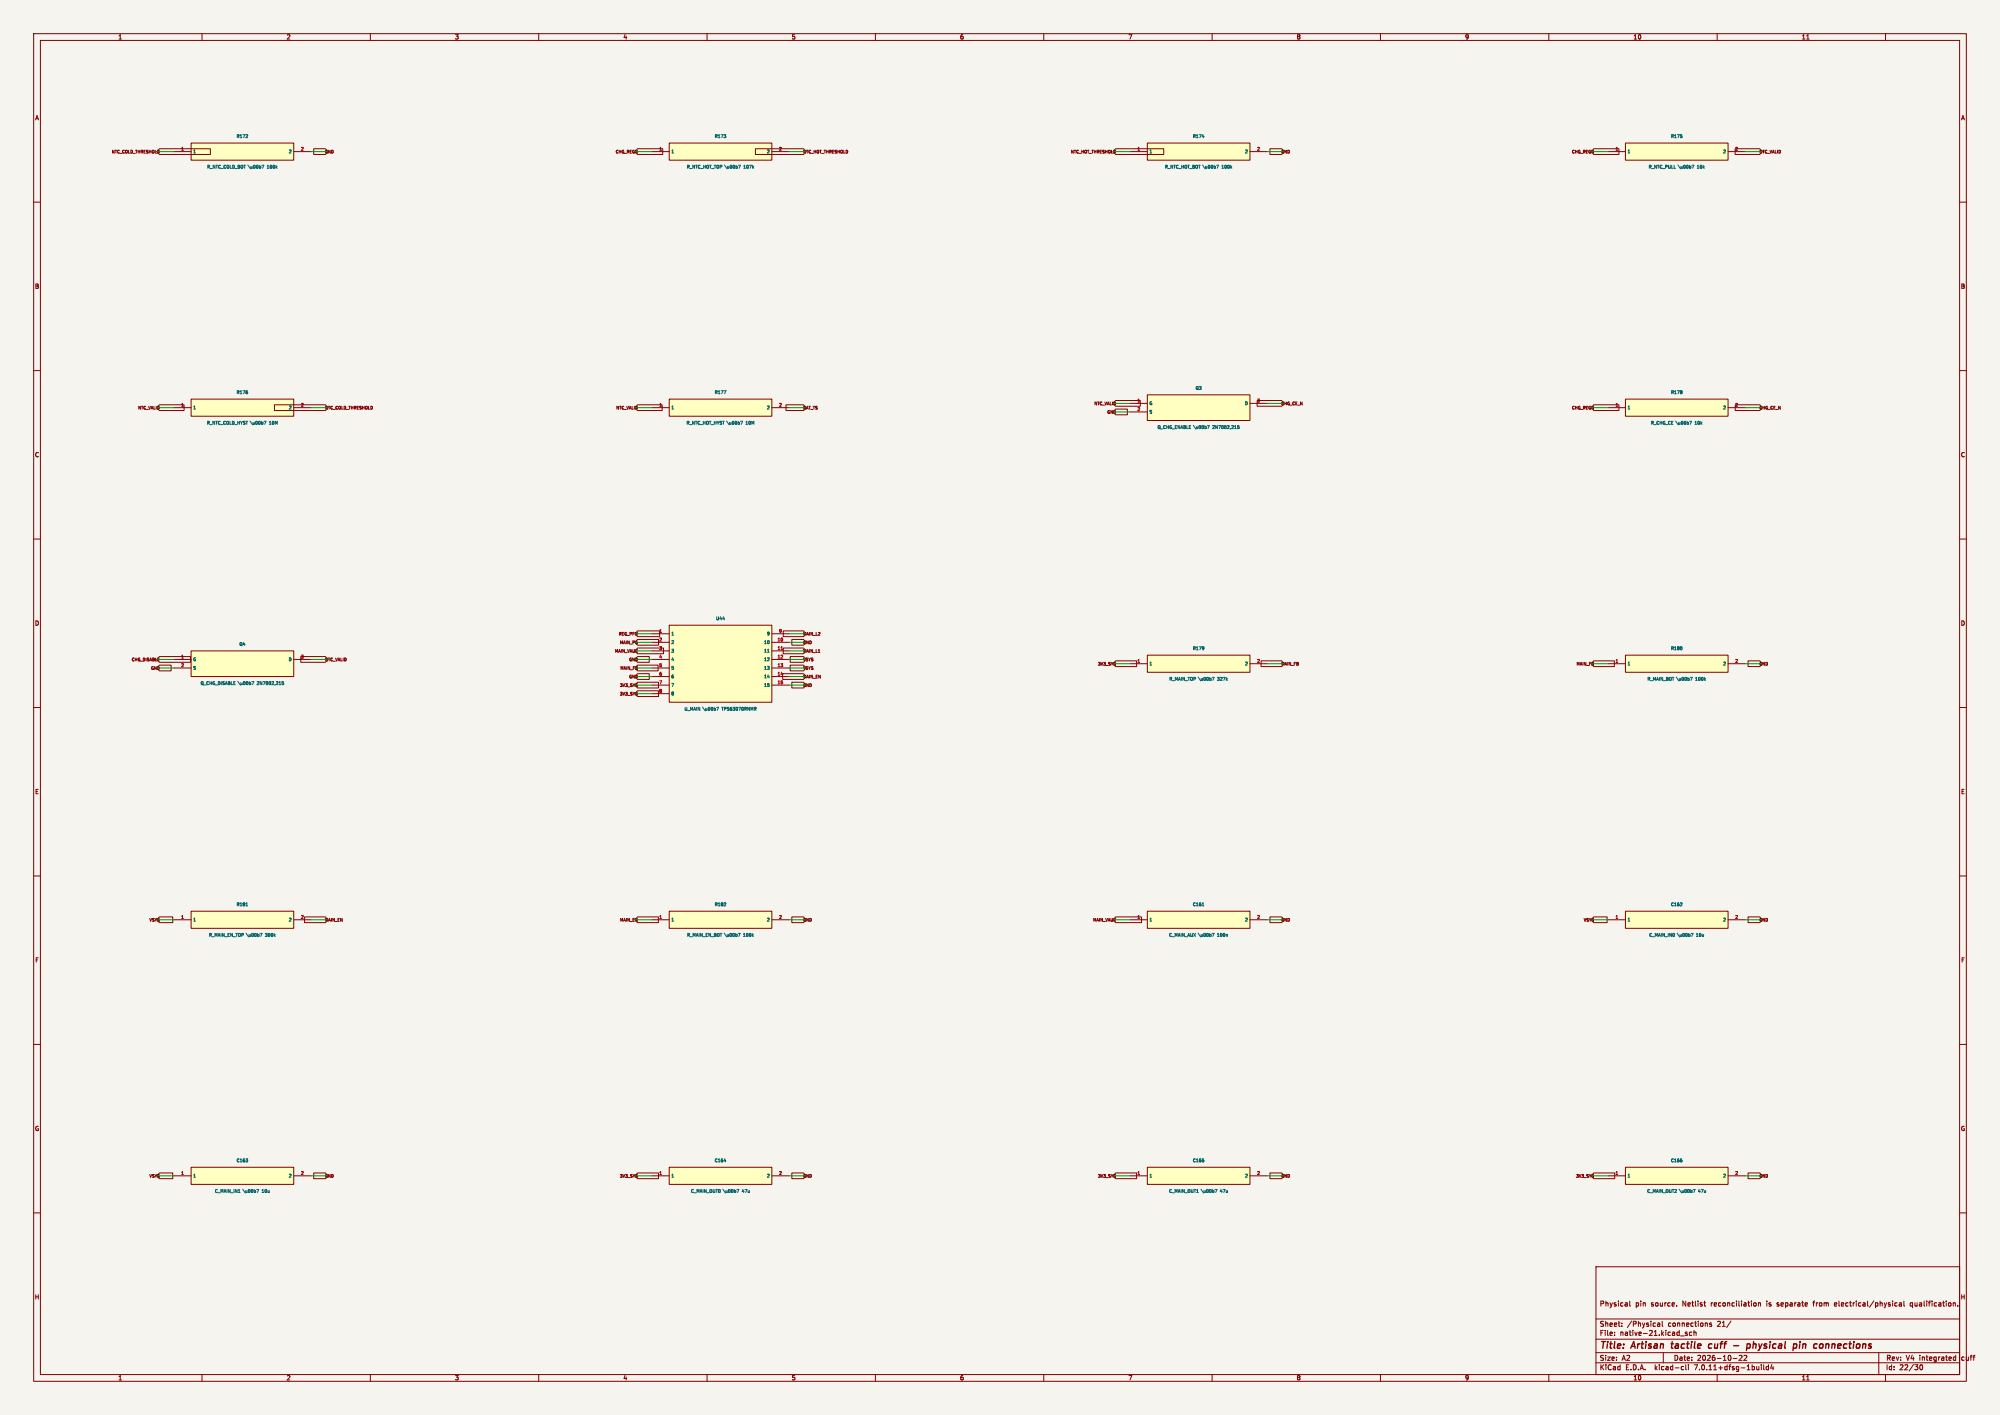
[picture p59: page 22]

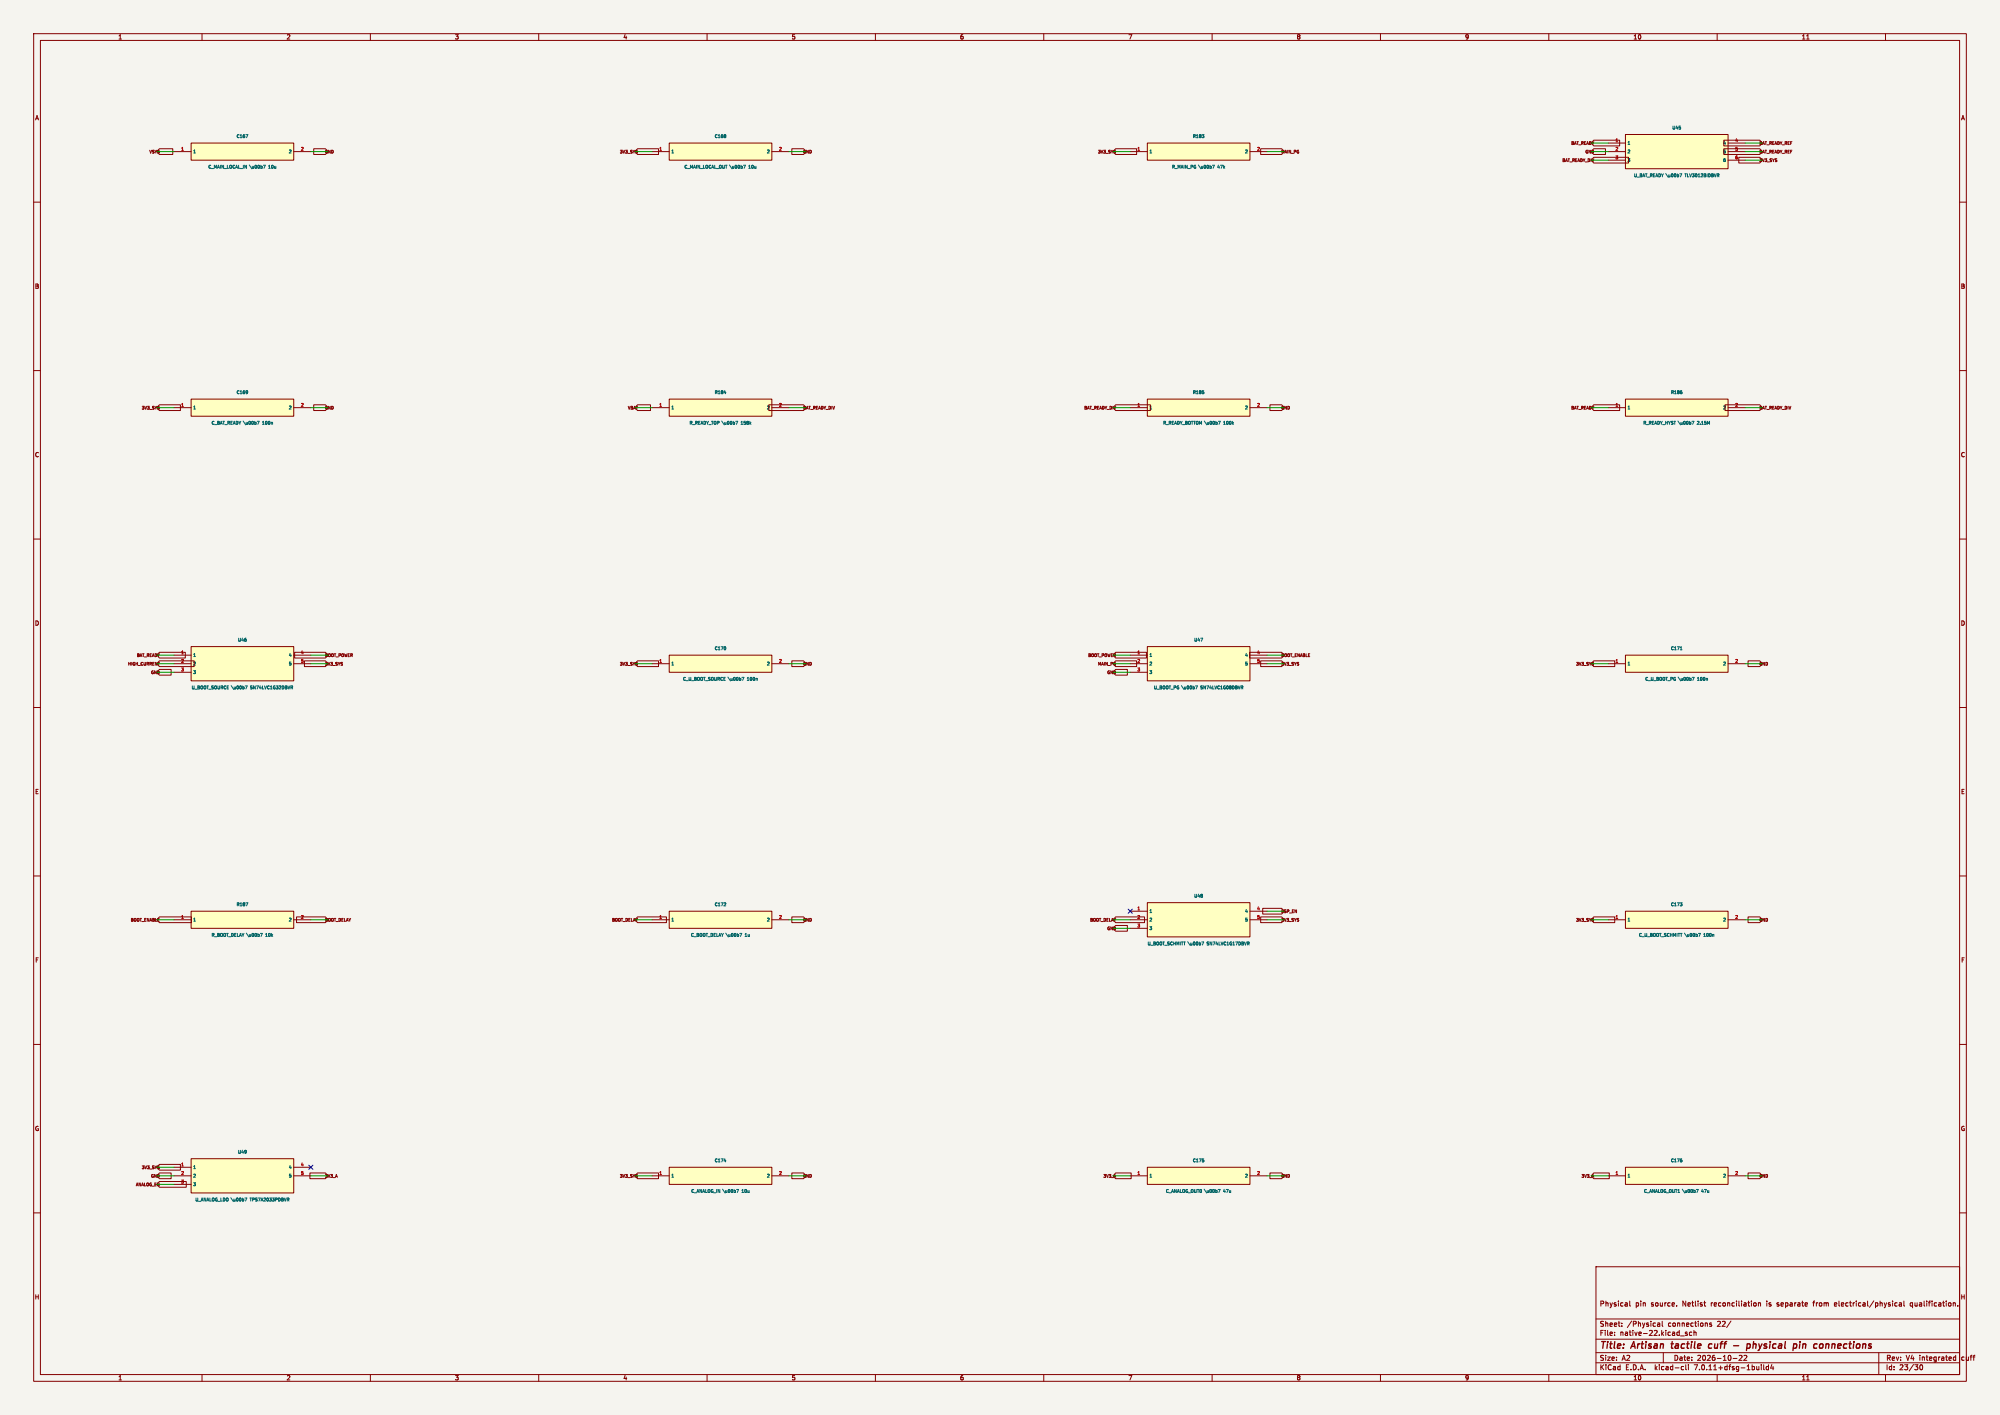
[picture p60: page 23]

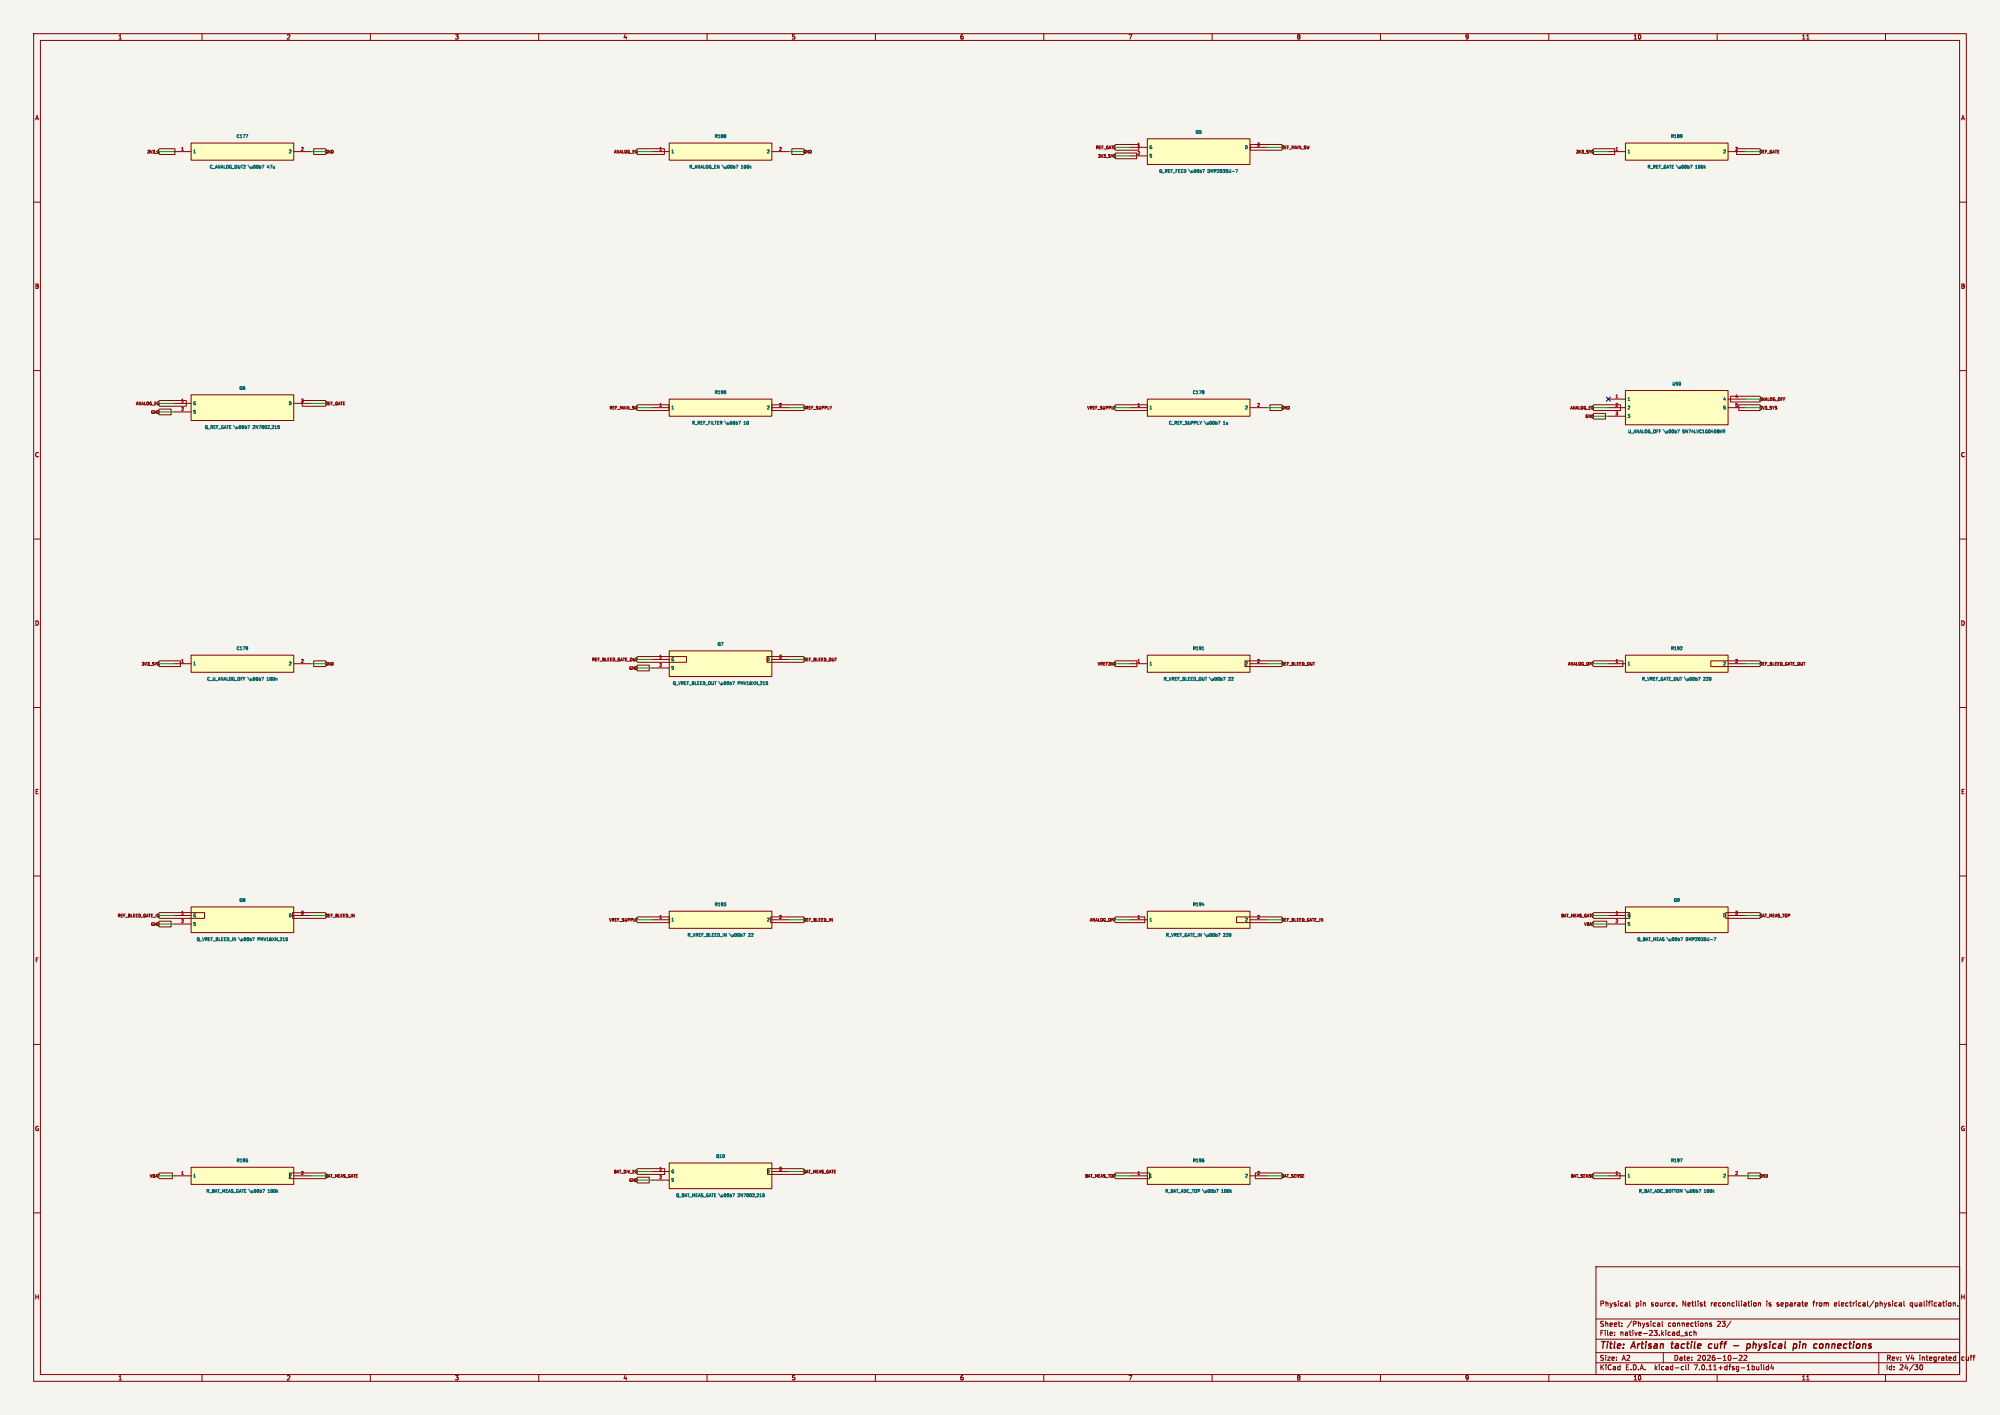
[picture p61: page 24]

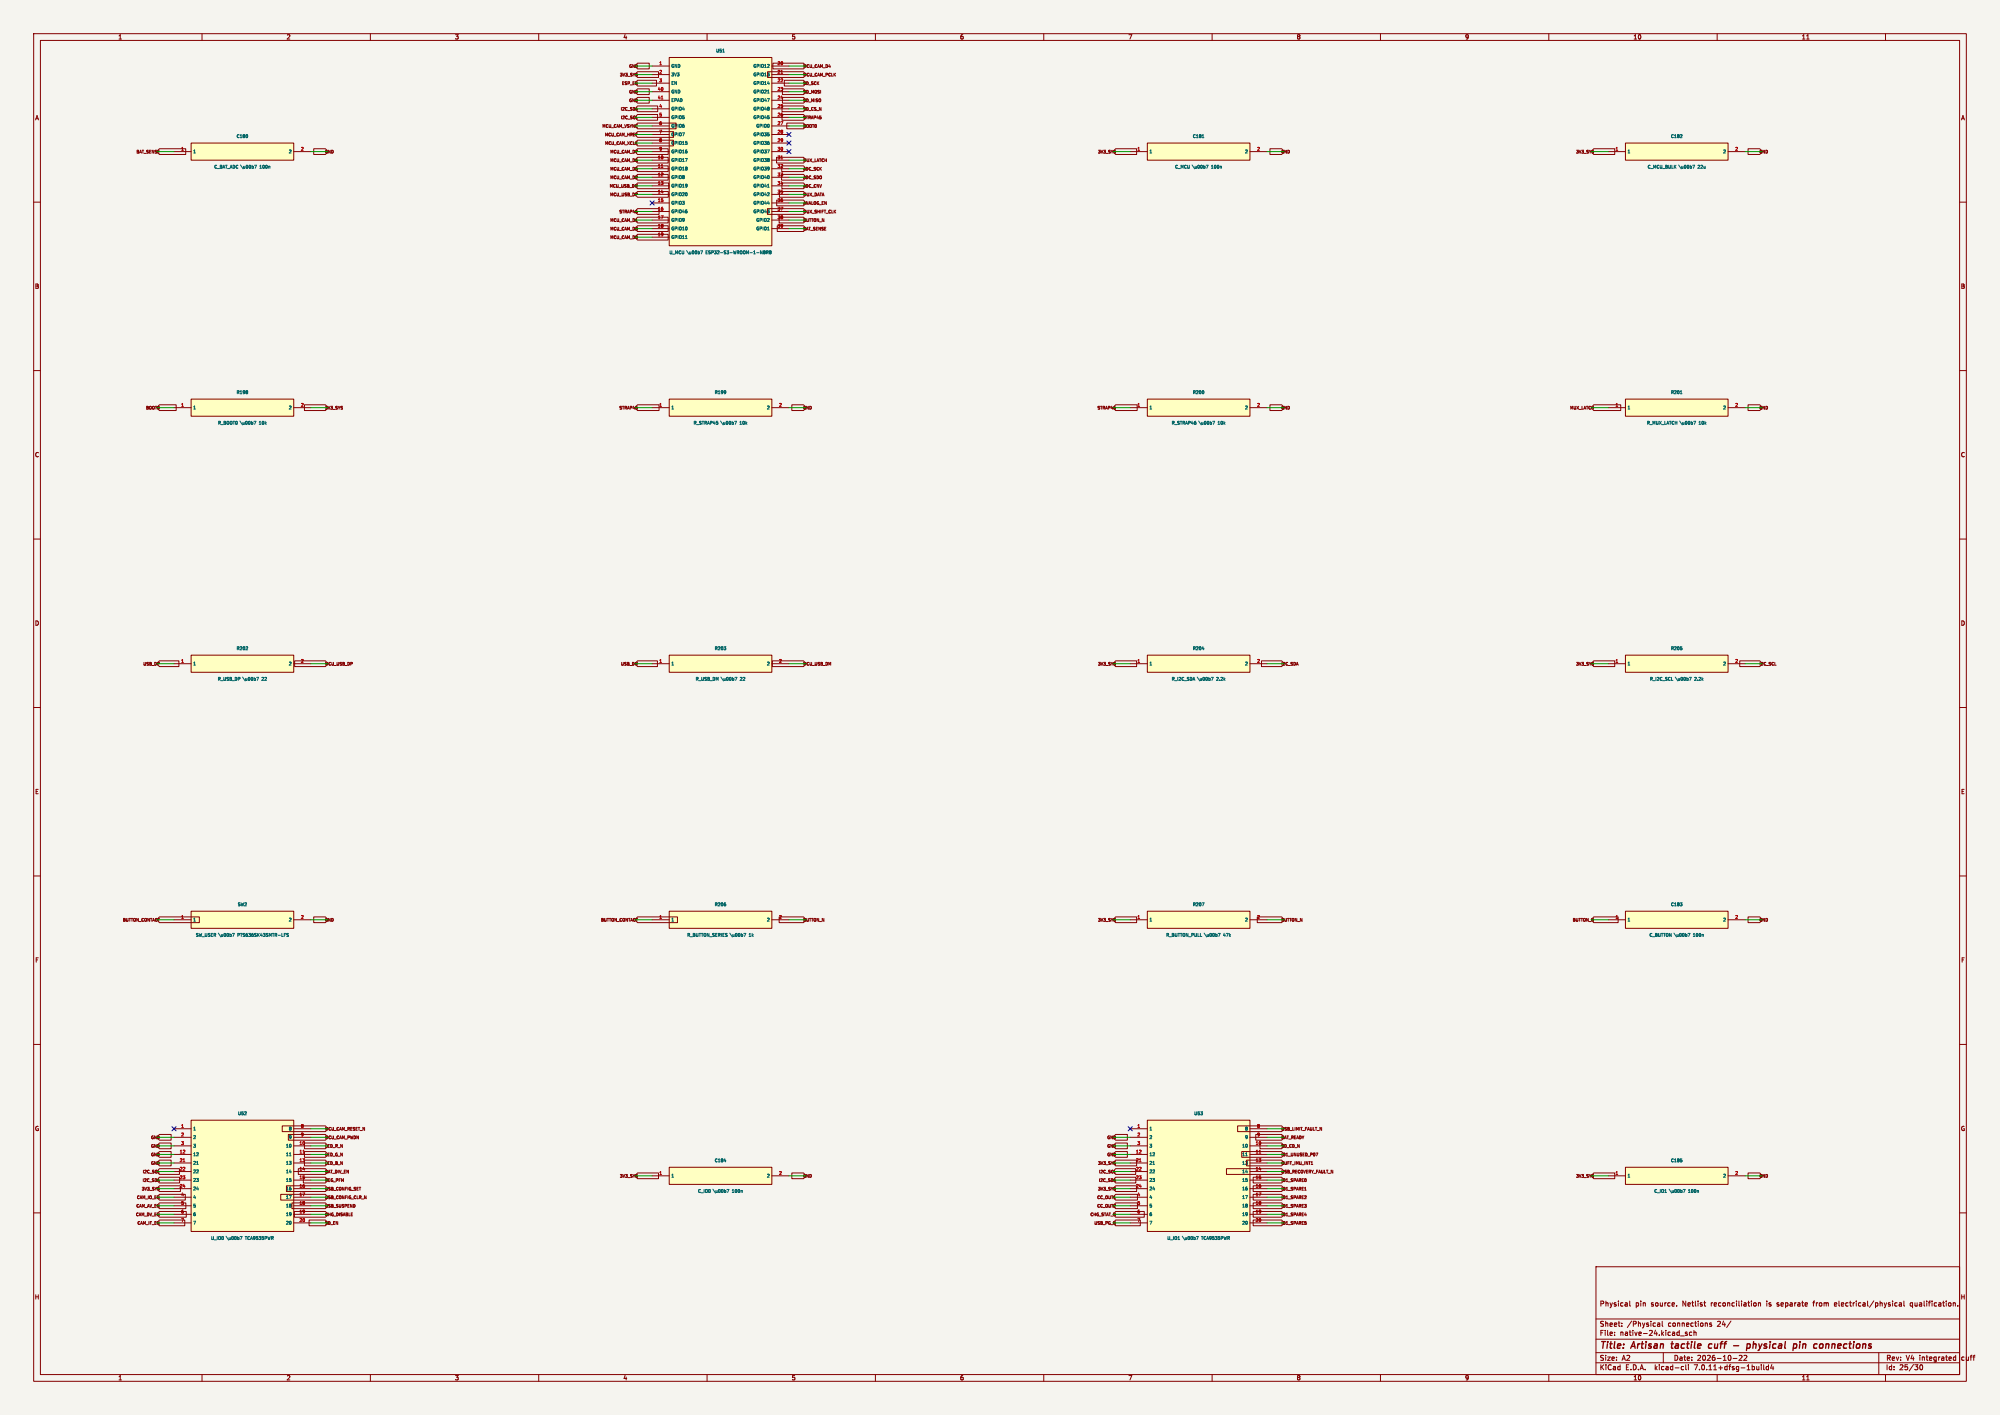
[picture p62: page 25]

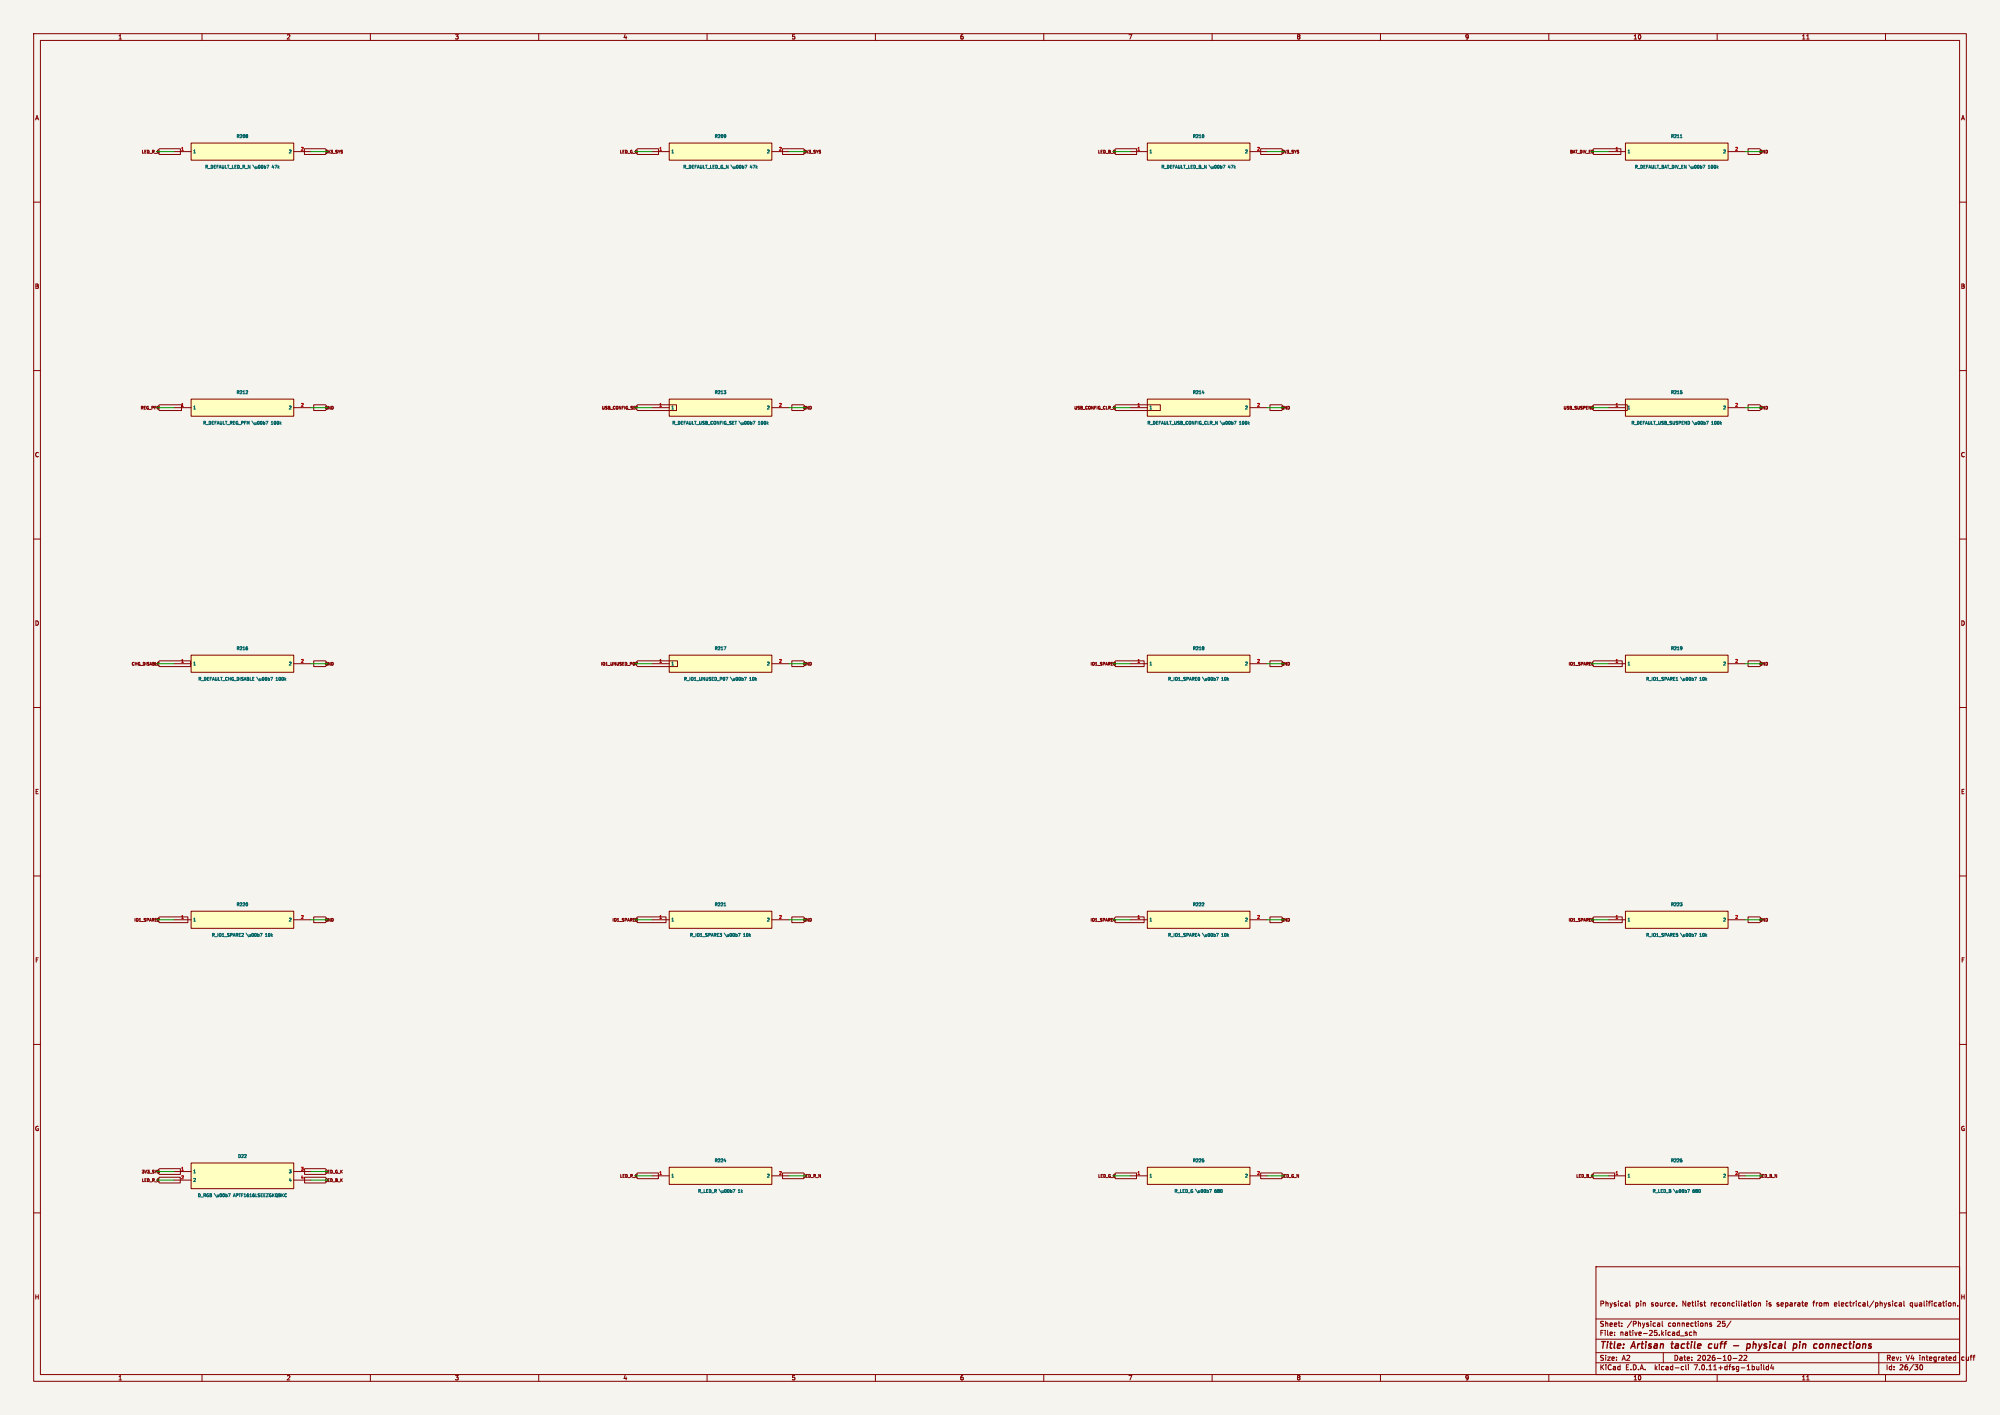
[picture p63: page 26]

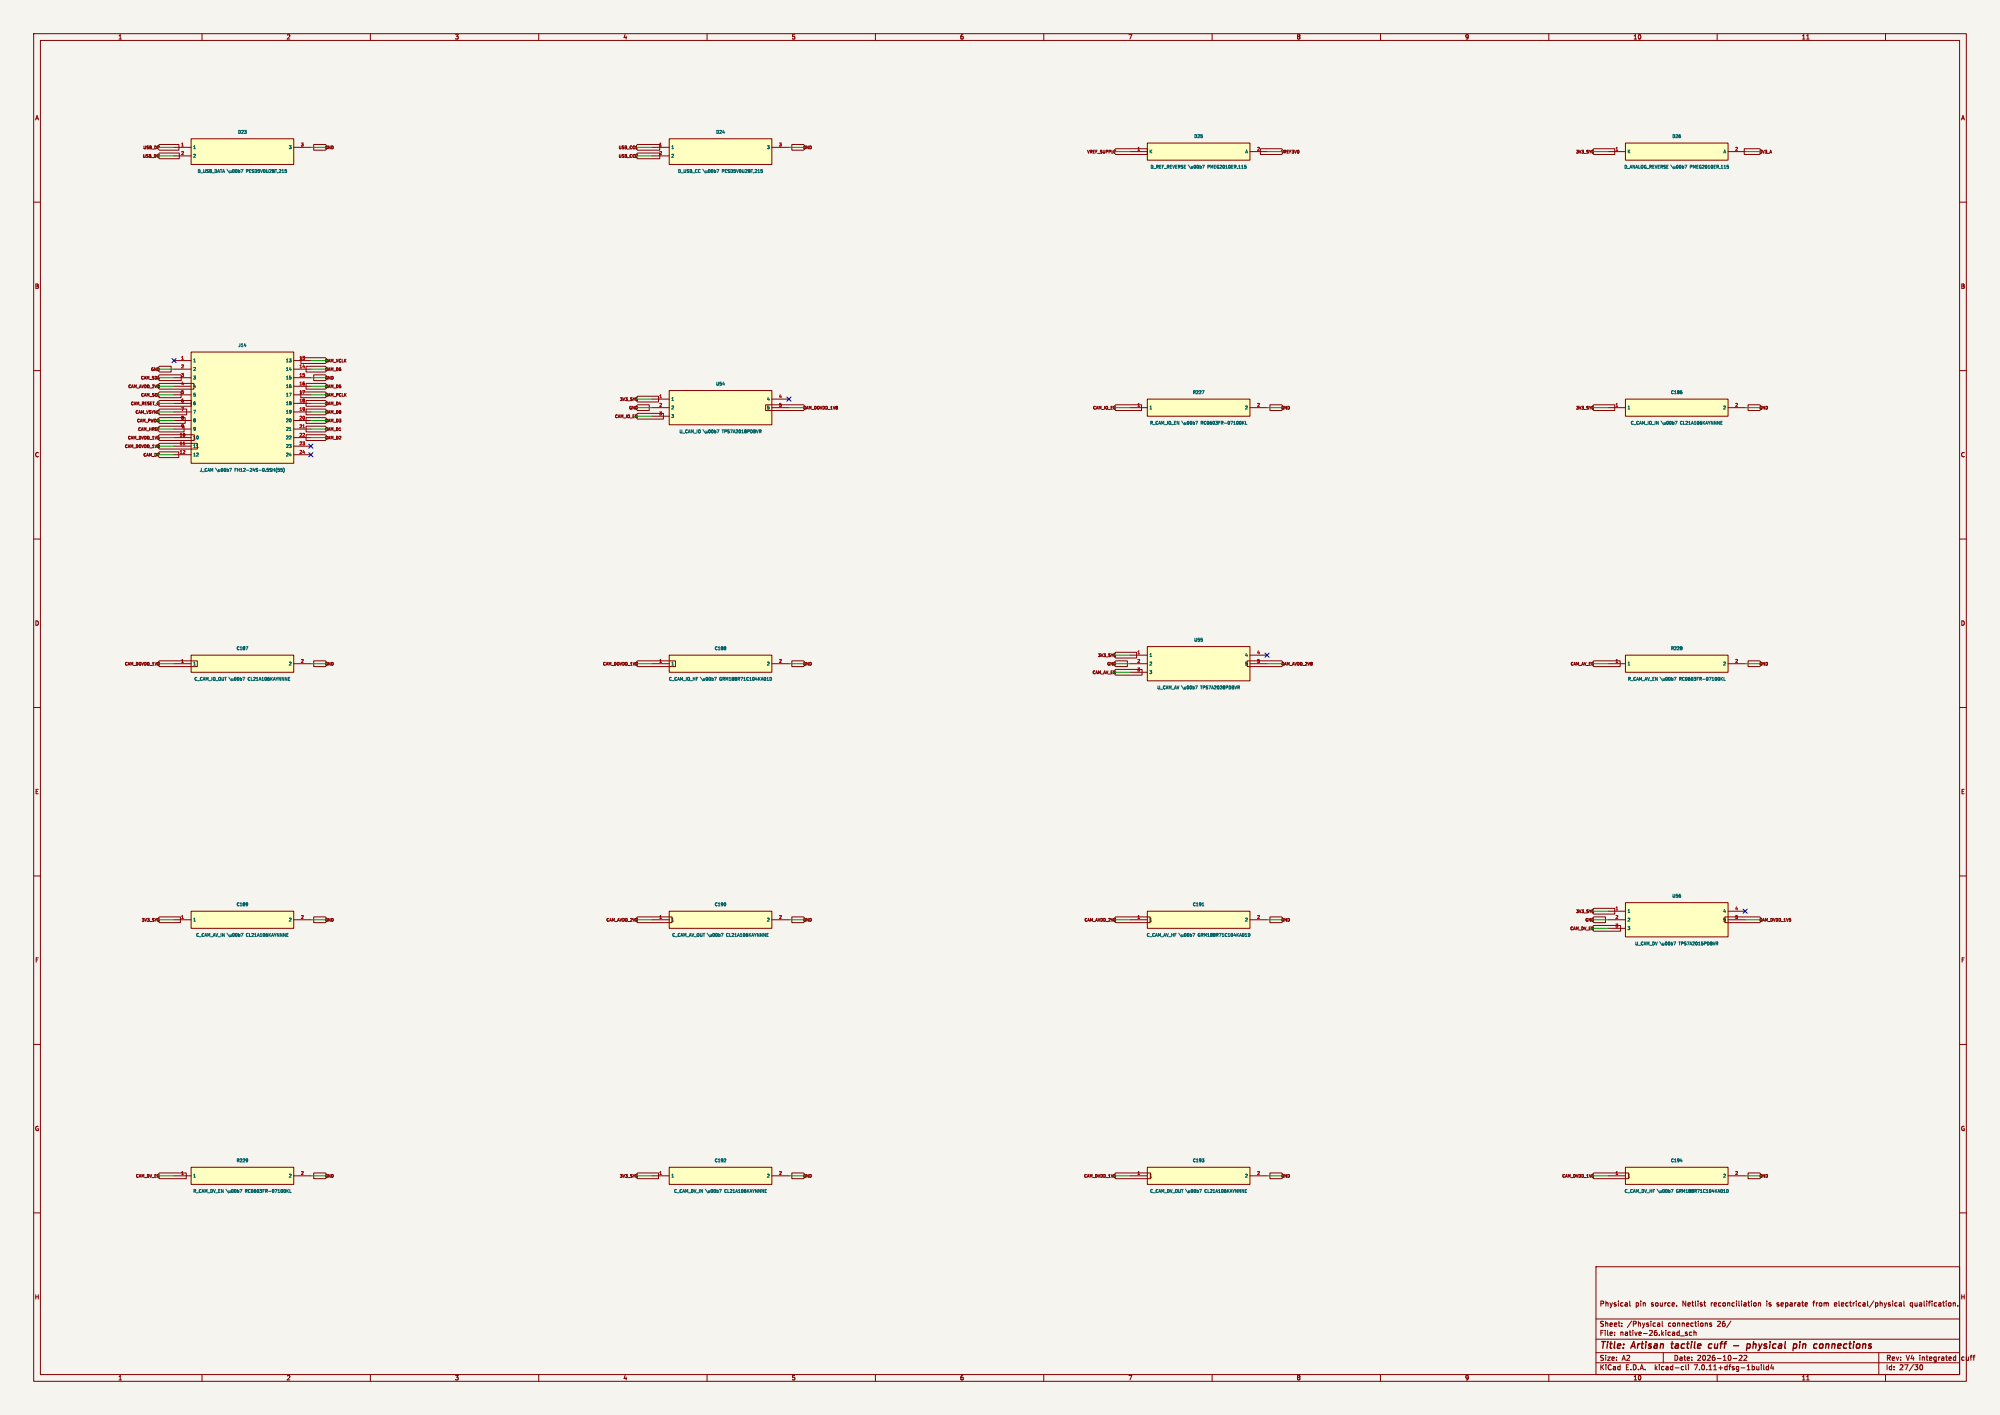
[picture p64: page 27]

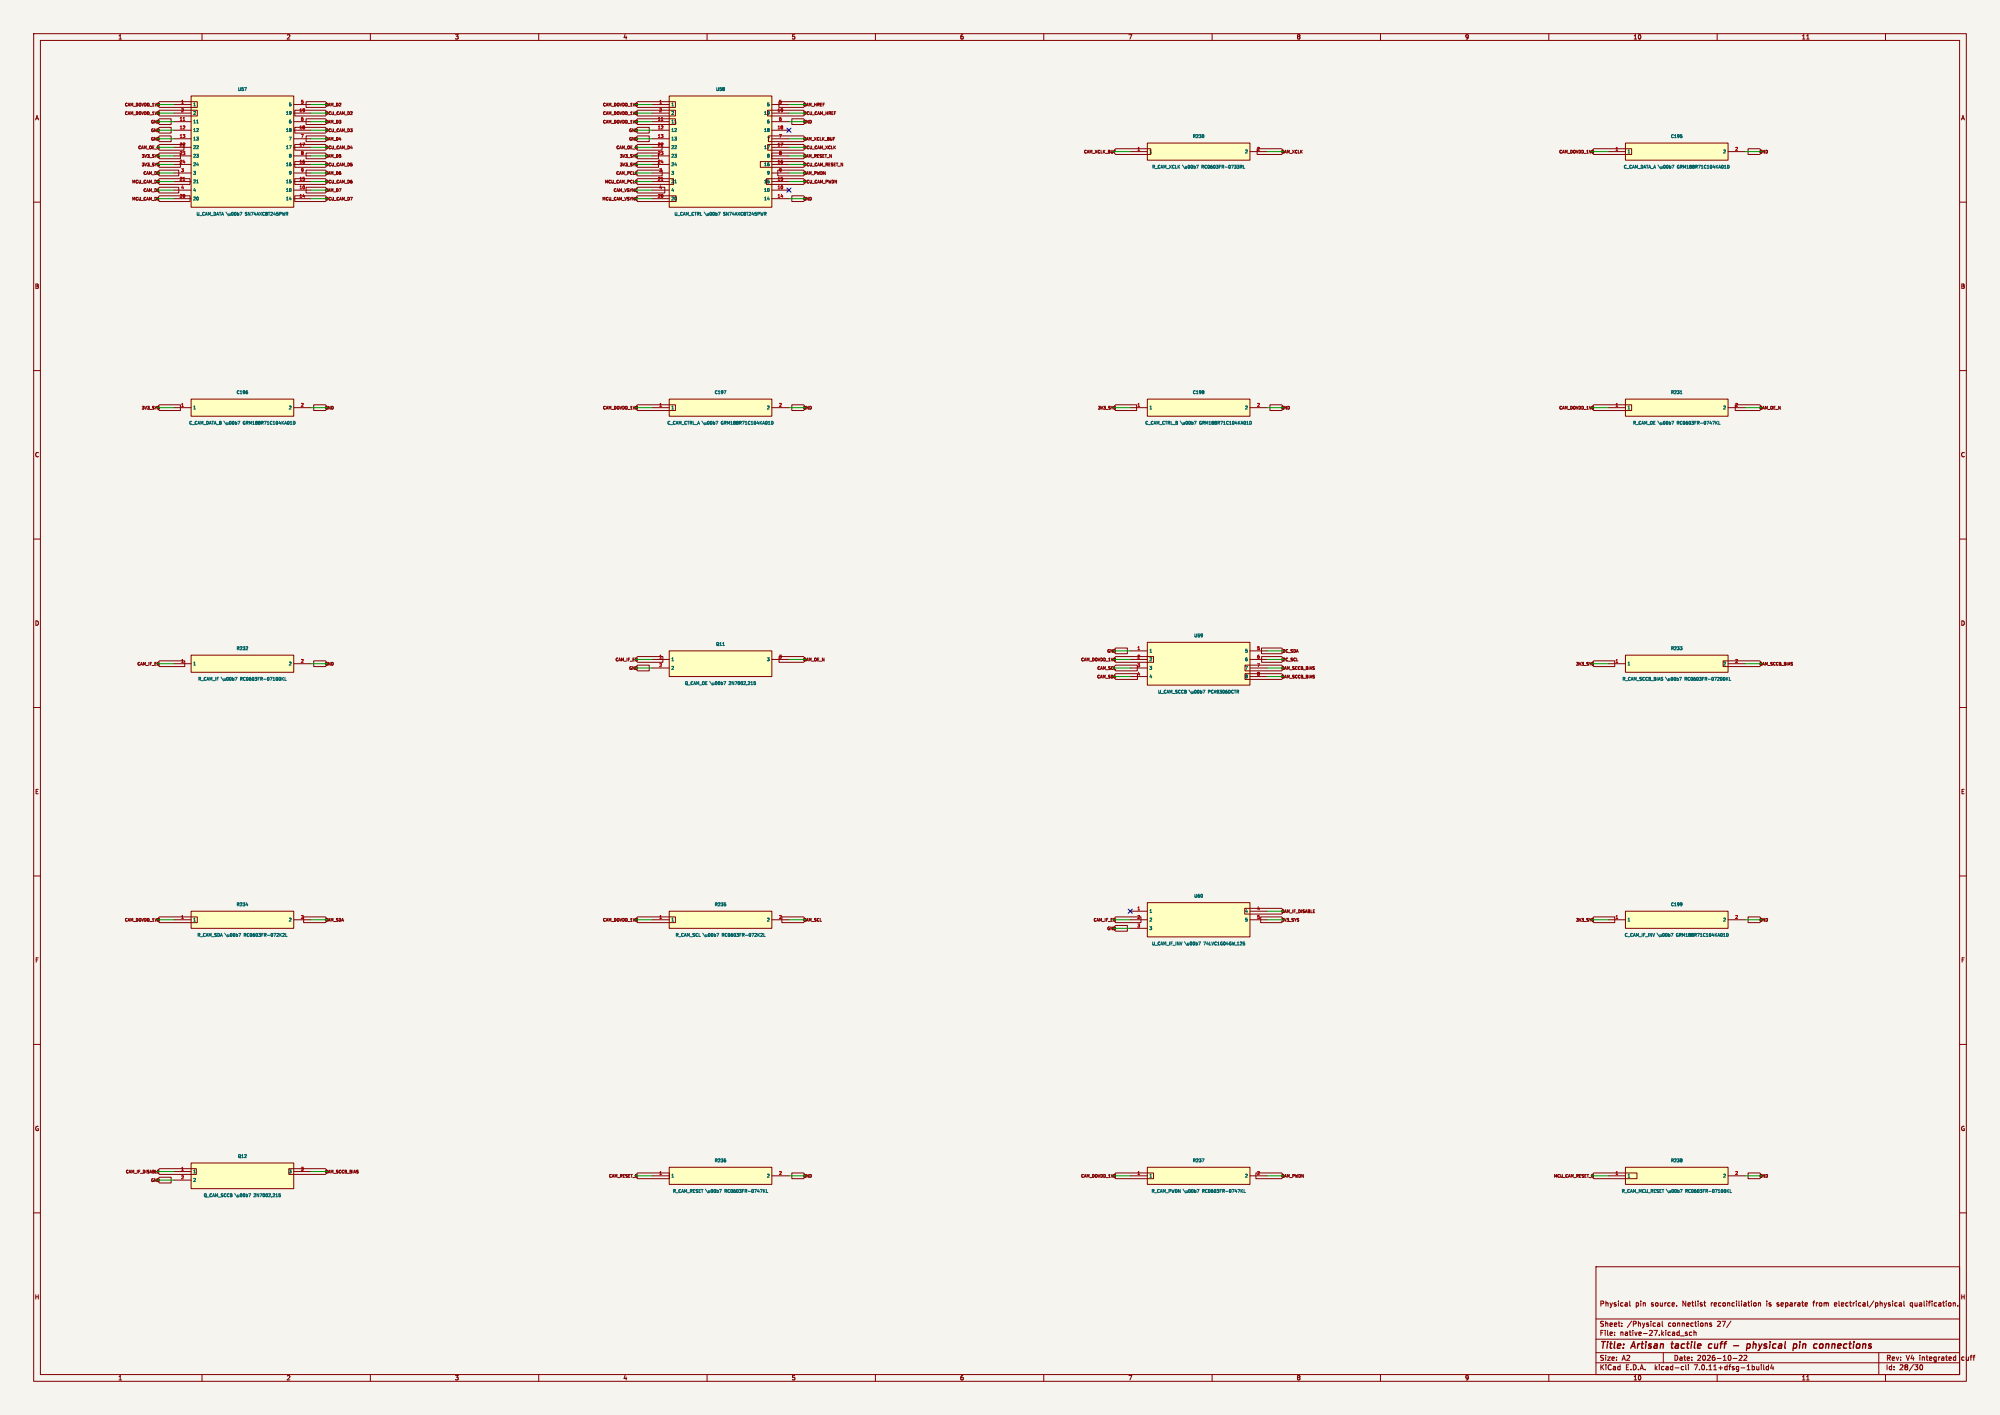
[picture p65: page 28]

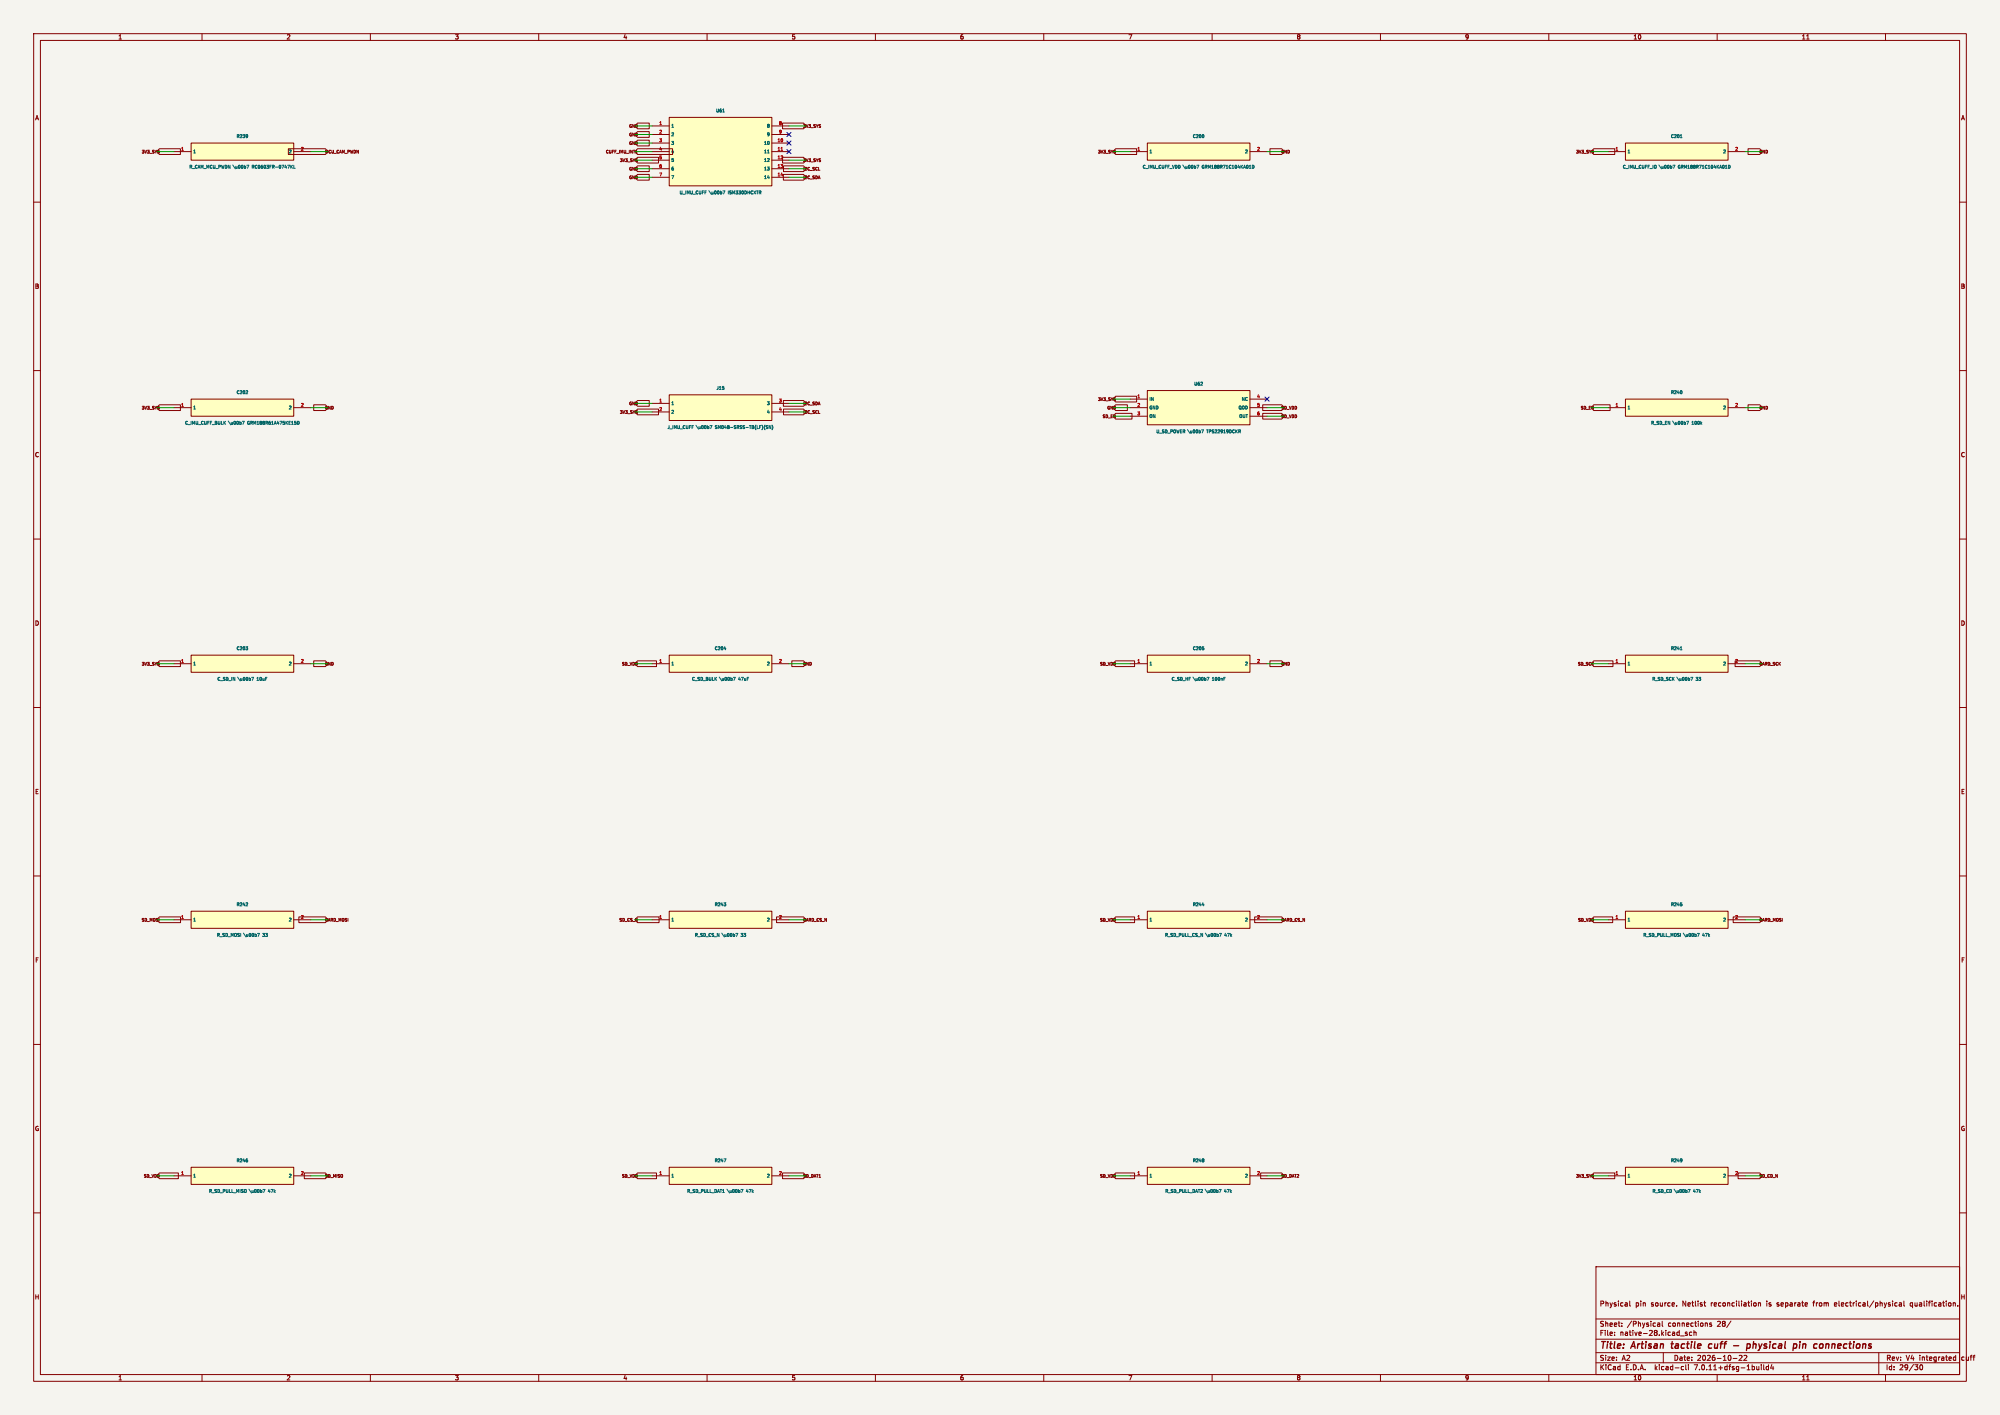
[picture p66: page 29]

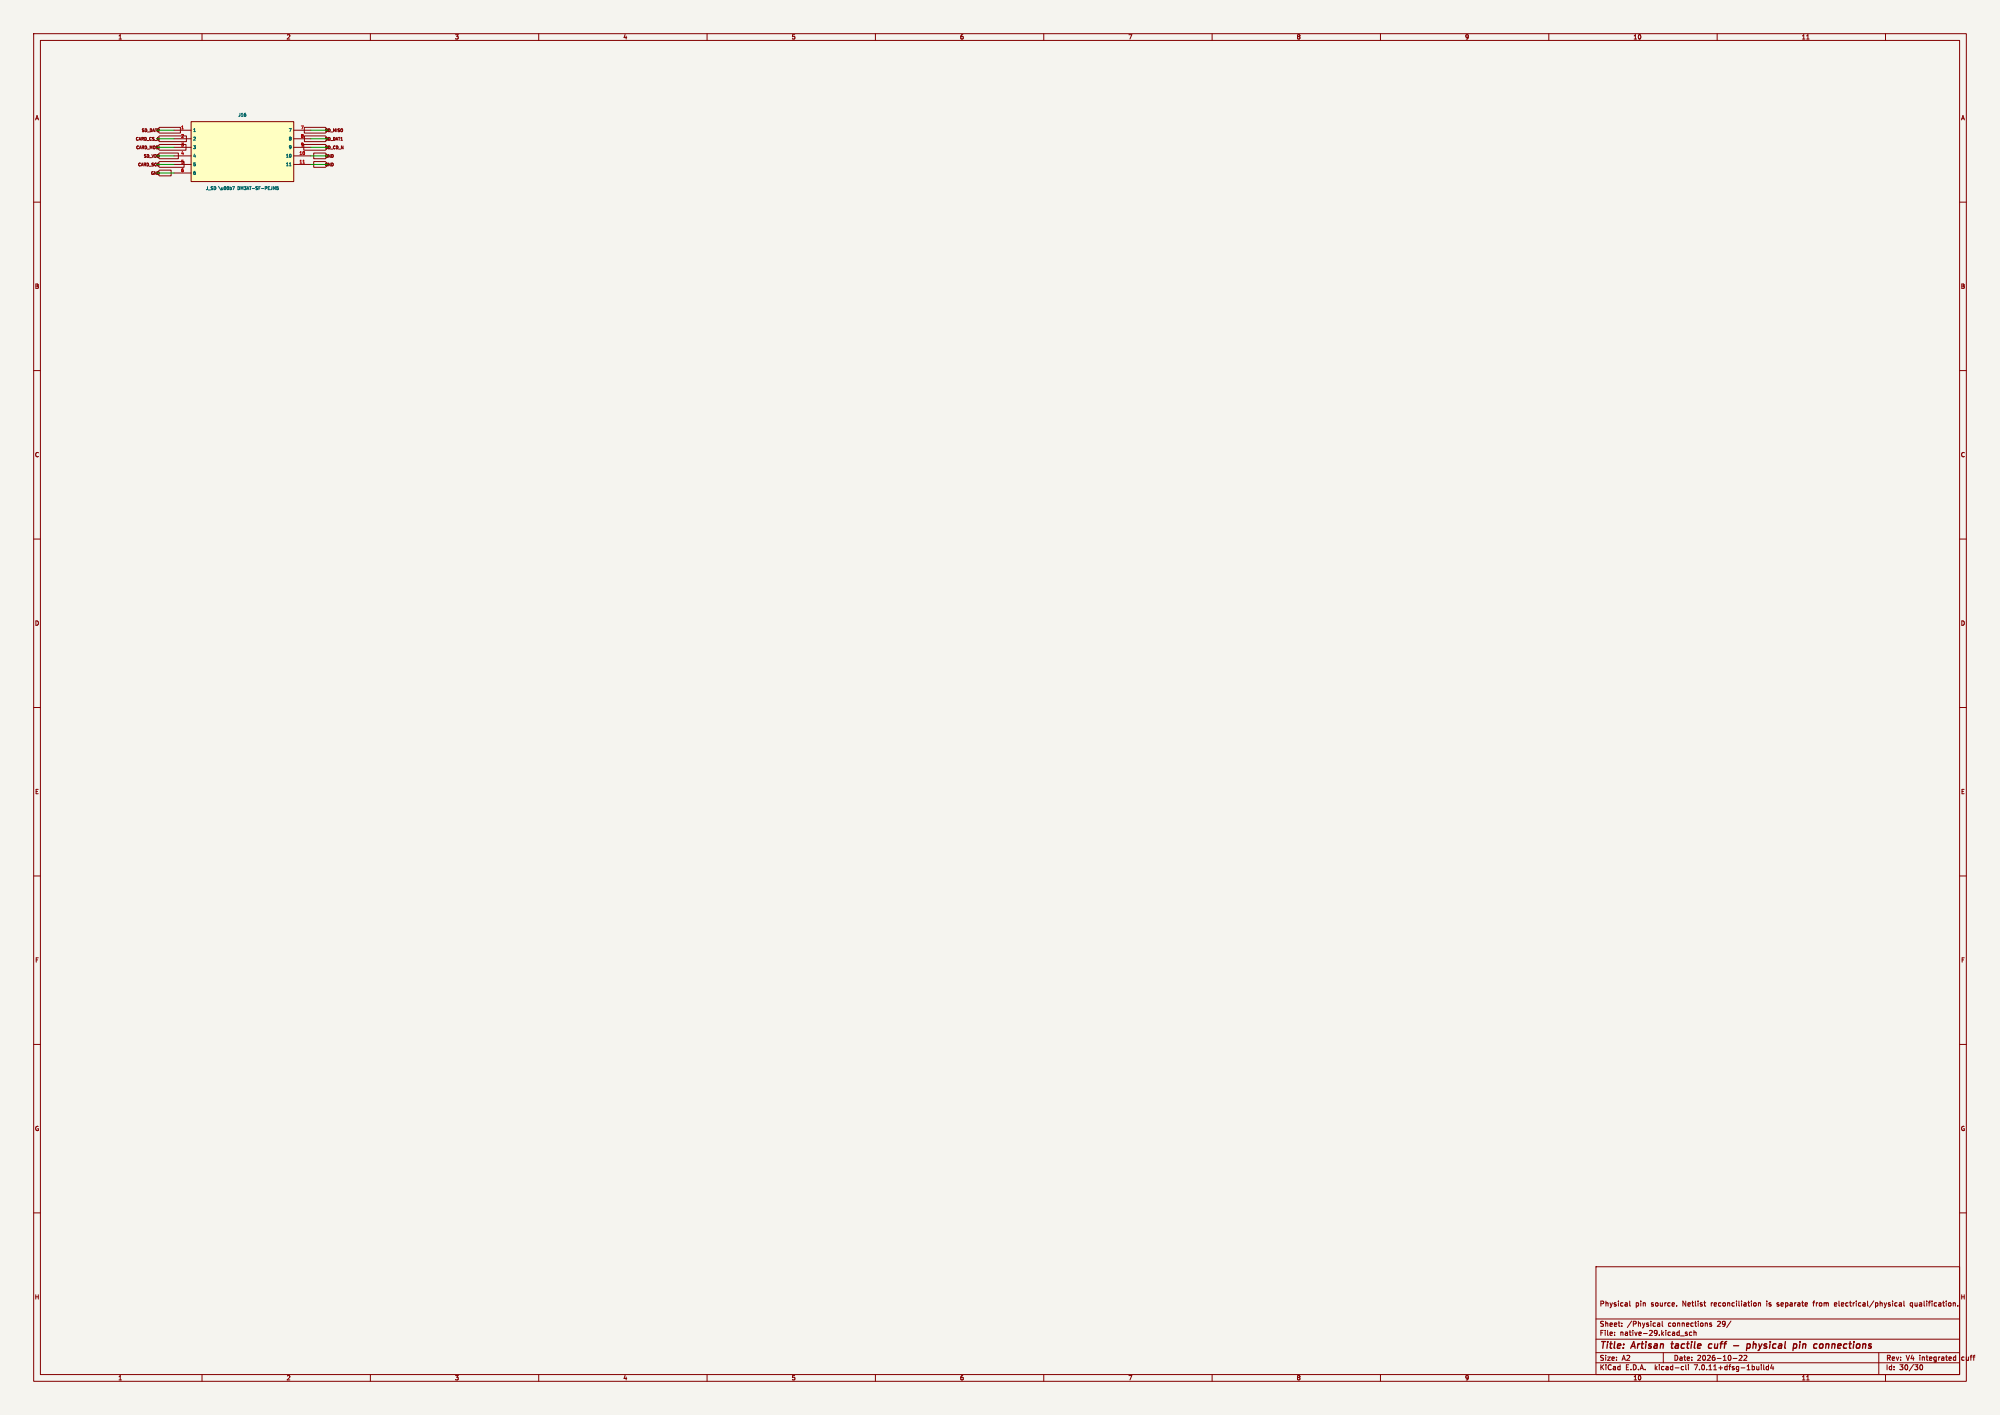
[picture p67: page 30]
