latintzar/tactile-glove/hardware/glove-v3/electrical/glove-v3-schematic.pdf

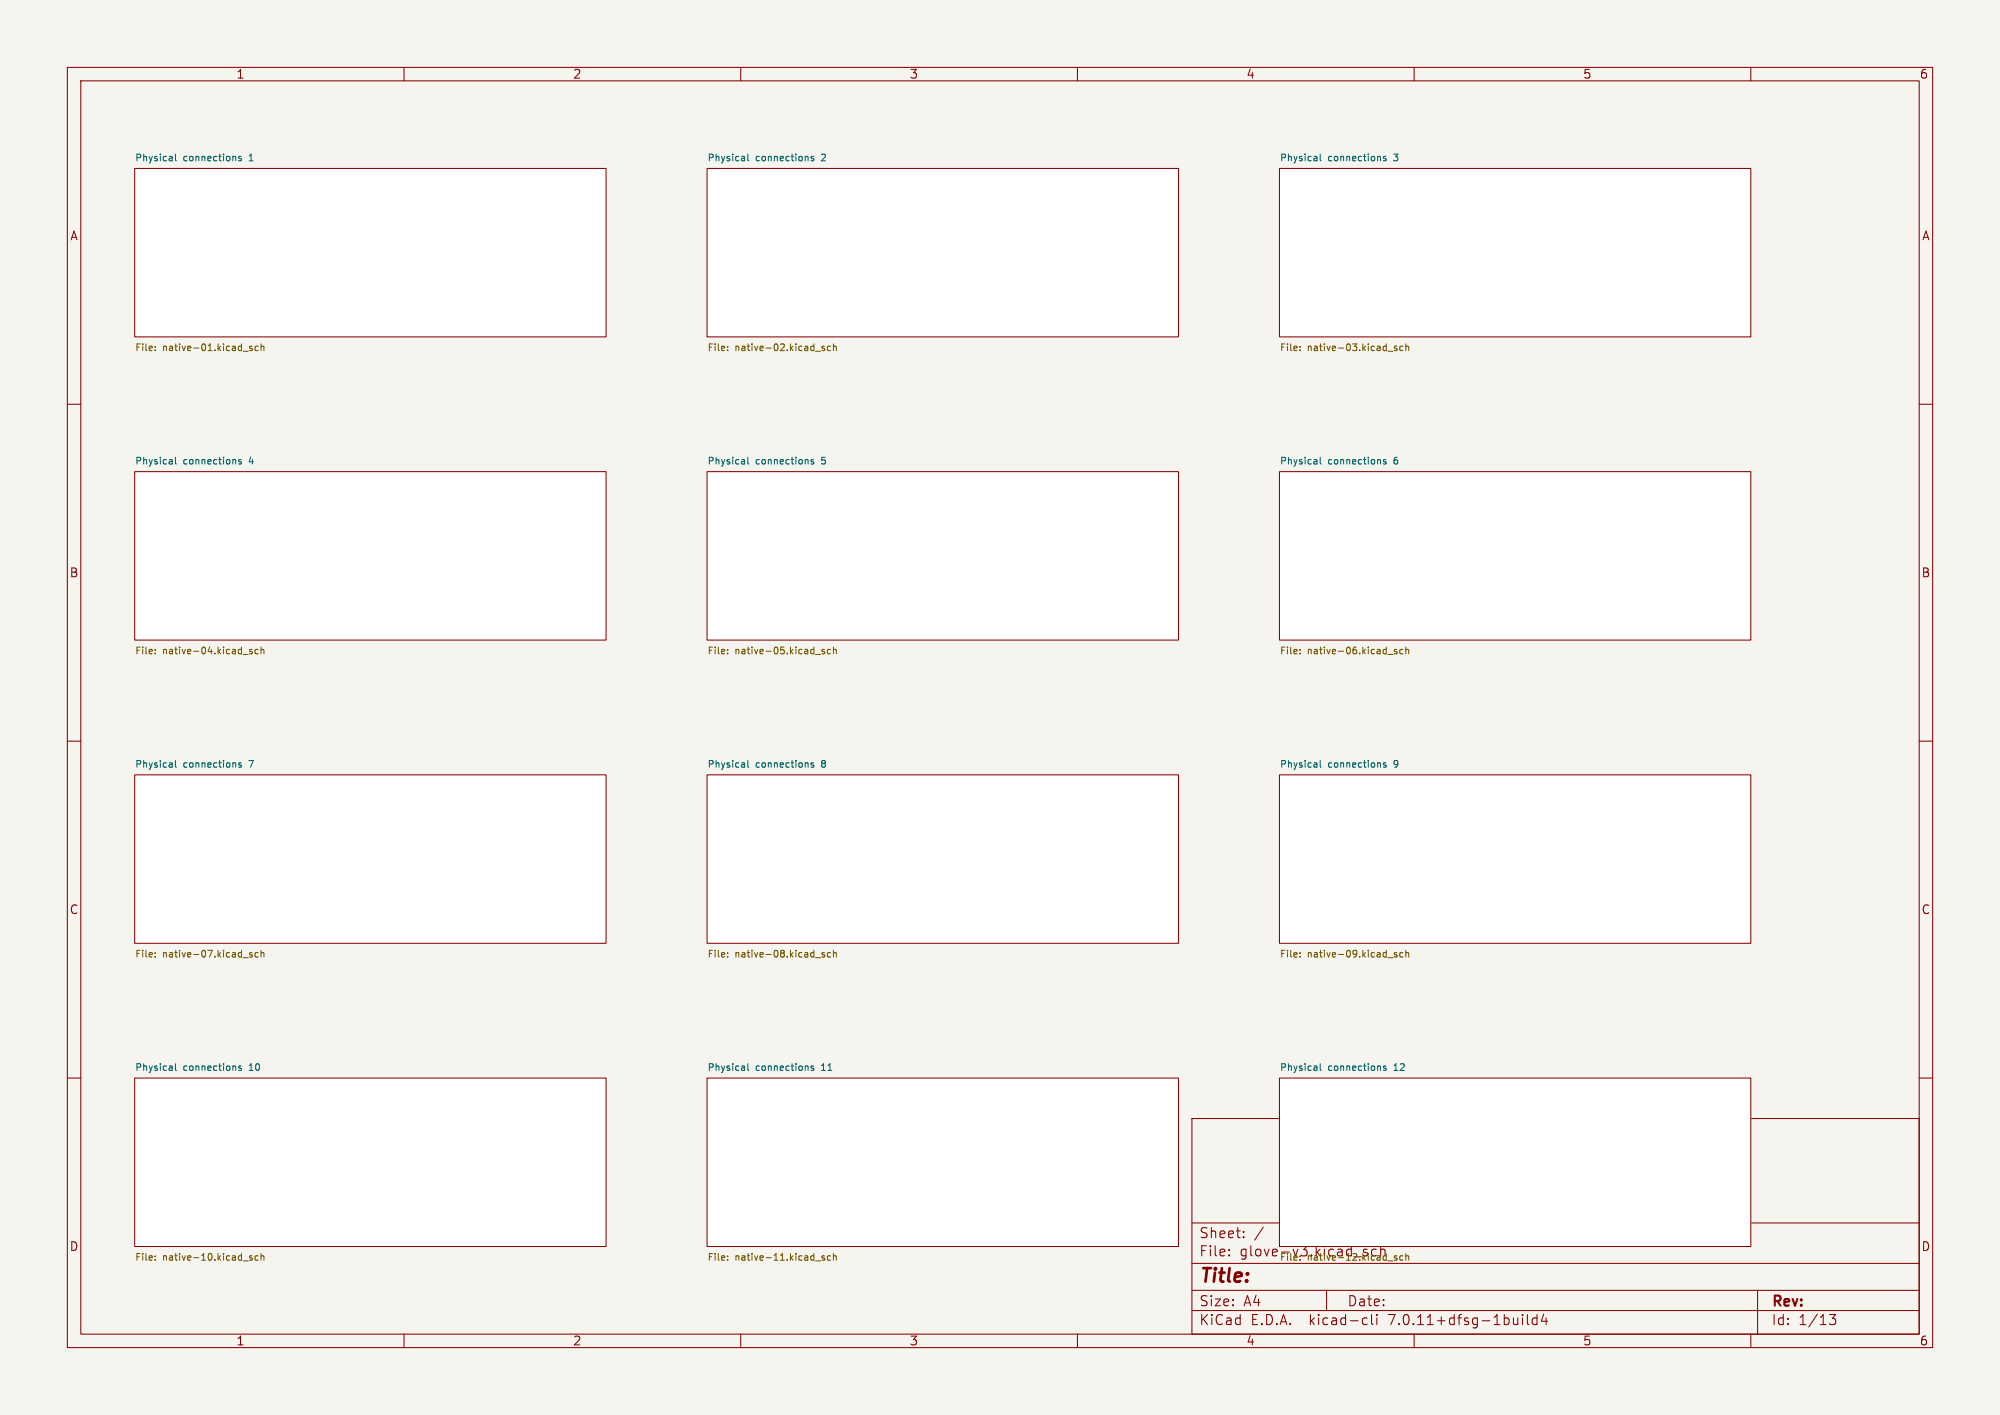
[picture p68: page 1]

Id: 1/13 Title: File: glove-v3.kicad_sch Sheet: /

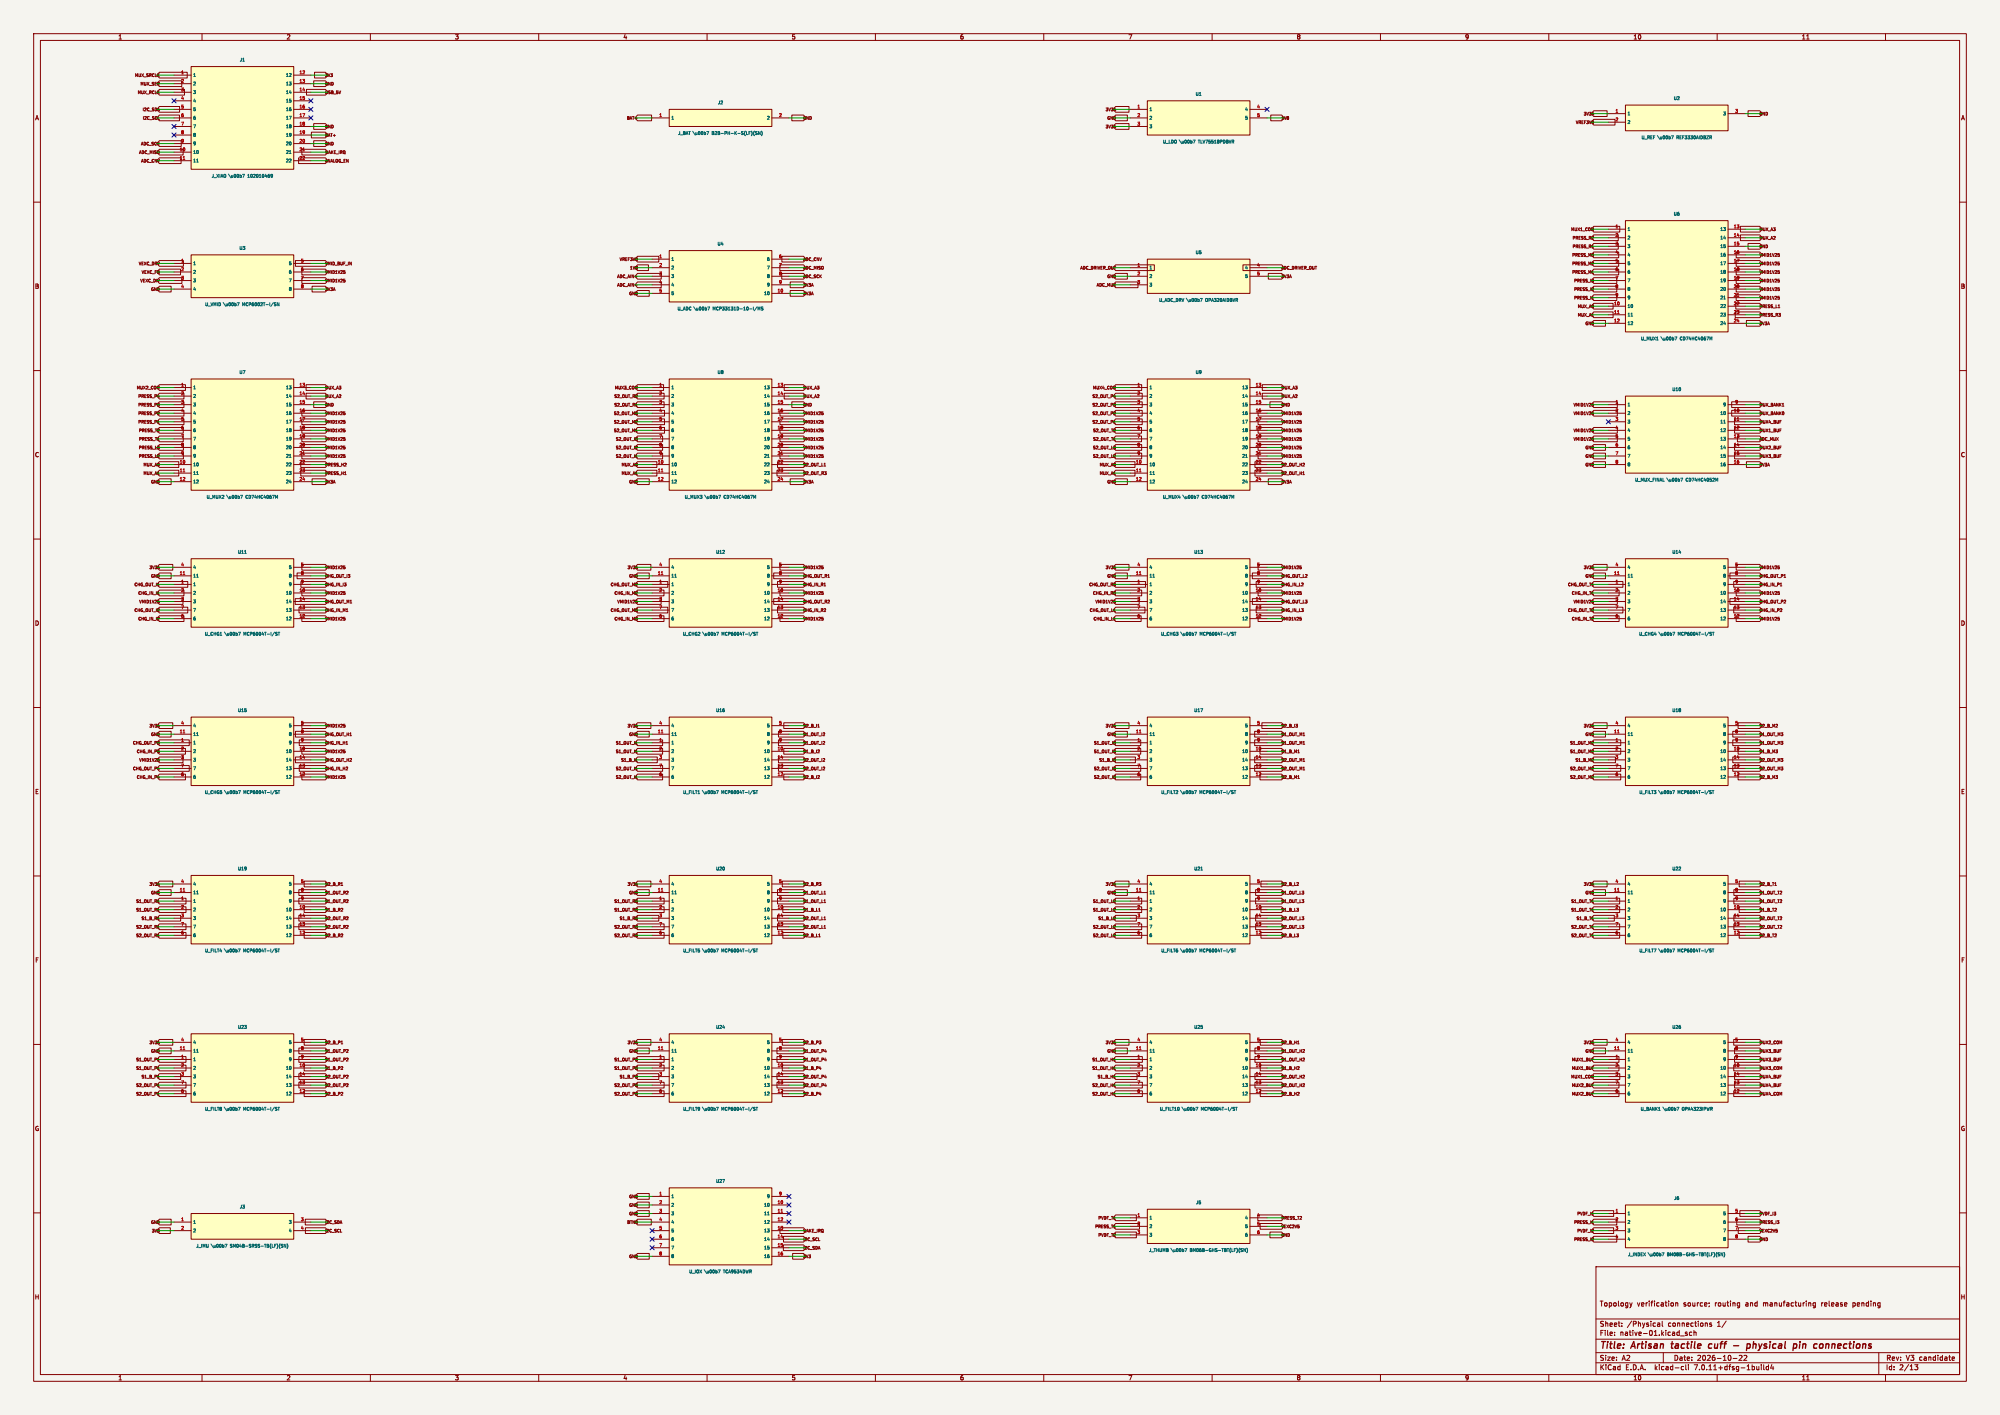
[picture p69: page 2]

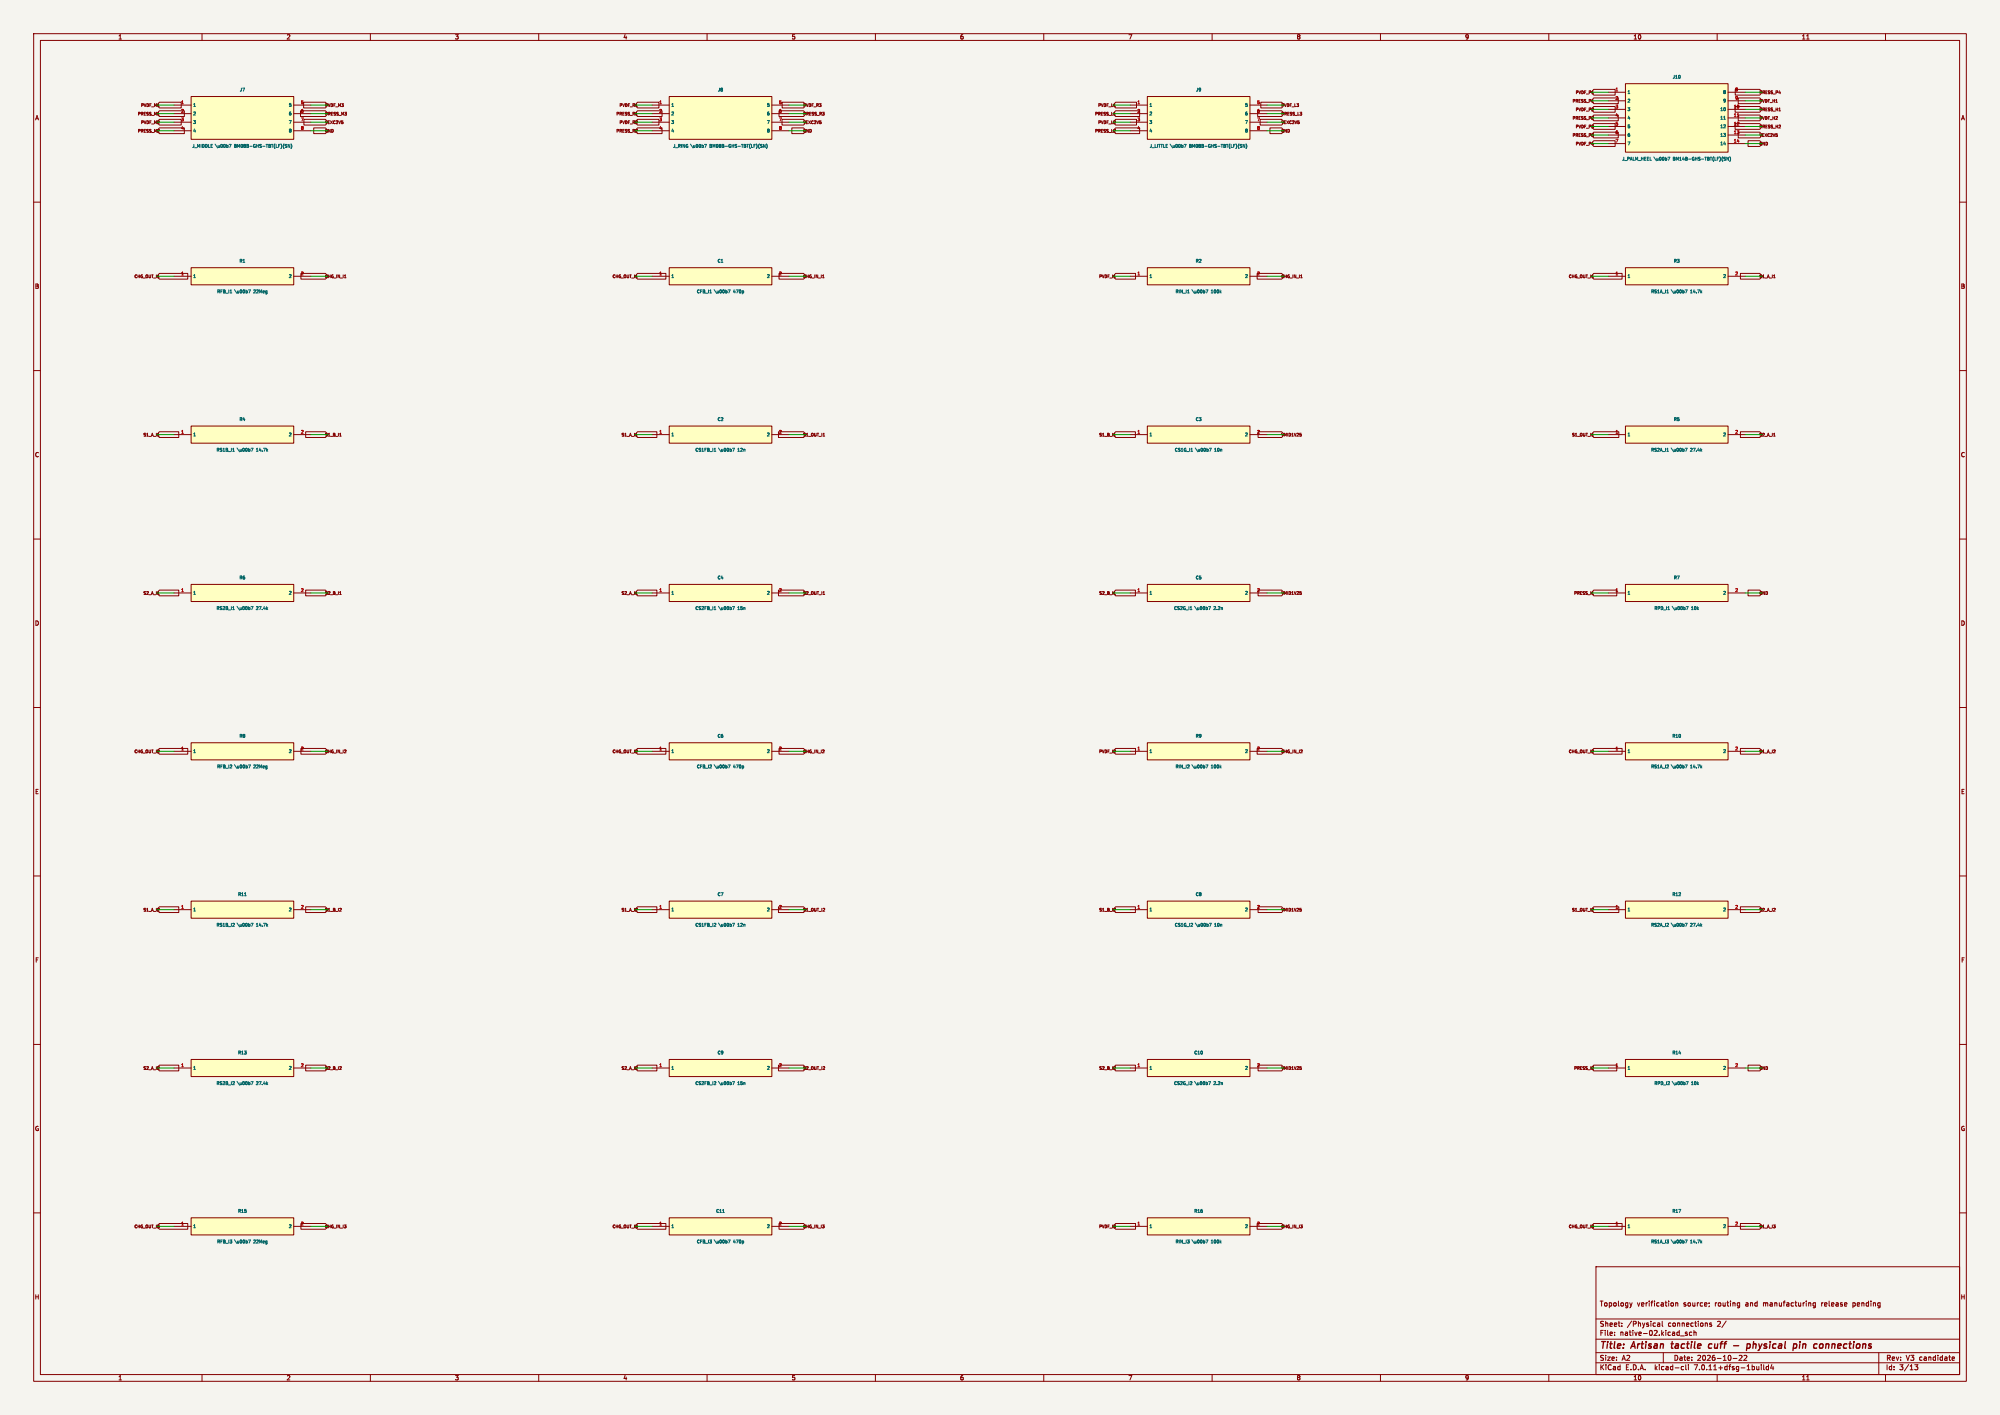
[picture p70: page 3]

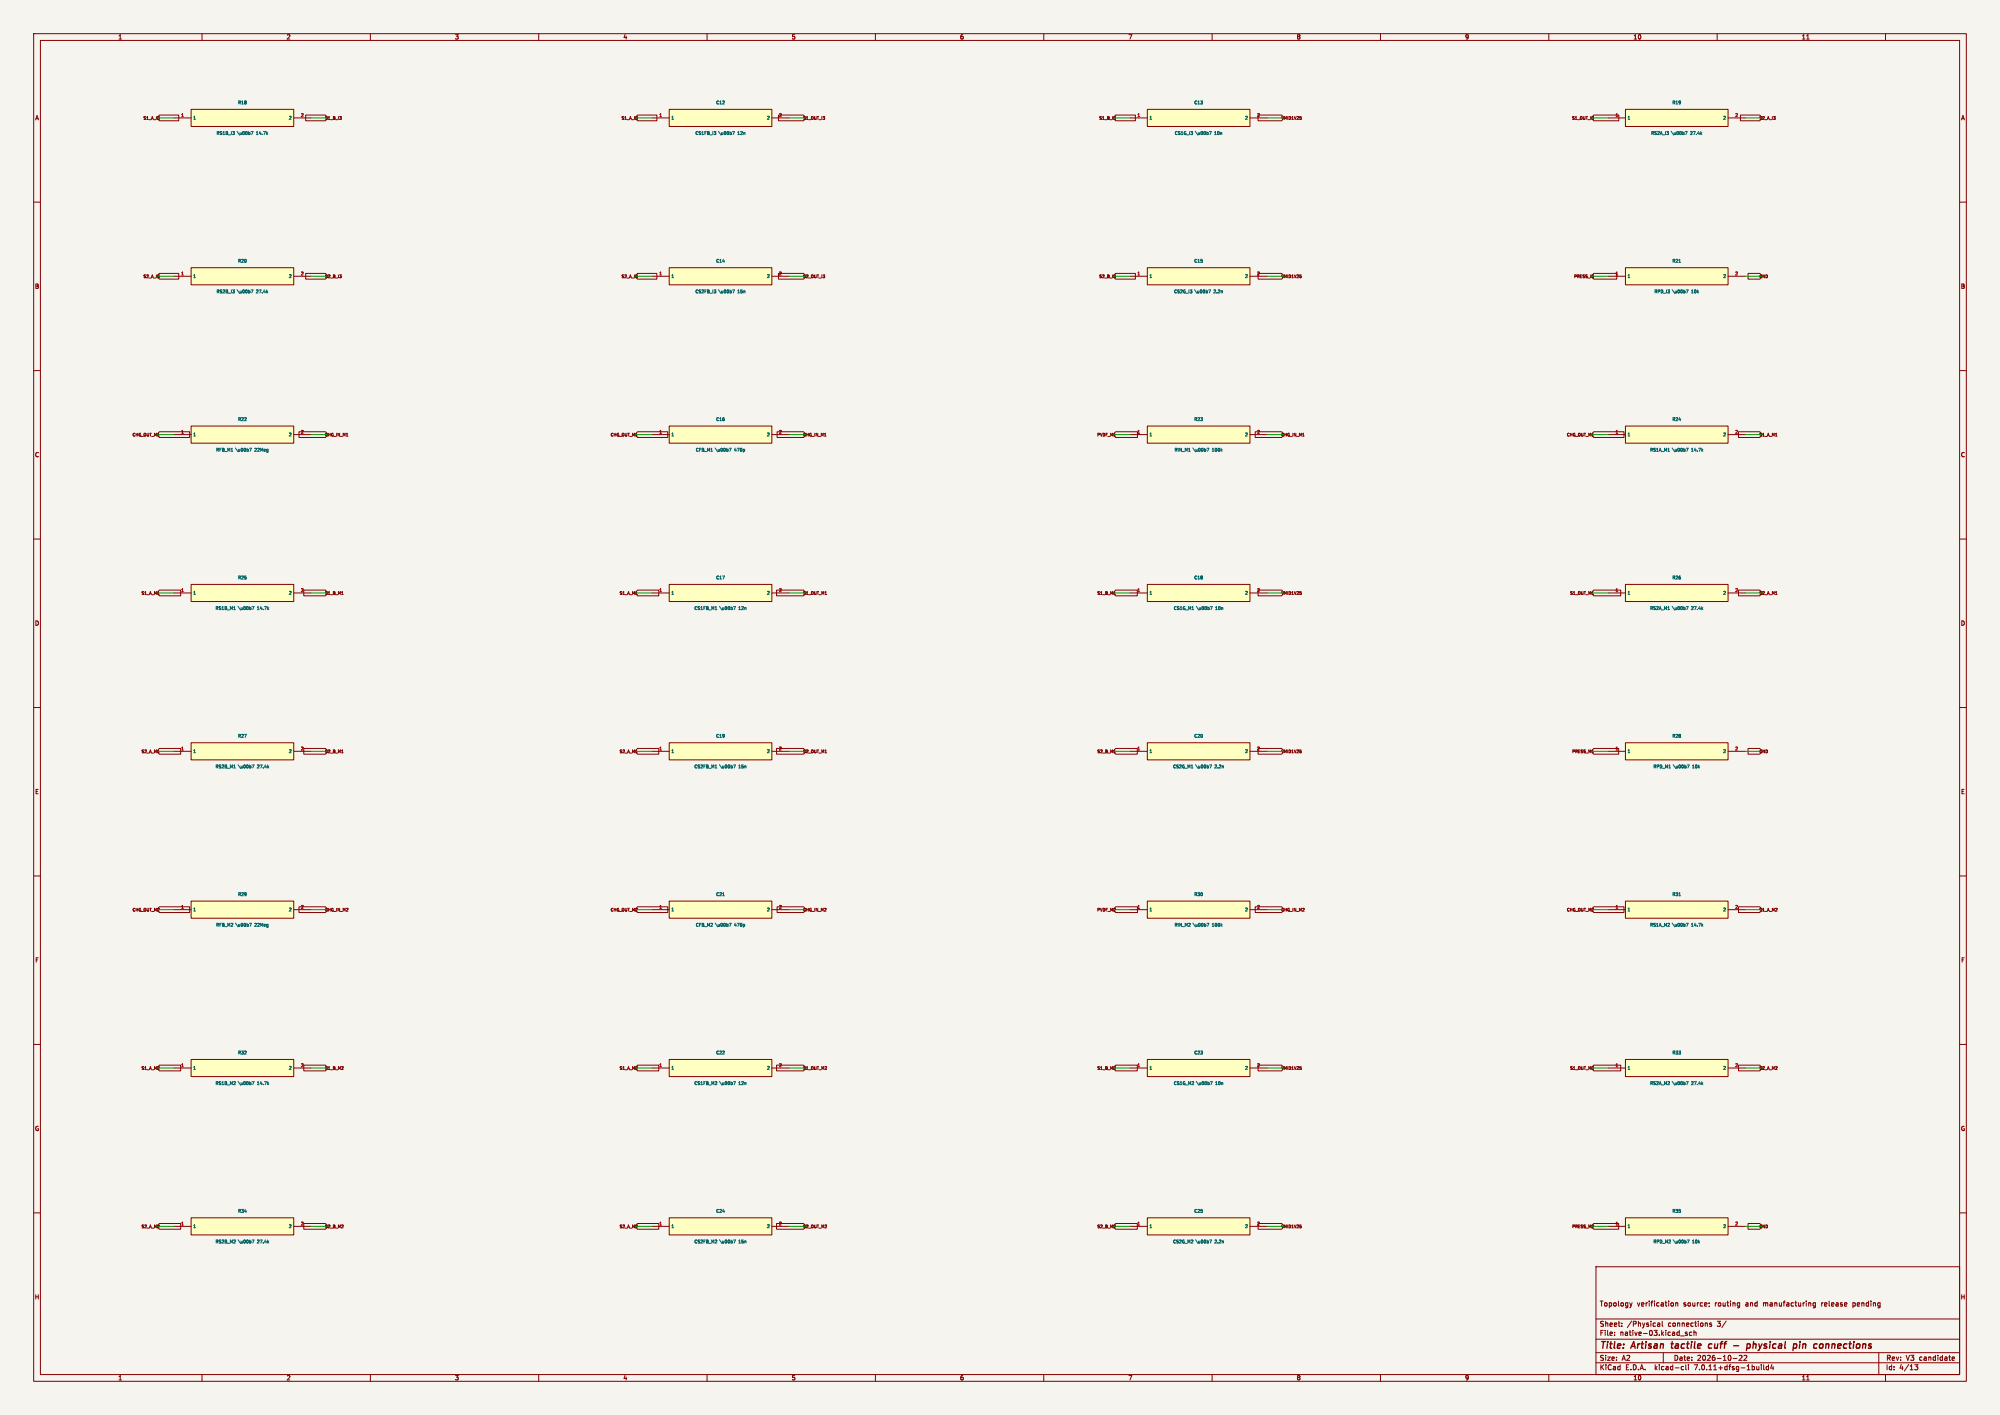
[picture p71: page 4]

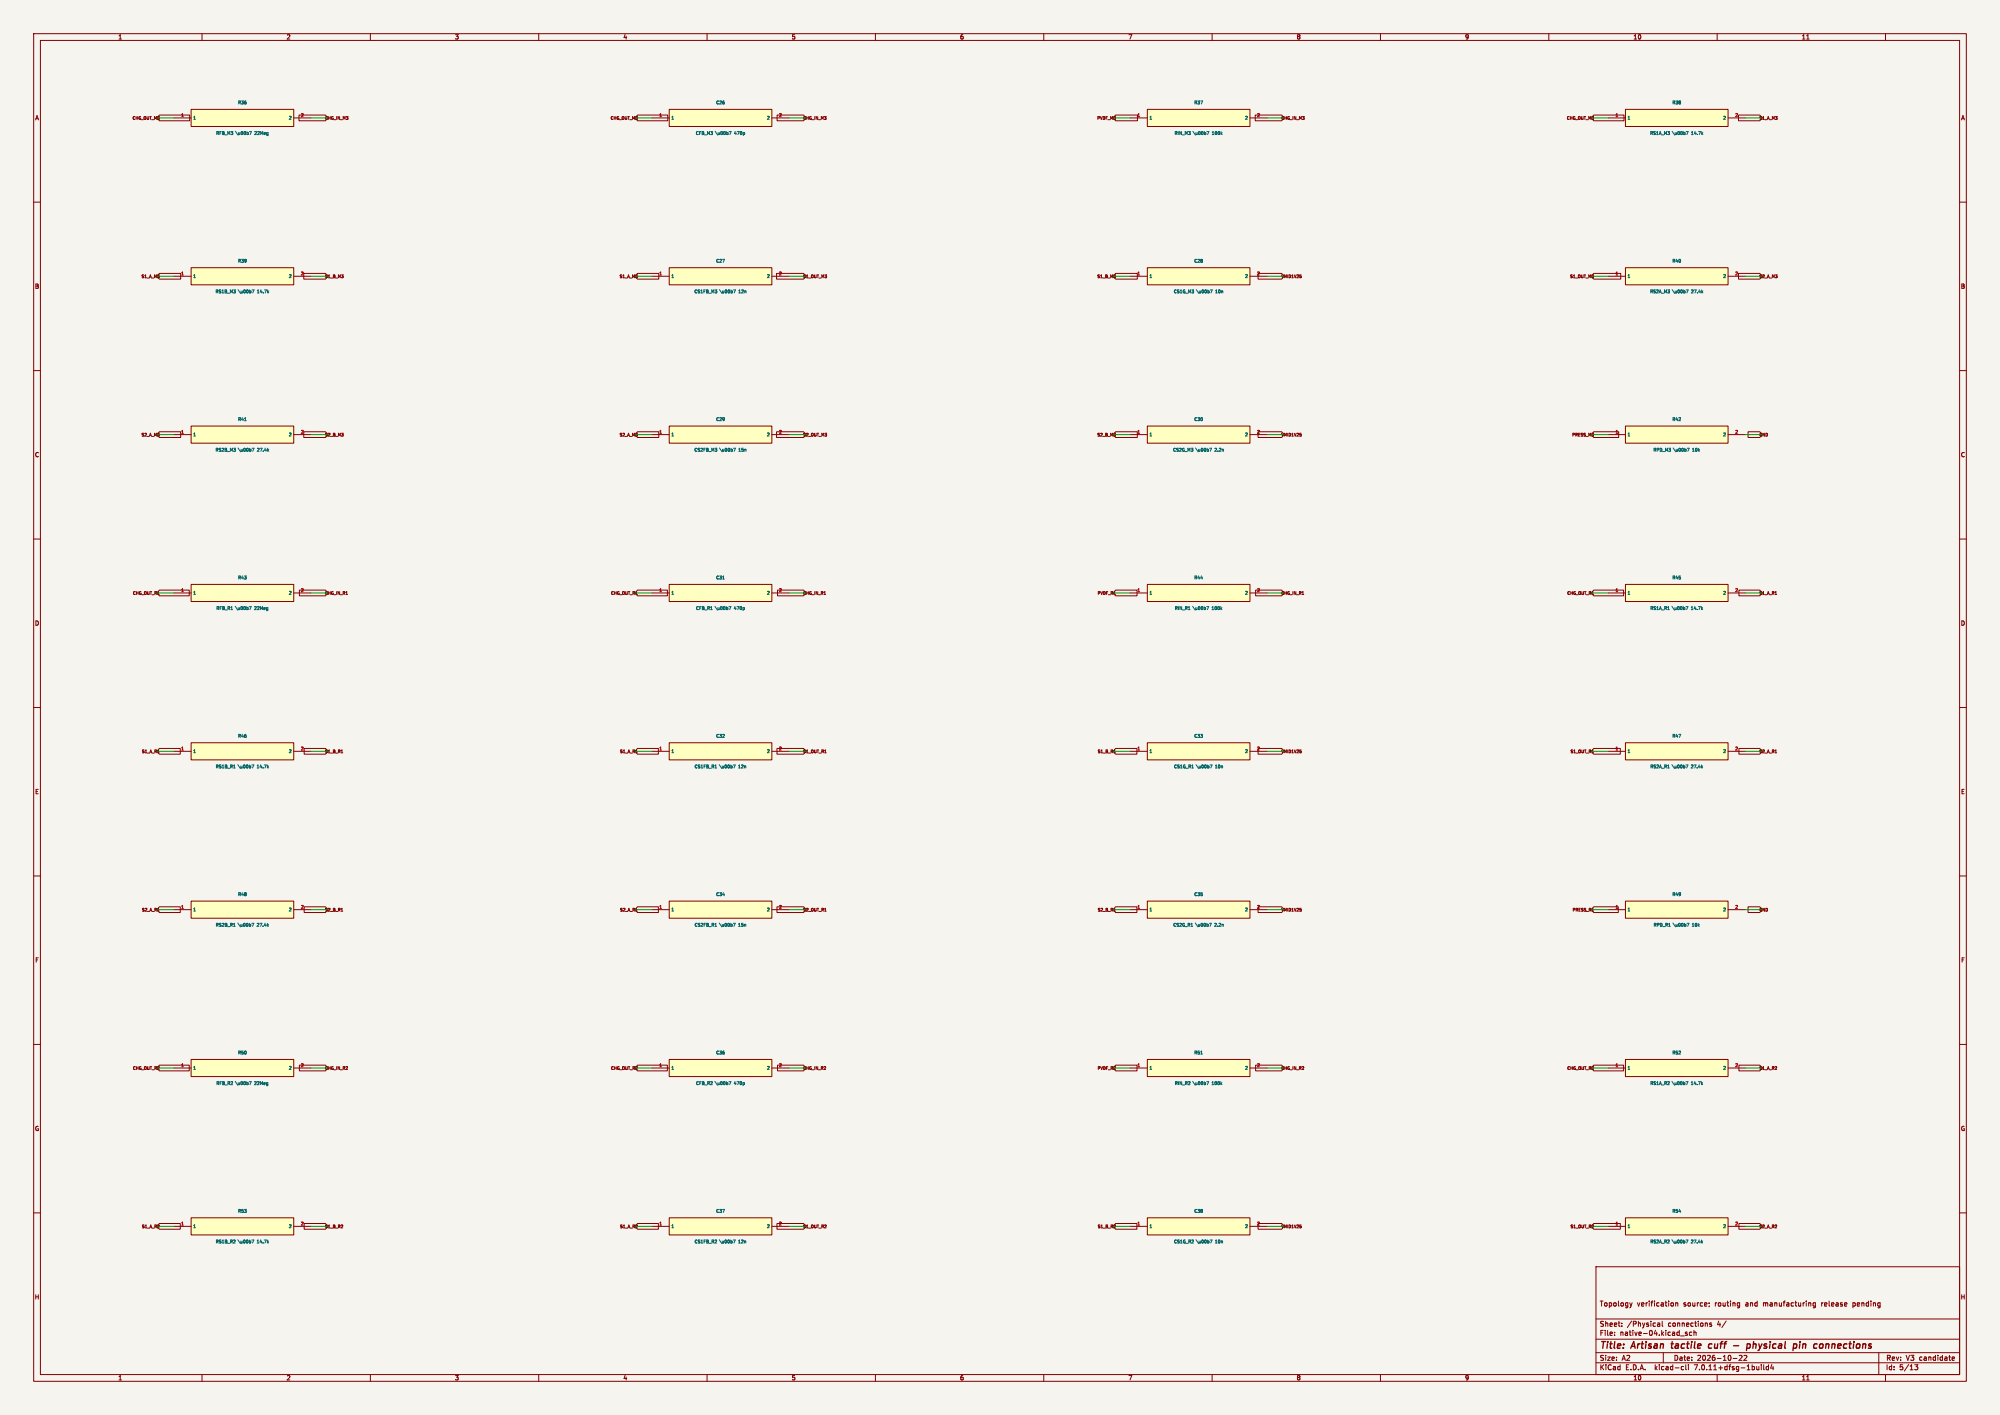
[picture p72: page 5]

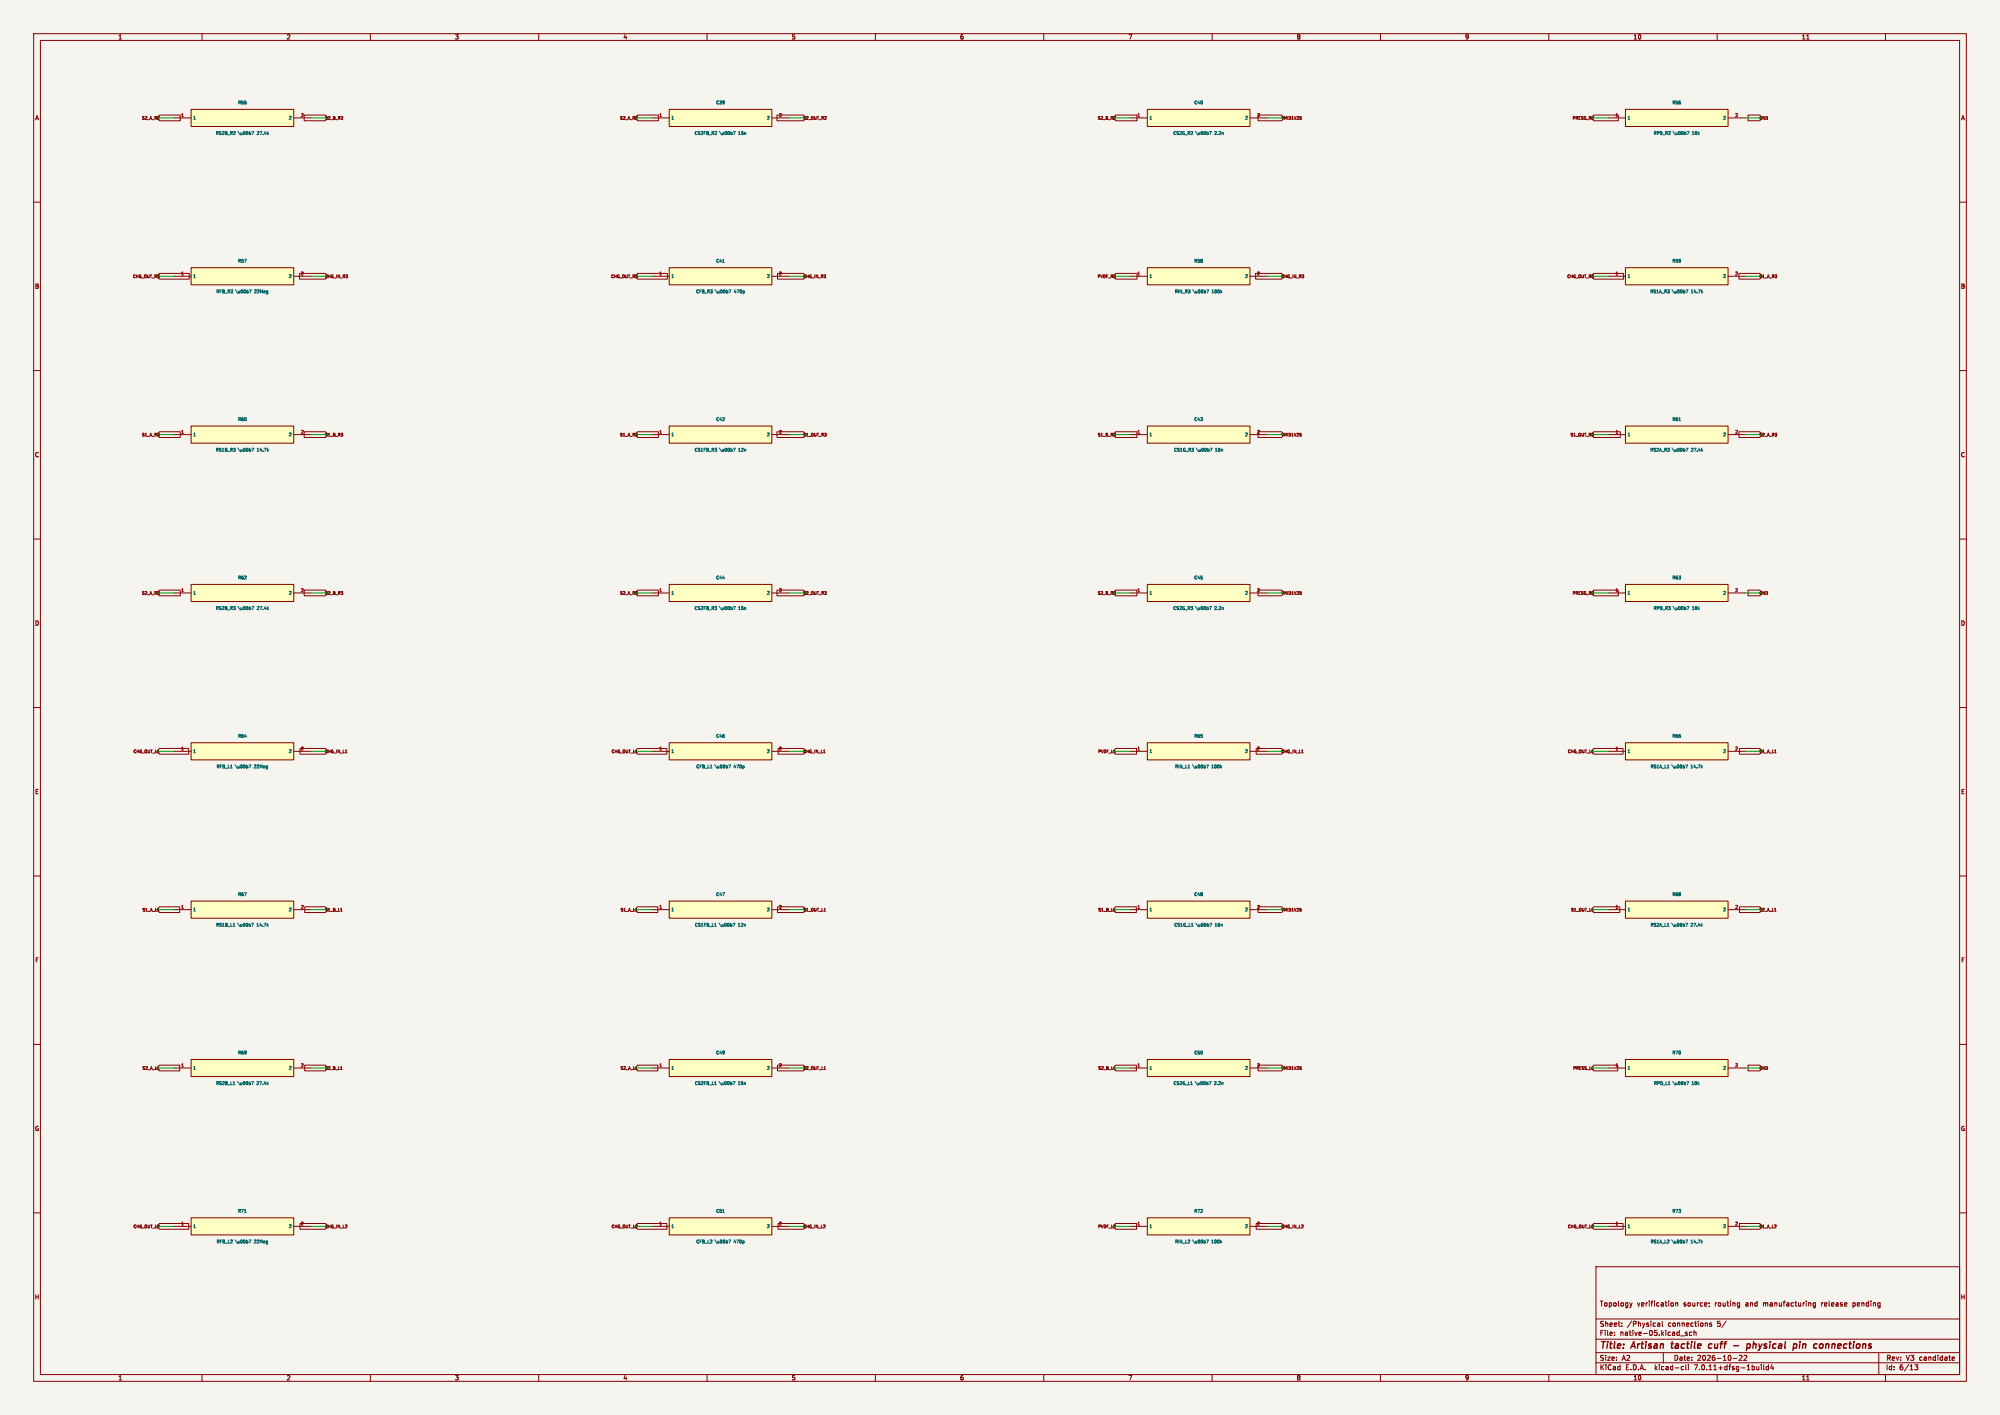
[picture p73: page 6]

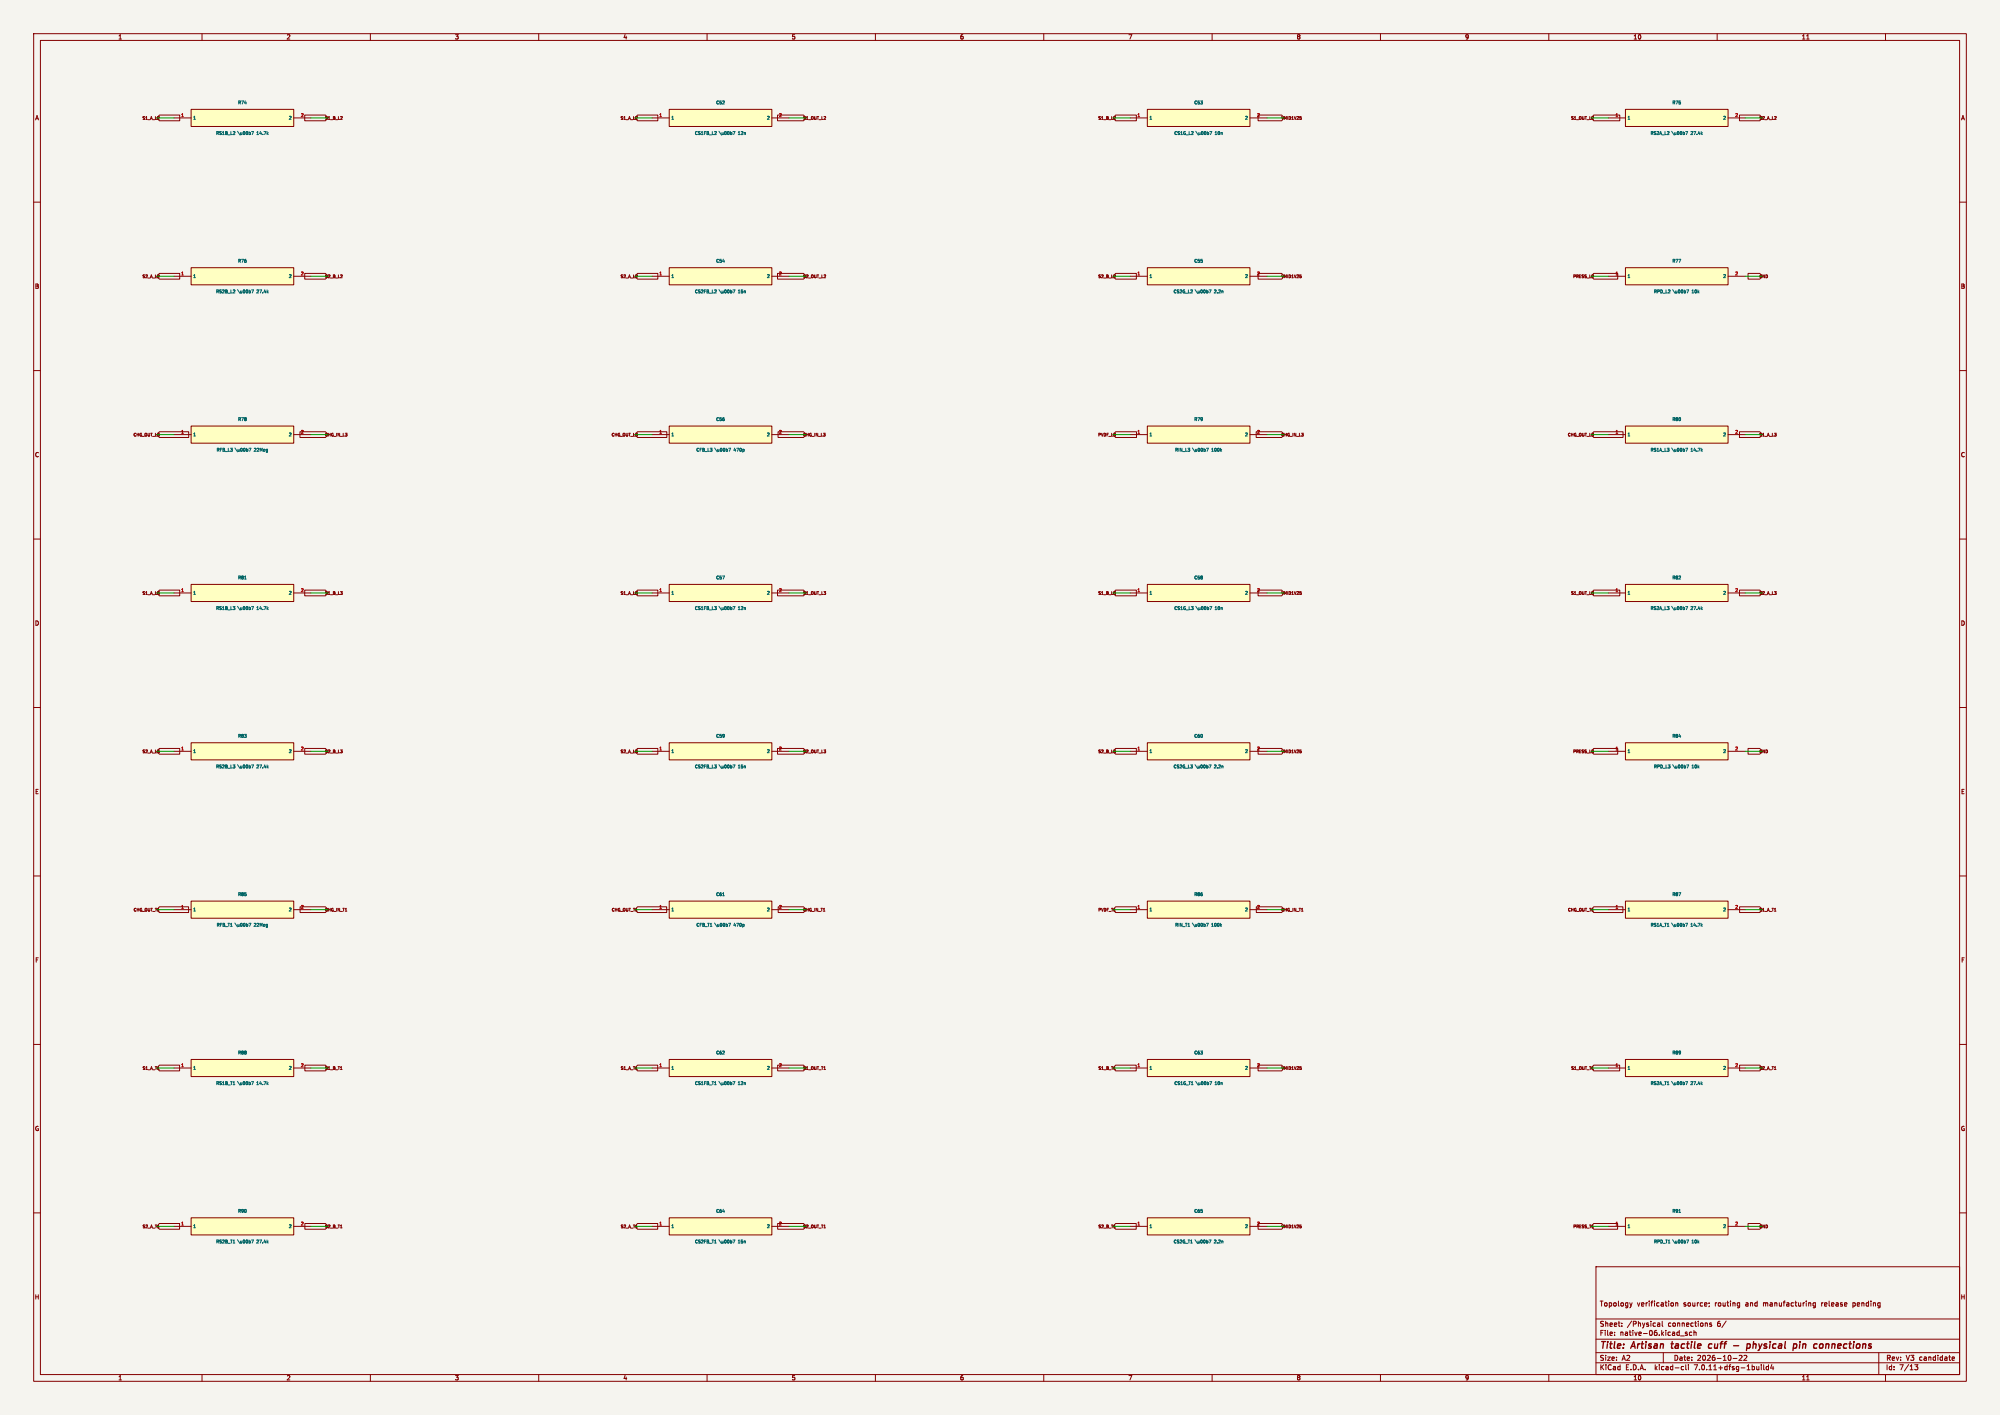
[picture p74: page 7]

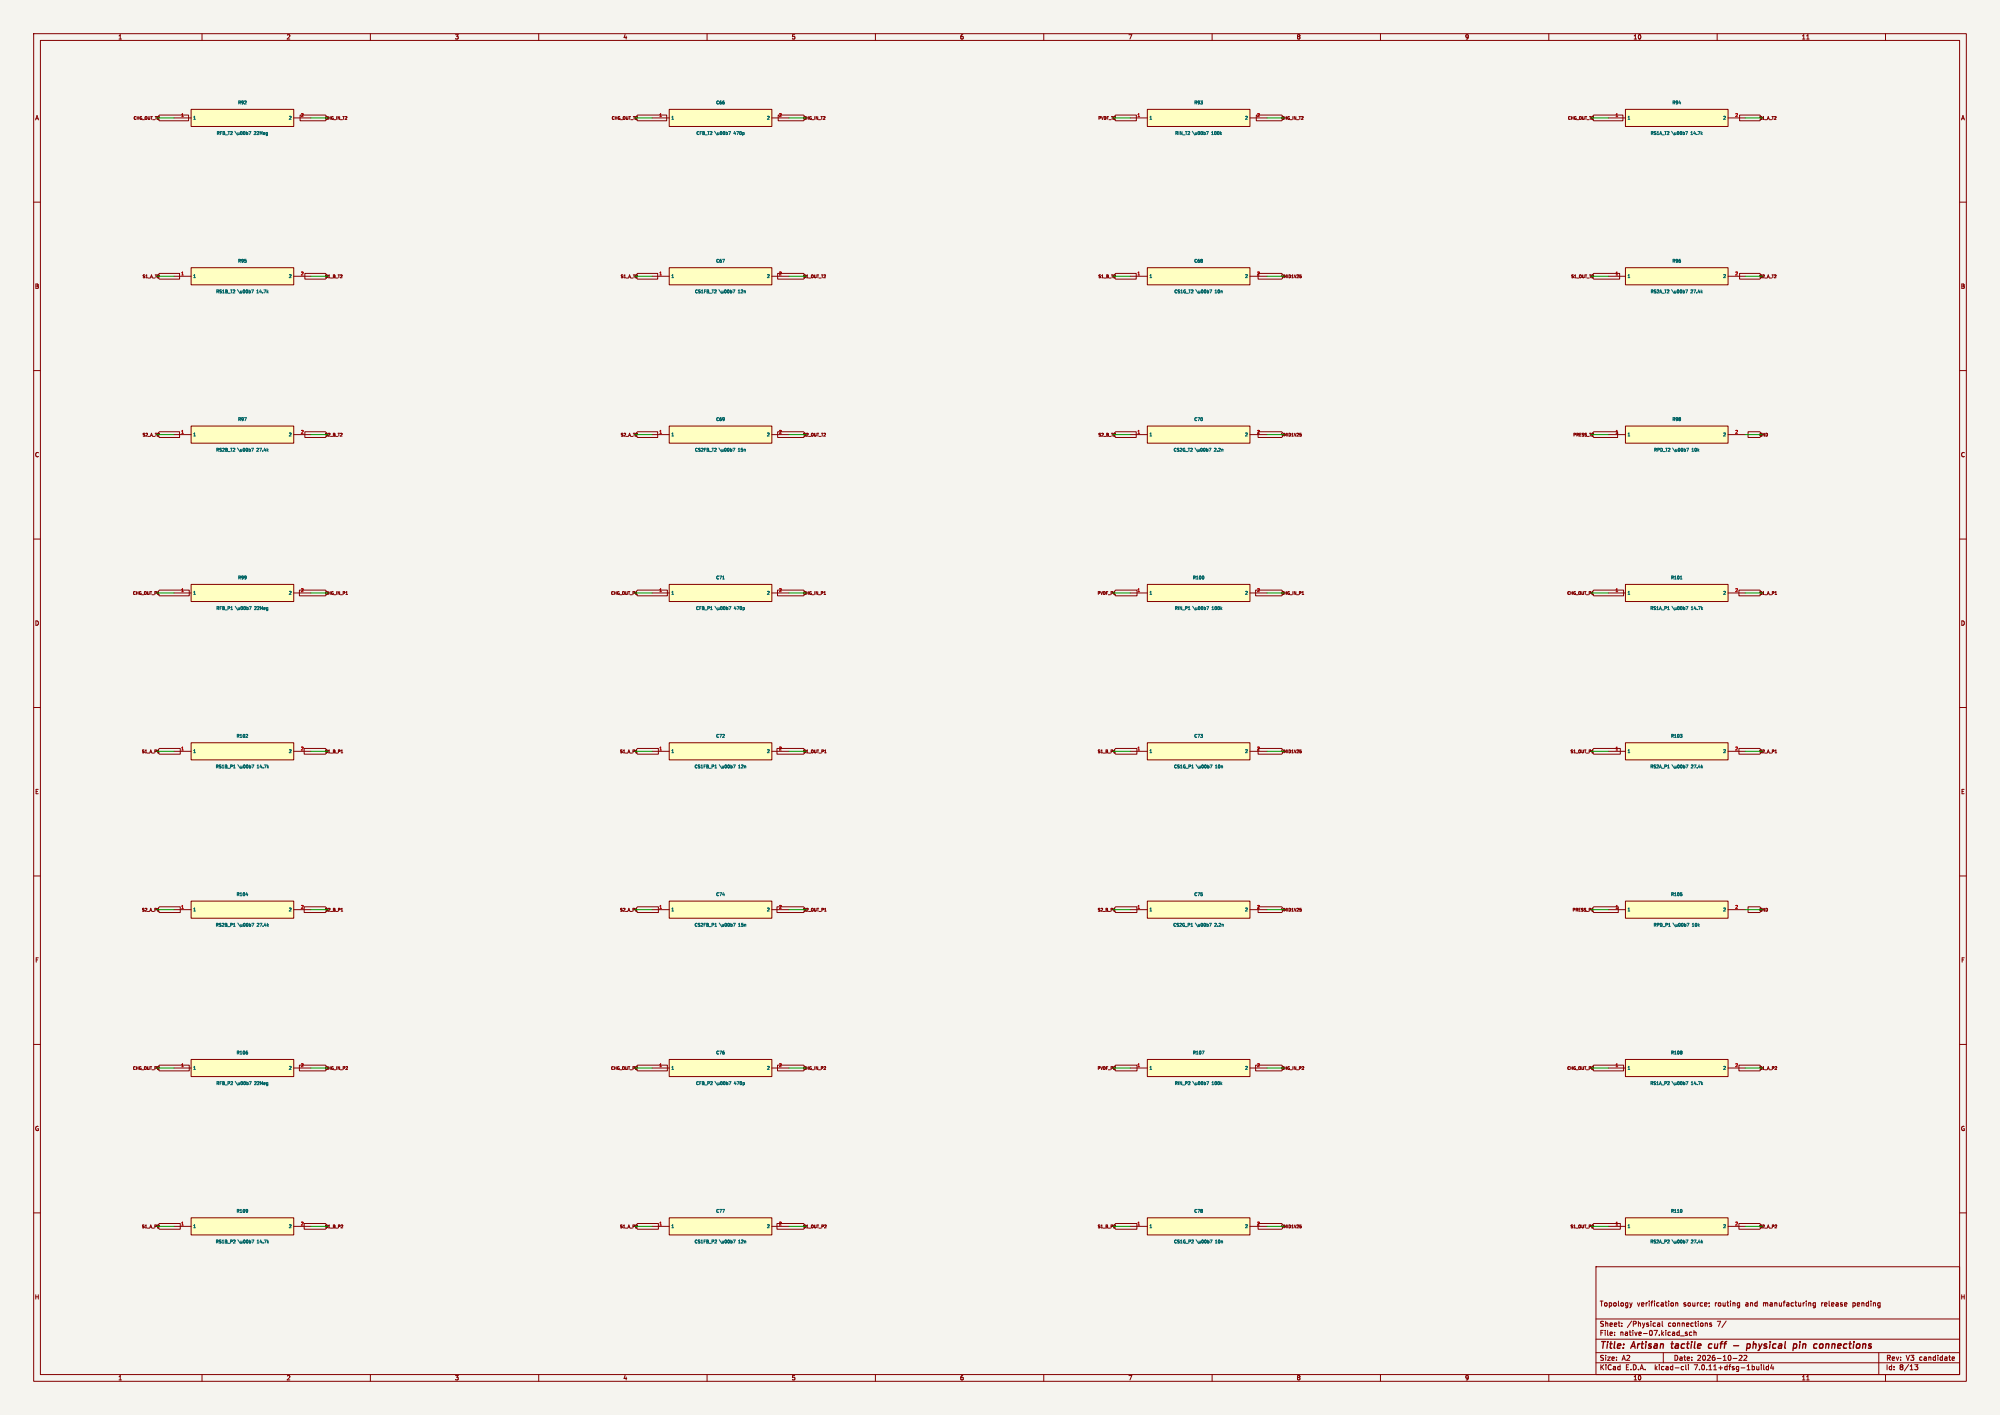
[picture p75: page 8]

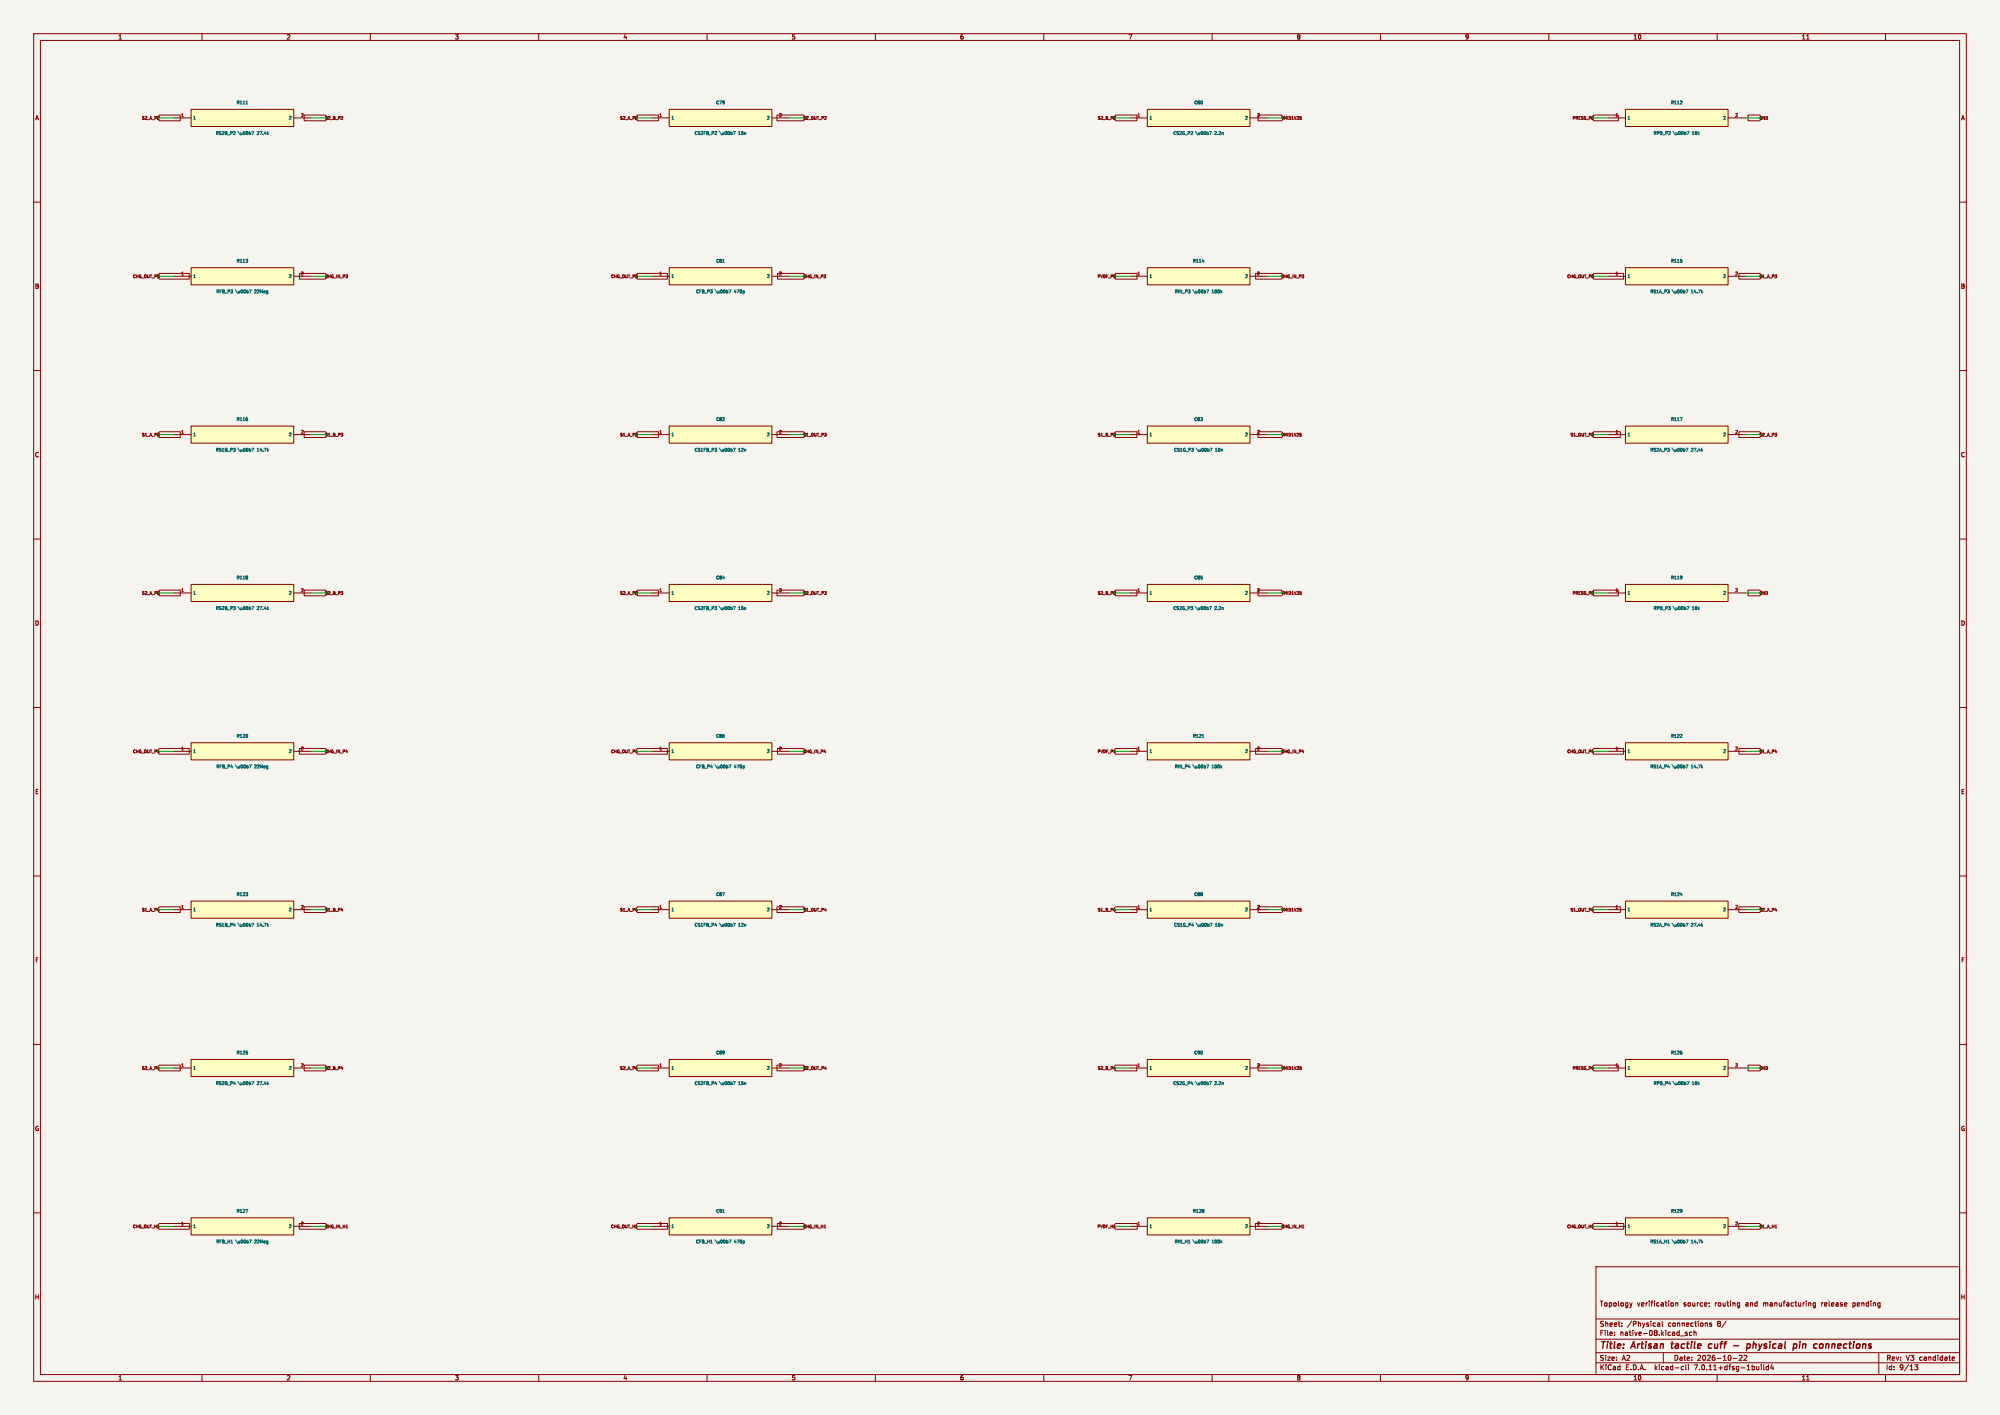
[picture p76: page 9]

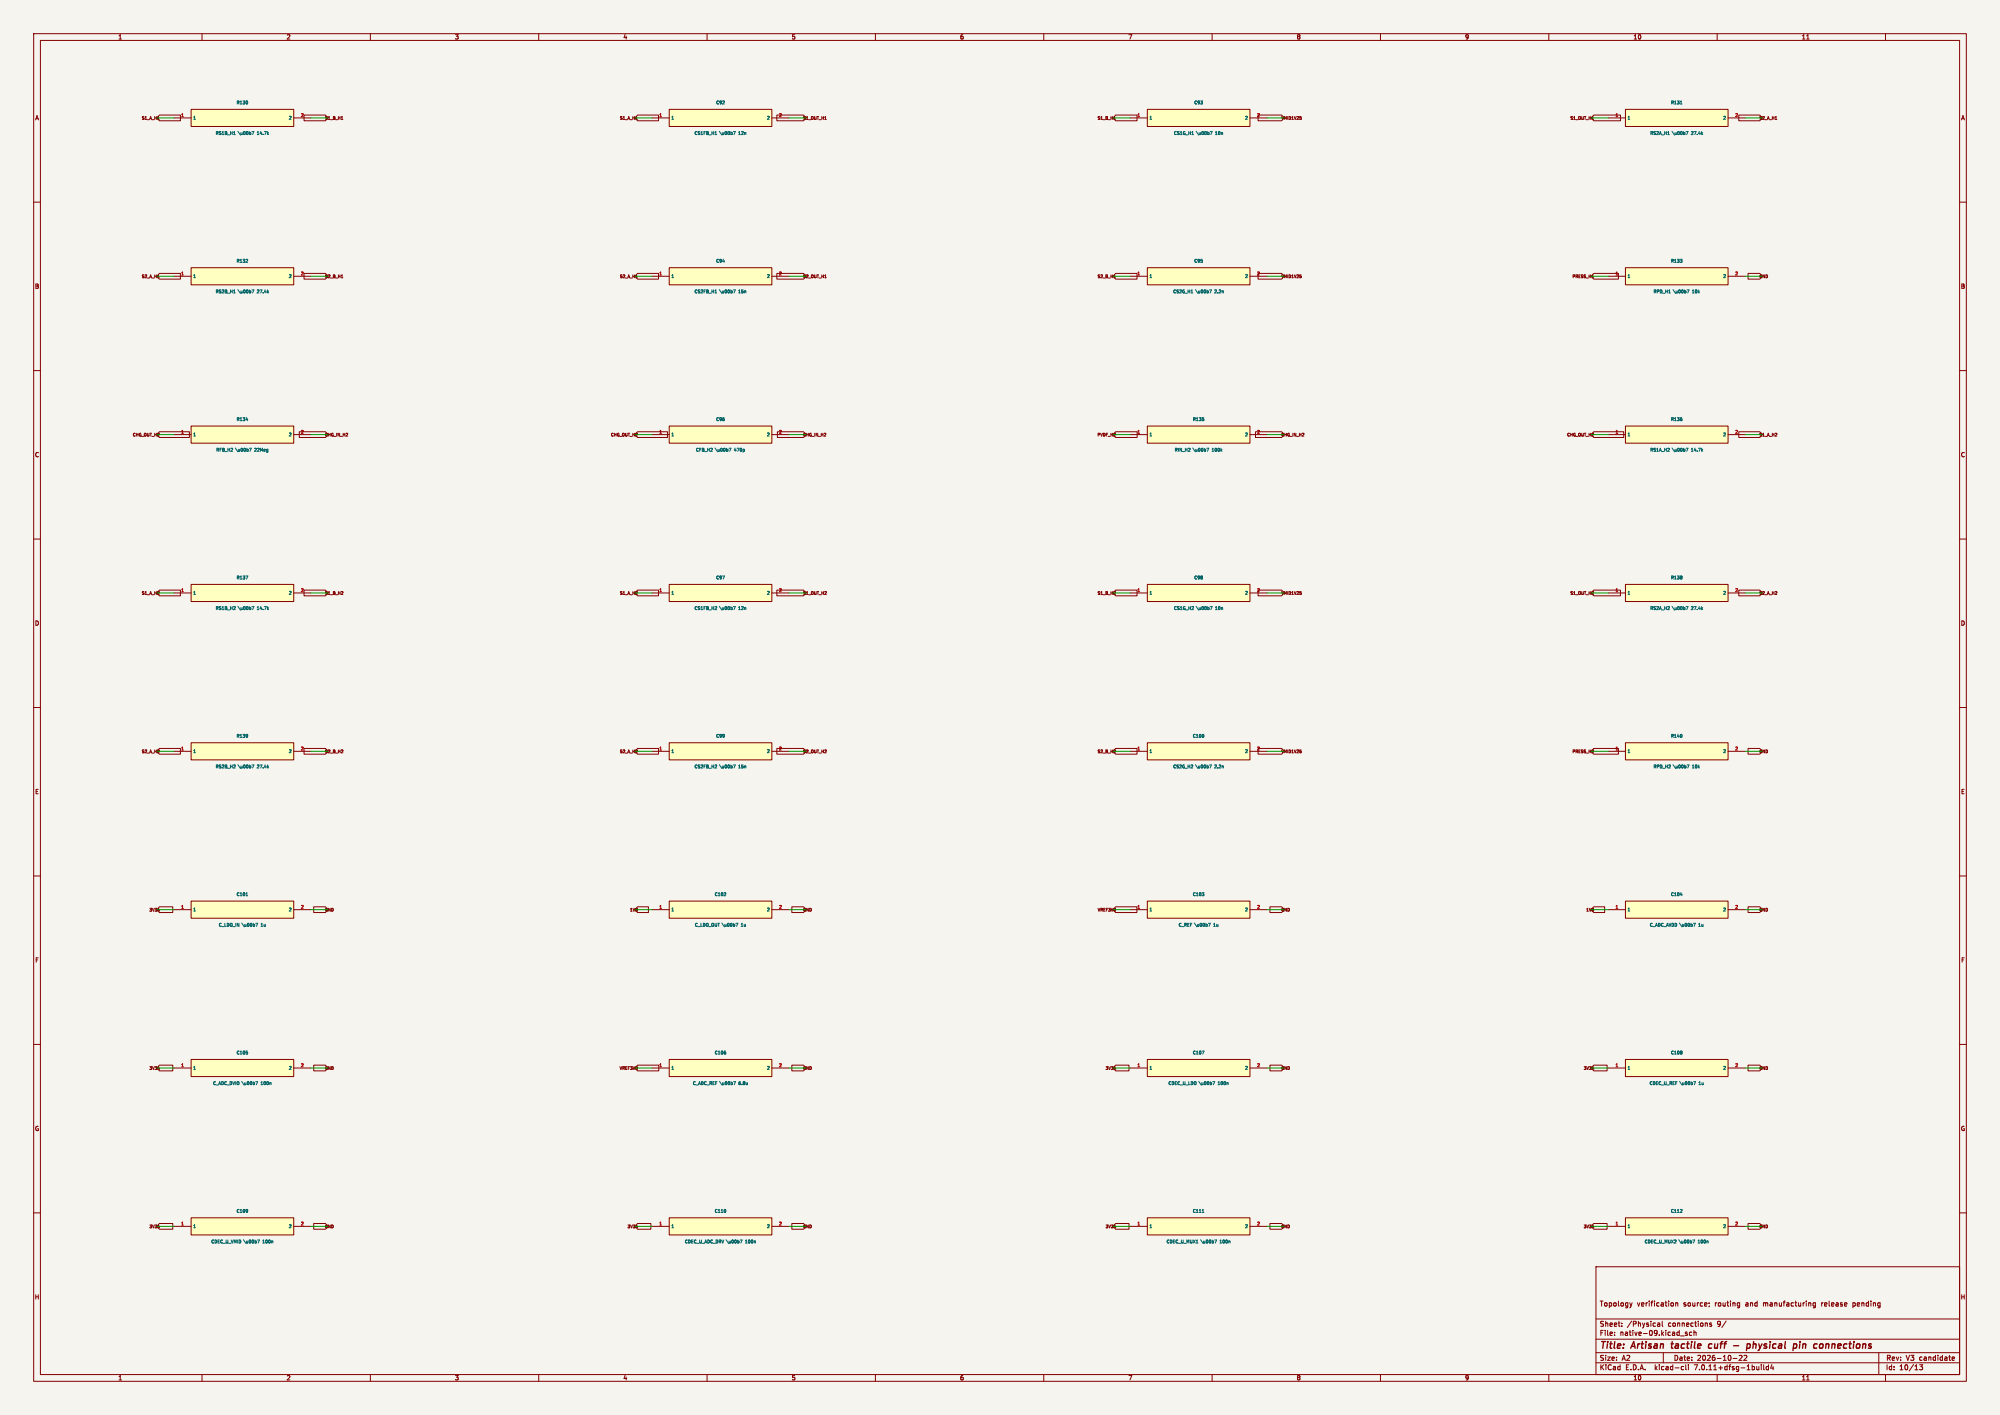
[picture p77: page 10]

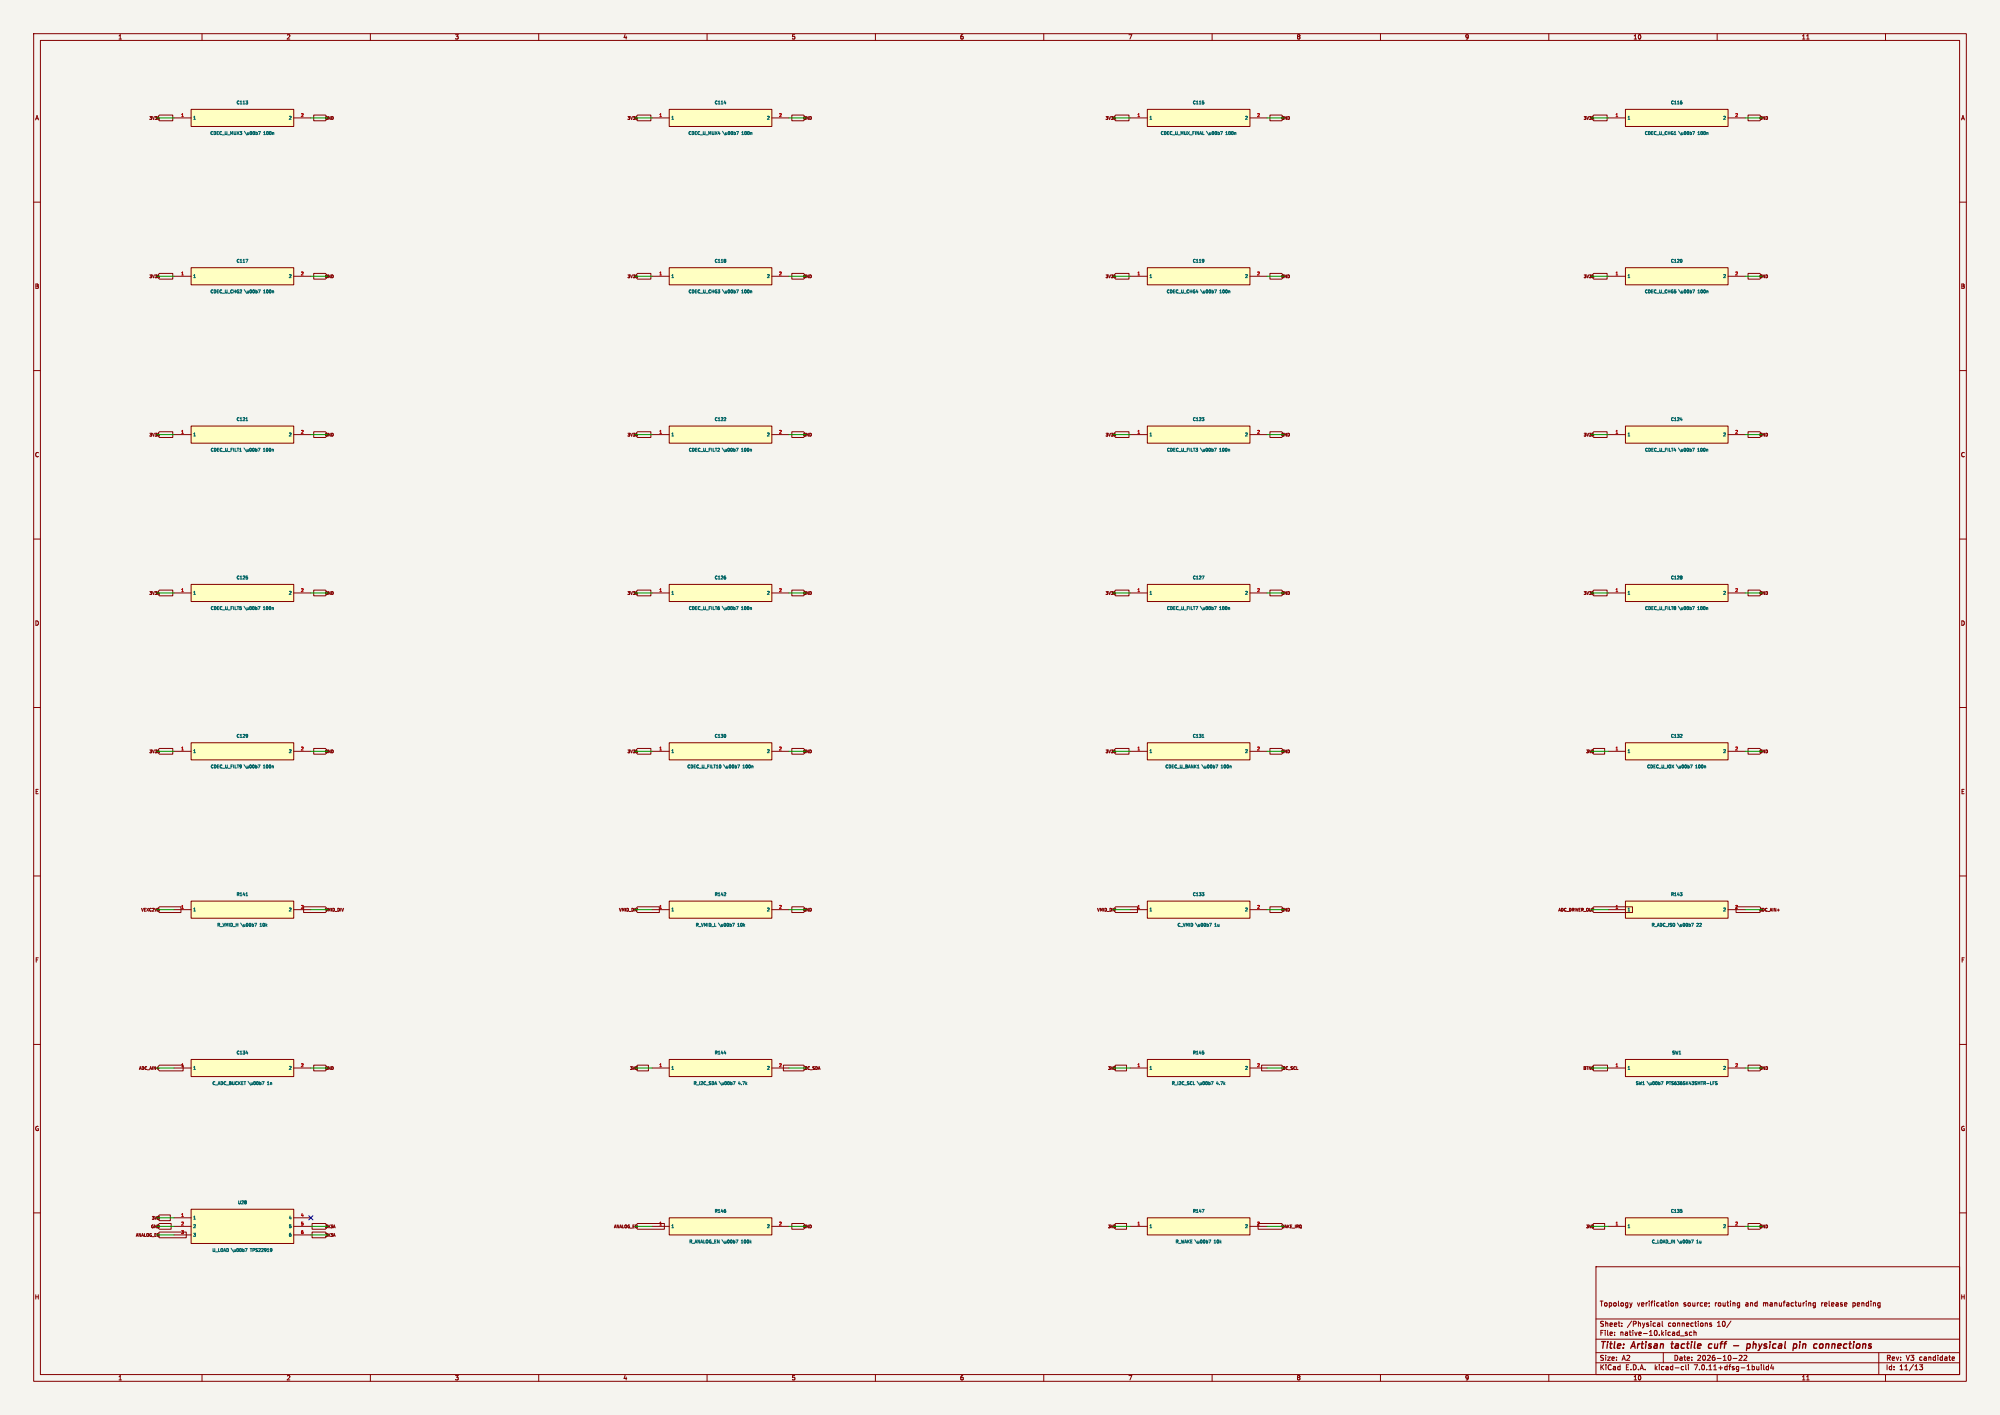
[picture p78: page 11]

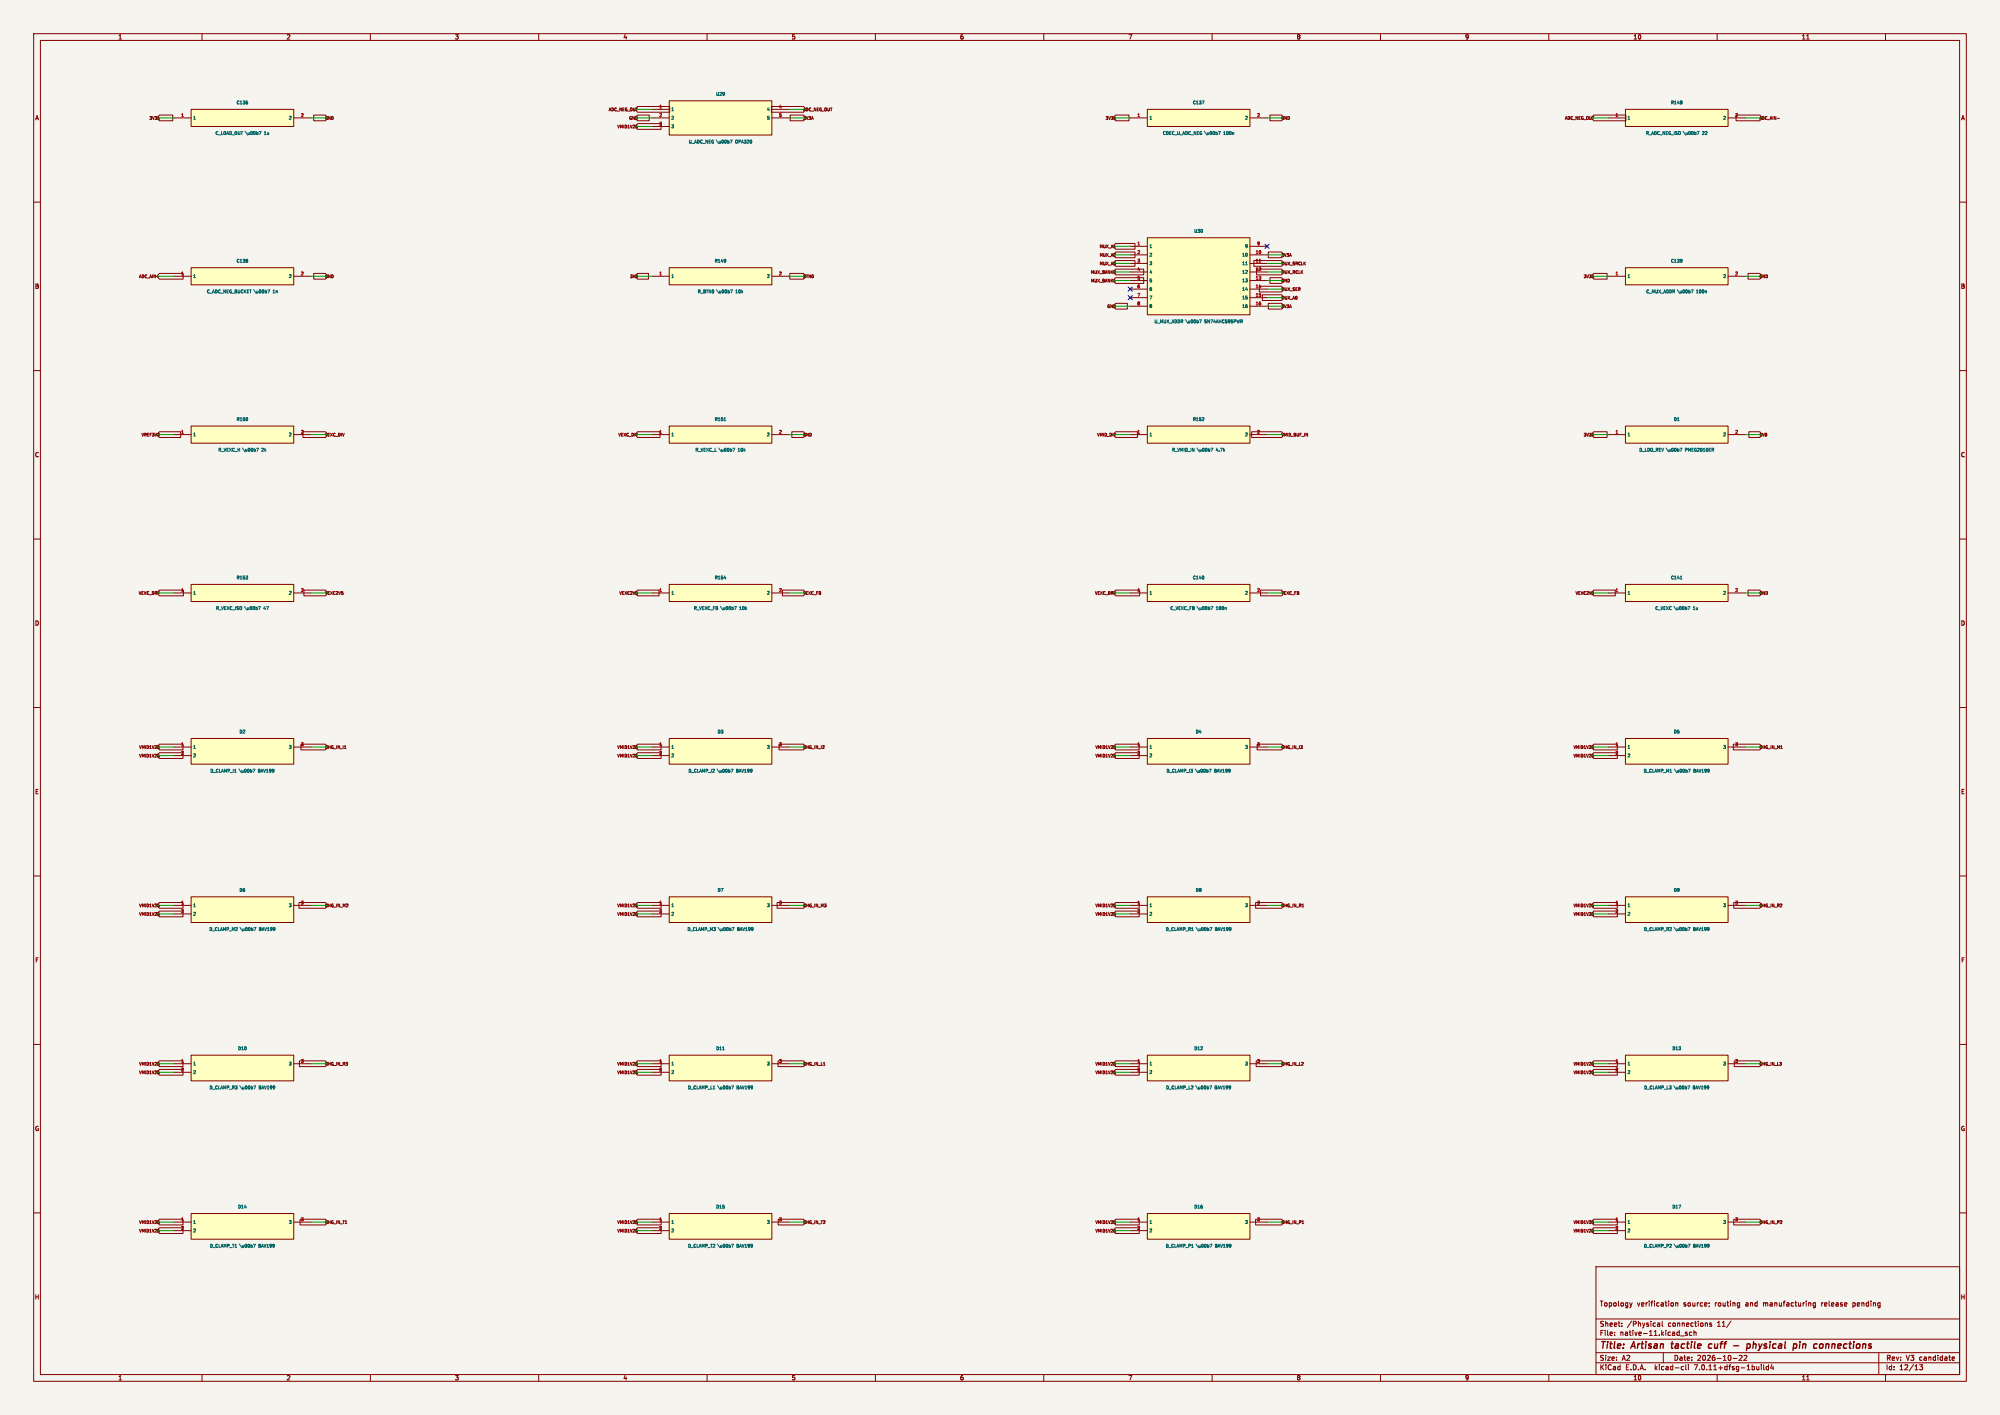
[picture p79: page 12]

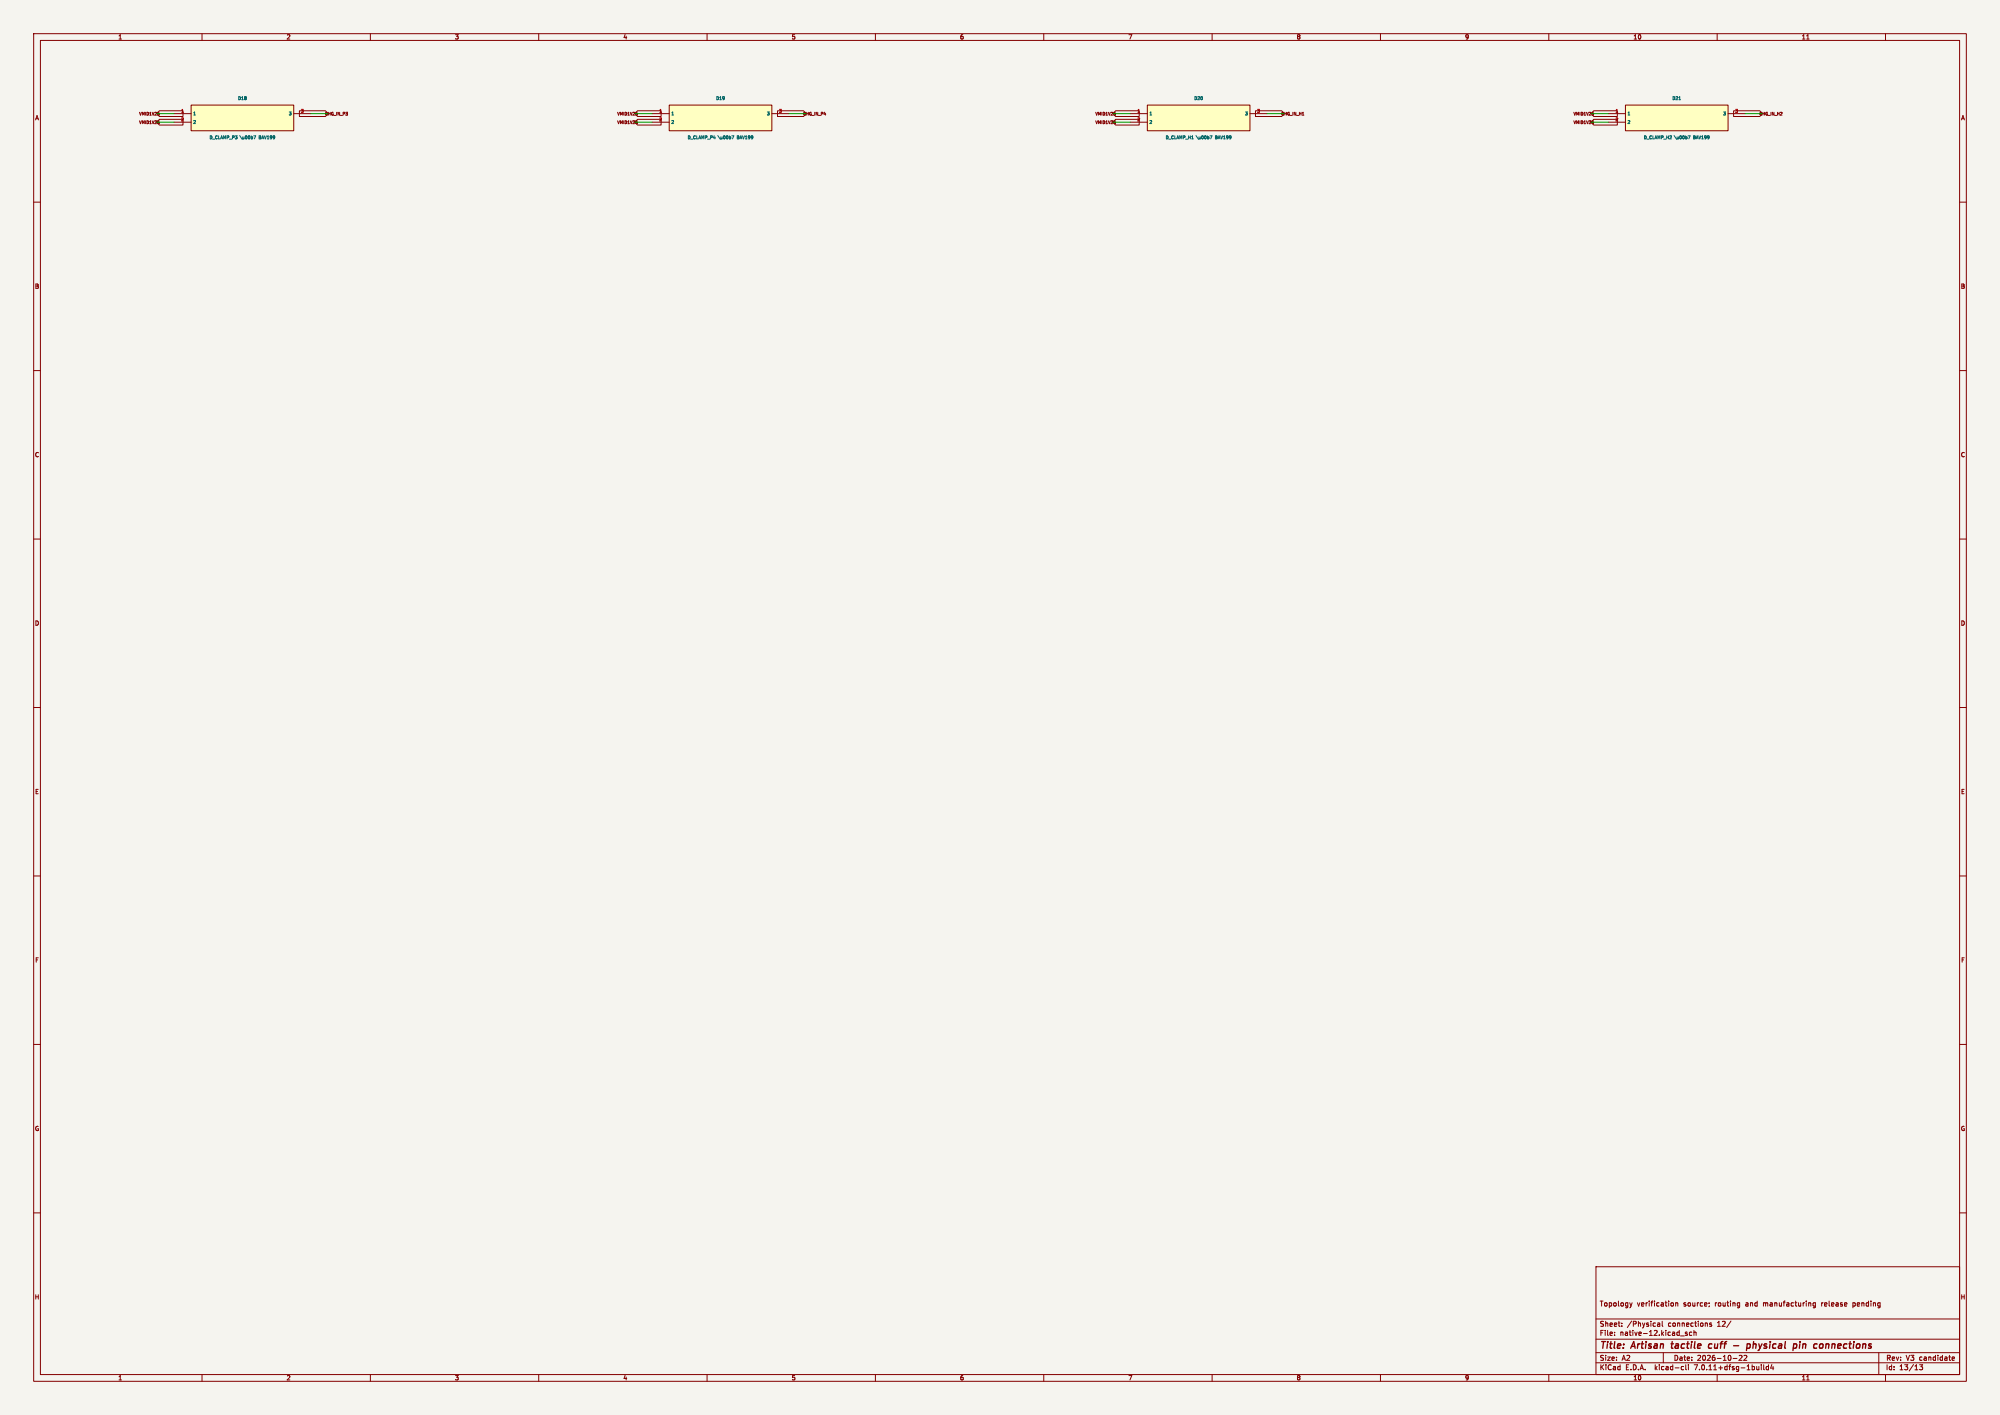
[picture p80: page 13]
