latintzar/tactile-glove/(list of files, drawings)

Other design files:
hardware/glove-v3/electrical/pcb-engineering-checks.json
hardware/glove-v4/interfaces/hand-tile/hand-tile.dsn
