latintzar/tactile-glove/hardware/glove-v3/electrical/glove-v3-routed.kicad_pcb

## KiCad design hardware/glove-v3/electrical/glove-v3-routed.kicad_pcb (2026-11-02, an earlier design)

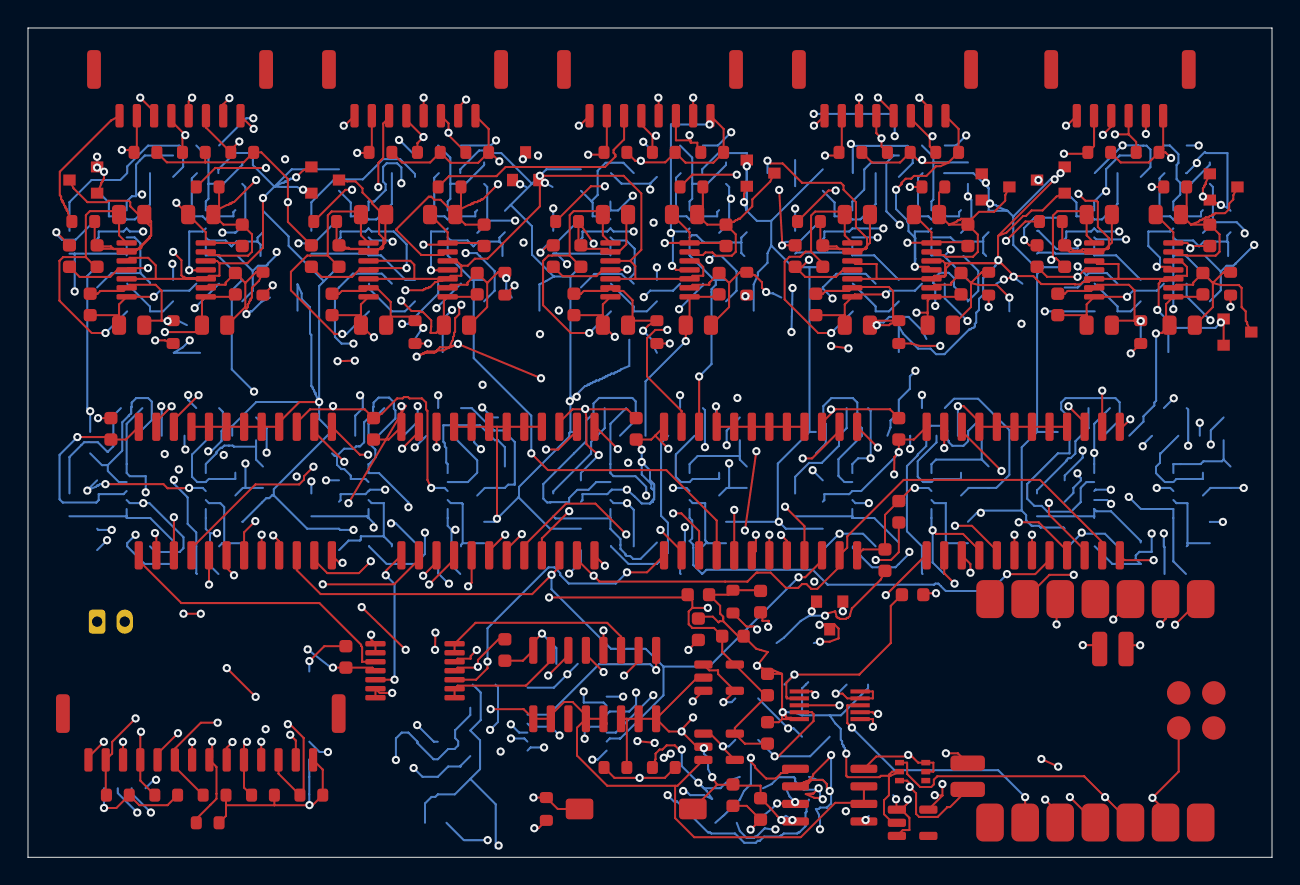
[picture p81: board glove-v3-routed.kicad_pcb from above]

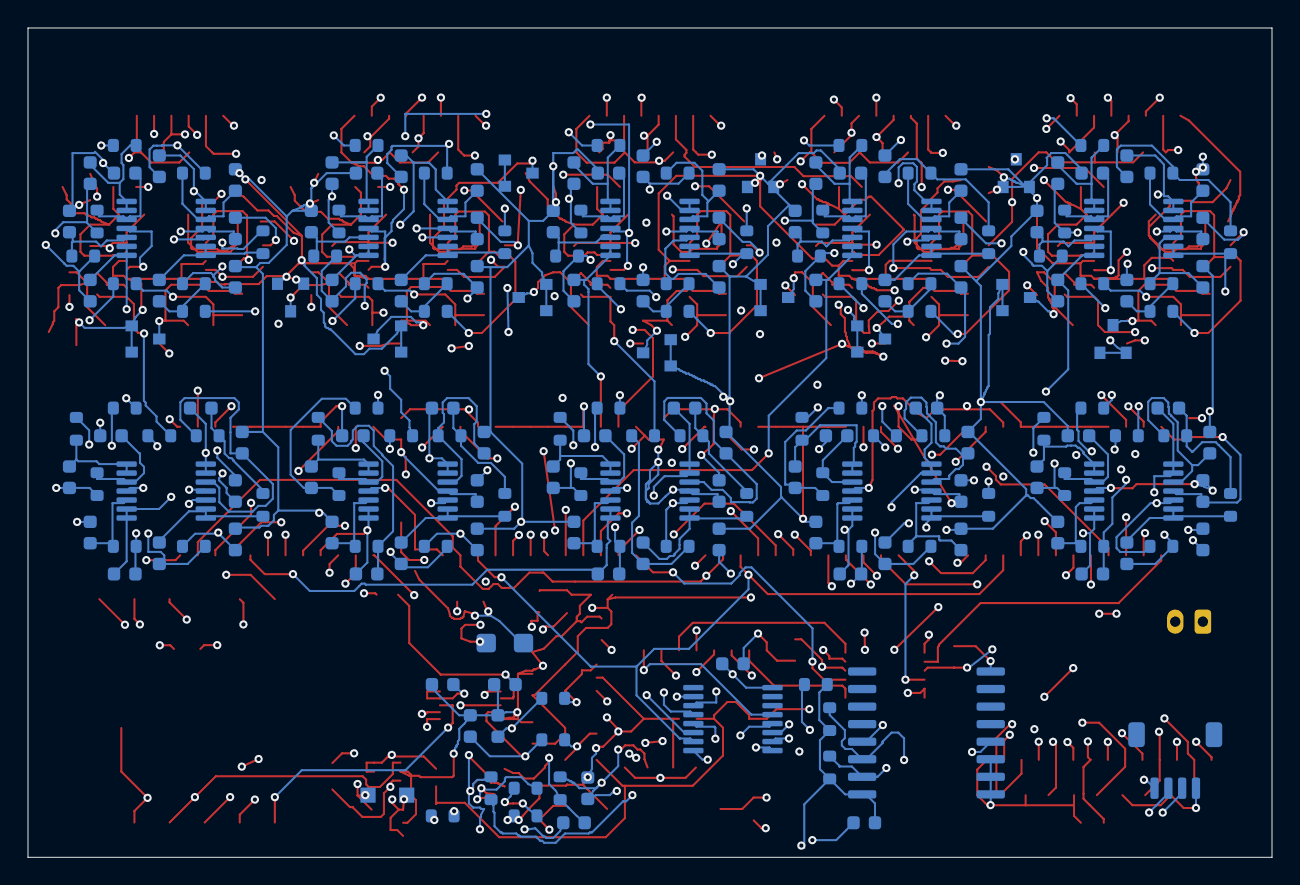
[picture p82: board glove-v3-routed.kicad_pcb from below]

Board: 4 copper layers, 90.0 x 60.0 mm, 356 parts (215 on the bottom side), 243 nets.

Parts:
C1, C6, C11, C16, C21, C26, C31, C36, C41, C46, C51, C56, C61, C66, C71, C76, C81, C86, C91, C96: GRM1885C1H471JA01D; C_0603_1608Metric
C2, C7, C12, C17, C22, C27, C32, C37, C42, C47, C52, C57, C62, C67, C72, C77, C82, C87, C92, C97: C0603C123J3GACAUTO; C_0603_1608Metric
C3, C8, C13, C18, C23, C28, C33, C38, C43, C48, C53, C58, C63, C68, C73, C78, C83, C88, C93, C98: GRM1885C1H103JA01D; C_0603_1608Metric
C4, C9, C14, C19, C24, C29, C34, C39, C44, C49, C54, C59, C64, C69, C74, C79, C84, C89, C94, C99: C0603C153J3GACAUTO; C_0603_1608Metric
C5, C10, C15, C20, C25, C30, C35, C40, C45, C50, C55, C60, C65, C70, C75, C80, C85, C90, C95, C100: GRM1885C1H222JA01D; C_0603_1608Metric
C101, C102, C103, C104, C108, C133, C135, C136, C141: GRM188R61A105KA61D; C_0603_1608Metric
C105, C107, C109, C110, C111, C112, C113, C114, C115, C116, C117, C118, C119, C120, C121, C122, C123, C124, C125, C126, C127, C128, C129, C130, C131, C132, C137, C140: GRM188R71H104KA93D; C_0603_1608Metric
C106: TAJA685K010RNJ; CP_EIA-3216-18_Kemet-A
C134, C138: GRM1885C1H102JA01D; C_0603_1608Metric
C139: GRM188R71C104KA01D; C_0603_1608Metric
D1: PMEG2010ER,115; D_SOD-123F
D2, D3, D4, D5, D6, D7, D8, D9, D10, D11, D12, D13, D14, D15, D16, D17, D18, D19, D20, D21: BAV199,215; SOT-23
J1: 102010469; XIAO-nRF52840-SMD-kicad7
J2: B2B-PH-K-S(LF)(SN); JST_PH_B2B-PH-K_1x02_P2.00mm_Vertical
J3: SM04B-SRSS-TB(LF)(SN); JST_SH_SM04B-SRSS-TB_1x04-1MP_P1.00mm_Horizontal
J5: BM06B-GHS-TBT(LF)(SN); JST_GH_BM06B-GHS-TBT_1x06-1MP_P1.25mm_Vertical
J6, J7, J8, J9: BM08B-GHS-TBT(LF)(SN); JST_GH_BM08B-GHS-TBT_1x08-1MP_P1.25mm_Vertical
J10: BM14B-GHS-TBT(LF)(SN); JST_GH_BM14B-GHS-TBT_1x14-1MP_P1.25mm_Vertical
R1, R8, R15, R22, R29, R36, R43, R50, R57, R64, R71, R78, R85, R92, R99, R106, R113, R120, R127, R134: RV0805FR-0722ML; R_0805_2012Metric
R2, R9, R16, R23, R30, R37, R44, R51, R58, R65, R72, R79, R86, R93, R100, R107, R114, R121, R128, R135, R146: RC0603FR-07100KL; R_0603_1608Metric
R3, R4, R10, R11, R17, R18, R24, R25, R31, R32, R38, R39, R45, R46, R52, R53, R59, R60, R66, R67, R73, R74, R80, R81, R87, R88, R94, R95, R101, R102, R108, R109, R115, R116, R122, R123, R129, R130, R136, R137: RC0603FR-0714K7L; R_0603_1608Metric
R5, R6, R12, R13, R19, R20, R26, R27, R33, R34, R40, R41, R47, R48, R54, R55, R61, R62, R68, R69, R75, R76, R82, R83, R89, R90, R96, R97, R103, R104, R110, R111, R117, R118, R124, R125, R131, R132, R138, R139: RC0603FR-0727K4L; R_0603_1608Metric
R7, R14, R21, R28, R35, R42, R49, R56, R63, R70, R77, R84, R91, R98, R105, R112, R119, R126, R133, R140, R141, R142, R147, R149, R151, R154: RC0603FR-0710KL; R_0603_1608Metric
R143, R148: RC0603FR-0722RL; R_0603_1608Metric
R144, R145, R152: RC0603FR-074K7L; R_0603_1608Metric
R150: RC0603FR-072KL; R_0603_1608Metric
R153: RC0603FR-0747RL; R_0603_1608Metric
SW1: PTS636SK43SMTR-LFS; SW_PTS636_SK43_G
U1: TLV75518PDBVR; SOT-23-5
U2: REF3330AIDBZR; SOT-23
U3: MCP6002T-I/SN; SOIC-8_3.9x4.9mm_P1.27mm
U4: MCP33131D-10-I/MS; MSOP-10_3x3mm_P0.5mm
U5, U29: OPA320AIDBVR; SOT-23-5
U6, U7, U8, U9: CD74HC4067M; SOIC-24W_7.5x15.4mm_P1.27mm
U10: CD74HC4052M; SOIC-16_3.9x9.9mm_P1.27mm
U11, U12, U13, U14, U15, U16, U17, U18, U19, U20, U21, U22, U23, U24, U25: MCP6004T-I/ST; TSSOP-14_4.4x5mm_P0.65mm
U26: OPA4323IPWR; TSSOP-14_4.4x5mm_P0.65mm
U27: TCA9534DWR; SOIC-16W_7.5x10.3mm_P1.27mm
U28: TPS22919DCKT; SOT-363_SC-70-6
U30: SN74AHC595PWR; TSSOP-16_4.4x5mm_P0.65mm

Connections:
1V8: C102.1, C104.1, D1.2, U1.5, U4.2
3V3: C132.1, C135.1, J1.12, J3.2, R144.1, R145.1, R147.1, R149.1, U27.16, U28.1
3V3A: C101.1, C105.1, C107.1, C108.1, C109.1, C110.1, C111.1, C112.1, C113.1, C114.1, C115.1, C116.1, C117.1, C118.1, C119.1, C120.1, C121.1, C122.1, C123.1, C124.1, C125.1, C126.1, C127.1, C128.1, C129.1, C130.1, C131.1, C136.1, C137.1, C139.1, D1.1, U1.1, U1.3, U2.1, U3.8, U4.9, U4.10, U5.5, U6.24, U7.24, U8.24, U9.24, U10.16, U11.4, U12.4, U13.4, U14.4, U15.4, U16.4, U17.4, U18.4, U19.4, U20.4, U21.4, U22.4, U23.4, U24.4, U25.4, U26.4, U28.5, U28.6, U29.5, U30.10, U30.16
ADC_AIN+: C134.1, R143.2, U4.3
ADC_AIN-: C138.1, R148.2, U4.4
ADC_CNV: J1.11, U4.6
ADC_DRIVER_OUT: R143.1, U5.1, U5.4
ADC_MISO: J1.10, U4.7
ADC_MUX: U5.3, U10.13
ADC_NEG_OUT: R148.1, U29.1, U29.4
ADC_SCK: J1.9, U4.8
ANALOG_EN: J1.22, R146.1, U28.3
BAT+: J1.19, J2.1
BTN0: R149.2, SW1.1, U27.4
CHG_IN_H1: C91.2, D20.3, R127.2, R128.2, U15.9
CHG_IN_H2: C96.2, D21.3, R134.2, R135.2, U15.13
CHG_IN_I1: C1.2, D2.3, R1.2, R2.2, U11.2
CHG_IN_I2: C6.2, D3.3, R8.2, R9.2, U11.6
CHG_IN_I3: C11.2, D4.3, R15.2, R16.2, U11.9
CHG_IN_L1: C46.2, D11.3, R64.2, R65.2, U13.6
CHG_IN_L2: C51.2, D12.3, R71.2, R72.2, U13.9
CHG_IN_L3: C56.2, D13.3, R78.2, R79.2, U13.13
CHG_IN_M1: C16.2, D5.3, R22.2, R23.2, U11.13
CHG_IN_M2: C21.2, D6.3, R29.2, R30.2, U12.2
CHG_IN_M3: C26.2, D7.3, R36.2, R37.2, U12.6
CHG_IN_P1: C71.2, D16.3, R99.2, R100.2, U14.9
CHG_IN_P2: C76.2, D17.3, R106.2, R107.2, U14.13
CHG_IN_P3: C81.2, D18.3, R113.2, R114.2, U15.2
CHG_IN_P4: C86.2, D19.3, R120.2, R121.2, U15.6
CHG_IN_R1: C31.2, D8.3, R43.2, R44.2, U12.9
CHG_IN_R2: C36.2, D9.3, R50.2, R51.2, U12.13
CHG_IN_R3: C41.2, D10.3, R57.2, R58.2, U13.2
CHG_IN_T1: C61.2, D14.3, R85.2, R86.2, U14.2
CHG_IN_T2: C66.2, D15.3, R92.2, R93.2, U14.6
CHG_OUT_H1: C91.1, R127.1, R129.1, U15.8
CHG_OUT_H2: C96.1, R134.1, R136.1, U15.14
CHG_OUT_I1: C1.1, R1.1, R3.1, U11.1
CHG_OUT_I2: C6.1, R8.1, R10.1, U11.7
CHG_OUT_I3: C11.1, R15.1, R17.1, U11.8
CHG_OUT_L1: C46.1, R64.1, R66.1, U13.7
CHG_OUT_L2: C51.1, R71.1, R73.1, U13.8
CHG_OUT_L3: C56.1, R78.1, R80.1, U13.14
CHG_OUT_M1: C16.1, R22.1, R24.1, U11.14
CHG_OUT_M2: C21.1, R29.1, R31.1, U12.1
CHG_OUT_M3: C26.1, R36.1, R38.1, U12.7
CHG_OUT_P1: C71.1, R99.1, R101.1, U14.8
CHG_OUT_P2: C76.1, R106.1, R108.1, U14.14
CHG_OUT_P3: C81.1, R113.1, R115.1, U15.1
CHG_OUT_P4: C86.1, R120.1, R122.1, U15.7
CHG_OUT_R1: C31.1, R43.1, R45.1, U12.8
CHG_OUT_R2: C36.1, R50.1, R52.1, U12.14
CHG_OUT_R3: C41.1, R57.1, R59.1, U13.1
CHG_OUT_T1: C61.1, R85.1, R87.1, U14.1
CHG_OUT_T2: C66.1, R92.1, R94.1, U14.7
GND: C101.2, C102.2, C103.2, C104.2, C105.2, C106.2, C107.2, C108.2, C109.2, C110.2, C111.2, C112.2, C113.2, C114.2, C115.2, C116.2, C117.2, C118.2, C119.2, C120.2, C121.2, C122.2, C123.2, C124.2, C125.2, C126.2, C127.2, C128.2, C129.2, C130.2, C131.2, C132.2, C133.2, C134.2, C135.2, C136.2, C137.2, C138.2, C139.2, C141.2, J1.13, J1.18, J1.20, J2.2, J3.1, J5.6, J6.8, J7.8, J8.8, J9.8, J10.14, R7.2, R14.2, R21.2, R28.2, R35.2, R42.2, R49.2, R56.2, R63.2, R70.2, R77.2, R84.2, R91.2, R98.2, R105.2, R112.2, R119.2, R126.2, R133.2, R140.2, R142.2, R146.2, R151.2, SW1.2, U1.2, U2.3, U3.4, U4.5, U5.2, U6.12, U6.15, U7.12, U7.15, U8.12, U8.15, U9.12, U9.15, U10.6, U10.7, U10.8, U11.11, U12.11, U13.11, U14.11, U15.11, U16.11, U17.11, U18.11, U19.11, U20.11, U21.11, U22.11, U23.11, U24.11, U25.11, U26.11, U27.1, U27.2, U27.3, U27.8, U28.2, U29.2, U30.8, U30.13
I2C_SCL: J1.6, J3.4, R145.2, U27.14
I2C_SDA: J1.5, J3.3, R144.2, U27.15
MUX1_BUF: U10.12, U26.1, U26.2
MUX1_COM: U6.1, U26.3
MUX2_BUF: U10.14, U26.6, U26.7
MUX2_COM: U7.1, U26.5
MUX3_BUF: U10.15, U26.8, U26.9
MUX3_COM: U8.1, U26.10
MUX4_BUF: U10.11, U26.13, U26.14
MUX4_COM: U9.1, U26.12
MUX_A0: U6.10, U7.10, U8.10, U9.10, U30.15
MUX_A1: U6.11, U7.11, U8.11, U9.11, U30.1
MUX_A2: U6.14, U7.14, U8.14, U9.14, U30.2
MUX_A3: U6.13, U7.13, U8.13, U9.13, U30.3
MUX_BANK0: U10.10, U30.4
MUX_BANK1: U10.9, U30.5
MUX_RCLK: J1.3, U30.12
MUX_SER: J1.2, U30.14
MUX_SRCLK: J1.1, U30.11
PRESS_H1: J10.10, R133.1, U7.23
PRESS_H2: J10.12, R140.1, U7.22
PRESS_I1: J6.2, R7.1, U6.9
PRESS_I2: J6.4, R14.1, U6.8
PRESS_I3: J6.6, R21.1, U6.7
PRESS_L1: J9.2, R70.1, U6.22
PRESS_L2: J9.4, R77.1, U7.9
PRESS_L3: J9.6, R84.1, U7.8
PRESS_M1: J7.2, R28.1, U6.6
PRESS_M2: J7.4, R35.1, U6.5
PRESS_M3: J7.6, R42.1, U6.4
PRESS_P1: J10.2, R105.1, U7.5
PRESS_P2: J10.4, R112.1, U7.4
PRESS_P3: J10.6, R119.1, U7.3
PRESS_P4: J10.8, R126.1, U7.2
PRESS_R1: J8.2, R49.1, U6.3
PRESS_R2: J8.4, R56.1, U6.2
PRESS_R3: J8.6, R63.1, U6.23
PRESS_T1: J5.2, R91.1, U7.7
PRESS_T2: J5.4, R98.1, U7.6
PVDF_H1: J10.9, R128.1
PVDF_H2: J10.11, R135.1
PVDF_I1: J6.1, R2.1
PVDF_I2: J6.3, R9.1
PVDF_I3: J6.5, R16.1
PVDF_L1: J9.1, R65.1
PVDF_L2: J9.3, R72.1
PVDF_L3: J9.5, R79.1
PVDF_M1: J7.1, R23.1
PVDF_M2: J7.3, R30.1
PVDF_M3: J7.5, R37.1
PVDF_P1: J10.1, R100.1
PVDF_P2: J10.3, R107.1
PVDF_P3: J10.5, R114.1
PVDF_P4: J10.7, R121.1
PVDF_R1: J8.1, R44.1
PVDF_R2: J8.3, R51.1
PVDF_R3: J8.5, R58.1
PVDF_T1: J5.1, R86.1
PVDF_T2: J5.3, R93.1
S1_A_H1: C92.1, R129.2, R130.1
S1_A_H2: C97.1, R136.2, R137.1
S1_A_I1: C2.1, R3.2, R4.1
S1_A_I2: C7.1, R10.2, R11.1
S1_A_I3: C12.1, R17.2, R18.1
S1_A_L1: C47.1, R66.2, R67.1
S1_A_L2: C52.1, R73.2, R74.1
S1_A_L3: C57.1, R80.2, R81.1
S1_A_M1: C17.1, R24.2, R25.1
S1_A_M2: C22.1, R31.2, R32.1
S1_A_M3: C27.1, R38.2, R39.1
S1_A_P1: C72.1, R101.2, R102.1
S1_A_P2: C77.1, R108.2, R109.1
S1_A_P3: C82.1, R115.2, R116.1
S1_A_P4: C87.1, R122.2, R123.1
S1_A_R1: C32.1, R45.2, R46.1
S1_A_R2: C37.1, R52.2, R53.1
S1_A_R3: C42.1, R59.2, R60.1
S1_A_T1: C62.1, R87.2, R88.1
S1_A_T2: C67.1, R94.2, R95.1
S1_B_H1: C93.1, R130.2, U25.3
S1_B_H2: C98.1, R137.2, U25.10
S1_B_I1: C3.1, R4.2, U16.3
S1_B_I2: C8.1, R11.2, U16.10
S1_B_I3: C13.1, R18.2, U17.3
S1_B_L1: C48.1, R67.2, U20.10
S1_B_L2: C53.1, R74.2, U21.3
S1_B_L3: C58.1, R81.2, U21.10
S1_B_M1: C18.1, R25.2, U17.10
S1_B_M2: C23.1, R32.2, U18.3
S1_B_M3: C28.1, R39.2, U18.10
S1_B_P1: C73.1, R102.2, U23.3
S1_B_P2: C78.1, R109.2, U23.10
S1_B_P3: C83.1, R116.2, U24.3
S1_B_P4: C88.1, R123.2, U24.10
S1_B_R1: C33.1, R46.2, U19.3
S1_B_R2: C38.1, R53.2, U19.10
S1_B_R3: C43.1, R60.2, U20.3
S1_B_T1: C63.1, R88.2, U22.3
S1_B_T2: C68.1, R95.2, U22.10
S1_OUT_H1: C92.2, R131.1, U25.1, U25.2
S1_OUT_H2: C97.2, R138.1, U25.8, U25.9
S1_OUT_I1: C2.2, R5.1, U16.1, U16.2
S1_OUT_I2: C7.2, R12.1, U16.8, U16.9
S1_OUT_I3: C12.2, R19.1, U17.1, U17.2
S1_OUT_L1: C47.2, R68.1, U20.8, U20.9
S1_OUT_L2: C52.2, R75.1, U21.1, U21.2
S1_OUT_L3: C57.2, R82.1, U21.8, U21.9
S1_OUT_M1: C17.2, R26.1, U17.8, U17.9
S1_OUT_M2: C22.2, R33.1, U18.1, U18.2
S1_OUT_M3: C27.2, R40.1, U18.8, U18.9
S1_OUT_P1: C72.2, R103.1, U23.1, U23.2
S1_OUT_P2: C77.2, R110.1, U23.8, U23.9
S1_OUT_P3: C82.2, R117.1, U24.1, U24.2
S1_OUT_P4: C87.2, R124.1, U24.8, U24.9
S1_OUT_R1: C32.2, R47.1, U19.1, U19.2
S1_OUT_R2: C37.2, R54.1, U19.8, U19.9
S1_OUT_R3: C42.2, R61.1, U20.1, U20.2
S1_OUT_T1: C62.2, R89.1, U22.1, U22.2
S1_OUT_T2: C67.2, R96.1, U22.8, U22.9
S2_A_H1: C94.1, R131.2, R132.1
S2_A_H2: C99.1, R138.2, R139.1
S2_A_I1: C4.1, R5.2, R6.1
S2_A_I2: C9.1, R12.2, R13.1
S2_A_I3: C14.1, R19.2, R20.1
S2_A_L1: C49.1, R68.2, R69.1
S2_A_L2: C54.1, R75.2, R76.1
S2_A_L3: C59.1, R82.2, R83.1
S2_A_M1: C19.1, R26.2, R27.1
S2_A_M2: C24.1, R33.2, R34.1
S2_A_M3: C29.1, R40.2, R41.1
S2_A_P1: C74.1, R103.2, R104.1
S2_A_P2: C79.1, R110.2, R111.1
S2_A_P3: C84.1, R117.2, R118.1
S2_A_P4: C89.1, R124.2, R125.1
S2_A_R1: C34.1, R47.2, R48.1
S2_A_R2: C39.1, R54.2, R55.1
S2_A_R3: C44.1, R61.2, R62.1
S2_A_T1: C64.1, R89.2, R90.1
S2_A_T2: C69.1, R96.2, R97.1
S2_B_H1: C95.1, R132.2, U25.5
S2_B_H2: C100.1, R139.2, U25.12
S2_B_I1: C5.1, R6.2, U16.5
S2_B_I2: C10.1, R13.2, U16.12
S2_B_I3: C15.1, R20.2, U17.5
S2_B_L1: C50.1, R69.2, U20.12
S2_B_L2: C55.1, R76.2, U21.5
S2_B_L3: C60.1, R83.2, U21.12
S2_B_M1: C20.1, R27.2, U17.12
S2_B_M2: C25.1, R34.2, U18.5
S2_B_M3: C30.1, R41.2, U18.12
S2_B_P1: C75.1, R104.2, U23.5
S2_B_P2: C80.1, R111.2, U23.12
S2_B_P3: C85.1, R118.2, U24.5
S2_B_P4: C90.1, R125.2, U24.12
S2_B_R1: C35.1, R48.2, U19.5
S2_B_R2: C40.1, R55.2, U19.12
S2_B_R3: C45.1, R62.2, U20.5
S2_B_T1: C65.1, R90.2, U22.5
S2_B_T2: C70.1, R97.2, U22.12
S2_OUT_H1: C94.2, U9.23, U25.6, U25.7
S2_OUT_H2: C99.2, U9.22, U25.13, U25.14
S2_OUT_I1: C4.2, U8.9, U16.6, U16.7
S2_OUT_I2: C9.2, U8.8, U16.13, U16.14
S2_OUT_I3: C14.2, U8.7, U17.6, U17.7
S2_OUT_L1: C49.2, U8.22, U20.13, U20.14
S2_OUT_L2: C54.2, U9.9, U21.6, U21.7
S2_OUT_L3: C59.2, U9.8, U21.13, U21.14
S2_OUT_M1: C19.2, U8.6, U17.13, U17.14
S2_OUT_M2: C24.2, U8.5, U18.6, U18.7
S2_OUT_M3: C29.2, U8.4, U18.13, U18.14
S2_OUT_P1: C74.2, U9.5, U23.6, U23.7
S2_OUT_P2: C79.2, U9.4, U23.13, U23.14
S2_OUT_P3: C84.2, U9.3, U24.6, U24.7
S2_OUT_P4: C89.2, U9.2, U24.13, U24.14
S2_OUT_R1: C34.2, U8.3, U19.6, U19.7
S2_OUT_R2: C39.2, U8.2, U19.13, U19.14
S2_OUT_R3: C44.2, U8.23, U20.6, U20.7
S2_OUT_T1: C64.2, U9.7, U22.6, U22.7
S2_OUT_T2: C69.2, U9.6, U22.13, U22.14
VEXC2V5: C141.1, J5.5, J6.7, J7.7, J8.7, J9.7, J10.13, R141.1, R153.2, R154.1
VEXC_DIV: R150.2, R151.1, U3.3
VEXC_DRV: C140.1, R153.1, U3.1
VEXC_FB: C140.2, R154.2, U3.2
VMID1V25: C3.2, C5.2, C8.2, C10.2, C13.2, C15.2, C18.2, C20.2, C23.2, C25.2, C28.2, C30.2, C33.2, C35.2, C38.2, C40.2, C43.2, C45.2, C48.2, C50.2, C53.2, C55.2, C58.2, C60.2, C63.2, C65.2, C68.2, C70.2, C73.2, C75.2, C78.2, C80.2, C83.2, C85.2, C88.2, C90.2, C93.2, C95.2, C98.2, C100.2, D2.1, D2.2, D3.1, D3.2, D4.1, D4.2, D5.1, D5.2, D6.1, D6.2, D7.1, D7.2, D8.1, D8.2, D9.1, D9.2, D10.1, D10.2, D11.1, D11.2, D12.1, D12.2, D13.1, D13.2, D14.1, D14.2, D15.1, D15.2, D16.1, D16.2, D17.1, D17.2, D18.1, D18.2, D19.1, D19.2, D20.1, D20.2, D21.1, D21.2, U3.6, U3.7, U6.16, U6.17, U6.18, U6.19, U6.20, U6.21, U7.16, U7.17, U7.18, U7.19, U7.20, U7.21, U8.16, U8.17, U8.18, U8.19, U8.20, U8.21, U9.16, U9.17, U9.18, U9.19, U9.20, U9.21, U10.1, U10.2, U10.4, U10.5, U11.3, U11.5, U11.10, U11.12, U12.3, U12.5, U12.10, U12.12, U13.3, U13.5, U13.10, U13.12, U14.3, U14.5, U14.10, U14.12, U15.3, U15.5, U15.10, U15.12, U29.3
VMID_BUF_IN: R152.2, U3.5
VMID_DIV: C133.1, R141.2, R142.1, R152.1
VREF3V0: C103.1, C106.1, R150.1, U2.2, U4.1
WAKE_IRQ: J1.21, R147.2, U27.13
