latintzar/tactile-glove/hardware/glove-v4/interfaces/hand-tile/hand-tile-routed.kicad_pcb

## KiCad design hardware/glove-v4/interfaces/hand-tile/hand-tile-routed.kicad_pcb (2026-11-02)

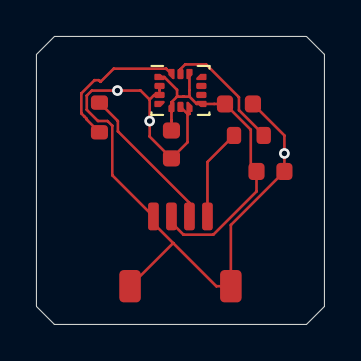
[picture p83: board hand-tile-routed.kicad_pcb from above]

Board: 2 copper layers, 16.0 x 16.0 mm, 7 parts (0 on the bottom side), 6 nets.

Parts:
C1, C2: GRM188R71C104KA01D; C_0603_1608Metric
C3: GRM188R61A475KE15D; C_0603_1608Metric
J1: SM04B-SRSS-TB(LF)(SN); JST_SH_SM04B-SRSS-TB_1x04-1MP_P1.00mm_Horizontal
R1, R2: RC0603FR-0722RL; R_0603_1608Metric
U1: ISM330DHCXTR; ST_ISM330DHCX_LGA14_0.35mm

Connections:
3V3_SYS: C1.1, C2.1, C3.1, J1.2, U1.1, U1.5, U1.8, U1.12
GND: C1.2, C2.2, C3.2, J1.1, J1.MP, U1.2, U1.3, U1.6, U1.7
HAND_I2C_SCL: R2.2, U1.13
HAND_I2C_SDA: R1.2, U1.14
I2C_SCL: J1.4, R2.1
I2C_SDA: J1.3, R1.1
