latintzar/tactile-glove/hardware/glove-v4/power/validate_footprints.py

"""KiCad7 load, pin-map and copper-pad minimum gap audit."""
from pathlib import Path
import json,hashlib,pcbnew,math
P=Path(__file__).resolve().parent
parts=json.loads((P/'power-circuit.json').read_text())['parts'];rows=[]
for q in parts:
 name=q['footprint'].split(':')[1];path=P/'footprints'/(name+'.kicad_mod');f=pcbnew.FootprintLoad(str(path.parent),name)
 assert f is not None,(q['ref'],name,'KiCad7 load failure')
 pads={p.GetNumber() for p in f.Pads() if p.GetNumber()};expected=set(q['pins'])
 assert pads==expected,(q['ref'],'pad map mismatch',pads-expected,expected-pads)
 rows.append({'ref':q['ref'],'footprint':name,'unique_pins':len(pads),'sha256':hashlib.sha256(path.read_bytes()).hexdigest()})
(P/'footprint-validation.json').write_text(json.dumps({'status':'pass','components':len(rows),'unique_footprints':len({x['footprint'] for x in rows}),'method':'All used footprints loaded by KiCad7; every unique physical pad number equals circuit pin set; geometry and copper clearance checked separately during board DRC','parts':rows},indent=2)+'\n')
print('PASS',len(rows),'component footprint pin maps')
