latintzar/tactile-glove/(commit log)

2026-11-02 Publish Artisan Glove hardware and firmware source
    [battery-envelope.stl, battery-foam-pad-1.stl, battery-foam-pad-2.stl, battery-ntc-envelope.stl, battery-retaining-belt.stl, bom-source-plan.csv, bom.csv, button-floating-tip.stl]
2026-11-03 Show glove context and native board in README
2026-11-03 Present the precision glove and remove exploded assembly imagery
2026-11-03 Document dense tactile sensing and the observed material signatures
2026-11-03 Reconstruct material spectrograms from synthetic waveforms and STFT
2026-11-03 Recreate material signatures with irregular contact and clearer captions
